TKlebig/TimBAgit/BA/Chapters/Teil1.tex

%\watermark{\fontsize{30pt}{70pt}\selectfont\textcolor{light}{Vertraulich}}

\chapter{Motivation}
\label{cha:Motivation}

Im Fokus der Arbeit steht ein vertikales Supermarktkühlmöbel für Normalkühlung, welches mit Propan (R290) betrieben wird \cite{DINDeutschesInstitutfurNormunge.V..b}. Propan findet vor dem Hintergrund der F-Gas-Verordnung und aufgrund der hohen volumetrischen Kälteleistung immer häufiger in Kälteanlagen Verwendung \cite{EUParlamentRat.2006},\cite{Huber.2016},\cite{Moons.2013}. Sicherheitsnormen beschränken die maximale Füllmenge eines Kältekreises mit Propan auf \unit{150}{\gram} \cite{DINDeutschesInstitutfurNormunge.V..2014b}. Das AHT-Kühlmöbel, für dessen Produktion die Firma Emerson Scrollverdichter liefert, ist nicht in der Lage die Zieltemperatur, die zwischen \unit{-1}{\celsius} und \unit{5}{\celsius} liegt, über die gesamte Warenausstellfläche gleichmäßig zu erreichen. Es werden Untersuchungen in einer Klimakammer durchgeführt, um Gründe für die unzureichende Produktkühlung zu finden und um die Kälteleistung der Kältekreise zu erhöhen. Das Ziel dieser Untersuchungen ist die Identifikation eines optimalen Betriebspunkts durch Zusammenstellung geeigneter Komponenten und Maßnahmen. Diese werden im Rahmen der Untersuchungen hinsichtlich der erzielten Kälteleistung und der Anlageneffizienz bewertet. 
Vorausgehende Arbeiten umfassen die Installation von Temperatur- und Drucksensoren am Kältekreis und an den Produktdummys, um das Verhalten des Systems zu erfassen und analysieren zu können sowie den Einbau kleinerer Plattenwärmeübertrager als Kondensatoren. Letzteres zielt auf eine Reduzierung des internen Volumens der Kältekreise, um den Mangel an Kältemittel zu kompensieren. Zudem wurden zur genaueren Regelung der Überhitzung thermische durch elektronische Expansionsventile ersetzt. Eine weitere durchgeführte Veränderung ist der Wechsel eines Glykol-Wasser-Gemischs zu Wasser als Wärmetransportmedium für die Kondensation.
Dabei werden folgende experimentelle Untersuchungen durchgeführt:

\begin{itemize} 
\item Betrieb mit dem Verdichter ZB09KAU-TFD als Standard- und als Hybridausführung
\item Betrieb mit den Esterölen 3MAF und HATCOL~4467
\item Anpassung der Länge der Abtauintervalle
\item Änderung der Verschaltung der Verdampferpässe
\end{itemize}

Mithilfe einer geeigneten Software wird ein Simulationsmodell entwickelt, um die Leistung des Verdampfers in einer anderen Verschaltung versuchsunabhängig vorauszusagen. Anschließend wird dieses anhand der durchgeführten Untersuchungen validiert. 

\chapter{Stand der Forschung}
\label{cha:Technik}

Dieses Kapitel bietet eine Übersicht über den Prüfstand, die Messdatenerfassung und das Simulationsmodell. Es werden, die für das Verständnis notwendigen Grundlagen von Kältekompressionsmaschinen sowie die Berechungsgleichungen des Modells erläutert.

\section{Kompressionskältemaschinen}
\label{sec:Stand der Technik}

Kältekompressionsmaschinen arbeiten nach dem Funktionsprinzip eines linksläufigen Kreisprozesses. Deren Aufgabe ist es Wärme bei einem niedrigen Temperaturniveau aufzunehmen und diese unter der Zufuhr von Arbeit auf ein hohes Temperaturniveau zu bringen und an die Umgebung abzugeben. In den nächsten Abschnitten werden die Funktion von Kältekompressionsmaschine sowie die notwendige Grundlagen des Kältemittels Propan, von Kältemittelölen und von Abtauungen erläutert.

\subsection{Komponenten einer Kältekompressionsmaschine}
\label{subsec:Komponenten einer Kältekompressionsmaschine}

In Abbildung~\ref{fig:Ersatzschaltbild} sind die vier Hauptkomponenten einer Kältekompressionsmaschine schematisch dargestellt \cite{Korner.2017}. Im Folgenden wird deren Funktion unter Zuhilfenahme des Ersatzschaltbilds näher erläutert.

\begin{figure} [!htb]
\centering

\caption{Schematische Darstellung einer Kältekompressionsmaschine zur Beschreibung des Funktionsprinzips.}
\label{fig:Ersatzschaltbild}
\end{figure}

\subsubsection{Kondensator}
\label{subsubsec:Kondensator}

Im Kondensator wird gasförmiges, überhitztes Kältemittel durch Wärmeabgabe an ein anderes Fluid abgekühlt, kondensiert und idealerweise unterkühlt (2$\longrightarrow$3). Neben den klassischen Luft-Kältemittel-Wärmeübertragern finden oft Wasser-Kältemittel-Wärmeübertrager Anwendung. Diese werden als Plattenwärmeübertrager ausgeführt und ermöglichen aufgrund der höheren Wärmekapazität von Wasser bzw. Sole gegenüber Luft  einen geringeren Massenstrom sowie einen kleineren Bauraum bei gleicher Leistung. Der Verflüssigungsdruck ergibt sich aus der Wassereintritts- und –austrittstemperatur, der wärmeübertragenden Fläche sowie der Massenstöme von Wasser und Kältemittel \cite{Kulterer.2007}. Es ist nötig das Kältemittel vollständig zu kondensieren und zu unterkühlen, um ein fehlerfreies Regelverhalten des nachfolgenden Expansionsventils sicherzustellen und um eine Einschränkung der Flüssigkeitszufuhr durch Dampfblasen zu vermeiden.

\subsubsection{Expansionsventil}
\label{subsubsec:Expansionsventil}

Im Expansionsventil wird der Druck des Kältemittels nach dem Kondensator auf ein niedriges Druckniveau expandiert (3$\longrightarrow$4). Dies hat ein Absinken der Sättigungstemperatur zur Folge. Das Expansionsventil die Aufgabe die Überhitzung des Kältemittels auf einen vorgegebenen Wert zu regeln und konstant zu halten. Die Überhitzung ist die Differenz zwischen der Sättigungstemperatur des Kältemittels und dessen tatsächlicher Temperatur am Austritt des Verdampfers. Diese wird durch einen Temperatursensor an der Saugleitung erfasst. Diverse Ventile besitzen einen zusätzlichen Drucksensor in der Saugleitung, um das Regelverhalten zu verbessern. Dadurch wird eine Verfälschung der Überhitzungsregelung durch Druckabfall über den nachfolgenden Verdampfer reduziert. Elektronische Expansionsventile ermöglichen gegenüber thermostatischen Ventilen ein sehr präzises und schnelles Regelverhalten. 

\subsubsection{Verdampfer}
\label{subsubsec:Verdampfer}

Im Verdampfer nimmt das Kältemittel bei niedrigem Druck und entsprechend niedriger Sättigungstemperatur die Wärme des Fluids mit der höheren Temperatur auf und verdampft dabei (4$\longrightarrow$1). Der übertragene Wärmestrom entspricht der Kälteleistung der Kälteanlage und hängt gemäß Gleichung~\ref{eq:4} unteranderem von der Temperaturdifferenz zwischen den beiden Fluiden und von der wärmeübertragenden Fläche ab. Die Verdampfungstemperatur soll dabei etwa \unit{10}{\kelvin} unter der Zielprodukttemperatur liegen, damit ein ausreichend großer Wärmestrom vom Kältemittel aufgenommen wird. Die Verdampferrohre sind mit Lamellen aus Aluminium bestückt, um die wärmeübertragende Fläche zu vergrößern. Diese haben für den Einsatzbereich der Normalkühlung Abstände von \unit{4}{\milli\metre} bis \unit{5}{\milli\metre}. In steckerfertigen Kühlmöbeln finden ausschließlich Luft-Kältemittel-Wärmeübertrager Anwendung. Das Kältemittel wird im Verdampfer um etwa \unit{8}{\kelvin} überhitzt, damit verhindert wird, dass flüssiges Kältemittel den Verdichter schädigt.

\subsubsection{Verdichter}
\label{subsubsec:Verdichter}

Unter der Zufuhr von Arbeit wird im Verdichters gasförmiges Kältemittel auf ein hohes Druck- und Temperaturniveau verdichtet (1$\longrightarrow$2), damit die Wärme im Kondensator an ein Fluid mit geringerem Temperaturniveau abgegeben werden kann. Im Anwendungsgebiet der Normalkühlung werden vor allem Hubkolben- und Scrollverdichter eingesetzt. Scrollkompressoren zeichnen sich durch hohe Effizienz aus. Sie verfügen über eine sich auf einer kreisförmigen Bahn bewegende Spirale. Die Bahn wird durch eine stationäre Spirale vorgegeben. Bei Rotation der Spiralen verkleinert sich das Volumen des eingeschlossenen Raums zwischen den Spiralen. Dadurch wird das Kältemittel zur Spiralmitte transportiert und gleichzeitig verdichtet. Scrollkompressoren dissipieren wegen der aneinander reibenden Spiralen viel Wärme und können eine hohe Temperatur erreichen. Damit der Verdichter keinen Schaden nimmt, muss eine ausreichende Ölschmierung jederzeit gewährleistet sein. 

\subsection{Kältemittelöle}
\label{subsec:Kältemittelöle}

Öl in Kälteanlagen hat mehrere Aufgaben. Zur Sicherstellung der Funktionalität des Verdichters ist eine Ölmindestfüllmenge erforderlich. Die Hauptaufgabe des Öles ist eine ausreichende Schmierung des Verdichters, um den Verschleiß der sich bewegenden Komponenten gering zu halten. \newline
Die zweite Aufgabe des Öles ist die Motorkühlung. Während des Betriebs entsteht durch Reibung Wärme, welche vom Öl aufgenommen wird. Das Öl wird nur im Verdichter einer Kälteanlage benötigt. Es ist, bedingt durch die Bauform des Verdichters, nicht möglich den Mittransport eines Teils des Öles in den Kältekreis zu verhindern. In den Wärmeübertragern herrschen andere Drücke und Temperaturen als im Verdichter, was sich auf die physikalischen Eigenschaften des Öles auswirkt. Dort ist die Löslichkeit des Kältemittels im Öl höher, d.h. das Öl ist in der Lage mehr Kältemittel aufzunehmen und dadurch die nutzbare Kältemittelfüllmenge zu reduzieren. Zudem wird der $kA$-Wert, durch Reduzierung der wärmeübertragenden Fläche und durch einen zusätzlichen Wärmeleitwiderstand der Ölschicht verkleinert. Dies resultiert in einer Reduktion der Kälteleistung. \newline
In Kälteanlagen werden Mineralöle und Esteröle eingesetzt. Die im Rahmen der Arbeit untersuchten Öle HATCOL~4467 und 3MAF sind Esteröle, d.h. sie wurden eigens für die Anwendung in einer Kälteanlage synthetisiert \cite{ChemturaCorporation.2017},\cite{LubrizolCorporation.2015}. 
Die in diesem Abschnitt vorgestellten Gleichungen erlauben, unter Berücksichtigung der  Temperaturen und Drücke in den untersuchten Komponenten des Kältekreises, eine Berechnung der Öldichte, der kinematischen Viskosität und der Löslichkeit des Kältemittels im jeweiligen Öl \cite{EmersonClimateTechnologies.b}. Die Berechnungen dienen dem Vergleich beider Öle hinsichtlich der Erhöhung der Kälteleistung. Durch die Wahl des Öles mit einer niedrigeren Kältemittellöslichkeit kann mehr Kältemittel im Verdampfer direkt verdampfen. Dadurch wird die Kälteleistung gesteigert. In den folgenden Gleichungen bezeichnet $T$ die Temperatur des Öles in $\kelvin$ und $p$ den Druck in der jeweiligen Komponente in $\bbar$. Die Koeffizienten $a_1$ bis $a_9$ sind je nach Öl und Gleichung verschieden.

Die Öldichte $\rho$ in $\frac{\kilo\gram}{\cubic\metre}$ ergibt sich gemäß Gleichung~\ref{eq:1}. 

\begin{equation}
\label{eq:1}
\rho = a_{1} + a_{2}T + a_{3}T^2 + \omega(a_{4}+ a_{5}T + a_{6}T^2) + \omega^2(a_{7}+ a_{8}T + a_{9}T^2)
\end{equation}

Die Berechnung der kinematischen Viskosität $\nu$ in $cSt$ erfolgt gemäß Gleichung~\ref{eq:3}.

\begin{align}
\label{eq:3}
	\begin{split}
		\ln(\ln(\nu + 0.7 + e^{-\nu} K_{0} (\nu + 1.244068))) =~ 
		&a_{1} + a_{2}\ln{T} + 	a_{3}\ln^2{T} \\
		&+ \omega(a_{4} + a_{5}\ln{T} + a_{6}\ln^2{T}) \\
		&+ \omega^2(a_{7} + a_{8}\ln{T} + a_{9}\ln^2{T}) 
	\end{split}
\end{align}

Die Hilfsgröße $K_0$ wird mithilfe der Bessel-Funktion gemäß Gleichung~\ref{eq:3_1} bestimmt.

\begin{equation}
\label{eq:3_1}
K_0 = BesselK(\nu + 1.244068 , 0)
\end{equation}

Gleichung~\ref{eq:2} ermöglicht eine Berechnung der Löslichkeit $\omega$ des Kältemittels in $\frac{\gram~\mathrm{KM}}{\gram~\mathrm{Öl}}$. 

\begin{equation}
\label{eq:2}
\log(p) = a_{1} + \frac{a_{2}}{T} + \frac{a_{3}}{T^2} + \log(\omega)( a_{4} + \frac{a_{5}}{T} + \frac{a_{6}}{T^2}) + \log^2(\omega)( a_{7} + \frac{a_{8}}{T} + \frac{a_{9}}{T^2})
\end{equation}

Eine iterative Berechnung liefert eine Lösung für das Gleichungssystem. 

\subsection{Propan in Kälteanlagen}
\label{subsec:Propan in Kälteanlagen}

Der Kohlenwasserstoff Propan (R290) ist eine umweltfreundliche Alternative zu Kältemitteln wie R22 oder R407C. Propan ist ein natürliches Kältemittel und besitzt eine günstigere Verdampfungsenthalpie. Bei gleicher Kälteleistung sind im Vergleich zu R22 oder R407C geringere Massenströme nötig. Dies resultiert in einem geringeren Energieverbrauch und damit einer höheren Anlageneffizienz.
Es besitzt ein Treibhauspotential (GWP) von 3 und ein Ozonabbaupotential (ODP) von 0 und ist damit nicht ozonschädlich \cite{BitzerKuhlmaschinenGmbH.2014}. Klassifiziert wird es als Sicherheitsklasse A3 und ist demnach nicht giftig, weist aber eine hohe Brennbarkeit auf \cite{DINDeutschesInstitutfurNormunge.V..2014b}. Die Verwendung von Propan benötigt wegen der hohen Entflammbarkeit ein umfassendes Sicherheitkonzept für den Fall von Leckagen \cite{BitzerKuhlmaschinenGmbH.2014},\cite{Huber.2011}.
Um steckerfertige Kühlmöbel ohne spezielle Sicherheitsvorkehrungen betreiben zu können ist die maximale Füllmenge auf \unit{150}{\gram} pro Kältekreis beschränkt.

\subsection{Abtauung}
\label{subsec:Abtauung}

Da die Oberflächentemperatur des Verdampfers unter dem Gefrierpunkt von Wasser liegt, kondensiert dieses aus der Luft und gefriert. Dies hat eine zunehmende Vereisung des Verdampfers und eine damit einhergehende Reduktion der Kälteleistung zu Folge.
Die Abtauregelung eines Kühlmöbels erfüllt den Zweck, dessen Verdampfer in regelmäßigen Abständen zu enteisen. Es wird zwischen elektrischer Abtauung, Heißgasabtauung und Umluftabtauung unterschieden. Bei einer elektrischen Abtauung wird das Eis mithilfe von Heizwiderständen im Verdampferpaket abgetaut. Eine Heißgasabtauung erfolgt mittels einer Systemumkehr des Kältekreises. Hierbei wird überhitztes Kältemittel in den Verdampfer geleitet und taut das Eis ab. Die Umluftabtauung bezeichnet die einfachste Abtauregelung. Hierbei werden die Verdichter ausgeschaltet während die Verdampferlüfter weiterlaufen. Da kein Kältemittel mehr strömt wird die Wärme des Kühlguts vom Eis aufgenommen welches dadurch schmilzt und abtropft. Mittels einer Kondensatpumpe wird das aufgetaute Eis aus dem Kühlmöbel entfernt. \newline
Der Abtauung wird entweder in einem vorgegebenen Zeitintervall oder mittels einer Bedarfsdetektion eingeleitet. Bei einer bedarfsgerechten Abtauung wird die Temperaturdifferenz der Luft über den Verdampfer erfasst. Sinkt diese innerhalb des vorgegebenen Abtauintervalls unter einen bestimmten Wert, wird die Abtauung zu diesem Zeitpunkt eingeleitet.

\section{Die Klimakammer}
\label{sec:Die Klimakammer}

Eine Klimakammer erfüllt den Zweck beherrschbare und realitätsnahe Randbedingungen zu generieren. Abbildung~\ref{fig:Klimakammer} zeigt den Aufbau der Klimakammer und die Position des Kühlmöbels in dieser. Die Klimatisierung der Raumluft übernimmt dabei die Klimaanlage der Kammer B. Damit die aufbereitete Luft den Raum über dessen gesamte Länge durchströmt, wurde die Ansaugöffnung von Kammer B mit einer abgehangenen Decke verdeckt. Diese reicht schräg bis zur Mitte des Raumes hinab und verläuft von dort parallel zur Decke und endet kurz vor der rechten Wand. Vor den Luftauslassgittern besitzen die Kammern Umlenkbleche. Diese sollen eine gleichmäßige Verteilung des Luftmassenstroms über den Austrittquerschnitt erzielen. \newline
Jede Kammer besitzt zudem einen Wasseranschluss, dessen Vorlauftemperatur regulierbar ist. Die Kondensatoren des Kühlregals werden mit temperiertem Wasser der Regelung von Kammer A beaufschlagt. Die Regelung der Kondensationstemperatur wird mittels zwei Pumpen in einem primären und einem sekundären Wasserkreislauf realisiert. Die Pumpe im primären Wasserkreislauf beaufschlagt die Kondensatoren mit Wasser und hält eine vorgegebene Temperaturdifferenz über diesen nahezu konstant. Die Pumpe des sekundären Wasserkreislaufs regelt über einen Wärmeübertrager zwischen den beiden Kreisen die Temperatur des Wassers am Eintritt des Kondensators auf \unit{30}{\celsius}. Dies erfüllt den Zweck eine nahezu konstante Kondensationstemperatur zu generieren.  \newline
Die Klimaanlagen sind in der Lage die angesaugte Raumluft aufzuheizen, abzukühlen sowie zu be- und entfeuchten. Die Regelung wird mithilfe einer in NI-LabView entwickelten Steuerung realisiert \cite{NationalInstruments.2013}. Diese ermöglicht Einflussnahme auf die Soll-Werte, die Dauer der jeweiligen Untersuchung und die Einstellung der Regelparameter und übernimmt einen Teil der Messdatenerfassung. 

\begin{figure}[htb]
\centering

\caption{Schematische Darstellung der Klimakammer zur Visualisierung des Prüfstandes.}
\label{fig:Klimakammer}
\end{figure}

\section{Das Kühlregal}
\label{sec:Das Kühlregal}

Im Rahmen der Arbeit wird ein vertikales Verkaufskühlmöbel der Firma AHT untersucht.
Es besitzt auf einer Länge von \unit{3,75}{\metre}, vier Regalböden um Kühlgut zu lagern und auszustellen. Ein von oben herabfallender Luftschleier ermöglicht ein türloses Design des Regals. Ein Nachtbetrieb mit geschlossener Jalousie ist möglich. \newline Abbildung~\ref{fig:IDC150} zeigt die Kältekreise des Kühlmöbels und die Positionen der für die Messdatenerfassung notwendigen Sensoren \cite{DINDeutschesInstitutfurNormunge.V..1998}. Die Kälteerzeugung wird durch drei seperate Kältekreisläufe gewährleistet. Das verwendete Kältemittel ist Propan (R290). Jeder Kreis besitzt eine Kältemittelfüllmenge von \unit{150}{\gram} und eine Ölfüllmenge von \unit{470}{\gram}. Vor den Untersuchungen wurden bereits kältetechnische Komponenten mit geringerem internen Volumen eingebaut, um die Kältemittelfüllmenge zu reduzieren. Die Verdichter sind Scrollkompressoren der Firma Emerson. Im Rahmen der Untersuchungen finden zwei Ausführungen desselben Verdichtermodells Anwendung. Das von Emerson gefertigte Modell ZB09KAU-TFD in Hybridausführung besitzt eine Motorwicklung aus Aluminium. Das Modell in Standardausführung besitzt eine Kupferwicklung. Drei Plattenwärmeübertrager der Firma SWEP dienen als Kondensatoren. Sie sind im Gegenstromprinzip angeordnet, besitzen je 20 Platten und eine Nennleistung von \unit{2,7}{\kilo\watt}. Die Expansionsventile der Firma Alco sind elektronisch regelbar und besitzen einen Temperatur- sowie Drucksensor in der Saugleitung. Die drei Kreisläufe durchlaufen mit je sechs Durchgängen einen gemeinsamen Verdampfer, dessen Lamellenabstand \unit{5}{\milli\metre} beträgt. Sechs Lüftermotoren der Firma EBM Pabst befördern die Luft mit einer konstanten Drehzahl durch den Verdampfer des Kühlmöbels. Die Abtauung erfolgt durch Umluftabtauung. Das Kühlmöbel wird in einer Klimakammer betrieben, um während den Untersuchungen gleichbleibende Umgebungsbedingungen zu generieren und reproduzierbare Ergebnisse zu erzielen.

\begin{figure} %[!htb]
\centering

\caption{Schematische Darstellung der Kältekreise des Kühlmöbels zur Visualisierung der Komponenten und Messstellen.}
\label{fig:IDC150}
\end{figure}

\clearpage

\section{Messdatenerfassung und Berechnungsgrößen}
\label{sec:Erfassung von Messdaten}

Mithilfe geeigneter Sensorik sowie der Steuerungssoftware von Klimakammer und Kälteanlafe werden die für die Berechnung und Bewertung relevanten Größen während des Betriebs erfasst und gespeichert. Insgesamt finden drei Systeme Anwendung um sensorbasiert Daten zu erfassen, umzuwandeln und in Tabellenform zu speichern. Alle erfassten sowie berechneten Messdaten werden über die letzten \unit{75}{\%} des letzten Kühlzyklus in einem Untersuchungszeitraum von \unit{24}{\hour} gemittelt. Dies dient der Vergleichbarkeit. Die im Rahmen der Arbeit dargestellten Ergebnisse wurden auf diese Art vereinheitlicht.

\subsection{Messdaten der Klimakammer}
\label{subsec:Messdaten der Klimakammer}

Die in Abschnitt~\ref{sec:Die Klimakammer} vorgestellte Klimakammer wird über eine in mit NI-LabView erstellte Steuerungssoftware bedient. Raumluftseitig werden die Temperatur sowie die relative Luftfeuchtigkeit erfasst. Wasserseitig werden Wassermassenstrom sowie Vor- und Rücklauftemperatur gemessen. 
Die Sensoren, welche die Regelgrößen Temperatur und relative Luftfeuchtigkeit aufnehmen, sind zuluftseitig in der Nähe des Auslassgitters positioniert. Die Regelgröße der Temperatur entspricht dem Mittelwert von drei, über die Höhe des Luftauslassgitters verteilten Temperatursensoren. Wird der Betrieb der Klimakammer über das Programm gestartet, so werden die Daten erfasst und in einer Exceldatei aufgezeichnet.

\subsection{Messdaten des Kühlregals}
\label{subsec:Messdaten der Klimakammer}

Mithilfe des Programms NI-SignalExpress werden die Messdaten des Kühlregals und der Kältekreisläufe via Modbus erfasst. Es werden Thermoelemente verwendet, um die Temperaturen zu messen und Hochgenauigkeitsdruckaufnehmer, um die Drücke zu messen. Die Temperatursensoren sind Thermoelemente des Typs K und besitzen eine maximale Messabweichung von $\pm$~\unit{1.5}{\kelvin} \cite{WIKAAlexanderWiegandSE&Co.KG.2016}. Erfasst werden die Produkttemperaturen, die Ein- und Austrittstemperatur der Luft am Verdampfer des Kühlregals, die Temperaturen an verschiedenen Positionen der Kältekreisläufe und die Relativdrücke des Kältemittels im System in Heißgasleitung, Flüssigkeitsleitung, Einspritzleitung und Saugleitung. Die Positionen der Sensoren an den Kältekreisläufen sind aus Abbildung~\ref{fig:IDC150} ersichtlich. Zudem wurde die Temperatur des Kältemittels nach jedem einzelnen Durchgang durch den Verdampfer erfasst.
Die erfassten Daten werden in einer Exceltabelle aufgezeichnet. SignalExpress ermöglicht die Visualisierung der Messwerte in Echtzeit, was die Beobachtung des Kühlprozesses vereinfacht.

\subsection{Messdaten des Leistungsanalysators}
\label{subsec:Messdaten des Leistungsanalysators}

Es wird ein Yokogawa WT3000 Leistungsanalysator verwendet, um Spannungen, Ströme und Leistungen während des Betriebs zu erfassen und aufzuzeichen. Dieser ist in der Lage Spannungen und Ströme mit einer Genauigkeit von \unit{0,02}{\%} zu erfassen und daraus Blind-, Wirk- und Scheinleistungen zu berechnen. Die abgenommenen Komponenten sind die einzelnen Verdichter, die Ventilatoren und die restlichen Verbraucher des Kühlregals, wie Licht und Relays. Das Gerät speichert die erfassten und berechneten Messwerte im Excelformat auf einem externen Datenspeicher.
Im Anschluss lassen sich mit den erfassten Werten Berechnungen durchführen.

\subsection{Berechnungsgrößen am Kältekreis}
\label{subsec:Berechnungsgrössen}

Zur energetischen Bewertung werden auf Basis der messtechnisch erfassten Größen Leistungen und Bewertungsgrößen berechnet. Diese ermöglichen es, das Verhalten des Systems zu visualisieren und zu bewerten.
Der an einem Wärmeübertrager übertragene Wärmestrom  $\dot{Q}$ lässt sich mit Gleichung~\ref{eq:4} allgemein formulieren.

\begin{equation}
\label{eq:4}
\dot{Q}= kA(T_\mathrm{A} - T_\mathrm{B}) = \dot{M}_{\mathrm{A}}(h_{\mathrm{WÜ,aus}} - h_{\mathrm{WÜ,ein}})
\end{equation}

Die mittlere Leistung des Kondensators $\dot{Q}_{\mathrm{cd}}$ berechnet sich auf Basis der Eintritt- und Austrittstemperaturen $T_\mathrm{W,ein}$ und $T_\mathrm{W,aus}$ des Kühlwassers, dessen Massenstroms $\dot{M}_\mathrm{W}$ und der spezifischen Wärmekapazität $c_{\mathrm{p,W}}$ entsprechend Gleichung~\ref{eq:5}.

\begin{equation}
\label{eq:5}
\dot{Q}_{\mathrm{cd}}= \frac{\dot{M}_{\mathrm{W}}}{3} c_{\mathrm{p,W}} (T_{\mathrm{W,aus}} - T_{\mathrm{W,ein}})
\end{equation}

Da unter den Testbedingungen nicht immer eine Unterkühlung des Kältemittels und damit ein Verlassen des Zweiphasengebietes stattfindet, wird die Enthalpie $h_{cd,aus}$ am Kondensatoraustritt bzw. am Verdampfereintritt mithilfe der erfassten Messdaten am Kondensatoreintritt und der zuvor berechneten Kondensatorleistung nach Gleichung~\ref{eq:6} berechnet.

\begin{equation}
\label{eq:6}
h_{\mathrm{cd,aus}} = h_{\mathrm{cd,ein}} - \frac{\dot{Q}_{\mathrm{cd}}}{\dot{M}_{\mathrm{KM}}}
\end{equation}

Auf Basis der berechneten Enthalpie am Kondensatoraustritt und der Enthalpien in den Sättigungszuständen kann mithilfe von Gleichung~\ref{eq:x} der Dampfanteil des Kältemittels $x_{\mathrm{cd,aus}}$ berechnet werden.

\begin{equation}
\label{eq:x}
x_{\mathrm{cd,aus}} = \frac{h_{\mathrm{cd,aus}}-h_{\mathrm{F,sat}}}{h_{\mathrm{G,sat}}-h_{\mathrm{F,sat}}}
\end{equation}

Der Kältemittelmassenstrom $\dot{M}_{\mathrm{KM}}$ wird auf Basis der Verdampfungstemperatur $T_{\mathrm{ev,sat}}$  und der Kondensationstemperatur $T_{\mathrm{cd,sat}}$, sowie der vom Hersteller ermittelten Koeffizienten $C_i$ anhand von Gleichung~\ref{eq:7} berechnet.

\begin{align}
\label{eq:7}
	\begin{split}
	\dot{M}_{\mathrm{KM}} = &C_0 + C_1*T_{\mathrm{ev,sat}} + C_2*T_{\mathrm{cd,sat}} + C_3*T_{\mathrm{ev,sat}}^2 \\
	&+C_4*T_{\mathrm{ev,sat}}*T_{\mathrm{cd,sat}} + C_5*T_{\mathrm{cd,sat}}^2 + C_6*T_{\mathrm{ev,sat}}^3 \\
	&+ C_7*T_{\mathrm{cd,sat}}*T_{\mathrm{ev,sat}}^2 +C_8*T_{\mathrm{ev,sat}}*T_{\mathrm{cd,sat}}^2 + C_9*T_{\mathrm{cd,sat}}^3
	\end{split}
\end{align}

Mit Gleichung~\ref{eq:9} wird die EER-Kennzahl berechnet. Diese setzt die Verdampferleistung  $\dot{Q}_{\mathrm{ev}}$ ins Verhältnis zur aufgenommenen elektrischen Leistung $P_{\mathrm{el}}$. Dies dient der Bewertung der Effizienz des Systems in einem Betriebspunkt \cite{Muller.2016}.

\begin{equation}
\label{eq:9}
EER = \frac{\dot{Q}_{\mathrm{ev}}}{P_{\mathrm{el}}}
\end{equation}

Somit lässt sich mit Gleichung~\ref{eq:8} die Verdampferleistung $\dot{Q}_{\mathrm{ev}}$ bestimmen.

\begin{equation}
\label{eq:8}
\dot{Q}_{\mathrm{ev}}= \dot{M}_{\mathrm{KM}}(h_{\mathrm{ev,aus}} - h_{\mathrm{ev,ein}})
\end{equation}

%\clearpage

\section{Testbedingungen nach Norm}
\label{sec:Testbedingungen nach Norm}

In diesem Abschnitt werden die von Normen vorgegebenen Prüfbedingungen erläutert.
Die Norm DIN EN ISO 23953-2 liefert Vorgaben zum Aufbau des Prüfstandes, zur Position der Messtechnik und zu Berechnungsmethoden. Bei allen Tätigkeiten wird sich an dieser orientiert, um reproduzierbare Ergebnisse zu erzielen.
Tabelle~\ref{tab:Klimaklassen} zeigt die genormten Klimaklassen mit deren Klassifikation nach Trockenkugeltemperatur, relativer Luftfeuchtigkeit, Taupunkt und dem Wasserdampfgehalt der Luft. Tabelle~\ref{tab:Temperaturklassen} zeigt die Temperaturklassen der M-Pakete mit der jeweils niedrigsten und höchsten erlaubten Temperatur. Rahmenbedingung ist, dass alle Untersuchungen bei Klimaklasse 3 durchgeführt werden. Die erzielten Produkttemperaturen des Kühlmöbels müssen dabei zwischen \unit{-1}{\celsius} und \unit{5}{\celsius} liegen. \newline
Es werden je \unit{1}{\kilogram} schwere M-Pakete aus Silikon verwendet, um Kühlgut möglichst genau nachzubilden. Abbildung~\ref{fig:Anordnung der M-Pakete} zeigt die vorgeschriebene Anordnung dieser M-Pakete in den Regalreihen des Kühlmöbels. Die mit einem X gekennzeichneten Pakete werden mit Temperatursensoren versehen.
Der Messpunkt für die Temperatur und die relative Luftfeuchte muss mittig der Länge des Kühlmöbels und \unit{300}{\milli\metre} vor dessen Oberkante liegen. \newline
Voraussetzung für eine normgerechte Messung ist zudem, dass eine Bewegung der Luft vorhanden ist. Abbildung~\ref{fig:Messpunkte} zeigt die vorgeschriebenen Messpunkte für die Erfassung der Luftgeschwindigkeit. Diese muss an den drei Messpunkten auf der Linie A-A in Abbildung~\ref{fig:Messpunkte} zwischen \unit{0,1}{\meter\per\second} und \unit{0,2}{\meter\per\second} liegen \cite{DINDeutschesInstitutfurNormunge.V..}. \newline
Die erfassten Messwerte und die auf deren Basis berechneten Leistungen sowie Bewertungsgrößen werden über die letzten \unit{75}{\%} des letzten Kühlzyklus in einem Untersuchungszeitraum von \unit{24}{\hour} gemittelt.

% Please add the following required packages to your document preamble:
% \usepackage[table,xcdraw]{xcolor}
% If you use beamer only pass "xcolor=table" option, i.e. \documentclass[xcolor=table]{beamer}
\begin{table}[h!]
\centering
\caption{Klimaklassen des Prüfraums.}
\label{tab:Klimaklassen}
\begin{tabular}{|c|c|c|c|c|}
\hline
\textbf{\begin{tabular}[c]{@{}c@{}}Klimaklasse des \\ Prüfraums\end{tabular}} & \textbf{\begin{tabular}[c]{@{}c@{}}Trockenkugel-\\ temperatur\end{tabular}} & \textbf{\begin{tabular}[c]{@{}c@{}}Relative \\ Luftfeuchte\end{tabular}} & \textbf{Taupunkt} & \textbf{\begin{tabular}[c]{@{}c@{}}Wasserdampf-\\ gehalt \\ in trockener Luft\end{tabular}} \\
                                                                           & °C                                                                       & \%                                                                       & °C                & g/kg                                                                                        \\ \hline
0                                                                             & 20                                                                          & 50                                                                       & 9,3               & 7,3                                                                                         \\ \hline
1                                                                             & 16                                                                          & 80                                                                       & 12,6              & 9,1                                                                                         \\ \hline
8                                                                             & 23,9                                                                        & 55                                                                       & 14,3              & 10,2                                                                                        \\ \hline
2                                                                             & 22                                                                          & 65                                                                       & 15,2              & 10,8                                                                                        \\ \hline
%\rowcolor[HTML]{FFFe65}
3                                                                             & 25                                                                          & 60                                                                       & 16,7              & 12                                                                                          
\\ \hline
4                                                                             & 30                                                                          & 55                                                                       & 20                & 14,8                                                                                        \\ \hline
5                                                                             & 27                                                                          & 70                                                                       & 21,1              & 15,8                                                                                        \\ \hline
6                                                                             & 40                                                                          & 40                                                                       & 23,9              & 18,8                                                                                        \\ \hline
7                                                                             & 35                                                                          & 75                                                                       & 30                & 27,3                                                                                        \\ \hline
\end{tabular}
\end{table}

% Please add the following required packages to your document preamble:
% \usepackage[table,xcdraw]{xcolor}
% If you use beamer only pass "xcolor=table" option, i.e. \documentclass[xcolor=table]{beamer}
\begin{table}[h!]
\centering
\caption{Temperaturklassen der M-Pakete.}
\label{tab:Temperaturklassen}
\begin{tabular}{|c|c|c|}
\hline
\textbf{Klasse} & \textbf{\begin{tabular}[c]{@{}c@{}}Höchste Temperatur,\\ des wärmsten\\ M-Pakets gleich oder\\ niedriger als\end{tabular}} & \textbf{\begin{tabular}[c]{@{}c@{}}Niedrigste Temperatur,\\ des kältesten\\ M-Pakets gleich oder\\ höher als\end{tabular}} \\ \cline{2-3} 
                & \multicolumn{2}{c|}{°C}                                                                                                                                                                                                                                 \\ \hline
L1              & -15                                                                                                                        & -                                                                                                                          \\ \hline
L2              & -12                                                                                                                        & -                                                                                                                          \\ \hline
L3              & -12                                                                                                                        & -                                                                                                                          \\ \hline
%\rowcolor[HTML]{FFFE65} 
M1              & +5                                                                                                                         & -1                                                                                                                         \\ \hline
M2              & +7                                                                                                                         & -1                                                                                                                         \\ \hline
H1              & +10                                                                                                                        & +1                                                                                                                         \\ \hline
H2              & +10                                                                                                                        & -1                                                                                                                         \\ \hline
S               & \multicolumn{2}{c|}{Sonderklasse}                                                                                                                                                                                                                       \\ \hline
\end{tabular}
\end{table}

\clearpage

\begin{figure}[h!tb]
\centering

\caption{Normgerechte Anordnung der M-Pakete und der Temperatursensoren in vertikalen Kühlmöbel.}
\label{fig:Anordnung der M-Pakete}
\end{figure}

\begin{figure}[h!tb]
\centering

\caption{Messpunkte zur Erfassung der Luftgeschwindigkeit an vertikalen Kühlmöbeln.}
\label{fig:Messpunkte}
\end{figure}

\clearpage

\section{Simulationsmodell für Verschaltung der Verdampferrohre}
\label{sec:Simulationsmodell}

In diesem Abschnitt werden die mathematischen Grundlagen des zur Beurteilung der Verdampferschaltung erstellten Modells beschrieben und erklärt.
Mithilfe des Programms EES (Engineering Equation Solver) wurde im Rahmen der Untersuchungen ein Modell erstellt, welches es ermöglicht den Effekt einer anderen Verschaltung der Verdampferpässe auf die Kälteleistung des Verdampfers zu simulieren.  
EES ist ein Gleichungslöser, der es erlaubt Gleichungen mit Unbekannten unabhängig ihrer Reihenfolge effizient zu lösen. Zudem besitzt EES eine Vielfalt integrierter mathematischer, sowie thermodynamischer und physikalischer Funktionen \cite{Klein.2000}. Eine integrierte Stoffdatenbank bietet Zugriff auf die Daten von idealen sowie realen Fluiden. Weitere Programmfunktionen erlauben die Erstellung einer Benutzeroberfläche sowie die Erstellung von Tabellen und Graphen. \newline
Mithilfe des Simulationsmodells lassen sich der Druckabfall über den Verdampfer und dessen Leistung berechnen. 

%\begin{figure}[htb]
%\centering
%	\subfigure[Ausgangsschaltung]{\includegraphics[scale=0.39]{Pictures/Verdampfer_Gegenstrom.pdf}}
%	\subfigure[veränderte Schaltung]{\includegraphics[scale=0.39]{Pictures/Verdampfer_Gleich-Gegenstrom.pdf}}
%\caption{Vergleich der Verdampferschaltungen.}
%\label{fig:Vergleich der Verdampferschaltungen}
%\end{figure}

%\subsection{Modellierung mit EES}
%\label{subsec:Modellierung mit EES}
%
%EES ist ein Gleichungslöser, der es erlaubt Gleichungen mit Unbekannten unabhängig ihrer Reihenfolge effizient zu lösen. Zudem besitzt EES eine Vielfalt integrierter mathematischer, sowie thermodynamischer und physikalischer Funktionen \cite{Klein.2000}. Eine integrierte Stoffdatenbank bietet Zugriff auf die Daten von idealen sowie realen Fluiden. Damit das Programm genaue Ergebnisse liefert ist es nötig, physikalisch sinnvolle und möglichst genaue Begrenzungen der erstellten Variablen anzugeben. 
%Weitere Programmfunktionen erlauben die Erstellung einer Benutzeroberfläche sowie die Erstellung von Tabellen und Graphen. Als sehr nützlich erweist sich dabei die Möglichkeit Stoff-Eigenschaftsdiagramme wie z.B. Mollier- oder log-p-h-Diagramme zu erstellen.

\subsection{Berechnung des Druckabfalls in der Zweiphasen-Strömung}
\label{subsec:Berechnung des Druckabfalls in der Zweiphasen-Strömung}

Die Ausgangsberechnung auf der alle weiteren Berechnung basieren, ist die des Druckabfalls innerhalb der Kältemittelströmung. Auf Basis der Bernoullischen Energiegleichung und gemäß Gleichung~\ref{eq:10} setzt sich der gesamte Druckabfall $\Delta p$ aus einem Reibungsanteil $\Delta p_{\mathrm{Reibung}}$, einem Beschleunigungsanteil $\Delta p_{\mathrm{Beschleunigung}}$ und einem statischen Anteil $\Delta p_{\mathrm{statisch}}$ zusammen \cite{SpringerVerlagGmbH.2013},\cite{J.MichaelDoster.}.

\begin{equation}
\label{eq:10}
\Delta p =  \Delta p_{\mathrm{Reibung}} \pm \Delta p_{\mathrm{statisch}} \pm \Delta p_{\mathrm{Beschleunigung}}
\end{equation}

Der statische Anteil, sowie der Beschleunigungsanteil sind sehr gering und deshalb vernachlässigbar. Zunächst muss bestimmt werden ob die Gasphase dispers oder kontinuierlich ist, d.h. ob Gasblasen getrennt und verteilt in der Flüssigkeit transportiert werden oder zusammenhängend strömen \cite{Kesper.1976}. Nach Gleichung~\ref{eq:11} ist der Reibungsanteil des Druckverlustes das Integral der längenbezogenen Druckänderung über die Länge der Verdampferrohres.

\begin{equation}
\label{eq:11}
\Delta p_{\mathrm{Reibung}} = \int_{\mathrm{l_1}}^{\mathrm{l_2}} \left( \frac{dp}{dl} \right)_{\mathrm{Reibung}} dl
\end{equation}

\clearpage

Die Gasphase ist dispers, wenn Gleichung~\ref{eq:12} gilt. Hierbei bezeichnet $\beta$ das Verhältnis der Volumenströme der flüssigen Phase $\dot{V}_\mathrm{F}$ und der Gasphase $\dot{V}_\mathrm{G}$. Die Bedingung ist abhängig vom Dampfanteil des Kältemittels $x$, der Dichte der flüssigen Phase $\rho_\mathrm{F}$, der Dichte der Gasphase $\rho_\mathrm{G}$ und der Froudezahl $Fr$.

\begin{equation}
\label{eq:12}
\frac{1}{\beta} = \frac{\dot{V}_\mathrm{G}}{\dot{V}_\mathrm{F}} = \frac{x\rho_\mathrm{F}}{(1-x)\rho_\mathrm{G}} \leq \frac{12\sqrt{Fr}}{1+\frac{\sqrt{Fr}}{7}}
\end{equation}

Die Gasphase wird als kontinuierlich bezeichnet, wenn Gleichung~\ref{eq:13} gilt.

\begin{equation}
\label{eq:13}
\frac{1}{\beta} = \frac{\dot{V}_\mathrm{G}}{\dot{V}_\mathrm{F}} = \frac{x\rho_\mathrm{F}}{(1-x)\rho_\mathrm{G}} > \frac{12\sqrt{Fr}}{1+\frac{\sqrt{Fr}}{7}}
\end{equation}

In allen durchgeführten Berechnungen ist Gleichung~\ref{eq:13} erfüllt. Demnach ist die Dampfphase als kontinuierlich zu betrachten. Im Rahmen dieser Ausführungen wird sich auf die unter dieser Annahme gültigen Gleichungen beschränkt. Der Reibungsdruckabfall wird wesentlich durch einen intensiven Impulsaustausch zwischen den beiden Phasen beeinflusst \cite{Kesper.1976}. In Gleichung~\ref{eq:14} wird die Zweiphasenströmung wie eine Dampfströmung behandelt und der Einfluss der flüssigen Phase durch eine Korrekturgröße $\gamma$ berücksichtigt. Hierbei ist $\dot{m}$ der auf die Rohrquerschnittsfläche bezogene Massenstrom.

\begin{equation}
\label{eq:14}
\left( \frac{dp}{dl} \right)_{\mathrm{Reibung}} = \xi_\mathrm{G} \frac{\dot{m}^2 x^2}{4\rho_\mathrm{G}} \left(\frac{1}{1-\gamma} \right)^2
\end{equation}

Der Reibungsbeiwert $\xi_\mathrm{G}$ lässt sich mit Gleichung~\ref{eq:15} bestimmen.

\begin{equation}
\label{eq:15}
\frac{1}{\xi_\mathrm{G}} = 2\log(Re_\mathrm{G} \sqrt{\xi_\mathrm{G}})-0.8
\end{equation}

Dafür muss mit Gleichung~\ref{eq:16} die Reynoldszahl der gasförmigen Phase $Re_\mathrm{G}$ berechnet werden. Diese ist abhängig von der dynamischen Viskosität der Gasphase $\eta_\mathrm{G}$ und des Innendurchmessers des Verdampferrohrs $d_\mathrm{i}$ \cite{Awad.2012}.

\begin{equation}
\label{eq:16}
Re_\mathrm{G} = \frac{\dot{m} x d_\mathrm{i}}{\eta_\mathrm{G}}
\end{equation}

Die Korrekturgröße $\gamma$ ist als effektive Querschnittsverengung für den Dampfstrom, verursacht durch die Flüssigkeit, zu interpretieren und wird als Versperrungsfaktor bezeichnet. Abhängig von den Geschwindigkeiten und den Dichteverhältnissen muss abschnittsweise zwischen verschiedenen Strömungsformen unterschieden werden. Bei kleinen Massenstromdichten ist die Strömung eben und geschichtet. Bei gesteigertem Durchsatz wird die Strömung wellig und es treten Schwalle auf. Infolgedessen ist der Rohrumfang vollständig von Flüssigkeit benetzt. Bei noch höheren Durchsätzen wird die Flüssigkeit tropfenförmig im Gaskern mitgerissen. Durch erhebliche Expansionseffekte bei hohen Geschwindigkeiten findet eine Beschleunigung der Gasphase statt und es stellt sich ein Schlupf zwischen den beiden Phasen ein \cite{Kesper.1976}.
Gleichung~\ref{eq:17} ermöglicht die Berechnung der Korrekturgröße $\gamma$.

\begin{equation}
\label{eq:17}
\gamma = \gamma_\mathrm{F}(1-E) + \gamma_\mathrm{E} E
\end{equation}

Dabei ist der Verperrungsfaktor für ebene Strömung $\gamma_\mathrm{E}$. Dieser lässt sich mithilfe von Gleichung~\ref{eq:18} bestimmen.

\begin{equation}
\label{eq:18}
\gamma_\mathrm{E} = 1 - \left( 1+0.15 \left( \frac{1-x}{x} \right)^{0.45} \left( \frac{\eta_\mathrm{F}}{\eta_\mathrm{G}}-1 \right)^{0.25} (1 + 3x^4)\right)^{-1}
\end{equation}

Der Versperrungsfaktor für Ringströmung mit Schwallen $\gamma_\mathrm{F}$ lässt sich mit Gleichung~\ref{eq:19} berechnen und hängt von der dynamischen Viskosität der flüssigen Phase $\eta_\mathrm{F}$ ab.

\begin{equation}
\label{eq:19}
\gamma_\mathrm{F} = 1 - \left(1+\frac{(1-x)\rho_\mathrm{G}}{x \epsilon \rho_\mathrm{F}}\right)^{-1.19}
\end{equation}

Gleichung~\ref{eq:20} erlaubt die Berechnung des Verteilparameters $E$. Dieser ist abhängig von der Schallgeschwindigkeit in der Gasphase $c_\mathrm{G}$.

\begin{equation}
\label{eq:20}
E = 1.857 + 0.815 \log\left[\left(\frac{\dot{m} x}{\rho_\mathrm{G} c_\mathrm{G}}\right)^2 \left( 1+ \frac{4575 \rho_\mathrm{G}^2}{\rho_\mathrm{F}^2} \right)\right]
\end{equation}

Der Verteilparameter $E$ nimmt Werte zwischen 0 und 1 an. Bei $E=0$ ist die Strömungsform Ringschwallströmung, bei $E=1$ beschleunigte Strömung.
Für die Berechnung von $\gamma_\mathrm{F}$ ist die Berechnung der Hilfsgröße $\epsilon$ mithilfe der Gleichungen~\ref{eq:21} bis \ref{eq:24} nötig. Für die Berechnung von $\epsilon$ müssen zunächst $\epsilon_1$ und $\epsilon_2$ bestimmt werden. Für $\epsilon_2$ $Re_\mathrm{F}$ und $Fr_\mathrm{F}$ bezeichnen die Reynoldszahl bzw. die Froudezahl der flüssigen Phase.

\begin{equation}
\label{eq:21}
\epsilon^{-3} = \epsilon_1^{-3} + \epsilon_2^{-3}
\end{equation}

\begin{equation}
\label{eq:22}
\epsilon_1 = 1.71 \psi^{0.2} \left( \frac{1-x}{x} \right)^{0.15} \left( \frac{\rho_\mathrm{G}}{\rho_\mathrm{F}} \right)^{0.5} \left( \frac{\eta_\mathrm{G}}{\eta_\mathrm{F}} \right)^{0.1}
\end{equation}

\begin{equation}
\label{eq:23}
\epsilon_2 = 9.1 \psi
\end{equation}

\begin{equation}
\label{eq:24}
\psi = (Re_\mathrm{F} Fr_\mathrm{F})^{-\frac{1}{6}} \left( \frac{1-x}{x} \right) \left(\frac{\rho_\mathrm{F}}{\rho_\mathrm{G}} \right)^{-0.9} \left(\frac{\eta_\mathrm{F}}{\eta_\mathrm{G}} \right)^{-0.5}
\end{equation}

\subsection{Berechnung des Wärmeübergangs}
\label{subsec:Berechnung des Wärmeübergangs}

Die Ausgangsgröße der Temperatur von Luft und Kältemittel nach jeder Zelle wurde mittels der $\epsilon-NTU$-Methode berechnet \cite{SpringerVerlagGmbH.2013},\cite{Bergman.2011},\cite{Nellis.2009}. Dabei werden die dimensionslosen Kennzahlen $NTU$ (dt. Anzahl der Übertragungseinheiten) und $\epsilon$ bestimmt. Diese Methode ist ein Verfahren, das oft bei der Auslegung von Wärmetauschern verwendet wird, da es teils schwierige Berechnungsschritte erspart. Zunächst ist es erforderlich den minimalen und maximalen Wärmekapazitätsstrom $\dot{C}_{\mathrm{min}}$ und $\dot{C}_{\mathrm{max}}$ der beiden Fluide zu bestimmen.
Für den Wärmekapazitätsstrom der Luft gilt Gleichung~\ref{eq:25}.

\begin{equation}
\label{eq:25}
\dot{C}_{\mathrm{min}} = \dot{m}_\mathrm{h} c_{\mathrm{p,h}}
\end{equation} 

Für den Wärmekapazitätsstrom des Kältemittels gilt Gleichung~\ref{eq:26}.

\begin{equation}
\label{eq:26}
\dot{C}_{\mathrm{max}} = \dot{m}_\mathrm{k} c_{\mathrm{p,k}}
\end{equation}

Das Wärmekapazitätsverhältnis $C_\mathrm{r}$ ist damit nach Gleichung~\ref{eq:27}.
 
\begin{equation}
\label{eq:27}
C_\mathrm{r} = \frac{\dot{C}_{\mathrm{min}}}{\dot{C}_{\mathrm{max}}}
\end{equation}

Zudem ist es notwendig den Wärmedurchgangskoeffizienten $k$ zu berechnen \cite{LehrstuhlfurWarmeundStoffubertragung.}. Dieser setzt sich aus den Wärmeleitwiderständen $W$ der einzelnen Rohrschichten und Übergängen zusammen.  Hierbei wurde auf eine Analogie zu Widerständen in Reihenschaltung aus der Elektrotechnik zurückgegriffen, um flexibel bei der Anpassung der Parameter des Modells an die Realität zu sein. Die wärmeübertragende Fläche $A$ wurde mit einbezogen. Somit gilt für den $kA-Wert$ nach Gleichung~\ref{eq:UA}.

\begin{equation}
\label{eq:UA}
kA = \frac{1}{W_{\mathrm{L}} + W_{\mathrm{Al}} + W_{\mathrm{Cu}} + W_{\mathrm{KM}}}
\end{equation}
 
Die einzelnen Wärmeleitwiderstände lassen sich mithilfe der Gleichungen~\ref{eq:28} bis \ref{eq:31} berechnen.

\begin{equation}
\label{eq:28}
W_\mathrm{L} = \frac{1}{\alpha_{\mathrm{L}} d_{\mathrm{Al}} \pi l}
\end{equation}

\begin{equation}
\label{eq:29}
W_{\mathrm{Al}} = \frac{t_{\mathrm{Al}}}{\lambda_{\mathrm{Al}} d_{\mathrm{Al}} \pi l}
\end{equation}

\begin{equation}
\label{eq:30}
W_{\mathrm{Cu}} = \frac{t_{\mathrm{Cu}}}{\lambda_{\mathrm{Cu}} d_{\mathrm{Cu}} \pi l}
\end{equation}

\begin{equation}
\label{eq:31}
W_{\mathrm{KM}} = \frac{1}{\alpha_{\mathrm{KM}} d_{\mathrm{i}} \pi l}
\end{equation}

Die Rohrgeometrie ist dabei wie in Abbildung~\ref{fig:Geometrie} dargestellt.
Die Wärmeübergangszahlen werden mit Orientierung am realen Modell bestimmt.

\begin{figure}[h]
\centering

\caption{Rohrschichten und Geometrie des Verdampferrohres.}
\label{fig:Geometrie}
\end{figure}

Mit diesen Größen lässt sich gemäß Gleichung~\ref{eq:32} der $NTU$-Wert berechnen \cite{McDonald.2012}.

\begin{equation}
\label{eq:32}
NTU = \frac{kA}{\dot{C}_\mathrm{min}}
\end{equation}

Anschließend lässt sich die Effektivität des Wärmeübertragers $\epsilon$ bestimmen.
Dabei muss zwischen sensibler und latenter Wärmeaufnahme des Fluids unterschieden werden. Findet ein Verdampfungsprozess statt so gilt $C_{\mathrm{max}}\longrightarrow\infty$ und damit $C_\mathrm{r} =0$. Für diesen Fall gilt Gleichung~\ref{eq:33}.

\begin{equation}
\label{eq:33}
\epsilon = 1- \exp{(-NTU)}
\end{equation}

Für den Fall überhitzenden Kältemittels und reinem Kreuzstrom gilt Gleichung~\ref{eq:34}.

\begin{equation}
\label{eq:34}
\epsilon = 1- \exp{\left[\left(\frac{1}{C_\mathrm{r}}\right)(NTU)^{0.22}(exp{[-C_\mathrm{r}(NTU)^{0.78}]}-1)\right]}
\end{equation}

Auf Basis der Eintrittstemperatur der Luft $T_{\mathrm{L,ein}}$ und der Eintrittstemperatur des Kältemittels $T_{\mathrm{KM,ein}}$ ist es möglich den übertragenen Wärmestrom $\dot{Q}$ gemäß Gleichung~\ref{eq:35} zu berechnen. 

\begin{equation}
\label{eq:35}
\dot{Q} = \epsilon \dot{C}_{\mathrm{min}} (T_{\mathrm{L,ein}} - T_{\mathrm{KM,ein}})
\end{equation}

Die Eintrittstemperatur des Kältemittels ist die Sättigungstemperatur bei Eingangsdruck. Aus der Energiebilanz in Gleichung~\ref{eq:36} lassen sich Kältemittelaustrittsenthalpie $h_{\mathrm{KM,aus}}$ sowie Luftaustrittstemperatur $T_{\mathrm{L,aus}}$ bestimmen. Der Massenstrom $\dot{M}$ des jeweiligen Fluids ist konstant und damit in jeder Zelle gleich. Die Eintrittsenthalpie des Kältemittels $h_{\mathrm{KM,ein}}$ ist durch Eingangsdruck und Dampfanteil gegeben.

\begin{equation}
\label{eq:36}
\dot{Q} = \dot{M}_{\mathrm{KM}} (h_{\mathrm{KM,ein}} - h_{\mathrm{KM,aus}}) = \dot{M}_{\mathrm{L}} c_{\mathrm{p,L}}(T_{\mathrm{L,ein}} - T_{\mathrm{L,aus}})
\end{equation}

Die $\epsilon-NTU$-Methode ist nur gültig für die Annahme trockener Luft. Aufgrund dessen muss das Modell mit Untersuchungen, die bei einer relativen Luftfeuchtigkeit von \unit{0}{\%} durchgeführt werden, validiert werden. Im Weiteren muss für die Berechnung des Wärmeübertragers eine geeignete Modellierungsmethode gewählt werden.

\subsection{Modellierungsmethode}
\label{subsec:Das Modell}

Mithilfe der Gleichungssysteme aus Abschnitt~\ref{subsec:Berechnung des Druckabfalls in der Zweiphasen-Strömung} und \ref{subsec:Berechnung des Wärmeübergangs} lassen sich, durch Angabe der Eingangswerte Druck, Dampfanteil, Temperatur und Massenstrom des Kältemittels sowie Temperatur und Massenstrom der Luft (aus Energiebilanz), Ausgangswerte nach einer definierten Rohrlänge berechnen. Da die Ergebnisse einer Zelle von den Eingangswerten abhängig sind, bietet eine Unterteilung in mehrere kleine Zellen eine höhere Genauigkeit. Das Modell wird entsprechend der Anzahl der Verdampferrohre eines Kältekreises in sechs Berechnungszellen unterteilt. Jeder einzelnen Zelle werden auf Basis des Eintrittszustandes des Fluids die für diesen gültigen Gleichungen zugeordnet. Die Variablen der Ein- und Austrittsgrößen jeder Zelle werden, entsprechend der realen Verschaltung, miteinander verknüpft. Auf diese Weise ergibt sich aus dem Gesamtapparat ein System zusammengeschalteter Einzelapparate \cite{LehrstuhlfurWarmeundStoffubertragung.b}.
Über die Benutzeroberfläche lässt sich der Zustand beider Fluide nach jeder einzelnen Zelle ablesen und somit mit den Daten des realen Verdampfers vergleichen.
Das Modell ist gültig für den die Annahme trockener Luft. Da auch in einer Klimakammer \unit{0}{\%} relative Feuchtigkeit schwierig zu erreichen sind, ist eine Abweichung der Ergebnisse zu erwarten. \newline
Bei der Zellenmethode wird die Austauschfläche in Teilbereiche unterteilt, die nacheinander seperat von beiden Fluidströmen durchströmt werden. Jede Teilfläche wird als Fläche eines Einzelapparates mit individuellen Ein- und Austrittstemperaturen beider Fluide aufgefasst. Abbildung~\ref{fig:Zellenmethode} stellt die schematischen Darstellungen beider Verschaltungsarten gegenüber. In Verschaltung~V2 sind die Anfangswerte der Luft und des Kältemittels in der ersten und der letzten Zelle vorgegeben, deshalb erfolgt die Berechnung iterativ. In Verschaltung-V3 ist der Rechenaufwand geringer, da die Berechnung der Zellen~2 bis 4 nicht iterativ erfolgt.

\begin{figure}[htb]
\centering
	\subfigure[Verschaltung V2]{}
	\subfigure[Verschaltung V3]{}
\caption{Schematische Darstellung der Verschaltung anhand der Zellenmethode.}
\label{fig:Zellenmethode}
\end{figure}

%%%%%%%%%%%%%%%%%%%%%%%%%%%%%%%%%%%%%%%%%%%%%%%%%%%%%%%%%%%%%%%%%%%%%%%%%%%%%%%%%%%%%%%%

\chapter{Versuchsdurchführung und Ergebnisse}
\label{cha:Versuchsdurchführung}

In diesem Kapitel werden die Durchführung der Untersuchungen sowie die erzielten Ergebnisse beschrieben. Tabelle~\ref{tab:alltests} bietet einen Überblick über die im Rahmen der Arbeit relevanten Untersuchungen.

\begin{table}[h!]
\centering
\caption{Spezifikationen der durchgeführten Untersuchungen.}
\label{tab:alltests}
\begin{tabular}{|ccccccc|}
\hline
Test Nr.              & r. F.                     & Überhitzung              & Öl                               & Abtauintervall          & Verdichter                           & Verdampfer \\ \hline
\multicolumn{1}{|c|}{1} & \multicolumn{1}{c|}{60\%} & \multicolumn{1}{c|}{8K}  & \multicolumn{1}{c|}{3MAF}        & \multicolumn{1}{c|}{4h} & \multicolumn{1}{c|}{ZB09KAU-TFD Hyb} & V1       \\
\multicolumn{1}{|c|}{2} & \multicolumn{1}{c|}{60\%} & \multicolumn{1}{c|}{8K}  & \multicolumn{1}{c|}{HC~4467} & \multicolumn{1}{c|}{4h} & \multicolumn{1}{c|}{ZB09KAU-TFD Hyb} & V1        \\
\multicolumn{1}{|c|}{3} & \multicolumn{1}{c|}{60\%} & \multicolumn{1}{c|}{8K}  & \multicolumn{1}{c|}{HC~4467} & \multicolumn{1}{c|}{3h} & \multicolumn{1}{c|}{ZB09KAU-TFD Hyb} & V1        \\
\multicolumn{1}{|c|}{4} & \multicolumn{1}{c|}{60\%} & \multicolumn{1}{c|}{8K}  & \multicolumn{1}{c|}{HC~4467} & \multicolumn{1}{c|}{3h} & \multicolumn{1}{c|}{ZB09KAU-TFD}     & V1        \\
\multicolumn{1}{|c|}{5} & \multicolumn{1}{c|}{60\%} & \multicolumn{1}{c|}{8K}  & \multicolumn{1}{c|}{HC~4467} & \multicolumn{1}{c|}{3h} & \multicolumn{1}{c|}{ZB09KAU-TFD}     & V2    \\
\multicolumn{1}{|c|}{6} & \multicolumn{1}{c|}{60\%} & \multicolumn{1}{c|}{13K} & \multicolumn{1}{c|}{HC~4467} & \multicolumn{1}{c|}{3h} & \multicolumn{1}{c|}{ZB09KAU-TFD}     & V2    \\
\multicolumn{1}{|c|}{7} & \multicolumn{1}{c|}{0\%}  & \multicolumn{1}{c|}{13K} & \multicolumn{1}{c|}{HC~4467} & \multicolumn{1}{c|}{3h} & \multicolumn{1}{c|}{ZB09KAU-TFD}     & V2    \\
\multicolumn{1}{|c|}{8} & \multicolumn{1}{c|}{0\%}  & \multicolumn{1}{c|}{13K} & \multicolumn{1}{c|}{HC~4467} & \multicolumn{1}{c|}{3h} & \multicolumn{1}{c|}{ZB09KAU-TFD}     & V3    \\
\multicolumn{1}{|c|}{9} & \multicolumn{1}{c|}{60\%} & \multicolumn{1}{c|}{13K} & \multicolumn{1}{c|}{HC~4467} & \multicolumn{1}{c|}{3h} & \multicolumn{1}{c|}{ZB09KAU-TFD}     & V3    \\ \hline
\end{tabular}
\end{table}

\section{Einstellung von Normbedingungen}
\label{sec:EinstellungvonNormbedingungen}

In diesem Abschnitt werden die für die Einstellung von Normbedingungen durchgeführten Untersuchungen beschrieben.
Vor Durchführung der einzelnen Untersuchungen ist es notwendig zu prüfen ob die Umgebungsbedingungen konstant sind und sich an der Norm (siehe Abschnitt~\ref{sec:Testbedingungen nach Norm}) orientieren. Zu diesem Zweck werden entsprechend Abbildung~\ref{fig:Messpunkte} Sensoren positioniert. Diese zeichnen Temperatur und Geschwindigkeit der Luft über einen Zeitraum von \unit{10}{\min} auf. Mithilfe eines elektrischen Dampferzeugers wird die Luftströmung in der Klimakammer sichtbar gemacht. Damit ist es möglich ein Strömungsbild zu visualisieren und mögliche Ansatzpunkte zum Erreichen der Normbedingungen zu identifizieren. Es werden die Leistung und die Anzahl der laufenden Lüftermotoren über die Steuerungssoftware der Klimakammer verändert um die Raumströmung zu verändern. Zum Nachweis des Einflusses der Deckenöffnung auf das Strömungsbild der Luft wird diese verdeckt. Der Weg des geringsten Widerstandes für die Luft läuft somit entgegen der vorgesehenen Strömungsrichtung durch die abgeschaltete Lüftungsanlage von Kammer A. Dadurch wird das Ziel verfolgt, ein gleichmäßiges Strömungsbild zu generieren.  \newline
Werden die Ergebnisse aller durchgeführten Untersuchungen miteinander verglichen, so lassen sich diese hinsichtlich des Erreichens von Geschwindigkeiten zwischen \unit{0,1}{\meter\per\second} und \unit{0,2}{\meter\per\second} an den drei Messpunkten auf die in Tabelle~\ref{tab:Lüfterleistungen} aufgeführten Untersuchungen eingrenzen. Eine weitere Reduktion der Leistung führt sowohl beim Betrieb mit fünf Lüftern, als auch mit zwei Lüftern dazu, dass am unteren Messpunkt keine Luftbewegung mehr stattfindet. 

\begin{table}[h!]
\centering
\caption{Untersuchungen zur Ermittlung eines der Norm entsprechenden Betriebspunkts.}
\label{tab:Lüfterleistungen}
\begin{tabular}{|ccc|}
\hline
Lüfteranzahl            & Lüfterleistung          & Decke       \\
{[}Anzahl{]}            & {[}\%{]}                &             \\ \hline
\multicolumn{1}{|c|}{5} & \multicolumn{1}{c|}{10} & offen       \\
\multicolumn{1}{|c|}{5} & \multicolumn{1}{c|}{10} & geschlossen \\
\multicolumn{1}{|c|}{2} & \multicolumn{1}{c|}{30} & offen       \\
\multicolumn{1}{|c|}{2} & \multicolumn{1}{c|}{30} & geschlossen \\ \hline
\end{tabular}
\end{table}

%\begin{table}[h!]
%\centering
%\caption{Untersuchungen zur Ermittlung eines der Norm entsprechenden Betriebspunkts.}
%\label{tab:Lüfterleistungen}
%\begin{tabular}{|ccc|}
%\hline
%Lüfteranzahl            & Lüfterleistung          & Decke       \\
%{[}Anzahl{]}            & {[}\%{]}                &             \\ \hline
%\multicolumn{1}{|c|}{5} & \multicolumn{1}{c|}{8}  & offen       \\
%\multicolumn{1}{|c|}{5} & \multicolumn{1}{c|}{9}  & offen       \\
%\multicolumn{1}{|c|}{5} & \multicolumn{1}{c|}{10} & offen       \\
%\multicolumn{1}{|c|}{5} & \multicolumn{1}{c|}{10} & geschlossen \\
%\multicolumn{1}{|c|}{2} & \multicolumn{1}{c|}{24} & offen       \\
%\multicolumn{1}{|c|}{2} & \multicolumn{1}{c|}{25} & offen       \\
%\multicolumn{1}{|c|}{2} & \multicolumn{1}{c|}{30} & offen       \\
%\multicolumn{1}{|c|}{2} & \multicolumn{1}{c|}{30} & geschlossen \\ \hline
%\end{tabular}
%\end{table}

Die Abbildungen~\ref{fig:10pctOC} - \ref{fig:30pctCC} zeigen den zeitlichen Verlauf der gemessenen Luftgeschwindigkeiten an den Positionen 1 - 3. Auf der y-Achse ist die Luftgeschwindigkeit in \unit{}{\metre\per\second} abzulesen, auf der x-Achse die Zeit in $h$. Die grünen Markierungen grenzen den Bereich der Luftgeschwindigkeit ein, der durch die Norm vorgeschrieben ist. Die gestrichelten Linien markieren den zeitlichen Mittelwert des jeweiligen Messwertes. \newline
Bei \unit{30}{\%} Lüfterleistung liegen die Geschwindigkeiten an den Messpunkten 1 und 2 über dem Sollwert. Die Geschwindigkeit an Position 3 liegt darunter. Die maximalen Geschwindigkeiten werden an Position 2, auf mittlerer Höhe des Kühlmöbels, gemessen. Diese betragen \unit{0.35}{\metre\per\second} bei offener Decke und \unit{0.3}{\metre\per\second} bei geschlossener Decke. 
Bei \unit{10}{\%} Lüfterleistung liegt der Mittelwert der gemessenen Geschwindigkeit an Position 2 immer innerhalb des vorgeschriebenen Bereichs. Die Geschwindigkeit an Position 1 liegt darüber, die Geschwindigkeit an Position 3 darunter. Die maximalen Geschwindigkeiten betragen \unit{0.35}{\metre\per\second} bei offener Decke und \unit{0.3}{\metre\per\second} bei geschlossener Decke und werden an Position 1 gemessen. \newline
Abbildungen~\ref{fig:10pctOC_temp} und \ref{fig:30pctOC_temp} stellen jeweils den zeitlichen Verlauf der Lufttemperatur an den Positionen 1 - 3 während der Untersuchungen mit \unit{10}{\%} und \unit{30}{\%} Lüfterleistung bei offener Decke dar.
Während die Temperatur an den Positionen 1 und 2 circa im angestrebten Bereich um \unit{25}{\celsius} liegt ist auffällig, dass die Temperatur in Position 3 nach unten abweicht. Beim Betrieb mit \unit{10}{\%} Lüfterleistung ist die Abweichung mit \unit{7}{\kelvin} sehr groß. Bei \unit{30}{\%} Lüfterleistung ist diese nur \unit{1.5}{\kelvin} groß. \newline
Die Abbildungen~\ref{fig:Klimakammer_offeneDecke} und \ref{fig:Klimakammer_geschlosseneDecke} visualisieren den Strömungsverlauf der Luft in der Kammer. Die roten Pfeile stellen dabei eine sichtbare Luftbewegung dar.
Bei geöffneter Decke ist zu erkennen, dass die Luft quer über das Kühlmöbel Richtung Deckenöffung strömt. Bei geschlossener Decke ist der Strömungsverlauf parallel zum Kühlmöbel.

\begin{figure}[h!tb]
\centering

\caption{Luftgeschwindigkeiten bei 10\% Lüfterleistung und offener Decke.}
\label{fig:10pctOC}
\end{figure}

\begin{figure}[h!tb]
\centering

\caption{Luftgeschwindigkeiten bei 10\% Lüfterleistung und geschlossener Decke.}
\label{fig:10pctCC}
\end{figure}

\begin{figure}[h!tb]
\centering

\caption{Luftgeschwindigkeiten bei 30\% Lüfterleistung und offener Decke.}
\label{fig:30pctOC}
\end{figure}

\begin{figure}[h!tb]
\centering

\caption{Luftgeschwindigkeiten bei 30\% Lüfterleistung und geschlossener Decke.}
\label{fig:30pctCC}
\end{figure}

\begin{figure}[h!tb]
\centering

\caption{Lufttemperaturen bei 10\% Lüfterleistung und offener Decke.}
\label{fig:10pctOC_temp}
\end{figure}

\begin{figure}[h!tb]
\centering

\caption{Lufttemperaturen bei 30\% Lüfterleistung und offener Decke.}
\label{fig:30pctOC_temp}
\end{figure}

\begin{figure}[h!tb]
\centering

\caption{Schematische Darstellung der Luftströmung in der Klimakammer mit Deckenöffnung.}
\label{fig:Klimakammer_offeneDecke}
\end{figure}

\begin{figure}[h!tb]
\centering

\caption{Schematische Darstellung der Luftströmung in der Klimakammer ohne Deckenöffnung.}
\label{fig:Klimakammer_geschlosseneDecke}
\end{figure}

\clearpage

\section{Kältemittelöle}
\label{sec:EinflussÖl}

In diesem Abschnitt werden die Untersuchungen des Betriebs mit den Kältemittelölen 3MAF und HATCOL~4467 beschrieben und die Untersuchungsergebnisse miteinander verglichen.
Simulationen belegen einen nicht zu vernachlässigenden Anteil im Öl gelösten Kältemittels, was zu einer Minderung der Verdampferleistung führt  \cite{Universitatpolitecnicadevalencia.2017}. Diese führen zu dem Schluss, dass sich ein hoher Anteil des Öles im Kältekreis befinden muss. Es wird die Annahme gemacht, dass der Ölrücktransport nicht einwandfrei sichergestellt werden kann und dass sich demnach, konservativ abgeschätzt, \unit{20}{\%} des Öles im Kältekreis befinden. Damit berechnet sich die Menge des im Öl gelösten Kältemittels wie in Tabelle~\ref{tab:LöslichkeitHC3M} dargestellt.
Die berechneten Werte beziehen sich exemplarisch auf einen Kältekreis und basieren auf den Versuchsdaten der Untersuchung von 3MAF.
Mittels der Gleichungen~\ref{eq:1}, \ref{eq:3} und \ref{eq:2} werden die Viskosität, die Dichte und die Löslichkeit des Kältemittels im jeweiligen Öl berechnet. Es ist zu erkennen, dass Propan in 3MAF eine höhere Löslichkeit besitzt als in HATCOL~4467 und dieses folglich mehr Kältemittel aufnehmen kann. Zudem ist die errechnete Löslichkeit in den Wärmeübertragern höher als im Verdichter. \newline
In Tabelle~\ref{tab:VergleichKMOele} sind die berechneten Daten der jeweiligen Untersuchungen mit den Ölen 3MAF und HATCOL~4467 aufgeführt. Dabei beziehen sich die Daten im ersten und letzten Abschnitt der Tabelle auf das ganze System und die Daten in den mittleren Abschnitten auf die jeweiligen Kältekreise des Kühlmöbels.
Der Vergleich der Daten beider Untersuchungen zeigt eine um etwa \unit{100}{\watt} höhere elektrische Leistungsaufnahme beim Betrieb mit HATCOL~4467, sowie eine um etwa \unit{60}{\watt} höhere Verdampfungsleistung. Die Verflüssigungsleistung ist um etwa \unit{300}{\watt} höher. Der EER verzeichnet jedoch eine Reduktion um circa \unit{3}{\%}. Die Verdampfungstemperaturen sowie die Überhitzungen in allen drei Kältekreisen sinken tendenziell. Die Änderung ist sehr gering und bewegt sich im Rahmen der Messungenauigkeit. \newline
Auffällig ist ein Anstieg der Kondensationstemperatur, sodass diese, im Gegensatz zu Untersuchung~1, in Untersuchung~2 die eingestellten \unit{35}{\celsius} erreicht. Ein geringes Absinken des Druckabfalls um etwa \unit{0.05}{\bbar} über den Verdampfer ist zu beobachten. Der Kältemittelmassenstrom sinkt in allen Kreisen um bis zu \unit{0.16}{\metre\per\second}. Die Dampfanteile vor den Expansionsventilen sind beim Betrieb mit HATCOL~4467 in allen Kreisen geringer als beim Betrieb mit 3MAF. Diese Effekte werden in Kreis~1 am deutlichsten. 
Luft- und produkttemperaturseitig ist keine eindeutige Veränderung zu erkennen. 
Die Einlasstemperatur der Luft ist beim Betrieb mit HATCOL~4467 \unit{1}{\kelvin} höher als beim Betrieb mit 3MAF und damit der größte abweichende Wert. \newline
Zuletzt wird mithilfe eines Spülsystems für Kälteanlagen geprüft ob sich zurückgebliebenes Öl in den Kältekreisen befindet. Dieses befördert flüssiges Kältemittel durch das System und sammelt mithilfe eines Ölabscheider im System verbliebenes Öl.

\clearpage

\begin{table}[h!]
\centering
\caption{Löslichkeitsverhalten von HATCOL~4467 und 3MAF.}
\label{tab:LöslichkeitHC3M}
\begin{tabular}{|cccc|}
\hline
                                           & 10\% Öl im Verdampfer      & 80\% Öl im Verdichter     & 10\% Öl im Kondensator \\ \hline
\multicolumn{1}{|l}{}                      & \multicolumn{3}{c|}{HATCOL~4467}                                                  \\ \hline
\multicolumn{1}{|c|}{Viskosität {[}cSt{]}} & \multicolumn{1}{c|}{3.29}  & \multicolumn{1}{c|}{38.66} & 0.89                    \\
\multicolumn{1}{|c|}{Dichte {[}g/cm³{]}}   & \multicolumn{1}{c|}{0.79}  & \multicolumn{1}{c|}{0.94}  & 0.73                    \\
\multicolumn{1}{|c|}{Löslichkeit {[}\%{]}} & \multicolumn{1}{c|}{35.4}  & \multicolumn{1}{c|}{5.0}   & 37.1                    \\
\multicolumn{1}{|c|}{KM in Öl {[}g{]}}     & \multicolumn{1}{c|}{13.09} & \multicolumn{1}{c|}{17.55} & 12.79                   \\
\multicolumn{1}{|c|}{KM in Öl {[}\%{]}}    & \multicolumn{1}{c|}{8.7}     & \multicolumn{1}{c|}{11.7}    & 8.5                       \\ \hline
\multicolumn{1}{|l}{}                      & \multicolumn{3}{c|}{3MAF}                                                         \\ \hline
\multicolumn{1}{|c|}{Viskosität {[}cSt{]}} & \multicolumn{1}{c|}{1.95}  & \multicolumn{1}{c|}{17.73} & 0.87                    \\
\multicolumn{1}{|c|}{Dichte {[}g/cm³{]}}   & \multicolumn{1}{c|}{0.75}  & \multicolumn{1}{c|}{0.93}  & 0.70                    \\
\multicolumn{1}{|c|}{Löslichkeit {[}\%{]}} & \multicolumn{1}{c|}{41.0}  & \multicolumn{1}{c|}{5.2}   & 41.6                    \\
\multicolumn{1}{|c|}{KM in Öl {[}g{]}}     & \multicolumn{1}{c|}{14.53} & \multicolumn{1}{c|}{18.07} & 13.80                   \\
\multicolumn{1}{|c|}{KM in Öl {[}\%{]}}    & \multicolumn{1}{c|}{9.7}    & \multicolumn{1}{c|}{12.0}    & 9.2                       \\ \hline
\multicolumn{1}{|c|}{Differenz {[}g{]}}    & \multicolumn{1}{c|}{1.45}  & \multicolumn{1}{c|}{0.52}  & 1.01                    \\ \hline
\end{tabular}
\end{table}

\section{Abtauintervalle}
\label{sec:Abtauintervalle}

In diesem Abschnitt werden die Untersuchungen des Betriebs mit einem Zeitabtauintervall von \unit{4}{\hour} und von \unit{3}{\hour} beschrieben und deren Ergebnisse miteinander verglichen. 
Tabelle~\ref{tab:Vergleich4h3h} zeigt die Ergebnisse der beiden Untersuchungen.
Während die elektrische Leistungsaufnahmen in etwa gleich groß sind, vergrößern sich bei bedarfsgerechter Abtauung die übertragenen Wärmeströme an den Wärmeübertragern deutlich um circa \unit{350}{\watt}. Dies verursacht eine Erhöhung des EER von \unit{2.14}{} auf \unit{2.26}{}.
Es ist ein Anstieg der Verdampfungstemperaturen in allen drei Kältekreisen um circa \unit{2}{\kelvin} erkennbar. Die Kondensationstemperaturen sind unverändert. Der Massenstrom des Kältemittels steigt um etwa \unit{0.7}{\gram\per\second}. Der Druckabfall über den Verdampfer steigt um etwa \unit{0.05}{\bbar}. Der Dampfanteil des Kältemittels am Kondensatoraustritt steigt um \unit{3}{\%} bis \unit{5}{\%}. Die Auslasstemperatur der Luft steigt um fast \unit{1}{\kelvin} während die Einlasstemperatur der Luft und die Produkttemperaturen unverändert bleiben. \newline
Es ist zu untersuchen, warum eine Verkürzung des Abtauintervalls einen Effizienzgewinn verursacht. \newline
Ein Vergleich der Zeitabtauung mit der bedarfsgerechten Abtauung zeigt, dass diese die Abtauung nach etwa \unit{4}{\hour} einleitet. Der Detektionsalgorithmus der Bedarfsabtauung weist damit aufgrund einer zu späten Abtauung Verbesserungspotential auf. Er soll hinsichtlich des Erreichens eines kürzeren Abtauintervalls untersucht werden. \newline
Im Anschluss der Untersuchungen der Abtauintervalle werden die Hybrid-Verdichter des Kühlmöbels mit der Standardausführung ausgetauscht.

\clearpage

\section{Verdichter}
\label{sec:Verdichter}

In diesem Abschnitt werden die Untersuchungsergebnisse des Betriebs mit zwei Ausführungen des in Abschnitt~\ref{sec:Das Kühlregal} vorgestellten Verdichtermodells verglichen. 
Ein Austausch der Verdichter umfasst die Entsorgung der vorherigen Kältemittelfüllung, den Aus- und Einbau der Verdichter sowie die Inbetriebnahme, inklusive Druckfestigkeits- und Dichtheitsprüfung. Nach dieser wird das Kühlmöbel bis zum Erreichen einer konstanten Produkttemperatur betrieben. Anschließend beginnt der beobachtete Messzeitraum von \unit{24}{\hour}. \newline
Tabelle~\ref{tab:Verdichterdatenblatt} zeigt die Herstellerdaten beider Verdichtervarianten bei einer Kondensationstemperatur von \unit{35}{\celsius}, einer Verdampfungstemperatur von \unit{-10}{\celsius}, einer Überhitzung von \unit{10}{\kelvin} und einer Unterkühlung von \unit{0}{\kelvin} für einen Verdichter \cite{EmersonClimateTechnologies.},\cite{EmersonClimateTechnologies.2018}. Die Standardausführung verspricht einen um \unit{0.04}{\gram\per\second} höheren Kältemittelmassenstrom bei gleichzeitig um \unit{30}{\watt} geringerer elektrischer Leistungsaufnahme und \unit{10}{\watt} niedrigerer Kälteleistung gegenüber der Hybridausführung.  \newline
Tabelle~\ref{tab:VergleichVerdichter} sind die erfassten und berechneten Messwerte der Untersuchungen zu entnehmen. Diese zeigen eine signifikante Erhöhung der elektrischen als auch der thermischen Leistungen um etwa \unit{400}{\watt} beim Wechsel der Hybrid- zur Standardausführung des Verdichters. Der EER erfährt nur eine geringe Erhöhung um \unit{0.9}{\%}. Es ist zudem eine Reduzierung des Kältemittelmassenstroms \unit{0.3}{\gram\per\second} bis \unit{0.5}{\gram\per\second} zu erkennen und eine Reduzierung des Dampfanteils am Kondensatoraustritt um \unit{5}{\%} bis \unit{14}{\%}. In Kreis~2 ist dies besonders gut zu erkennen. Der Druckabfall in den Kreisen~2 und 3 erfährt eine Reduktion während der Druckabfall gering ansteigt. Die kältekreis- und luftseitig erfassten Temperaturen unterscheiden sich nicht signifikant. Die Änderungen liegen im Bereich der Messungenauigkeit. Der Vergleich mit den Herstellerdaten zeigt, dass sich das System entgegengesetzt der Voraussagen verhält. Statt einem höheren Massenstrom und geringerer elektrischer Leistungsaufnahme stellt sich ein niedrigerer Massenstrom bei erhöhter elektrischer Leistungsaufnahme ein. Dieser Widerspruch wird ihm Rahmen der Analyse betrachtet.\newline
Die log-p-h-Diagramme~\ref{fig:logph51} und \ref{fig:logph54} zeigen das Zwei-Phasen-Gebiet von R290 im Anwendungsbereich. Auf der x-Achse ist die Enthalpie in \unit{}{\kilo\joule\per\kilo\gram} und auf der y-Achse logarithmisch der Druck in $bar$ aufgetragen. Der Vergleich zeigt die Erhöhung der Kondensations- sowie der Verdampfungsenthalpie nach Wechsel zur Standardausführung exemplarisch an Kreis 2. Die Werte werden jeweils \unit{10}{\%} vor Ende des letzten Zyklus erfasst. Es ist zu untersuchen, warum eine Leistungserhöhung der Wärmeübertrager erzielt wird. \newline
Im Anschluss wird der Verdampfer des Kühlmöbels ausgetauscht, um mit den Untersuchungen bezüglich dessen Einflusses auf die Kälteleistung des Kühlmöbels fortfahren zu können. 

\begin{figure}[h!]
\centering

\caption{logp-h-Diagramm (K2) beim Betrieb mit Verdichtermodell ZB09KAU-TFD (Hybrid) \unit{10}{\%} vor Ende des Zyklus.}
\label{fig:logph51}
\end{figure}

\begin{figure}[h!]
\centering

\caption{logp-h-Diagramm (K2) beim Betrieb mit Verdichtermodell ZB09KAU-TFD \unit{10}{\%} vor Ende des Zyklus.}
\label{fig:logph54}
\end{figure}

\clearpage

\section{Änderung der Verdampferschaltung}
\label{sec:Änderung der Verdampferschaltung}

In diesem Unterkapitel wird der Wechsel der Verdampfer und deren Verschaltungen sowie die daran durchgeführten Untersuchungen beschrieben. Abbildung~\ref{fig:Verschaltungsarten} zeigt die untersuchten Verdampfer und ihre Verschaltungsarten. Der bei AHT-Kühlmöbeln standardmäßig verbaute Verdampfer ist zweireihig und die Rohrreihen sind parallel angeordnet. Trotz reduzierter Rohranzahl sind in den Lamellen Lochungen, samt deren Grate, für weitere Rohre vorhanden, sodass die Luftströmung innerhalb des Verdampfers nicht dadurch beeinflusst wird. Im Anschluss soll ein vierreihiger Verdampfer mit versetzten Rohrreihen untersucht werden. Dieser verspricht aufgrund der effizienteren Bauform einen höheren kA-Wert und damit nach Gleichung~\ref{eq:4} einen höheren übertragbaren Wärmestrom. Mithilfe des in Abschnitt~\ref{sec:Simulationsmodell} präsentierten Simulationsmodells werden die Verschaltungen V2 und V3 zur Validierung des Modells bei \unit{0}{\%} r.F.  miteinander verglichen. Zuletzt werden die Untersuchungsergebnisse beider Verschaltungen unter den Normbedingungen bei \unit{60}{\%} r. F miteinander verglichen, um die Verschaltung unter Normbedingungen bewerten zu können.

\begin{figure}[h!tb]
\centering
	\subfigure[Verschaltung V1]{}
	\subfigure[Verschaltung V2]{}
	\subfigure[Verschaltung V3]{}
\caption{Die untersuchten Verdampfer und Verschaltungsarten.}
\label{fig:Verschaltungsarten}
\end{figure}

\subsection{Vergleich zwischen Verdampfern}
\label{subsec:Vergleich zwischen Verdampfern}

In diesem Abschnitt wird der Umbau des Kühlmöbels beschrieben und die Ergebnisse der Untersuchungen von Verschaltung~V1 und V2 beschrieben und verglichen. Der vierreihiger Verdampfer besitzt die gleichen Abmessungen wie der zweireihige. Rohrdurchmesser und Rohrdicke sind identisch. Der Einbau eines neuen Verdampfers im Kühlmöbel erfordert zunächst eine komplette Demontage des Innenraums. Das Kältemittel der Anlage wird entsorgt. Die M-Pakete werden entfernt und zwischengelagert. Daraufhin werden die Regalbretter, die Verkleidungen des Bodens, der Rückwand sowie der Decke und die Seitenwände demontiert. Die Abdeckungen des Verdampfers und die Lüfter müssen entfernt werden. Bevor die Lötverbindungen des Verdampfers getrennt werden können müssen noch alle Temperatursensoren entfernt werden. Anschließend erfolgt ein Austausch des Verdampfers und eine Montage des kompletten Kühlmöbels in umgekehrter Reihenfolge der zuvor beschriebenen Schritte. Danach wird die Anlage erneut mit \unit{150}{\gram} Propan pro Kreis gefüllt. Vor Inbetriebnahme des Kühlmöbels wird eine Dichtheits- und eine Druckfestigkeitsprüfung an den drei Kältekreisen durchgeführt. Unter gleichen Bedingungen wie zuvor wird erneut eine Untersuchung durchgeführt. \newline 
In Tabelle~\ref{tab:Vergleichaltneu} sind die Ergebnisse der Untersuchungen des Betriebs in Verschaltung~V1 und V2 dargestellt.
Der Vergleich zeigt eine Reduktion der thermischen Leistungen um etwa \unit{1000}{\watt} bei gleichbleibender elektrischer Leistungsaufnahme. Dies resultiert in einer Reduktion des EER um \unit{16.2}{\%} von \unit{2.28}{} auf \unit{1.91}{}. In den Kältekreisen ist ein Anstieg der Verdampfungstemperaturen um \unit{3}{\kelvin} bis \unit{5}{\kelvin} zu erkennen. Die Kondensationstemperaturen bleiben etwa konstant. Lediglich in Kreis~3 weicht diese um fast \unit{1}{\kelvin} nach unten ab. Die Überhitzung ist während des Betriebs in Verschaltung~2 um \unit{3}{\kelvin} bis \unit{4}{\kelvin} größer. Auffällig ist, dass mit dem Einbau des neuen Verdampfers die vom Expansionsventil erfasste Überhitzung stets um etwa \unit{2}{\kelvin} von der messtechnisch erfassten Überhitzung nach oben abweicht. Der Dampfanteil ist um bis zu \unit{28}{\%} größer und liegt bei \unit{35}{\%} und \unit{34}{\%} in den Kreisen~1 und 2 und bei \unit{43}{\%} in Kreis~3. Der Massenstrom des Kältemittels ist in allen Kreisen etwa \unit{1}{\gram\per\second} bis \unit{1.5}{\gram\per\second} größer. Der Druckabfall über den Verdampfer ist \unit{0.1}{\bbar} größer. \newline
Bei der Betrachtung der Produkt- und Lufttemperaturen ist eine deutliche Erhöhung dieser Messwerte auffällig. Die Durchschnittstemperatur der Produkte ist um fast \unit{2}{\kelvin} höher. Die minimale Produkttemperatur steigt stark von circa \unit{1}{\celsius} auf fast \unit{4}{\celsius} an während die maximale Produkttemperatur unverändert ist. Die Ein- und Auslasstemperaturen der Luft sind ebenso um \unit{2}{\kelvin} höher. \newline
Es ist zu untersuchen warum der Verdampferaustausch eine derartige Verschlechterung hinsichtlich der erzielten Leistungen und Temperaturen mit sich führt.

\clearpage

\subsection{Modellgestützter Vergleich der Verschaltungen V2 und V3}
\label{subsec:Modellgestützter Vergleich der Verschaltungen V2 und V3}

In diesem Abschnitt wird die Modellbildung sowie der Verdampferumbau erläutert und die Simulationsergebnisse mit den Versuchsdaten verglichen.
Zunächst wird, wie in Abschnitt~\ref{sec:Simulationsmodell} beschrieben, ein Modell mithilfe des Programms EES entwickelt. 
Die Grundidee hinter dem Modell ist den, durch den hohen Kältemittelmassenstrom bei gleichzeitig geringem Durchmesser der Verdampferrohre bedingten, Druckabfall und das damit einhergehende Absinken der Sättigungstemperatur zur Erhöhung der Kälteleistung zu nutzen. Im Ausgangsmodell durchströmt das Kältemittel den Verdampfer im Gegenstromprinzip. Aufgrund des Druckabfalls verhält sich diese Anordung wie eine Kombination aus Gleich- und Gegenstrom. Wird nun die Anordnung der Rohre dahingehend geändert, dass das Kältemittel den Verdampfer von dessen Mitte aus im Gleichstrom mit der Luft nach oben durchströmt, die Luft jedoch wie zuvor bei den überhitzten Rohrreihen einströmt, so wird der gegenteilige Effekt erzielt. Der Wärmeübertrager bietet eine Kombination aus Gleich- und Gegenstrom, verhält sich aber wie ein reiner Gegenstromverdampfer. Hierbei ist am Verdampferaustritt der Luft eine höhere Temperaturdifferenz zum Kältemittel zu erwarten. 
Wegen der angewandten $\epsilon$-$NTU$-Methode ist das Modell nur gültig für trockene Luft \cite{Bergman.2011}. Basierend auf dieser Annahme ist es nötig, die Berechnung ganzheitlich für trockene Luft durchzuführen sowie das Modell mit Versuchsdaten von Untersuchungen bei \unit{0}{\%} relativer Feuchtigkeit zu validieren. In der Klimakammer sind bei dieser Einstellung lediglich relative Feuchtigkeiten zwischen \unit{5}{\%} und \unit{25}{\%} erzielbar. Am Lufteinlass des Verdampfers beträgt die relative Feuchtigkeit etwa \unit{40}{\%}, weswegen mit einer äquivalenten Temperatur gerechnet werden muss. Bei konstanter Enthalpie entspricht die Ist-Temperatur von \unit{4.42}{\celsius} bei \unit{40}{\%} r.F. einer äquivalenten Temperatur von \unit{9.75}{\celsius} bei \unit{0}{\%} r.F.. \newline
Für die Berechnung der Wärmeleitwiderstände, mittels der Gleichungen~\ref{eq:28} bis \ref{eq:31}, ist es notwendig die Wärmeübergangs- und Wärmeleitkoeffizienten zu bestimmen. Eine Berechnung dieser Werte mittels geeigneter Modelle liefert fehlerhafte Werte infolgederer das Modell instabil ist. Um den Rechenaufwand sowie Fehlerquellen gering zu halten werden die in Tabelle~\ref{tab:Werte der Wärmeübergangs- und Wärmeleitzahlen} dargestellten Annahmen getroffen \cite{Bergman.2011},\cite{Recknagel.2005},\cite{DINDeutschesInstitutfurNormunge.V..2017d}. Dabei werden die Wärmeübergangskoeffizienten der Luft $\alpha_\mathrm{L}$, des Kältemittels $\alpha_\mathrm{KM}$ und des überhitzten Kältemittels $\alpha_\mathrm{KM,SH}$ so gewählt, dass das errechnete Temperaturprofil des Kältemittels dem erfassten Temperaturprofil, auf Basis der Messwerte von Untersuchung~61, entspricht. 
Für die Berechnung der Rohrstrecken, welche mit zweiphasigem Kältemittel beaufschlagt werden, werden Gleichung~\ref{eq:33} und der Wärmeübergangskoeffizient $\alpha_\mathrm{KM}$ verwendet. Aus dem erfassten Temperaturprofil ist ersichtlich, dass nur die letzte Rohrstrecke überhitzt ist. Für diese werden Gleichung~\ref{eq:34} und der Wärmeübergangskoeffizient $\alpha_\mathrm{KM,SH}$ verwendet. \newline
Das Modell wird exemplarisch für einen Kältekreis im Verdampfer erstellt. Damit die Ergebnisse vergleichbar mit denen der Untersuchungen sind wird mit einem Drittel des Luftmassenstroms gerechnet. 

\begin{table}[h!]
\centering
\caption{Werte der Wärmeübergangs- und Wärmeleitkoeffizienten.}
\label{tab:Werte der Wärmeübergangs- und Wärmeleitzahlen}
\renewcommand{\arraystretch}{1.2}
\begin{tabular}{|l|l|l|}

\hline
Parameter        & Wert  & Einheit           \\ \hline
$\alpha_{L}$     & 292   & \unit{}{\watt\per(\squaremetre\kelvin)} \\
$\alpha_{KM}$    & 50000 & \unit{}{\watt\per(\squaremetre\kelvin)} \\
$\alpha_{KM,SH}$ & 29    & \unit{}{\watt\per(\squaremetre\kelvin)} \\
$\lambda_{Cu}$   & 380   & \unit{}{\watt\per(\metre\kelvin)}   \\
$\lambda_{Al}$   & 220   & \unit{}{\watt\per(\metre\kelvin)}   \\ \hline
\end{tabular}
\end{table}

Die Simulation liefert Ergebnisse für die in Abbildung~\ref{fig:Verschaltungsarten} dargestellten Verschaltungen. Ein Vergleich der Simulationsergebnisse mit den Untersuchungsergebnissen von Verschaltung~V2 bei \unit{0}{\%} relativer Luftfeuchtigkeit ermöglicht die Validierung des Modells. Dafür muss zunächst die Verschaltung des Verdampfers verändert werden. Eine komplette Demontage des Kühlmöbels wie zuvor beim Tausch des Verdampfers ist dabei nicht nötig. Es genügt eine Demontage der rechten Seite des Kühlmöbels und beider Seitentrennwände um an den Seiten des Verdampfers arbeiten zu können. Zunächst wird das Kältemittel entsorgt. Die Einspritzleitung wird an die Stelle des zuvorigen Endes des vierten Verdampferrohres gesetzt und zwischen dem ersten und fünften Verdampferrohr eine neue Verbindung hergestellt. Im Anschluss werden die Temperaturfühler entsprechend neu positioniert. Bevor eine erneute Untersuchung durchgeführt werden kann wird eine Dichtheits- und eine Druckfestigkeitsprüfung an den drei Kältekreisen durchgeführt. Beim bisherigen Sollwert von \unit{8}{\kelvin} öffnet das Ventil komplett, sodass eine Regelung der Überhitzung nicht möglich ist. Deshalb wird für die weiteren Untersuchungen am neuen Verdampfer der Sollwert der Überhitzung an den drei Expansionsventilen auf \unit{13}{\kelvin} geändert. \newline 
Im Folgenden werden die Ergebnisse der Simulation mit denen der Untersuchungen bei \unit{0}{\%} relativer Feuchtigkeit verglichen. Tabelle~\ref{tab:VergleichSimuUntersuchung} zeigt die Messwerte der Untersuchungen von Verschaltung~V2 und V3 und die Simulationsergebnisse beider Verschaltungen. Dabei beziehen sich die Messwerte exemplarisch auf Kältekreis~1. 
Im Vergleich der Untersuchung von Verschaltung~V2 mit deren Simulationsergebnissen fällt auf, dass der errechnete Druckabfall um \unit{0.2}{\bbar} geringer ist als der tatsächlich erzielte. Die erzielte Verdampfungstemperatur ist dementsprechend höher.
Kältemittelmassenstrom und Einlasstemperatur der Luft sind konstant, da dies die Eingangsgrößen des Modells sind. Die errechnete Auslasstemperatur ist um etwa \unit{0.5}{\kelvin} höher als die tatsächliche. Die errechnete Kälteleistung weicht mit etwa \unit{30}{\watt} sehr gering von der tatsächlichen ab.  \newline Werden die Simulationsergebnisse beider Verschaltungen miteinander verglichen, so ist ein geringer Anstieg des Druckabfalls um etwa \unit{0.03}{\bbar} zu erkennen. Dies hat eine Reduzierung der Verdampfungstemperatur um \unit{0.25}{\kelvin} zur Folge. Die Kälteeistung ist um \unit{19}{\watt} höher. Dies spiegelt sich in einer sehr geringen Absenkung der Luftauslasstemperatur um \unit{0.15}{\kelvin} wider. Diese Änderungen sind zwar gering, belegen aber tendenziell die These, dass eine Änderung der Verschaltung eine Erhöhung der Kälteleistung erzielt. \newline
Zuletzt wird der Effekt der Verschaltungsänderung im Modell mit dem in der Untersuchung erzieltem Effekt verglichen. Dies ermöglicht eine Beurteilung der Modelltauglichkeit. Der tatsächliche Druckabfall erfährt eine Erhöhung um etwa \unit{0.06}{\bbar}. Das ist doppelt so viel wie die berechnete Änderung. Dies resultiert in einer stärkeren Absenkung der Verdampfungstemperatur um etwa \unit{1.4}{\kelvin}. Während die Einlasstemperatur der Luft bei Verschaltung~V3 um etwa \unit{0.5}{\kelvin} höher ist, weicht die Auslasstemperatur der Luft vernachlässigbar gering nach unten ab. Mittels des Modells wird eine Erhöhung der Temperaturdifferenzen zwischen Ein- und Austritt um \unit{0.15}{\kelvin} vorausgesagt. Die Untersuchungen zeigen eine Erhöhung der Temperaturdifferenz um \unit{0.71}{\kelvin}. Die Messwerte der Untersuchungen belegen damit die Tendenz des Modells. Es ist zu untersuchen, warum der errechnete Druckabfall nur etwa halb so groß wie der tatsächliche ist. \newline

\begin{table}[h]
\centering
\caption{Vergleich der Simulation mit den Untersuchungen.}
\label{tab:VergleichSimuUntersuchung}
\begin{tabular}{|ccccc|}
\hline
                                                      & Untersuchung V2             & Modell V2                   & Modell V3                   & Untersuchung V3 \\ \hline
\multicolumn{1}{|c|}{Druckabfall {[}Pa{]}}            & \multicolumn{1}{c|}{47192}  & \multicolumn{1}{c|}{27175}  & \multicolumn{1}{c|}{29889}  & 52996           \\
\multicolumn{1}{|c|}{Kälteleistung {[}W{]}}           & \multicolumn{1}{c|}{1791}   & \multicolumn{1}{c|}{1812}   & \multicolumn{1}{c|}{1831}   & 1827            \\
\multicolumn{1}{|c|}{Verdampfungstemperatur {[}°C{]}} & \multicolumn{1}{c|}{-14.15} & \multicolumn{1}{c|}{-12.23} & \multicolumn{1}{c|}{-12.48} & -15.59          \\
\multicolumn{1}{|c|}{Massenstrom KM {[}g/s{]}}        & \multicolumn{1}{c|}{6.11}   & \multicolumn{1}{c|}{6.11}   & \multicolumn{1}{c|}{6.11}   & 5.72            \\
\multicolumn{1}{|c|}{Einlasstemperatur Luft {[}°C{]}} & \multicolumn{1}{c|}{4.42}   & \multicolumn{1}{c|}{4.42}   & \multicolumn{1}{c|}{4.42}   & 5.07            \\
\multicolumn{1}{|c|}{Auslasstemperatur Luft {[}°C{]}} & \multicolumn{1}{c|}{-5.38}  & \multicolumn{1}{c|}{-4.8}   & \multicolumn{1}{c|}{-4.95}  & -5.44           \\
\hline
\end{tabular}
\end{table}

Die Abbildungen~\ref{fig:SimTempV1} und \ref{fig:SimTempV2} zeigen die Temperaturprofile der Luft und des Kältemittels über jeden berechneten Verdampferdurchgang in Verschaltung V2 bzw. V3. Auf der x-Achse sind die Verdampferpässe auf die Höhe des Verdampfers bezogen aufgetragen, auf der y-Achse die Temperatur in °$C$. Der Effekt der Verschaltungsänderung auf das Temperaturprofil des Kältemittels ist gut zu erkennen. Statt zunächst Abzusinken steigt die Verdampfungstemperatur an. Dadurch wird am Luftaustritt des Verdampfers eine tiefere Temperatur erzielt. Die erzielte Änderung ist jedoch grafisch kaum sichtbar. Im vierten Verdampferdurchgang beginnt das Kältemittel zu überhitzen. Der Anstieg ist zunächst steiler als im fünften und sechsten Verdampferpass. In Verschaltung V3 überhitzt das Kältemittel auf eine höhere Temperatur als in V2. Es ist zu untersuchen, warum das Modell eine stärkere Überhitzung des Kältemittels vorraussagt. \newline
Im Folgenden werden die Messwerte und Berechnungsergebnisse der Untersuchungen mit den Verschaltungen V2 und V3 bei einem Sollwert von \unit{0}{\%} r.F. in der Kammer miteinander verglichen. In Tabelle~\ref{tab:VergleichV2V3_0rF} werden diese dargestellt. Während die elektrische Leistung nach Änderung der Verschaltung eine geringe Reduktion um \unit{16}{\watt} verzeichnet, erfährt die thermische Leistung des Verdampfers eine Erhöhung um circa \unit{140}{\watt} und die des Kondensators um \unit{50}{\watt}. Dies resultiert in einer Erhöhung des EERs um \unit{4}{\%} von \unit{1.99}{} auf \unit{2.07}{}.
Die Verdampfungstemperaturen in allen Kältekreisen erfahren eine Absenkung um circa \unit{1.5}{\kelvin}. Gegenüber den Untersuchungen bei \unit{60}{\%} r.F. sind diese sehr niedrig. Die Kondensationstemperaturen bleiben unbeeinflusst. Die Änderung der gemessenen Überhitzungen ist vernachlässigbar gering. Nur in Kreis 3 ist diese um etwa \unit{1}{\kelvin} höher. Auffällig ist, dass in der neuen Verschaltung der Dampfanteil in den drei Kreisen \unit{0}{\%} beträgt und damit eine Unterkühlung von etwa \unit{3}{\kelvin} bis \unit{4}{\kelvin} erzielt wird. Die Massenströme erfahren eine Reduktion um etwa \unit{0.5}{\gram\per\second}. Der Druckabfall verzeichnet in Kreis~1 einen Anstieg um \unit{0.05}{\bbar} und in Kreis~2 einen sehr geringen Anstieg um \unit{0.01}{\bbar}. In Kreis~3 verzeichnet der Druckabfall hingegen eine Reduktion um \unit{0.01}{\bbar}. Die Produkt- und Lufttemperaturen lassen erkennen, dass diese wie die Verdampfungstemperatur sehr niedrig sind. Gegenüber Verschaltung~V2 ist bei V3 keine Änderung ersichtlich. Nur die maximale Produkttemperatur ist um \unit{1}{\kelvin} höher. Damit einher geht eine Erhöhung der Durchschnittstemperatur um etwa \unit{0.6}{\kelvin}. Es ist zu untersuchen, warum die Temperaturen derart niedrig sind und ob die erfassten Messwerte die Berechnungen des Modells bestätigen.

\begin{figure}[h!]
\centering

\caption{Simuliertes Temperaturprofil des Verdampfers für Verschaltung V2.}
\label{fig:SimTempV1}
\end{figure}

\begin{figure}[h!]
\centering

\caption{Simuliertes Temperaturprofil des Verdampfers für Verschaltung V3.}
\label{fig:SimTempV2}
\end{figure}
\subsection{Vergleich der Verschaltungen V2 und V3}
\label{subsec:Vergleich der Verschaltungen V2 und V3}

In diesem Abschnitt werden die Untersuchungsergebnisse der Verschaltungen V2 und V3 unter den normalen Prüfbedingungen bei \unit{60}{\%} relativer Luftfeuchtigkeit miteinander verglichen. Der Umbau ist bereits erfolgt. Es ist lediglich eine erneute Untersuchung bei vorherigen Bedingungen erforderlich. Der Sollwert der Überhitzung beträgt \unit{13}{\kelvin}. \newline
Tabelle~\ref{tab:VergleichV2V3_60rF} stellt die Messwerte und Berechnungsergebnisse der Untersuchungen mit den Verschaltungen~V2 und V3 bei einem Sollwert von \unit{60}{\%} r.F. in der Kammer dar. Die elektrische Leistung erfährt eine Reduktion um \unit{16}{\watt}, die thermische Leistung des Verdampfers hingegen erfährt einen Anstieg um \unit{140}{\watt} und die des Kondensators um etwa \unit{100}{\watt}. Dies resultiert in einem Anstieg des EERs um \unit{3}{\%} von \unit{2.21}{} auf \unit{2.28}{}.
Die Verdampfungstemperatur in den drei Kältekreisen ist um etwa \unit{1.5}{\kelvin} geringer. Die Kondensationstemperatur sowie die erfasste Überhitzung sind unverändert.
Während in Verschaltung~V2 keine Unterkühlung erzielt wird und die Dampfanteile zwischen \unit{4}{\%} und \unit{19}{\%} liegen, werden diese in der neuen Verschaltung auf \unit{0}{\%} reduziert. Dadurch wird zwar Unterkühlung erzielt, diese ist jedoch mit etwa \unit{0.2}{\kelvin} sehr gering. Der Massenstrom des Kältemittels erfährt eine Reduktion um \unit{0.5}{\gram\per\second}. Der Druckabfall steigt in Kreis~1 um etwa \unit{0.06}{\bbar}, in den Kreisen~2 und 3 um \unit{0.01}{\bbar} bis \unit{0.02}{\bbar} an. Der Vergleich der Produkttemperaturen zeigt eine Reduktion der maximalen Temperatur um \unit{0.5}{\kelvin} und der minimalen Temperatur um \unit{1.5}{\kelvin}. Dies resultiert in einer um \unit{0.5}{\kelvin} geringeren Durchschnittstemperatur.
Während die Einlasstemperatur der Luft nahezu konstant ist verzeichnet die Auslasstemperatur eine Reduktion um etwa \unit{0.8}{\kelvin}.
Es ist zu untersuchen, ob sich das System hinsichtlich dieser Werte ähnlich verhält wie in Untersuchung bei \unit{0}{\%} r.F.. Daraus kann abgeleitet werden ob die Vorhersagen des Modells auch für den Betrieb bei Normbedingungen gültig sind.

%%%%%%%%%%%%%%%%%%%%%%%%%%%%%%%%%%%%%%%%%%%%%%%%%%%%%%

\chapter{Analyse der Messergebnisse}
\label{cha:Analyse der Messergebnisse}

\section{Einstellung von Normbedingungen}
\label{sec:Einstellung von Normbedingungen_1}

In diesem Abschnitt werden die Ergebnisse aus Abschnitt~\ref{sec:EinstellungvonNormbedingungen} erläutert und die daraus abgeleiteten Konsequenzen erklärt. Anhand der Abbildungen~\ref{fig:10pctOC} - \ref{fig:30pctCC} lässt sich erkennen, dass die Geschwindigkeiten beim Betrieb mit fünf Lüftern mit je \unit{10}{\%} ihrer Leistung näher an der geforderten Normgeschwindigkeit liegen als beim Betrieb mit zwei Lüftern bei \unit{30}{\%} Leistung. Hierbei ist ein höherer Turbolenzgrad aufgrund der größeren Schwankung der Messwerte ersichtlich. Ein höherer Turbolenzgrad hat einen höheren Durchmischungsgrad der Raumluft mit der kalten Luft des Luftschleiers zur Folge. 
Werden diese Erkenntnisse den Ergebnissen der Untersuchungen mit einer geschlossenen Decke gegenübergestellt, so ist zu erkennen, dass das Schließen der Decke eine Minderung des Turbolenzgrades zur Folge hat. \
Der beim Vergleich der Abbildungen~\ref{fig:10pctOC_temp} und \ref{fig:30pctOC_temp} ersichtliche höhere Temperaturgradient bei niedrigerer Lüfterleistung ist ebenfalls auf den höheren Turbolenzgrad zurückzuführen. \
Aufgrund der relativ geringen Luftgeschwindigkeit ist die Auftriebskraft sehr einflussreich auf das Strömungsbild. Die warme Luft steigt bei Eintritt in den Raum langsam an die Decke und zieht sich dort entlang bis zur Öffnung in der Decke bzw. bis sie gezwungen ist in den weiter unten liegenden Luftauslass von Kammer A zu strömen.
Letzteres hat, wie aus Abbildung ~\ref{fig:Klimakammer_geschlosseneDecke} ersichtlich eine gleichmäßigere und über die Länge des Kühlmöbels konstante Strömung zur Folge.
Jedoch führt diese vermeintlich bessere Maßnahme zu großen Unregelmäßigkeiten in der Regelung der Durchschnittstemperatur und der relativen Luftfeuchtigkeit der Klimakammer. \newline
Aufgrund dessen und aus Gründen der Vergleichbarkeit mit vorherigen Untersuchungen wurde entschieden, dass die Abdeckung der Öffnung in der Decke wieder entfernt wird. Wegen des geringeren Temperaturgradienten wurde für alle weiteren Untersuchungen der Betrieb mit zwei Lüftern bei je \unit{30}{\%} ihrer Leistung festgelegt.

\section{Kältemittelöle}
\label{sec:Kältemittelöleanalyse}

In diesem Abschnitt wird der Einfluss der Kältemittelöle 3MAF und HATCOL~4467 auf das Systemverhalten analysiert.
Wie in Abschnitt~\ref{sec:EinflussÖl} beschrieben ist auffällig, dass die Sättigungstemperatur des Kältemittels im Kondensator unter der Eintrittstemperatur des Wassers liegt. Dies ist durch einen geringen Druck in der Flüssigkeitsleitung zu erklären. Der Hersteller der Kondensatoren gibt bei vollständiger Kondensation einen maximalen Druckabfall von \unit{0.0117}{\bbar} an \cite{SWEP.2017}. Ein sehr hoher Dampfanteil im Kondensator und in der Flüssigkeitsleitung sowie ein hoher Massenstrom verursachen, nach Gleichung~\ref{eq:14}, einen großen Druckabfall. Durch Absinken des Druckes sinkt die Sättigungstemperatur des Kältemittels und folglich die Differenz zwischen Eingangstemperatur des Wassers und Temperatur des Kältemittels. Dies führt dazu, dass am Kondensator keine Wärme mehr übertragen werden kann und das Kältemittel nicht in der Lage ist weiter zu kondensieren bzw. zu unterkühlen. Der geringere Druckabfall über den Verdampfer ist durch den geringeren Kältemittelmassenstrom zu erklären. Die Reduktion des Kältemittelmassenstroms ist auf eine Reduktion des Öffnungsgrades des Expansionsventiles zurückzuführen. Aufgrund des relativ hohen Dampfanteiles vor dessen Einlass und der verschiedenen Öleigenschaften ist zu erwarten, dass sich das Regelverhalten der Ventile in beiden Untersuchungen leicht voneinander unterscheidet. Dies wird durch die Messergebnisse bestätigt. \newline
Wie Tabelle~\ref{tab:LöslichkeitHC3M} zu entnehmen, ist die errechnete Löslichkeit des Kältemittels in Öl in den Wärmeübertragern höher als im Verdichter. In den Wärmeübertragern ist ein Teil des Kältemittels flüssig. Flüssiges Kältemittel hat eine höhere Dichte als gasförmiges Kältemittel und somit Einfluss auf die Löslichkeit. Im Verdichter strömt ausschließlich überhitztes Gas, weswegen die Löslichkeit dort sehr gering ist. \newline
Zudem ist zu erkennen, dass die Löslichkeit des Kältemittels in HATCOL~4467 in den Wärmeübertragern etwas geringer als die in 3MAF. Das Öl nimmt weniger Kältemittel auf, wodurch mehr Leistung zur Verfügung steht, da mehr Kältemittel sofort verdampfen kann. 3MAF besitzt mit der höheren Kältemittellöslichkeit hingegen bessere Ölrückführungseigenschaften. Der rechnerische Unterschied im Verdichter ist vernachlässigbar gering.
Der Versuch bestätigt die rechnerischen Vorhersagen. Ein Wechsel des Öles zu HATCOL~4467 führt zu einer Vergrößerung der Wärmeübertragerleistungen. Dies hat auch eine überproportionale Erhöhung der elektrischen Leistungsaufnahme zu Folge, was sich negativ auf den EER auswirkt.
Produkt- und lufttemperaturseitig ist nur ein geringer Effekt des Ölwechsels zu beobachten. Dieser liegt im Bereich der Messungenauigkeit und ist als vernachlässigbar zu deuten. Die wärmere Eintrittstemperatur ist wahrscheinlich auf Unregelmäßigkeiten in der Durchmischung mit dem warmen Luftstrom der Klimakammer zurückzuführen. Deswegen ist es schwierig das System anhand der erzielten Produkttemperaturen zu bewerten.
Die Annahme, dass der Öltransport im System nicht optimal ist wird durch das Spülen des Systems widerlegt. Dieses führt zu der Erkenntnis, dass sich bei ausgeschalteter Anlage kein zurückgebliebenes Öl in dieser befindet. Die Ölwurfrate des Verdichters ist der leistungsbeeinflussende Parameter. Ist diese gering, so ist die Reduktion der Nutzkälteleistung durch mitgeführtes Öl in den Wärmeübertragern ebenfalls gering. \newline
Mit alleinigem Hinblick auf die Verdampferleistung ist HATCOL~4467 vorzuziehen.
Da sich dies negativ auf den EER auswirkt und produkttemperaturseitig kein Einfluss zu erkennen ist lohnt sich der Betrieb mit 3MAF.

\clearpage

\section{Abtauintervalle}
\label{sec:AbtauintervalleAnalyse}

In diesem Abschnitt wird der Einfluss der Länge der Abtauintervalle auf das Systemverhalten auf Basis der in Abschnitt~\ref{sec:Abtauintervalle} beschriebenen Untersuchungsergebnisse analysiert. \newline
Zunächst ist zu untersuchen, warum die Abtauung genau nach \unit{3}{\hour} eingeleitet wird. Zu diesem Zweck wird die Abtauregelung der Steuerungssoftware betrachtet. Diese ist schematisch in Abbildung~\ref{fig:bedarfsgerechteAbtauung} dargestellt \cite{EmersonClimateTechnologies.2017}. Im unteren Diagramm ist auf der x-Achse die Zeit und auf der y-Achse die Temperaturdifferenz über den Verdampfer aufgetragen. Das Diagramm darüber zeigt diskrete Ereignisse  der Regelung einer Bedarfsabtauung die in einem Kühlzyklus stattfinden.
Nach dem Ende einer Abtauung wird nach einer bestimmten Verzögerung die maximale und optimale Temperaturdifferenz des Verdampfers ermittelt. Sinkt die tatsächliche Temperaturdifferenz \unit{3}{\kelvin} unter die ermittelte maximale Temperaturdifferenz, so wird in einer ersten Stufe die Abtauung eingeleitet. Sinkt die Temperaturdifferenz unter einen vorgegebenen absoluten Grenzwert von \unit{0}{\kelvin}, so leitet die zweite Stufe der Regelung die Abtauung ein. Wird die Abtauung nicht in dem vorgegebenen Abtauintervall von \unit{3}{\hour} durch die erste oder zweite Stufe eingeleitet, so findet diese spätestens nach Ablauf der Zeit statt. Offensichtlich wurde durch die Stufen~1 und 2 der Bedarfsabtauung keine Abtauung eingeleitet. 

\begin{figure}[h!]
\centering

\caption{Auslösestufen der bedarfsgerechten Abtauung.}
\label{fig:bedarfsgerechteAbtauung}
\end{figure}

Im Folgenden wird die Temperaturdifferenz der Luft über den Verdampfer genauer betrachtet um Rückschlüsse auf das Regelverhalten der Steuerungssoftware ziehen zu können. Diese ist über einen Kühlzyklus in Abbildung~\ref{fig:deltaTLuftevap51} dargestellt. Auf der x-Achse ist die Zeit in $h$ und auf der y-Achse die Temperaturdifferenz in $K$ aufgetragen. Es ist zu erkennen, dass diese entgegen der Erwartungen mit fortschreitender Zeit ansteigt. Da die Temperaturdifferenz nicht sinkt kann auch kein eingestellter Grenzwert unterschritten werden. Infolgedessen findet keine Einleitung der Abtauung durch die ersten beiden Stufen der Regelung statt. 

\begin{figure}[h!]
\centering

\caption{Temperaturdifferenz der Luft am Verdampfer bei einem 3h Abtauintervall.}
\label{fig:deltaTLuftevap51}
\end{figure}

Die Regelung der bedarfsgerechten Abtauung basiert auf der Annahme, dass die Temperaturdifferenz der Luft kleiner wird. Dies hat den folgenden Grund:
Während eines Kühlzyklus sammelt sich aufgrund der unter dem Tau- und Gefrierpunkt liegenden Temperatur der Verdampferoberfläche und der hohen relativen Luftfeuchtigkeit Kondensat, welches daraufhin gefriert. Wegen der stetig dicker werdenden Eisschicht entsteht ein zusätzlicher Wärmeleitwiderstand. Dieser verkleinert den Wärmedurchgangskoeffizienten $k$ entsprechend Gleichung~\ref{eq:UA}. Dies hat gemäß Gleichung~\ref{eq:4} eine Reduzierung der übertragenen Wärme zur Folge. Die Temperaturdifferenz wird kleiner, da die Austrittstemperatur der Luft infolgedessen höher ist. \newline
Abbildung~\ref{fig:deltaTLuftevap50} zeigt die Temperaturdifferenz der Luft bei der Vergleichsuntersuchung mit einem \unit{4}{\hour} Abtauintervall. Es ist zu erkennen, dass wie bei der nachfolgenden Untersuchung die Temperaturdifferenz zunächst ansteigt. Jedoch beginnt diese bei circa \unit{3.7}{\hour} rapide abzusinken. Zu diesem Zeitpunkt ist der Effekt der Eisbildung detektierbar und eine Einleitung der Abtauung durch die ersten beiden Stufen möglich. Dies wird jedoch durch das kurze Abtauintervall und durch die zunächst ansteigende Temperaturdifferenz verhindert. \newline 
Eine Untersuchung der Ein- und Austrittstemperaturen der Luft am Verdampfer lässt Rückschlüsse auf das Verhalten der Temperaturdifferenz zu.
Abbildung~\ref{fig:TLuftevap51} stellt diese zeitlich über das \unit{3}{\hour} Abtauintervall der Untersuchung der bedarfsgerechten Abtauung dar.
Es ist zu erkennen, dass die Austrittstemperatur der Luft nach Beginn des Kühlzyklus  langsam von circa \unit{2}{\celsius} auf bis zu \unit{-1}{\celsius} absinkt. Nach etwa \unit{2.5}{\hour} sinkt die Temperatur schneller ab. Währenddessen bleibt die Eintrittstemperatur in den Verdampfer mit etwa \unit{8}{\celsius} bis \unit{9}{\celsius} nahezu konstant. Tendenziell ist eine geringe Erhöhung der Temperatur zu erkennen. Das Absinken der Austrittstemperatur der Luft ist direkt abhängig von deren Eintrittstemperatur sowie der Verdampfungstemperatur des Kältemittels.

\begin{figure}[h]
\centering

\caption{Temperaturdifferenz der Luft am Verdampfer bei einem 4h Abtauintervall.}
\label{fig:deltaTLuftevap50}
\end{figure}

\begin{figure}[h]
\centering

\caption{Auslösung der Abtauung mit gegenwärtigem Detektionsalgorithmus.}
\label{fig:deltaTLuftevap50bad}
\end{figure}

\begin{figure}[h]
\centering

\caption{Auslösung der Abtauung mit verbessertem Detektionsalgorithmus.}
\label{fig:deltaTLuftevap50good}
\end{figure}

In Abbildung~\ref{fig:Tevap51} ist die Verdampfungstemperatur des Kältemittels für alle drei Kältekreise zeitlich dargestellt. Nach Beginn des Kühlzyklus betragen die Verdampfungstemperaturen etwa \unit{-6}{\celsius} und fallen stetig bis auf \unit{-10}{\celsius}. Nach etwa \unit{2.5}{\hour} sinken die Temperaturen schneller ab. Aus dem Vergleich der Abbildungen~\ref{fig:TLuftevap51} und \ref{fig:Tevap51} lässt sich schließen, dass aufgrund der Ähnlichkeit beider Temperaturgraphen die Austrittstemperatur der Luft proportional von der Verdampfungstemperatur abhängig ist.\newline Es ist zu erwarten, dass sich die Eintrittstemperatur der Luft proportional zu deren Austrittstemperatur verhält. Diese Annahme wird durch die tendenziell steigende Eintrittstemperatur widerlegt. Es ist zu vermuten, dass durch die sinkende Austrittstemperatur der Luft am Auslassgitter des Kühlmöbels, infolge einer Veränderung des Wärmeübergangs durch Konvektion, die Induktionsrate der warmen Kammerluft erhöht wird. Bei sinkender Austrittstemperatur vermischt sich die Luft des Schleiers mit einer größeren Menge der Kammerluft, wodurch die Luft des Kühlmöbels stärker erhitzt wird.
Dieser Effekt ist eine mögliche Erklärung für die steigende Temperaturdifferenz der Luft.

\begin{figure}[h!]
\centering

\caption{Ein- und Austrittstemperaturen der Luft am Verdampfer bei einem 3h Abtauintervall.}
\label{fig:TLuftevap51}
\end{figure}

\begin{figure}[h!]
\centering

\caption{Verdampfungstemperaturen der drei Kältekreise bei einem 3h Abtauintervall.}
\label{fig:Tevap51}
\end{figure}

\begin{figure}[h!]
\centering

\caption{Verdampfungstemperaturen der drei Kältekreise bei einem 4h Abtauintervall.}
\label{fig:SinkenVerdampfung4h3h}
\end{figure}

\begin{figure}[h!]
\centering
%\def\svgwidth{120mm}
%\input{Pictures/50powerloss1.pdf_tex}

\caption{Elektrische und thermische Leistungen bei einem 4h Abtauintervall.}
\label{fig:Leistungsverlust4h3h}
\end{figure}

Die Ergebnisse aus Abschnitt~\ref{sec:Abtauintervalle} zeigen eine Effizienzsteigerung durch eine Verkürzung des Abtauintervalls auf \unit{3}{\hour}. Um diesen Effekt zu untersuchen werden die Verdampfungstemperaturen und die Leistungen grafisch betrachtet.
In Abbildung~\ref{fig:SinkenVerdampfung4h3h} sind die Verdampfungstemperaturen der Untersuchung des \unit{4}{\hour} Abtauintervalls zeitlich über einen Kühlzyklus dargestellt. Von Beginn des Zyklus bis zu einem Zeitpunkt von etwa \unit{2}{\hour} bleiben die Temperaturen mit circa \unit{-7}{\celsius} konstant. Anschließend beginnen die Temperaturen zu fallen. Ab \unit{3}{\hour} sinken die Temperaturen sehr stark auf bis zu \unit{-18}{\celsius}.
Abbildung~\ref{fig:Leistungsverlust4h3h} stellt die elektrische Leistungsaufnahme der Verdichter und die thermischen Leistungen der Wärmeübertrager desselben Zyklus zeitlich dar. Während die elektrische Leistungsaufnahme konstant bleibt sinken die thermischen Leistungen wie die Verdampfungstemperatur ab einem Zeitpunkt von \unit{3}{\hour} stark ab. In beiden Diagrammen ist die Reduktion der jeweiligen Werte im Bereich zwischen \unit{3}{\hour} und \unit{4}{\hour} rot gekennzeichnet. \newline
Da diese Betrachtung unabhängig von der Temperatur der Eintrittsluft ist kann der Effekt der Eisbildung früher als bei einer Betrachtung der Temperaturdifferenz detektiert werden. Eine Verkürzung des Abtauintervalls verhindert ein starkes Absinken der thermischen Leistungen und der Verdampfungstemperaturen. Da die Werte in Tabelle~\ref{tab:Vergleich4h3h} über die letzten \unit{75}{\%} eines Zyklus gemittelt sind, sind die des \unit{4}{\hour} Abtauintervalls entsprechend geringer.

Durch die Änderung des Abtauintervalls von \unit{4}{\hour} auf \unit{3}{\hour} wird der EER um \unit{5.6}{\%} von \unit{2.14}{} auf \unit{2.26}{} erhöht.

\section{Abtauintervalle2}
\label{sec:AbtauintervalleAnalyse2}

In diesem Abschnitt wird der Einfluss der Länge der Abtauintervalle auf das Systemverhalten auf Basis der in Abschnitt~\ref{sec:Abtauintervalle} beschriebenen Untersuchungsergebnisse analysiert. \newline
Zunächst ist zu untersuchen, warum die Abtauung genau nach \unit{3}{\hour} eingeleitet wird. Zu diesem Zweck wird die Abtauregelung der Steuerungssoftware betrachtet. Diese ist schematisch in Abbildung~\ref{fig:bedarfsgerechteAbtauung} dargestellt \cite{EmersonClimateTechnologies.2017}. Im unteren Diagramm ist auf der x-Achse die Zeit und auf der y-Achse die Temperaturdifferenz über den Verdampfer aufgetragen. Das Diagramm darüber zeigt diskrete Ereignisse  der Regelung einer Bedarfsabtauung die in einem Kühlzyklus stattfinden.
Nach dem Ende einer Abtauung wird nach einer bestimmten Verzögerung die maximale und optimale Temperaturdifferenz des Verdampfers ermittelt. Sinkt die tatsächliche Temperaturdifferenz \unit{3}{\kelvin} unter die ermittelte maximale Temperaturdifferenz, so wird in einer ersten Stufe die Abtauung eingeleitet. Sinkt die Temperaturdifferenz unter einen vorgegebenen absoluten Grenzwert von \unit{0}{\kelvin}, so leitet die zweite Stufe der Regelung die Abtauung ein. Wird die Abtauung nicht in dem vorgegebenen Abtauintervall von \unit{3}{\hour} durch die erste oder zweite Stufe eingeleitet, so findet diese spätestens nach Ablauf der Zeit statt. Offensichtlich wurde durch die Stufen~1 und 2 der Bedarfsabtauung keine Abtauung eingeleitet. 

\begin{figure}[h!]
\centering

\caption{Auslösestufen der bedarfsgerechten Abtauung.}
\label{fig:bedarfsgerechteAbtauung}
\end{figure}

Im Folgenden wird die Temperaturdifferenz der Luft über den Verdampfer genauer betrachtet um Rückschlüsse auf das Regelverhalten der Steuerungssoftware ziehen zu können. Diese ist über einen Kühlzyklus in Abbildung~\ref{fig:deltaTLuftevap51} dargestellt. Auf der x-Achse ist die Zeit in $h$ und auf der y-Achse die Temperaturdifferenz in $K$ aufgetragen. Es ist zu erkennen, dass diese entgegen der Erwartungen mit fortschreitender Zeit ansteigt. Da die Temperaturdifferenz nicht sinkt kann auch kein eingestellter Grenzwert unterschritten werden. Infolgedessen findet keine Einleitung der Abtauung durch die ersten beiden Stufen der Regelung statt. 

\begin{figure}[h!]
\centering

\caption{Temperaturdifferenz der Luft am Verdampfer bei einem 3h Abtauintervall.}
\label{fig:deltaTLuftevap51}
\end{figure}

Die Regelung der bedarfsgerechten Abtauung basiert auf der Annahme, dass die Temperaturdifferenz der Luft kleiner wird. Dies hat den folgenden Grund:
Während eines Kühlzyklus sammelt sich aufgrund der unter dem Tau- und Gefrierpunkt liegenden Temperatur der Verdampferoberfläche und der hohen relativen Luftfeuchtigkeit Kondensat, welches daraufhin gefriert. Wegen der stetig dicker werdenden Eisschicht entsteht ein zusätzlicher Wärmeleitwiderstand. Dieser verkleinert den Wärmedurchgangskoeffizienten $k$ entsprechend Gleichung~\ref{eq:UA}. Dies hat gemäß Gleichung~\ref{eq:4} eine Reduzierung der übertragenen Wärme zur Folge. Die Temperaturdifferenz wird kleiner, da die Austrittstemperatur der Luft infolgedessen höher ist. \newline
Abbildung~\ref{fig:deltaTLuftevap50} zeigt die Temperaturdifferenz der Luft bei der Vergleichsuntersuchung mit einem \unit{4}{\hour} Abtauintervall. Es ist zu erkennen, dass wie bei der nachfolgenden Untersuchung die Temperaturdifferenz zunächst ansteigt. Jedoch beginnt diese bei circa \unit{3.7}{\hour} rapide abzusinken. Zu diesem Zeitpunkt ist der Effekt der Eisbildung detektierbar und eine Einleitung der Abtauung durch die ersten beiden Stufen möglich. Dies wird jedoch durch das kurze Abtauintervall und durch die zunächst ansteigende Temperaturdifferenz verhindert. \newline 
Eine Untersuchung der Ein- und Austrittstemperaturen der Luft am Verdampfer lässt Rückschlüsse auf das Verhalten der Temperaturdifferenz zu.
Abbildung~\ref{fig:TLuftevap51} stellt diese zeitlich über das \unit{3}{\hour} Abtauintervall der Untersuchung der bedarfsgerechten Abtauung dar.
Es ist zu erkennen, dass die Austrittstemperatur der Luft nach Beginn des Kühlzyklus  langsam von circa \unit{2}{\celsius} auf bis zu \unit{-1}{\celsius} absinkt. Nach etwa \unit{2.5}{\hour} sinkt die Temperatur schneller ab. Währenddessen bleibt die Eintrittstemperatur in den Verdampfer mit etwa \unit{8}{\celsius} bis \unit{9}{\celsius} nahezu konstant. Tendenziell ist eine geringe Erhöhung der Temperatur zu erkennen. Das Absinken der Austrittstemperatur der Luft ist direkt abhängig von deren Eintrittstemperatur sowie der Verdampfungstemperatur des Kältemittels.

\begin{figure}[h]
\centering

\caption{Temperaturdifferenz der Luft am Verdampfer bei einem 4h Abtauintervall.}
\label{fig:deltaTLuftevap50}
\end{figure}

\begin{figure}[h]
\centering

\caption{Auslösung der Abtauung mit gegenwärtigem Detektionsalgorithmus.}
\label{fig:deltaTLuftevap50bad}
\end{figure}

\begin{figure}[h]
\centering

\caption{Auslösung der Abtauung mit verbessertem Detektionsalgorithmus.}
\label{fig:deltaTLuftevap50good}
\end{figure}

In Abbildung~\ref{fig:Tevap51} ist die Verdampfungstemperatur des Kältemittels für alle drei Kältekreise zeitlich dargestellt. Nach Beginn des Kühlzyklus betragen die Verdampfungstemperaturen etwa \unit{-6}{\celsius} und fallen stetig bis auf \unit{-10}{\celsius}. Nach etwa \unit{2.5}{\hour} sinken die Temperaturen schneller ab. Aus dem Vergleich der Abbildungen~\ref{fig:TLuftevap51} und \ref{fig:Tevap51} lässt sich schließen, dass aufgrund der Ähnlichkeit beider Temperaturgraphen die Austrittstemperatur der Luft proportional von der Verdampfungstemperatur abhängig ist.\newline Es ist zu erwarten, dass sich die Eintrittstemperatur der Luft proportional zu deren Austrittstemperatur verhält. Diese Annahme wird durch die tendenziell steigende Eintrittstemperatur widerlegt. Es ist zu vermuten, dass durch die sinkende Austrittstemperatur der Luft am Auslassgitter des Kühlmöbels, infolge einer Veränderung des Wärmeübergangs durch Konvektion, die Induktionsrate der warmen Kammerluft erhöht wird. Bei sinkender Austrittstemperatur vermischt sich die Luft des Schleiers mit einer größeren Menge der Kammerluft, wodurch die Luft des Kühlmöbels stärker erhitzt wird.
Dieser Effekt ist eine mögliche Erklärung für die steigende Temperaturdifferenz der Luft.

\begin{figure}[h!]
\centering

\caption{Ein- und Austrittstemperaturen der Luft am Verdampfer bei einem 3h Abtauintervall.}
\label{fig:TLuftevap51}
\end{figure}

\begin{figure}[h!]
\centering

\caption{Verdampfungstemperaturen der drei Kältekreise bei einem 3h Abtauintervall.}
\label{fig:Tevap51}
\end{figure}

\begin{figure}[h!]
\centering

\caption{Verdampfungstemperaturen der drei Kältekreise bei einem 4h Abtauintervall.}
\label{fig:SinkenVerdampfung4h3h}
\end{figure}

\begin{figure}[h!]
\centering
%\def\svgwidth{120mm}
%\input{Pictures/50powerloss1.pdf_tex}

\caption{Elektrische und thermische Leistungen bei einem 4h Abtauintervall.}
\label{fig:Leistungsverlust4h3h}
\end{figure}

Die Ergebnisse aus Abschnitt~\ref{sec:Abtauintervalle} zeigen eine Effizienzsteigerung durch eine Verkürzung des Abtauintervalls auf \unit{3}{\hour}. Um diesen Effekt zu untersuchen werden die Verdampfungstemperaturen und die Leistungen grafisch betrachtet.
In Abbildung~\ref{fig:SinkenVerdampfung4h3h} sind die Verdampfungstemperaturen der Untersuchung des \unit{4}{\hour} Abtauintervalls zeitlich über einen Kühlzyklus dargestellt. Von Beginn des Zyklus bis zu einem Zeitpunkt von etwa \unit{2}{\hour} bleiben die Temperaturen mit circa \unit{-7}{\celsius} konstant. Anschließend beginnen die Temperaturen zu fallen. Ab \unit{3}{\hour} sinken die Temperaturen sehr stark auf bis zu \unit{-18}{\celsius}.
Abbildung~\ref{fig:Leistungsverlust4h3h} stellt die elektrische Leistungsaufnahme der Verdichter und die thermischen Leistungen der Wärmeübertrager desselben Zyklus zeitlich dar. Während die elektrische Leistungsaufnahme konstant bleibt sinken die thermischen Leistungen wie die Verdampfungstemperatur ab einem Zeitpunkt von \unit{3}{\hour} stark ab. In beiden Diagrammen ist die Reduktion der jeweiligen Werte im Bereich zwischen \unit{3}{\hour} und \unit{4}{\hour} rot gekennzeichnet. \newline
Da diese Betrachtung unabhängig von der Temperatur der Eintrittsluft ist kann der Effekt der Eisbildung früher als bei einer Betrachtung der Temperaturdifferenz detektiert werden. Eine Verkürzung des Abtauintervalls verhindert ein starkes Absinken der thermischen Leistungen und der Verdampfungstemperaturen. Da die Werte in Tabelle~\ref{tab:Vergleich4h3h} über die letzten \unit{75}{\%} eines Zyklus gemittelt sind, sind die des \unit{4}{\hour} Abtauintervalls entsprechend geringer.

Durch die Änderung des Abtauintervalls von \unit{4}{\hour} auf \unit{3}{\hour} wird der EER um \unit{5.6}{\%} von \unit{2.14}{} auf \unit{2.26}{} erhöht.

\section{Verdichter}
\label{sec:VerdichterAnalyse}

In diesem Abschnitt wird das Verhalten des Systems auf Basis der Ergebnisse aus Abschnitt~\ref{sec:Verdichter} analysiert und der Tausch der Verdichter bewertet. 
Aufgrund der erzielten höheren Verflüssigungsleistung und der daraus resultierenden größeren Enthalpiedifferenz erreicht das Kältemittel einen niedrigeren Dampfgehalt. Bei Drosselung durch das Expansionsventil bleibt die Enthalpie nahezu konstant. Der erzielte Flashgasanteil hinter dem Ventil ist folglich ebenfalls geringer. Dadurch wird ein Verdampfungsenthalpiegewinn erzielt, wie beim Vergleich der Diagramme~\ref{fig:logph51} und \ref{fig:logph54} erkennbar ist. Trotz eines niedrigeren Kältemittelmassenstroms wird an den Wärmeübertragern mehr Wärme übertragen. Bei Reduzierung des Massenstroms ist immer ein Anstieg der Enthalpiedifferenz zu beobachten. Gemäß Gleichung~\ref{eq:4} bleibt so die Leistung konstant. \newline
Nach Gleichung~\ref{eq:14} wird der Druckabfall über den Verdampfer gleichermaßen durch den Dampfanteil und den Kältemittelmassenstrom beeinflusst. Eine Reduktion beider Größen hat, wie in den Messwerten von Kreis 2 und 3 in Tabelle~\ref{tab:VergleichVerdichter} erkennbar, eine Reduktion des Druckabfalls über den Verdampfer zur Folge. Das in Abschnitt~\ref{subsec:Das Modell} beschriebene Modell zeigt, dass der Druckabfall auf einem höheren Druckniveau größer ist. Demnach ist der in Kreis~1 leicht erhöhte Druckabfall durch die geringe Änderung von Dampfanteil und Massenstrom bei gleichzeitig minimaler Erhöhung des Verdampfungsdrucks zu erklären. \newline
Die Abweichung des Systemverhaltens von den Herstellerdaten lässt sich dadurch erklären, dass diese bei einem Betriebspunkt mit \unit{0}{\kelvin} Unterkühlung gelten. Da keine Unterkühlung erzielt und ein hoher Dampfanteil vorhanden ist sind die Daten nicht vergleichbar. Die tendenzielle Änderung zu einem höheren Massenstrom bei geringerer elektrischer Leistungsaufnahme ist durch eine Änderung des Betriebspunkts im Verdichterkennfeld zu erklären. Bei einem typischen Verdichterkennfeld,ist das Druckverhältnis über dem Massenstrom aufgetragen. Eine Reduktion des Massenstromes bei ähnlichem Druckverhältnis sowie konstanter Drehzahl kann, je nach Betriebspunkt, eine Reduktion des isentropen Wirkungsgrads zur Folge haben \cite{Wilke.2005}. 
Dies kann zu einer Erhöhung der elektrischen Leistungsaufnahme und der Wärmeabgabe führen, wodurch die Verflüssigungsleistung erhöht wird. Diesem Verhalten liegt eine andere Leistungskurve des Kupfermotors gegenüber dem Aluminiummotor zugrunde. Die Herstellerdaten versprechen tendenziell eine Erhöhung der Verdichterkälteleistung. Ein Zusammenspiel dieser Effekte resultiert in dem gegenwärtigen Betriebspunkt.  \newline
Der Betrieb mit der Standardausführung des Scrollverdichters ZB09KAU-TFD wirkt sich unter den gegenwärtigen Prüfbedingungen sowohl leistungs- als auch leicht effizienzsteigernd aus. Gegenüber dem Hybridmodell wird kein eindeutiger EER-Gewinn erzielt.

\section{Änderung der Verdampferschaltung}
\label{sec:Änderung der Verdampferschaltung1}

In diesem Unterkapitel werden die Ergebnisse aus Abschnitt~\ref{sec:Änderung der Verdampferschaltung} analysiert und hinsichtlich deren Auffälligkeiten untersucht.

\subsection{Vergleich zwischen Verdampfern}
\label{subsec:Vergleich zwischen Verdampfern_1}

In diesem Abschnitt wird der Effekt des Umstiegs vom zweireihigen AHT-Verdampfer zum vierreihigen LIDL-Verdampfer auf das Systemverhalten untersucht. Es ist zu untersuchen warum die Leistung des Systems verringert wird und die Produkttemperaturen ansteigen. 
Mit Umstieg auf den LIDL-Verdampfer ist zunächst ein Anstieg der Überhitzung sowie eine Abweichung der von den Expansionsventilen erfassten Überhitzung von der messtechnisch erfassten Überhitzung auffällig. Durch das vierreihige Design wird eine bessere Umströmung der Verdampferrohre von der Luft erzielt, wodurch der Wärmeübertragungskoeffizient $\alpha_{L}$ erhöht wird. Dies resultiert in einer Erhöhung des $k$-Werts und damit, gemäß Gleichung~\ref{eq:4}, in einer Erhöhung des übertragenen Wärmestroms. Durch die bessere Wärmeübertragung steigt die Überhitzung an, worauf das Expansionsventil mit einer Erhöhung des Öffnungsgrades reagiert. Während des Betriebs mit dem neuen Verdampfer sind die Expansionsventile in den drei Kreisen vollständig geöffnet. Dies ist ersichtlich aus der starken Erhöhung des Kältemittelmassenstroms und aus der über dem Sollwert liegenden Überhitzung. Dies ist jedoch keine Erklärung für die beobachteten Abweichungen der erfassten Überhitzungen beim Betrieb mit dem neuen Verdampfer. Diese betragen etwa \unit{1}{\kelvin} bis \unit{2}{\kelvin}. Es ist möglich, dass durch die andere Wärmeübertragungs- sowie Strömungscharakteristik des neuen Verdampfers zu einem anderen Regelverhalten des Expansionsventil führt \cite{Winter.2012}. Eine weitere Erklärung könnte sein, dass die internen Berechnungen der Expansionsventile, denen Koeffizienten zugrunde liegen, dadurch fehlerhaft sind \cite{EmersonClimateTechnologies.2016}. Mit dem höheren Kältemittelmassenstrom geht ein Anstieg des Wassermassenstroms am Kondensator sowie eine Reduktion der Enthalpiedifferenz am Verflüssiger einher. Dies führt wiederum, durch den höheren Dampfanteil, zu einer Reduktion der Verdampferleistung. Zudem steigt mit dem Massenstrom der Druckabfall über den Verdampfer an. Die veränderte Wärmeübertragungscharakteristik hat einen höheren Verdampfungsdruck zur Folge, der mit einer höheren Verdampfungstemperatur einhergeht. Diese Effekte resultieren in einer höheren Luftauslasstemperatur und damit in einer höheren Durchschnittsprodukttemperatur. \newline
Aus dem Systemverhalten lässt sich somit schließen, dass die Füllmenge nicht ausreichend groß ist, um eine Überhitzungsregelung ermöglichen zu können. Eine höhere Füllmenge hätte ein höheres Druckniveau sowie eine damit verbundene höhere Verdampfungstemperatur zur Folge. Aufgrund der geringeren Temperaturdifferenz zur Luft würde weniger Wärme übertragen werden, wodurch die Überhitzung des Kältemittels sinken würde. Das Expansionsventil reagiert folglich mit einer Reduktion des Öffnungsgrads. Um in einen regelbaren Bereich der Überhitzung zu gelangen und ein stabiles Systemverhalten zu generieren wird der Sollwert der Überhitzung in nachfolgenden Untersuchungen auf \unit{13}{\kelvin} eingestellt. 

\subsection{Modellgestützter Vergleich der Verschaltungen V2 und V3}
\label{subsec:Modellgestützter Vergleich der Verschaltungen V2 und V3_1}

In diesem Abschnitt werden die Ergebnisse der Simulation sowie das Verhalten des Systems bei Änderung der Verschaltung der Verdampferrohre analysiert und hinsichtlich des Zieles der thermischen Leistungssteigerung bewertet.
Die Ursache für die im Vergleich viel tieferen Temperaturen ist die geringe relative Luftfeuchtigkeit.
Für die Validierung des Modells sind Untersuchungen bei \unit{0}{\%} r.F. in der Klimakammer notwendig. Tatsächlich erreichbar sind \unit{5}{\%} bis \unit{25}{\%} r.F.. Da bei diesen trotzdem sehr niedrigen Werten kaum Kälteleistung für die Kondensation des Wassers aus der Luft benötigt wird, ist mehr Kälteleistung zur sensiblen Wärmeaufnahme der Luft verfügbar. Dies resultiert in einer tieferen Luftauslasstemperatur. Durch die sinkenden Temperaturen sinken ebenfalls Verdampfungsdruck und Verdampfungstemperatur. Das Modell zeigt, dass der verursachte Druckabfall auf einem niedrigeren Druckniveau ebenfalls niedriger ist. \newline
Die Ergebnisse der Simulation zeigen eine große Abweichung des errechneten Druckabfalls  zu den erfassten Messdaten. Die Berechnungsmethode verspricht laut Quellen eine Genauigkeit von $\pm 30 \%$. Die Abweichung unter gegenwärtigen Bedingungen beträgt etwa \unit{42}{\%} bis \unit{44}{\%} . Allerdings ist die Berechnung des Druckabfalls auf einem höheren Druckniveau sehr genau. Das Modell wurde basierend auf Messdaten aus Untersuchungen bei \unit{60}{\%} r.F. berechnet. Dabei wurden Genauigkeiten von \unit{10}{\%} bis \unit{20}{\%} erzielt. Dies lässt darauf schließen, dass die Gleichungen zur Berechnung des Druckabfalls einen bestimmten Gültigkeitsbereich besitzen, der unter den gegenwärtigen Untersuchungsbedingungen verlassen wird. \newline
Trotz ungenauer Berechnung des Druckabfalls sind die Berechnungen der Temperaturen und der Leistungen sehr genau. Das liegt daran, dass die Parameter des Modells, die Wärmeübergangskoeffzienten $\alpha_L$, $\alpha_{KM}$ und $\alpha_{KM,SH}$, manuell so angepasst wurden, dass der errechnete dem messtechnisch erfassten Temperaturverlauf entspricht. Dies hat zur Folge, dass das Modell mit den aktuellen Parameterwerten nicht allgemeingültig ist. \newline
Der durch die Änderung der Verdampferschaltung sichtbare Effekt in der Kälteleistung wird ebenfalls durch den zu gering berechneten Druckabfall beeinflusst. Der durch das Modell berechnete Kälteleistungsgewinn ist nur halb so groß wie der tatsächlich erzielte. Dadurch, dass der berechnete Druckabfall zu niedrig ist, ist auch die Änderung des Druckabfalls nach Änderung der Verschaltung proportional niedriger. Dies spiegelt sich in den erzielten Verdampfungstemperaturen und damit in der Kälteleistung wider.
Aufgrund dessen ist zu vermuten, dass der Effekt der Verschaltungsänderung auf die Leistung, während den Untersuchungen bei \unit{60}{\%} r.F., noch deutlicher wird, da der Druckabfall wegen des höheren Druckniveaus ebenfalls höher ist. Durch das Modell wird neben dem Leistungsgewinn ein ebenfalls gesteigerter Druckabfall berechnet. Die Ursache dessen liegt im höheren Wärmestrom. Dadurch, dass das Kältemittel durch die veränderte Verschaltung mehr Wärme aufnimmt, wechselt es schneller den Aggregatzustand. Zwischen gasförmigem und flüssigem Kältemittel stellt sich ein Geschwindigkeitsschlupf ein, da gasförmiges Kältemittel aufgrund dessen geringer Dichte schneller strömt. Stärkere Reibungseffekte erhöhen deshalb den Reibungsdruckabfall. Das Kältemittel hat zu einem früheren Zeitpunkt als in der vorherigen Verschaltung dieselbe Geschwindigkeit. Es werden in jeder Zelle des Modells höhere Geschwindigkeiten berechnet. Da der Druckabfall, gemäß Gleichung~\ref{eq:14} quadratisch zur Geschwindigkeit steigt ist der Druckabfall in Verschaltung~V2 größer. \newline
Bei der Betrachtung der Temperaturprofile der Luft in den Abbildungen~\ref{fig:SimTempV1} und \ref{fig:SimTempV2}, ist fast kein Unterschied ersichtlich. Aus den Temperaturprofilen des Kältemittels ist der Effekt durch die Umkehr der Fließrichtung des Kältemittels ersichtlich. Diese gleichen nun denen eines reinen Gegenstromwärmeübertragers. Zudem ist eine höhere Überhitzung in Verschaltung~V3 zu erkennen. Diese wird durch den erzielten Leistungsgewinn verursacht. Im realen System würde dies durch die Überhitzungsregelung kompensiert werden und in einem geringeren Massenstrom resultieren. Ein steilerer Druckgradient geht mit einem steileren Temperaturgradienten einher, was eine Verstärkung des Effekts der Verschaltungsänderung verursacht. Wie zuvor erwähnt ist dies bei Normbedingungen zu erwarten. \newline
Die erfassten Messwerte bestätigen die Tendenz des Modells. Mit etwa \unit{35}{\watt} bis \unit{55}{\watt} Kälteleistungsgewinn je Kältekreis wird ein Gesamtkälteleistungsgewinn von \unit{140}{\watt} erzielt. Bei gleichzeitiger Reduktion der elektrischen Leistungsaufnahme resultiert dies in einem höheren EER. Durch den bei höherer Verflüssigungsleistung geringeren Kältemittelmassenstrom wird die Enthalpiedifferenz von Verdampfer und Kondensator erhöht. Zudem werden in diesem Zustand Dampfanteile von \unit{100}{\%} und daraus resultierende Unterkühlungen von \unit{3}{\kelvin} bis \unit{4}{\kelvin} realisiert.
Bei steigender Überhitzung reagiert das Expansionsventil, um diese zu kompensieren, mit einer Erhöhung des Öffnungsgrades und damit einer Steigerung des Kältemittelmassenstrom. Die Untersuchungen zeigen aber einen niedrigeren Massenstrom und eine geringfügig höhere Überhitzung. Dies ist wahrscheinlich auf eine Verschiebung des Betriebspunktes der Verdichter zurückzuführen. Bei einem Verdichterkennfeld ist das Druckverhältnis über dem Massenstrom aufgetragen \cite{Wilke.2005}. Ein, durch gesteigerten Druckabfall, zunehmendes Druckverhältnis kann bei gleicher Motordrehzahl zu einem geringeren Massenstrom führen und zu einer Reduktion des isentropen Wirkungsgrades. \newline
Mittels des Modells wird durch die Verschaltungsänderung eine Erhöhung der thermischen Leistungen und des Druckabfalls vorausgesagt, was durch die Untersuchungen bestätigt wird. Dies resultiert in einer Effizienzsteigerung von \unit{4}{\%}. 

\subsection{Vergleich der Verschaltungen V2 und V3}
\label{subsec:Vergleich der Verschaltungen V2 und V3_1}

In diesem Abschnitt werden die in Abschnitt~\ref{subsec:Vergleich der Verschaltungen V2 und V3_1} beschriebenen Untersuchungsergebnisse von Verschaltung~V2 und V3 bei \unit{60}{\%} r.F. analysiert.
Das Druck- und Temperaturniveau ist bei dieser Untersuchung höher als das der vorausgehenden Untersuchung. Durch den höheren Anteil an Feuchtigkeit in der Luft wird ein Teil der Kälteleistung dazu benötigt diese zu kondensieren. Deswegen wird die Luft nicht so stark abgekühlt wie zuvor und die Verdampfungsdrücke und -temperaturen sind entsprechend höher. Die Verdampferleistungen in beiden Verschaltungen sind bei feuchter Luft höher als bei trockener Luft, da feuchte Luft eine höhere Wärmeleitfähigkeit besitzt und damit gemäß der Gleichungen~\ref{eq:4}, \ref{eq:UA} und \ref{eq:28} mehr Wärme übertragen wird \cite{Lasance.2003}. Der Effekt auf die Leistungssteigerung des Verdampfers ist mit \unit{140}{\watt} Leistungsgewinn genauso groß wie in der vorigen Untersuchung. Damit ist dieser wider der Erwartung, dass der steigende Druckabfall die Verdampferleistung vergrößert, nicht größer als unter trockenen Bedingungen. Der durch die Änderung der Verschaltung verursachte Druckabfall ist zwar gegenüber der Untersuchung bei \unit{0}{\%} r.F. bedingt durch den höheren Massenstrom größer, allerdings führt dies nicht zu einem proportionalen Anstieg der Verdampferleistung sondern wird anderweitig vom System kompensiert. Dabei liegt die Begründung vermutlich in einer Verschiebung des Betriebspunkts im Kennfeld des Verdichters. Eine Erhöhung des Druckverhältnisses bedingt dabei eine Reduktion des Kältemittelmassenstroms.
Den Änderungen in den Messwerten liegen dieselben Ursachen zugrunde wie denen aus Abschnitt~\ref{subsec:Modellgestützter Vergleich der Verschaltungen V2 und V3_1}.
Durch Verschaltung~V3 wird ein Betriebspunkt erreicht in dem der Zustand des Kältemittels vor dem Expansionsventil sich genau auf der Siedelinie befindet. 
Dies ist erstrebenswert in Hinsicht auf den Schutz des Expansionsventils vor Schlägen von Gasblasen und auf dessen Regelverhalten. \newline
Mittels Verschaltung~V2 werden mit \unit{-0.47}{\celsius} minimaler und \unit{10.25}{\celsius} maximaler Produkttemperatur die bislang tiefsten Produkttemperaturen erzielt, wenn die Untersuchung bei \unit{0}{\%} r.F. nicht miteinbezogen wird. Diese werden durch die tiefere Verdampfungstemperatur und die Optimierung der Verschaltung generiert. Wegen des veränderten Überhitzungssollwerts sind die Ergebnisse nicht direkt mit denen vor dem Verdampfertausch vergleichbar.
Die Effizienzsteigerung beträgt unter feuchten Bedingungen \unit{3}{\%}, sodass ein vergleichsweise hoher EER von \unit{2.28}{} erzielt wird. 

\chapter{Zusammenfassung und Ausblick}
\label{cha:Zusammenfassung}

Im Rahmen dieser Arbeit wurden experimentelle Untersuchungen an einem vertikalen Supermarktkühlmöbel in einer Klimakammer durchgeführt, mit dem Ziel unter Veränderung günstiger Parameter eine thermische Leistungssteigerung herbeizuführen. Zur Untersuchung des Einflusses einer modifizierten Reihenfolge der Verdampferrohre wurde ein mathematisches Modell des Verdampfers entwickelt und anhand von Versuchsdaten validiert. \newline
Eine Durchführung der Untersuchungen nach Normbedingungen ist nur begrenzt möglich. Die Vorgabe einer einheitlichen Luftgeschwindigkeit zwischen \unit{0.1}{\metre\per\second} und \unit{0.2}{\metre\per\second} an drei Punkten über die Höhe der linken Außenkante des Kühlmöbels kann nicht eingehalten werden. Es ist ein Gradient von Geschwindigkeiten zwischen \unit{0.02}{\metre\per\second} und \unit{0.35}{\metre\per\second} messbar. Eine Reduktion der Lüfterleistung führt zu einer Annäherung der Werte in den Zielbereich. Allerdings führt dies zu einem Temperaturgradienten von \unit{2}{\kelvin} über die Höhe des Möbels und zu einer instabilen Regelung von Temperatur und relativer Luftfeuchtigkeit. Deswegen wurde für die nachfolgenden Untersuchungen ein Betrieb mit zwei Lüftern mit je \unit{30}{\%} ihrer Leistung beschlossen. \newline
Berechnungen um die im jeweiligen Öl gelöste Kältemittelmenge zu bestimmen ergeben, dass HATCOL~4467 gegenüber 3MAF in den Wärmeübertragern eine um \unit{5}{\%} geringere Löslichkeit besitzt. Dies entspricht maximal etwa \unit{1}{\gram} bis \unit{1.5}{\gram} je Kältekreis. Mittels eines Spülsystems wurde festgestellt, dass sich kein zurückgebliebenes Öl in den Kältekreisen befindet. Der Wechsel zu HATCOL~4467 führt zu einer Erhöhung der thermischen Leistungen. Allerdings geht dies einher mit einer EER-Reduzietung um \unit{3.2}{\%} da auch die elektrische Leistungsaufnahme reduziert wird. \newline
Die Regelung der Abtauung detektiert wegen einer steigenden Temperaturdifferenz über den Verdampfer keinen Abtaubedarf und löst diese deshalb nach dem vorgegebenen maximalen Intervall von \unit{3}{\hour} aus. Die steigende Temperaturdifferenz ist vermutlich auf eine Erhöhung der Induktionsrate des Luftschleiers mit der warmen Raumluft durch eine Veränderung des konvektiven Wärmestroms zurückzuführen. Ab einer Zeitmarke von etwa \unit{3}{\hour} werden die thermischen Leistungen sowie die Verdampfungstemperaturen, bedingt durch Eisbildung am Verdampfer stark reduziert. Eine Verkürzung des Abtauintervalls auf \unit{3}{\hour} verhindert dies und erzielt damit einen EER-Gewinn von \unit{5.6}{\%}. \newline
Ein Wechsel von der Hybrid- zur Standardausführung des Verdichtermodells ZB09KAU-TFD erhöht bedingt durch eine andere Motorkennlinie die Kondensator- und Verdampferleistungen um \unit{400}{\watt}. Da auch die elektrische Leistungsaufnahme steigt führt dies nur zu einem geringen EER-Anstieg von etwa \unit{0.9}{\%}.\newline
Ein Umstieg auf den vierreihigen LIDL-Verdampfer führt aufgrund dessen besserer Wärmeübertragungscharakteristik zu einem Kältemittelmangel. Dies wird kompensiert durch eine Erhöhung des Überhitzungssollwerts von \unit{8}{\kelvin} auf \unit{13}{\kelvin}. \newline
Mittels des Modells werden durch die Verschaltungsänderung ein Anstieg des Druckabfalls und eine Erhöhung der Kälteleistung berechnet. Diese Tendenz wird durch die Untersuchungsergebnisse bestätigt. Bei geringen Druckverhältnissen weicht der berechnete Druckabfall stark von den erfassten Messwerten ab, sodass das Modell einen eingeschränkten Gültigkeitsbereich besitzt. Die modifizierte Verschaltung generiert durch den Druckabfall und die daraus resultierende Reduktion der Verdampfungstemperatur ein Temperaturprofil, dass dem eines Gegenstromwärmeübertragers gleicht. Dadurch werden mit minimal \unit{-0.47}{\celsius}  und maximal \unit{10.25}{\celsius} die im Rahmen der Untersuchungen tiefsten Produkttemperaturen und ein EER von \unit{2.28}{} erzielt.
Alle durchgeführten Veränderungen erweisen sich somit als leistungssteigernd. \newline
Als weitere Maßnahme zur Leistungssteigerung bietet sich die Installation von Venturi-Verteilern an. Diese teilen den Massenstrom auf mehrere Verdampferrohre auf und reduzieren dadurch den Druckabfall. Eine Reduktion des aufzubringenden Druckverhältnisses führt zu einer Steigerung des isentropen Wirkungsgrades.
