TKlebig/TimBAgit/Presentations/170418_Stand_tkl.pptx

## Zwischenstand Tim Klebig

Modellgestützte Untersuchung und experimentelle Validierung von Verdampferschaltungen zur thermischen Leistungssteigerung für den Einsatz in Kühlmöbeln

- Tim Klebig

## Vertikales Supermarktkühlmöbel

- Problem
  - Produkttemperatur nicht im Zielbereich zwischen -1°C und 5°C über die gesamte Warenausstellfläche
  - Füllmenge von 150 g Propan pro Kreislauf zu gering
  - Ungünstige Luftverteilung durch den Luftschleier
- Notwendige Verbesserung
  - Kälteleistung erhöhen
  - Füllmenge reduzieren
  - Luftführung verbessern

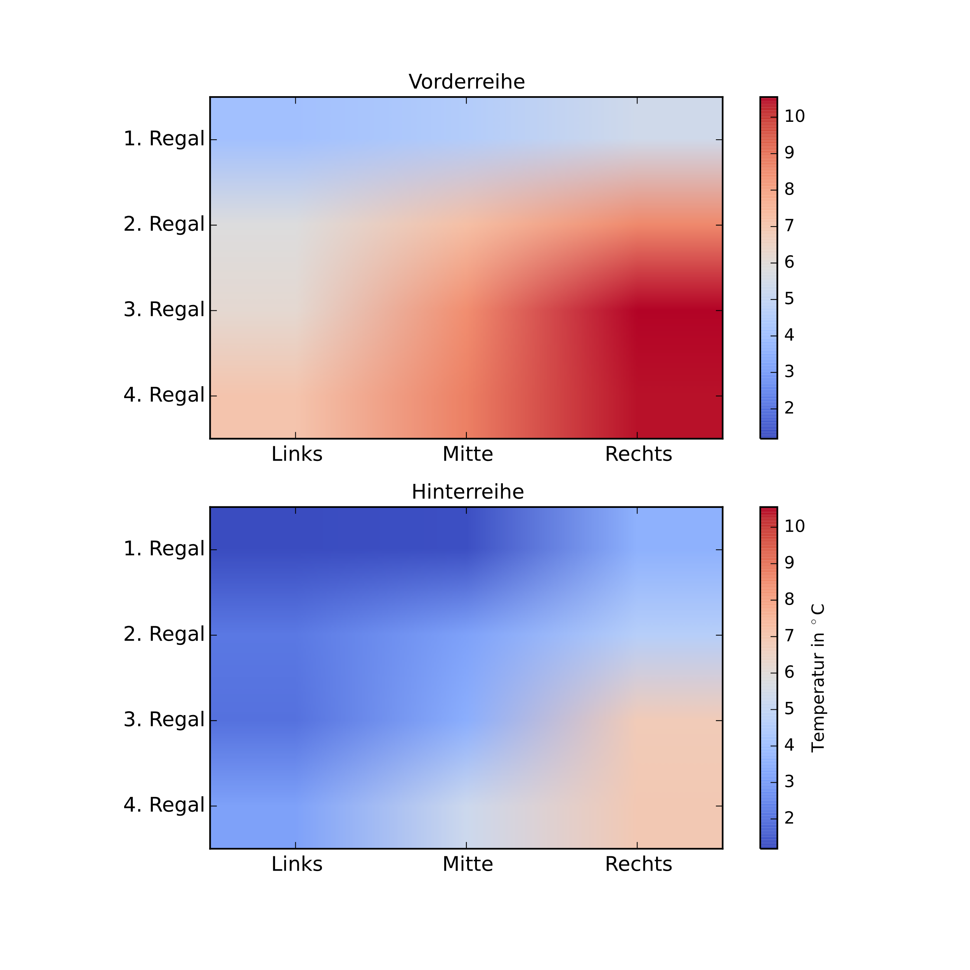
[picture p9: figure]

Notes: -Vortrag zur Beschreibung der Modellerstellung nutzen
-Durchgeführte Versuche: Vergleich von Ölen, Kompressoren, Validierung des Modells
-Weg von: wir verkaufen Scrolls, hin zu: wir verkaufen ganzheitl. Lösung und garantieren Funktion!

## Verdampfertemperaturen eines 4h Abtauzyklus

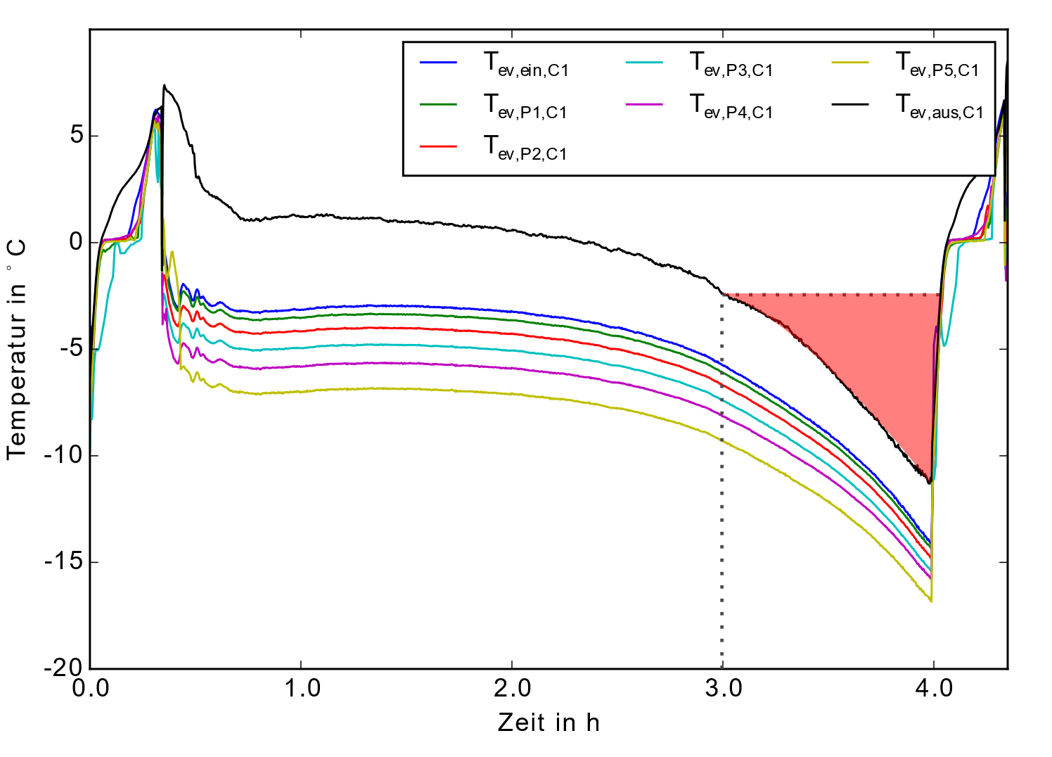
[picture p10: figure]

## Leistungen und EER eines 4h Abtauzyklus

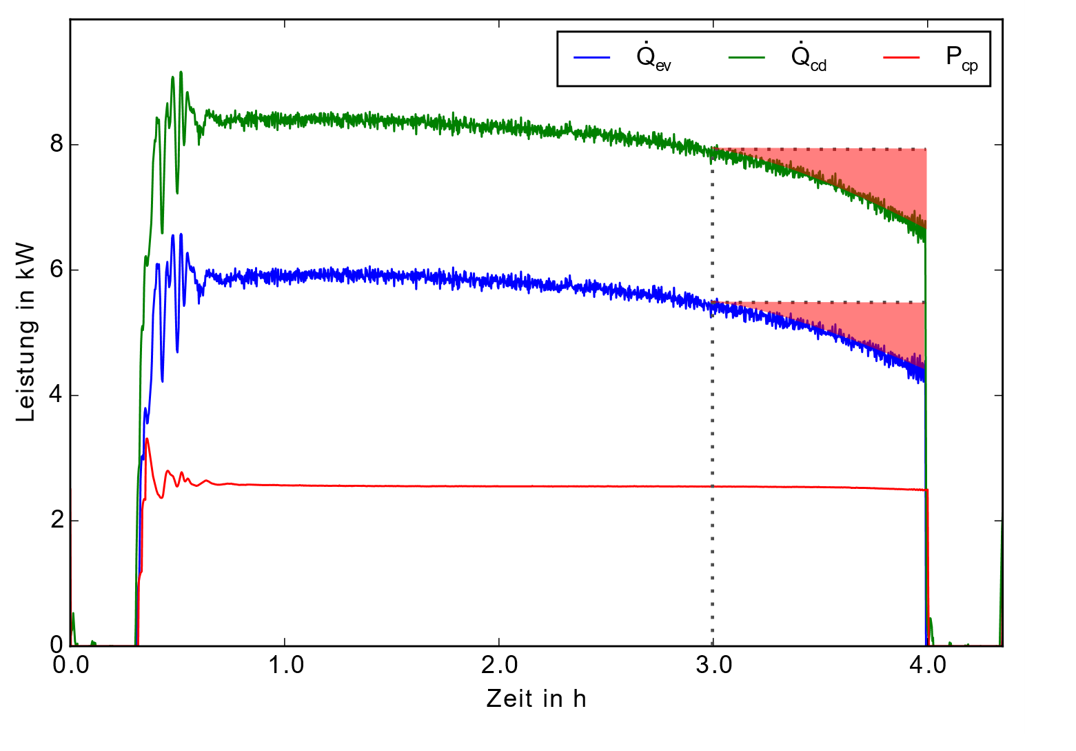
[picture p11: figure]

## Demand defrost detection

12

10

8

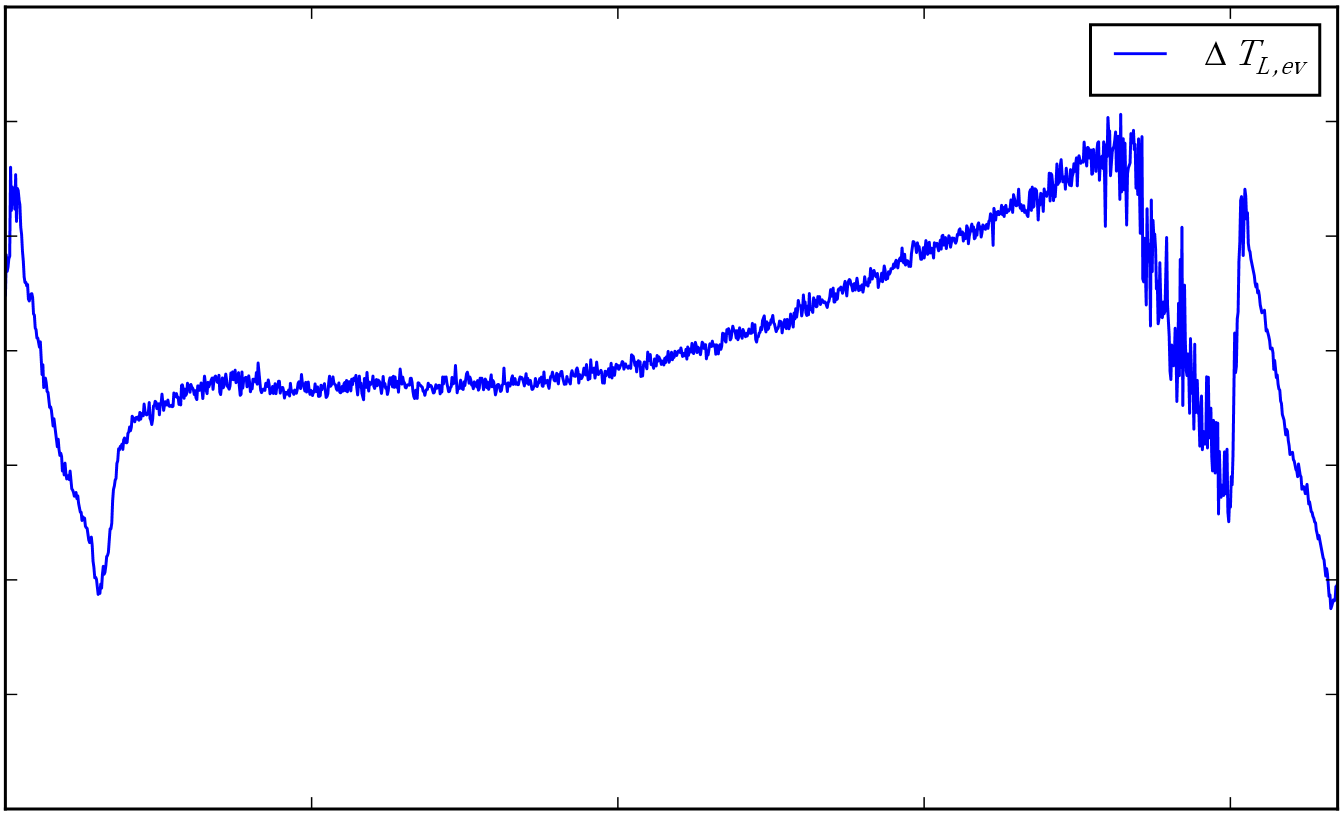
[picture p12: figure]

- Current algorithm: Deviation from maximum Δ T
  - Detection when Δ T falls due to heavy ice building
  - Almost 4h

Δ Tair,ev

12

10

8

Δ Tair,ev

Temperature difference in K

6

4

2

0

0.0

1.0

Time in h

2.0

3.0

4.0

- Improved algorithm: Deviation from start value
  - Detection when Δ T due to sinking of evaporating temperature
  - Earlier detection

Temperature difference in K

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
Time in h

2.0

## Slide 6

12

10

8

Δ Tair,ev

Temperature difference in K

6

4

2

0

0.0

1.0

Time in h

2.0

3.0

4.0

- Δ T rising
  - Evaporating temp and air outlet temp fall due to ice building
- Δ T falling
  - Air mass flow reduced by ice

12

10

8

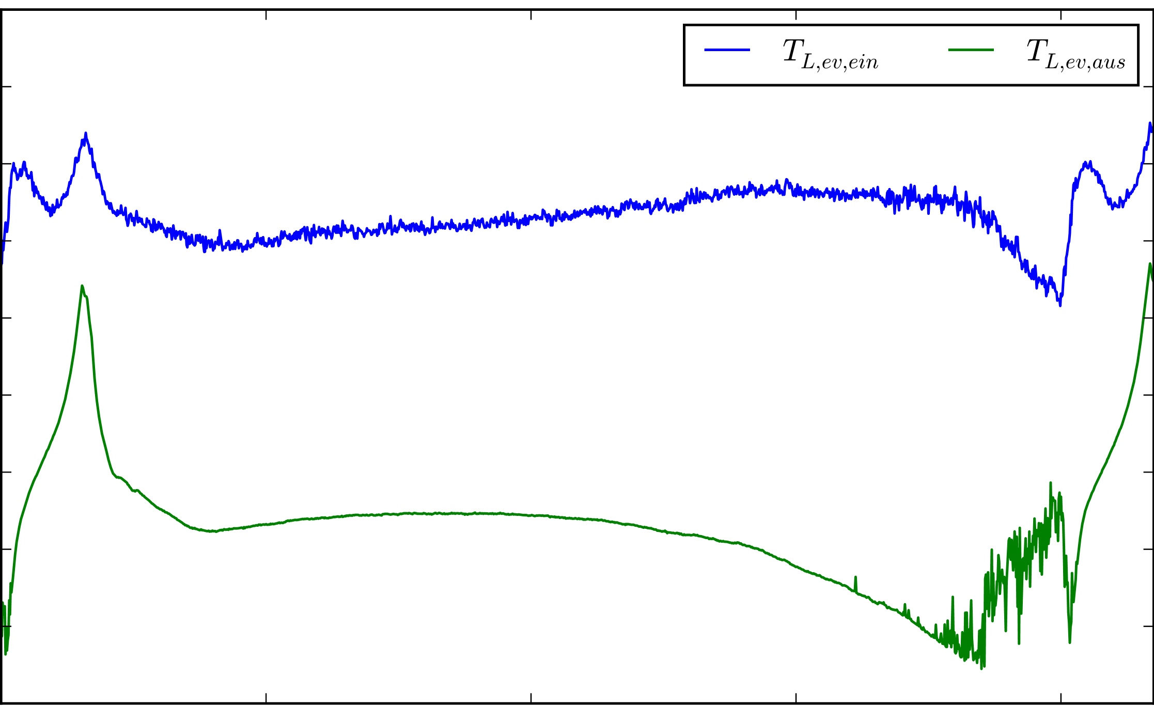
[picture p13: figure]

- Outlet temperature decreases while inlet temperature increases
  - Air distribution affected by heat transmission

Tair,ev,in

Tair,ev,out

Temperature in °C

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
Time in h

## Slide 7

- Tim Klebig
- E-Mail: tim.klebig@eonerc.rwth-aachen.de
