TKlebig/TimBAgit/Presentations/cve-tkl_040618.pptx

## [C] Zwischenstand Bachelorarbeit

Modellgestützte Untersuchung und experimentelle Validierung von Verdampferschaltungen zur thermischen Leistungssteigerung für den Einsatz in Kühlmöbeln

- Tim Klebig

## Vertikales Supermarktkühlmöbel

- Problem
  - Produkttemperatur nicht im Zielbereich zwischen -1°C und 5°C über die gesamte Warenausstellfläche
  - Füllmenge von 150 g Propan pro Kreislauf zu gering
  - Ungünstige Luftverteilung durch den Luftschleier
- Notwendige Verbesserungen
  - Kälteleistung erhöhen
  - Füllmenge reduzieren
  - Luftführung verbessern

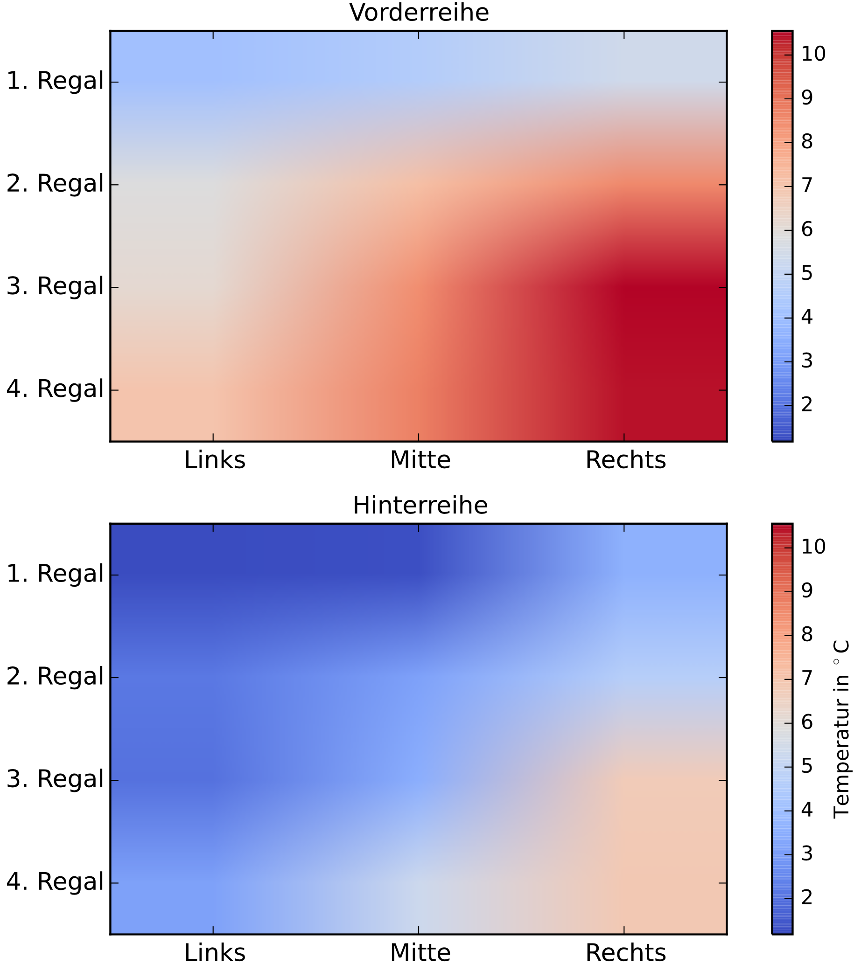
[picture p14: figure]

## Verkürzung des Abtauintervalls von 4 h auf 3 h


## Temperaturdifferenz am Verdampfer

12


Δ Tair,ev

10

Temperaturdifferenz in K

8

6

4

2

0

0.0

1.0

Zeit in h

2.0

3.0

4.0

- Temperaturdifferenz steigt
  - Wegen Vereisung sinken Verdampfungs- und Luftauslasstemperatur
  - Einlasstemperatur constant
- Temperaturdifferenz sinkt stark
  - Luftstrom durch starke Eisbildung reduziert

12


Tair,ev,in

Tair,ev,out

10

8

Temperatur in °C

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
Zeit in h

2.0

3.0

4.0

Einlasstemperatur der Luft bleibt konstant während Auslasstemperatur absinkt
Erhöhung der Induktionsrate des Luftschleiers infolge einer Erhöhung des konvektiven Wärmeübergangs

## Erkennungsalgorithmus der Bedarfsabtauung

12

Δ Tair,ev

10

Temperaturedifferenz in K

8

6

4

2

0

0.0

1.0

Zeit in h

2.0

3.0

4.0

- Aktueller Erkennungsalgorithmus
  - Detektion von maximaler Temperaturdifferenz
  - Trigger bei negativer Abweichung um 3K

12

Δ Tair,ev

10

Temperaturedifferenz in K

8

6

4

2

0

0.0

1.0

Zeit in h

2.0

3.0

4.0

Verbesserter Erkennungsalgorithmus
Detektion von konstanter Temperaturdifferenz zu Beginn des Kühlzyklus
Trigger bei positiver Abweichung um 3K

## Slide 6

- Tim Klebig
- E-Mail: tim.klebig@eonerc.rwth-aachen.de
