TKlebig/TimBAgit/Presentations/Working Progress 190218.pptx

- Status Review

- 29.01.2018

Emerson Confidential and Proprietary/For internal use only

## Last week:

- Finished most of the work on the EES modell
- Water measuring
- Testing with dry air

## Condensing water

Starttime | Stoptime | Mass water [kg] | Mass water [kg/day] | Cycle
13:00 | 16:00 | 8.888 | 71.10 | 03:00

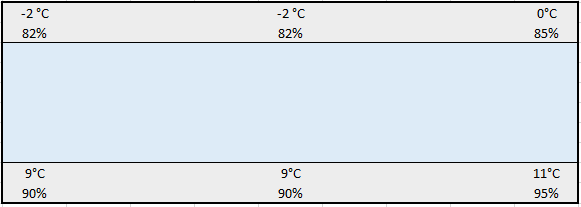
[picture p16: figure]

## Evaporator change

- Same dimensions but better heat transmission
- 8K Superheat not possible
  - E-Valve fully open with 12K SH
  - Higher mass flow rate
  - Higher evaporating temperature
  - Lower condensing temperature
  - Calculated TCOND is lower than Twater,IN → bubbles in front of a pressure sensor can lead to a great loss in accuracy
- Changed Superheat setting to 13K
  - Similar performance like old evaporator
=> Because of better heat transmission the charge is not enough

## Slide 5

Evaporator Design Comparison

Original LIDL design

modified LIDL design

1

2.1 IN

1.1 IN

1

2.1

1.1

2

3

3.1 IN

3.4

2

3

3.1

2.4

3.8fIN

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
IN 1.8

12

11

2.8

1.8

3.9

12

11

IN 2.8

3.9

13

14

2.9

2.12 OUT

13

14

2.9

2.12 OUT

15

16

1.12 OUT

3.12 OUT

15

16

1.12 OUT

3.12 OUT

## To-Do:

- Change coil connections
- Make corrections for condensing temperature (pdisch)
