TKlebig/TimBAgit/Presentations/Working Progress 201117.pptx

## Working Progress

21.11.17

## Last week:

- Worked on Python script
- Air flow visualisations with Inkscape
- Simple evap model with EES
- Achieved good values again. (open ceiling and 25pct fp)
  - 48h tests over the weekend (25pct vs 27pct fan power)

## Compressor weight

## Air flow (Tests 0-37 & 45-47)

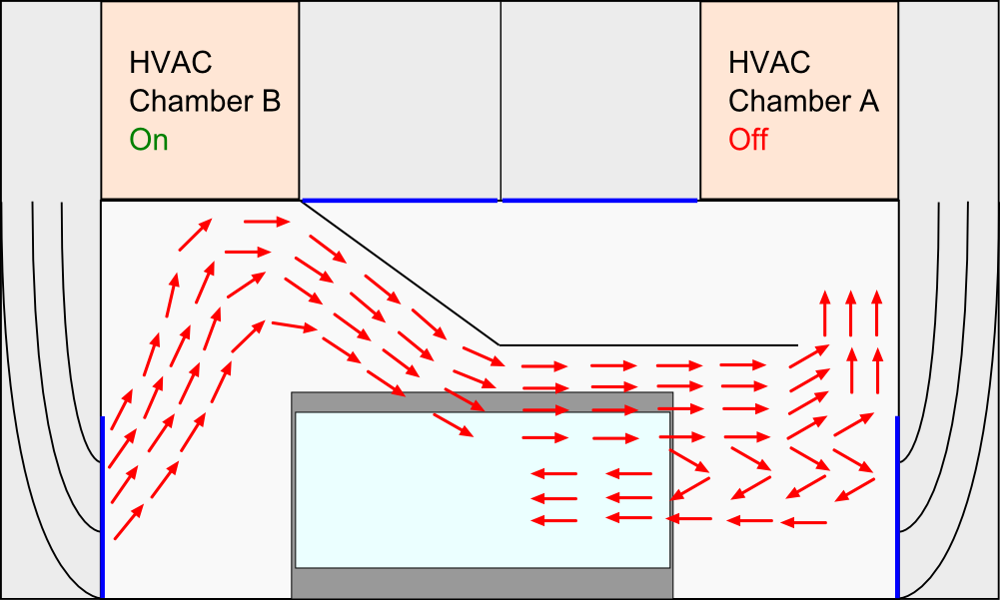
[picture p22: figure]

## Air flow (Tests 38-44 → 5 fans – 10pct )

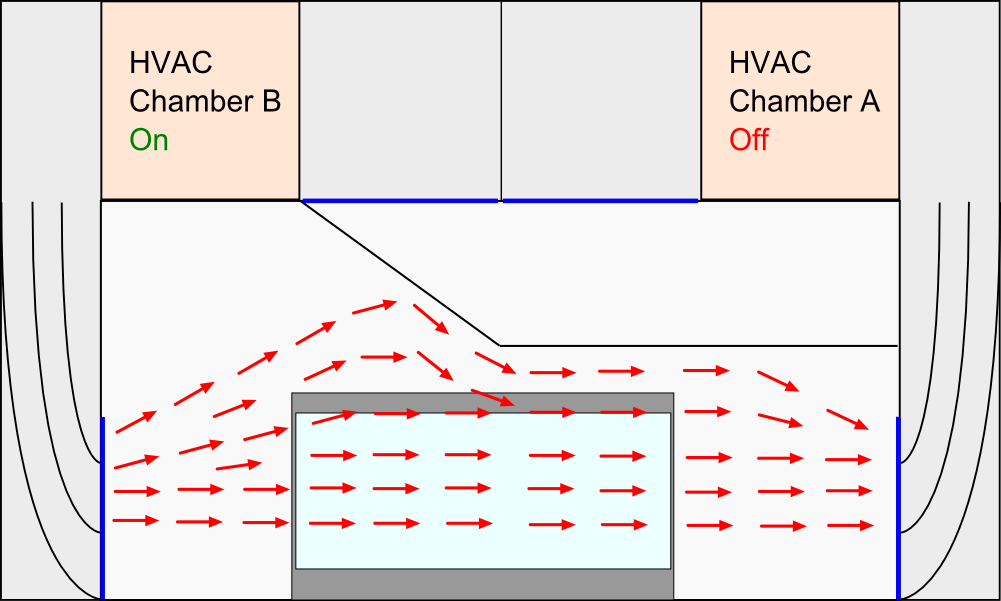
[picture p23: figure]

## Test 40

T_cond: 35°C
T_defr: 4h
Fan Settings: 5 fans 10pct
(closed ceiling)

## Previous testing (Test 40)

- after changing back to HATCOL
- Evaporating temperature looked like this:

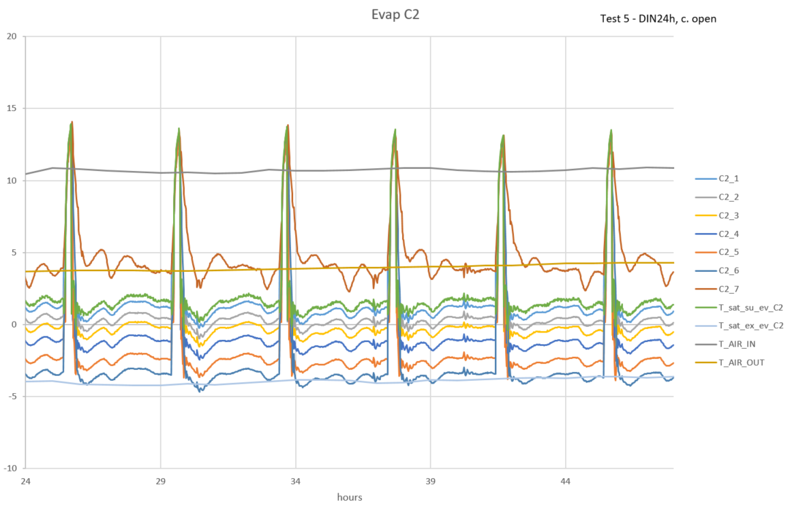
[picture p24: figure]
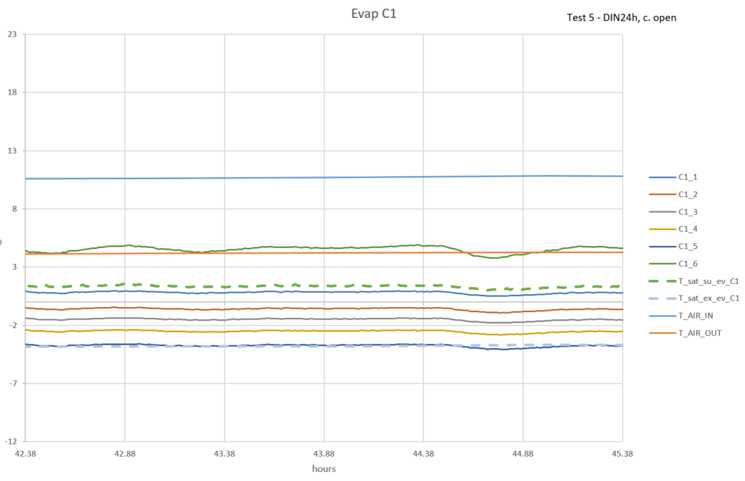
[picture p25: figure]

## Slide 8

- Product temperature:

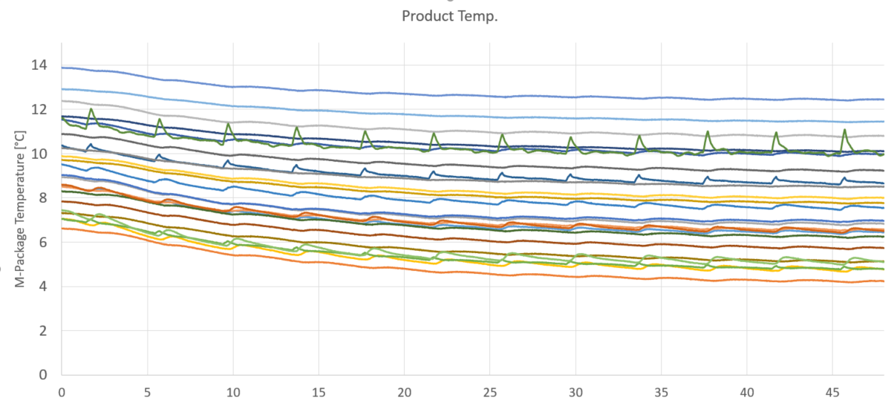
[picture p26: figure]

## Slide 9

- Front:
- Back:

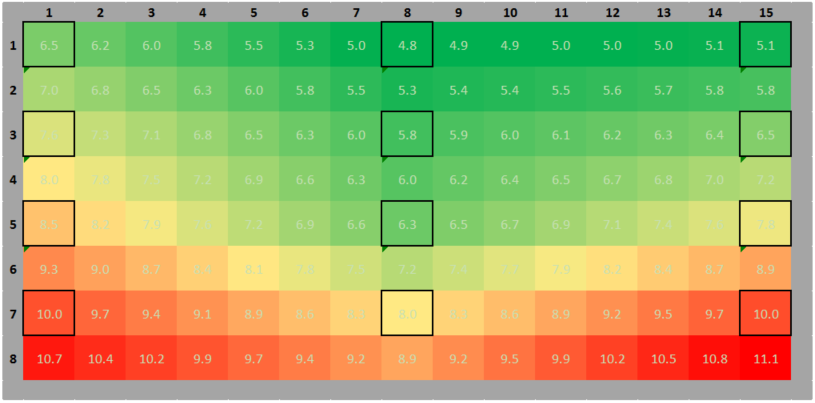
[picture p27: figure]
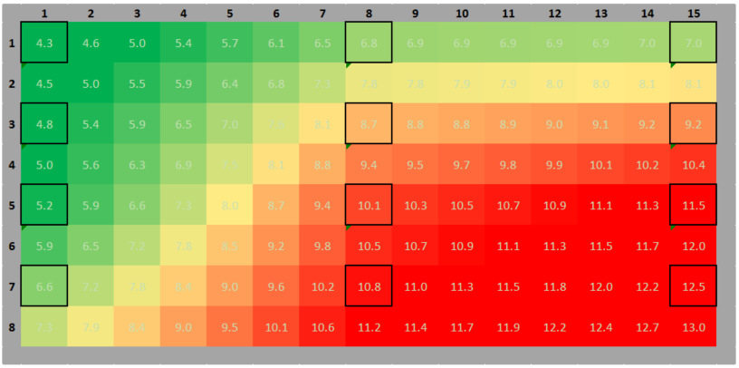
[picture p28: figure]

## Possible Reasons

- Too much oil in the system? (Oil stuck in condenser? Mixture HATCOL-3MAF?)
- Lower air velocity → Chamber regulation is worse
  - higher temperature gradient in height
  - higher humidity oscillating → more dehumidifying?
- More air streaming in front of the cabinet →more warm air is sucked in by the air curtain?

## Test 47

T_cond: 35°C
T_defr: 4h
Fan Settings: 2 fans 25pct
(ceiling opened again)

## Latest Test (Test 47)

- Evaporating temperature:

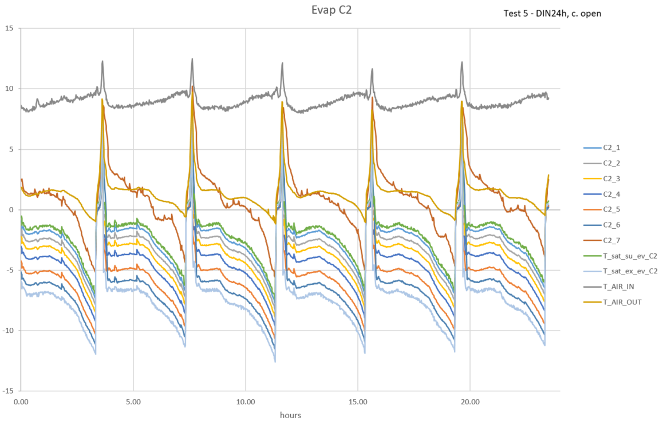
[picture p29: figure]
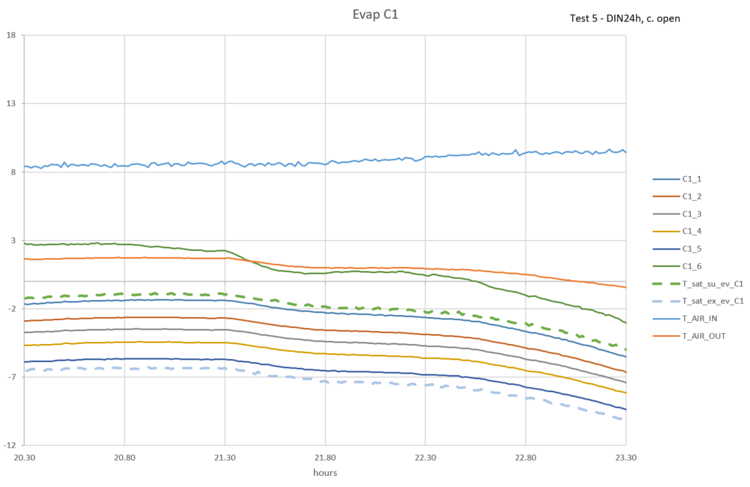
[picture p30: figure]

## Slide 13

- Product temperature:

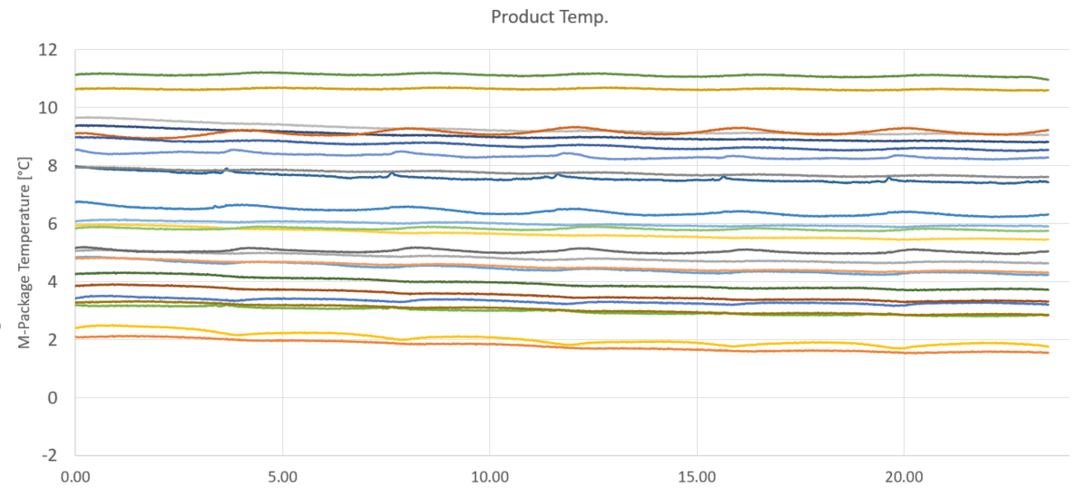
[picture p31: figure]

## Slide 14

- Front:
- Back:

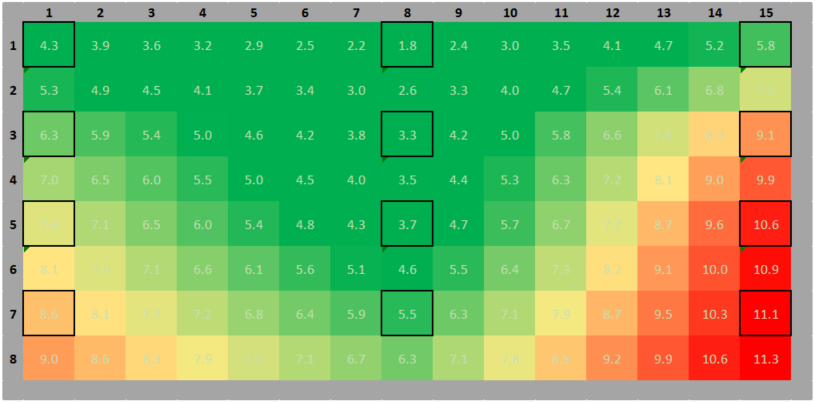
[picture p32: figure]
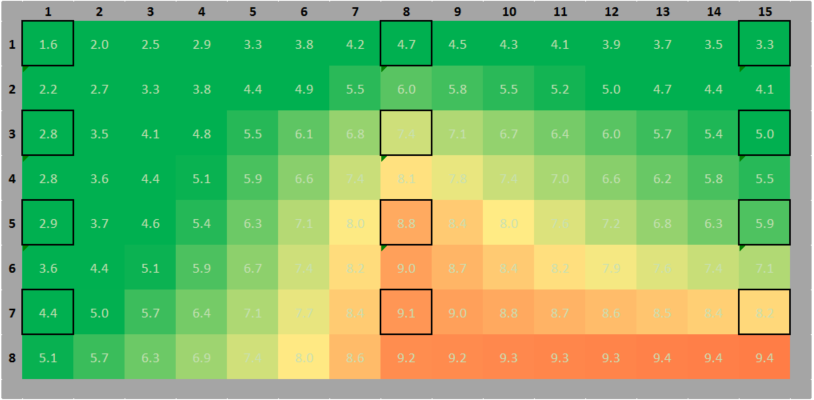
[picture p33: figure]

## Comparison: Test 47 – Test 24

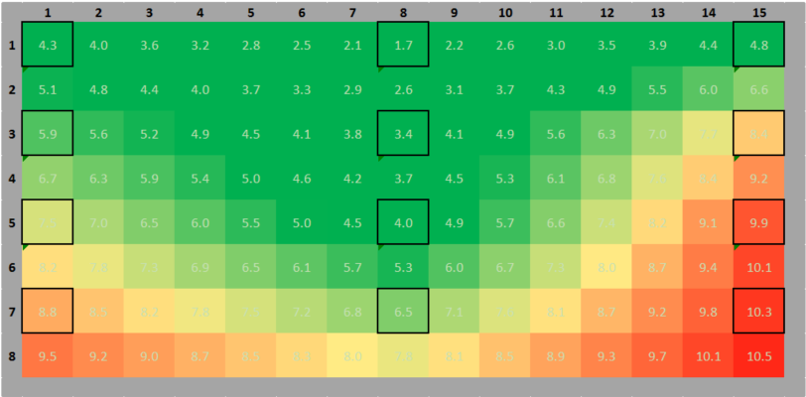
[picture p34: figure]

- Almost good! Next results on Tuesday!

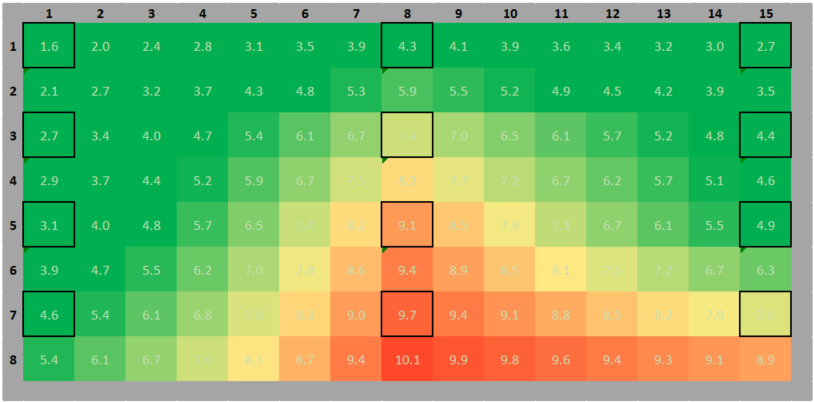
[picture p35: figure]

## Next steps
