TKlebig/TimBAgit/Presentations/EBC Presentation 0901.pptx

- Status Review

- 10.01.2018

Emerson Confidential and Proprietary/For internal use only

## Last weeks:

- Flushed each circuit with flushing device from Welkenrath (R407c)
- Further work on the evaporator model
- Changed the calculation method of the python script
- Started writing

## Flushing of the cabinet

- No oil in the circuits
- Previous filling was
too high
(estimated 600ml
instead of 470ml)

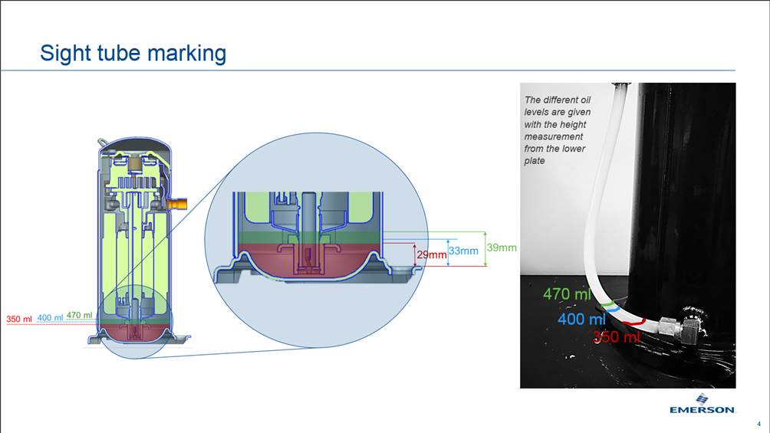
[picture p36: figure]

## Evaporator model

- Previous used equations are only valid for one-phase flow
- Pressure drop equations changed → valid for 2-phase flow
- ε-NTU method changed to fin correlations → αair
- Assumptions:
  - Xin =0
  - Xout =1
  - Inlet-Conditions: Tair, patm,uair,Trefr,prefr
  - Δh known – equidistant cells
  - Flow boiling
  - Dry air
=> Goal is to see a trend of the evaporator performance

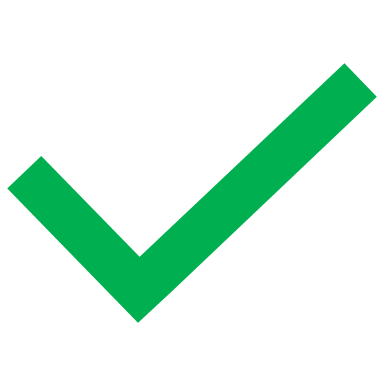
[picture p37: figure]
Checkmark

## Python script

## To-Do:

- Test-Plan according to DoE
  - Schedule Testing order
  - Testing
  - Representative Evaporator arrangements
  - Parameters?

Evaporator | Condensor | TCOND | TDEFROST
Current arrangement | SWEPCURRENT | 55 | 4
LIDL-Design | SWEPSMALL | 45 | 3
V1 | | 55 | 2
V2 | | | manual
