TKlebig/TimBAgit/Presentations/EBC Presentation 2711.pptx

## Integrated display cabinet

## Slide 2

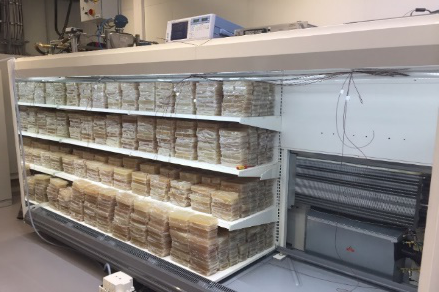
[picture p38: figure]

## Slide 3

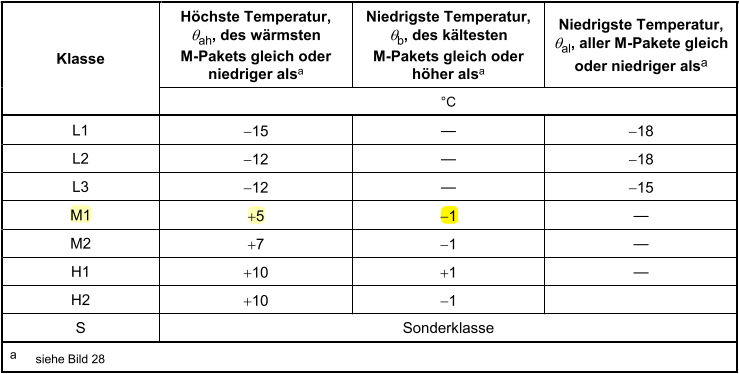
[picture p39: figure]

## Slide 4

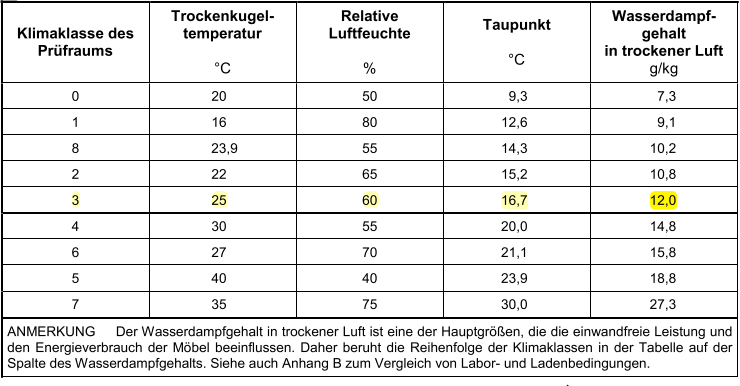
[picture p40: figure]

## Norm: Luftgeschwindigkeit zw. 0.1 – 0.2 m/s

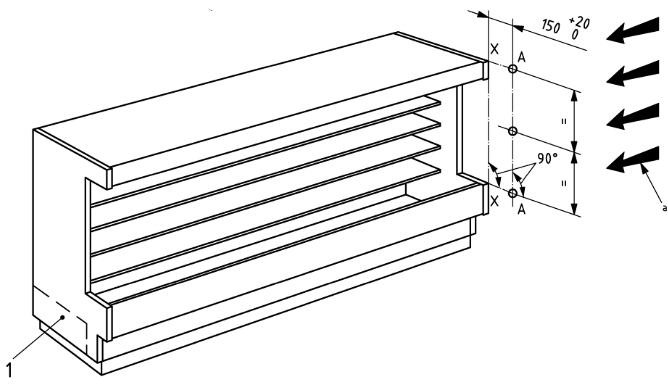
[picture p41: figure]

## Luftstrom in der Klimakammer bisher

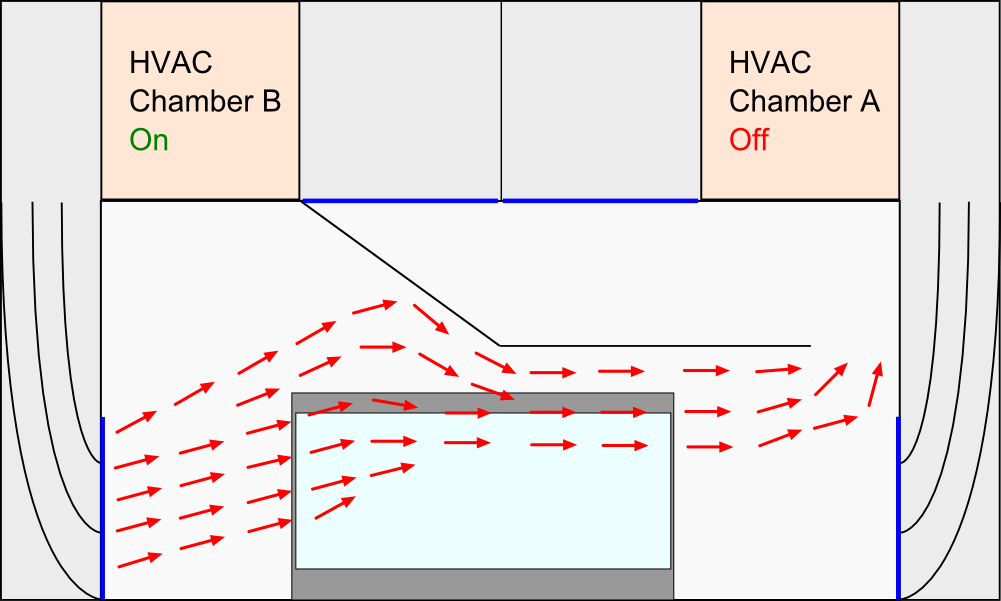
[picture p42: figure]

## Modifizierter Luftstrom

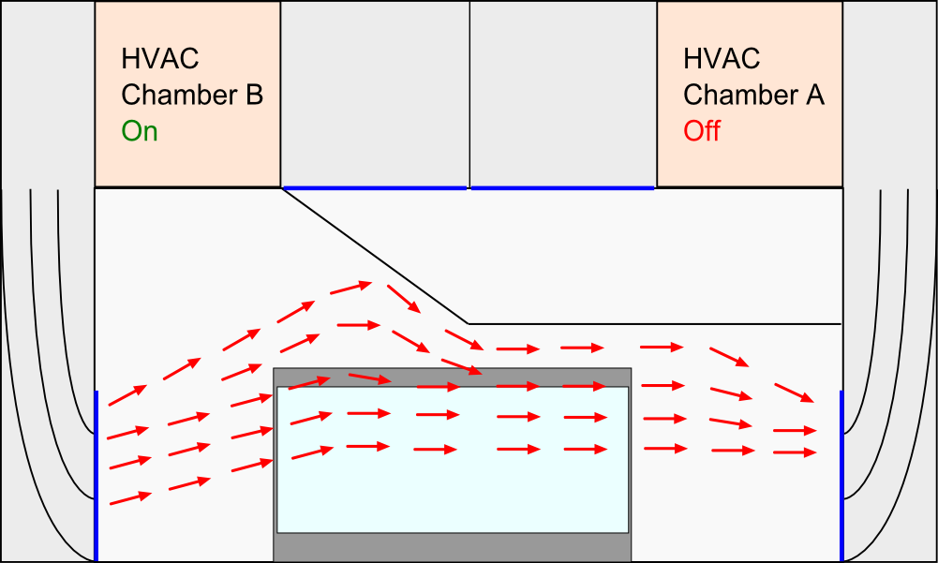
[picture p43: figure]

## Bestes Ergebnis

## Anordnung der Prüfpakete und Sensoren

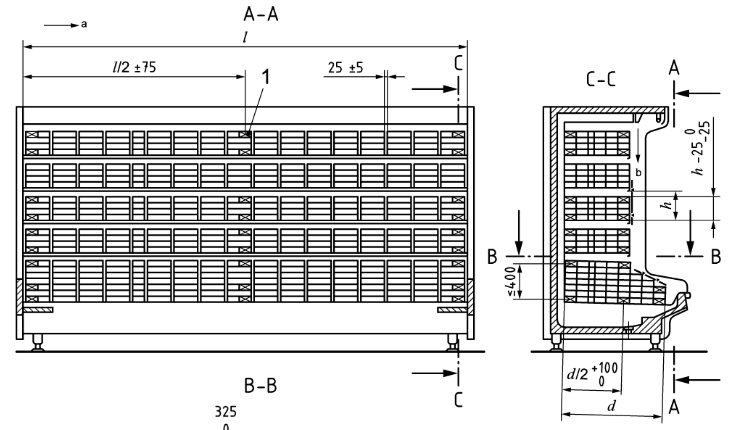
[picture p44: figure]

## Temperaturen der M-Pakete

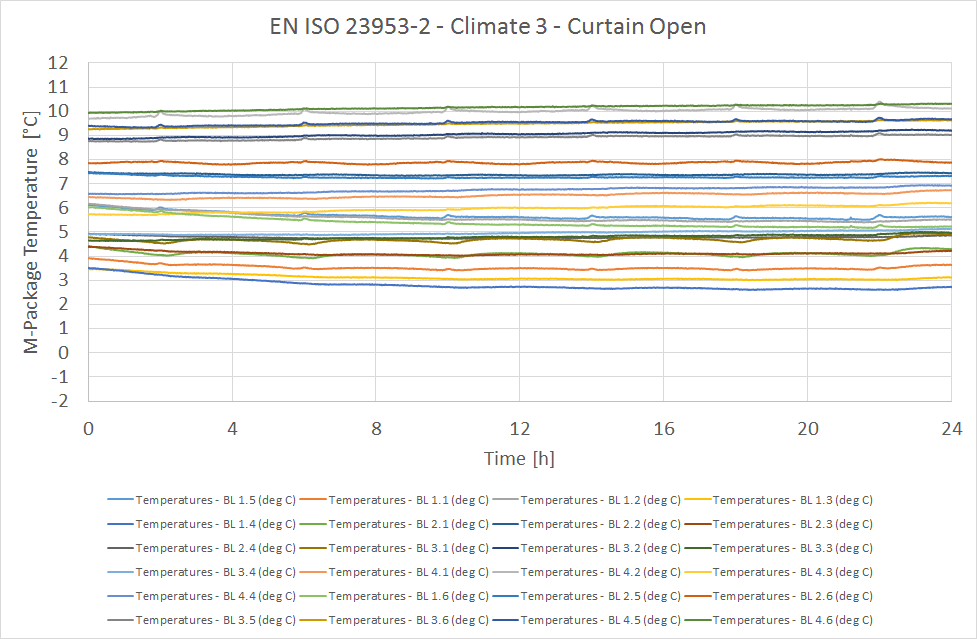
[picture p45: figure]

H2

M2

M1

Minimal Temperature

## Temperaturverteilung

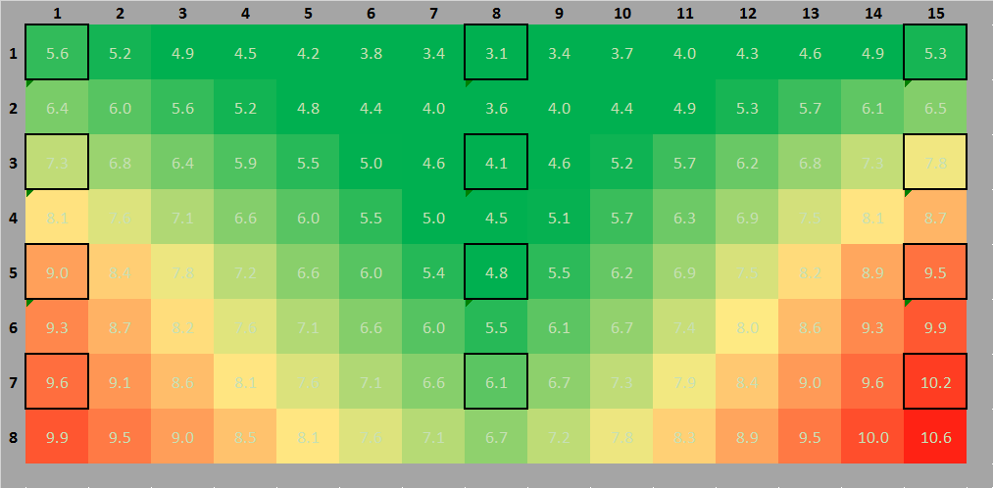
[picture p46: figure]
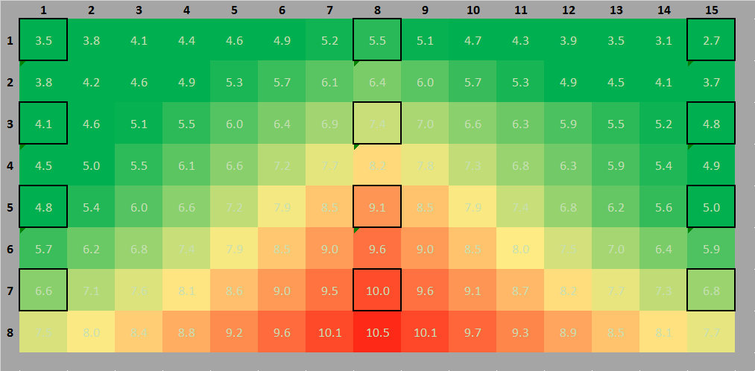
[picture p47: figure]

Vorne Hinten

## Leistungsverlust durch Löslichkeit des Öles

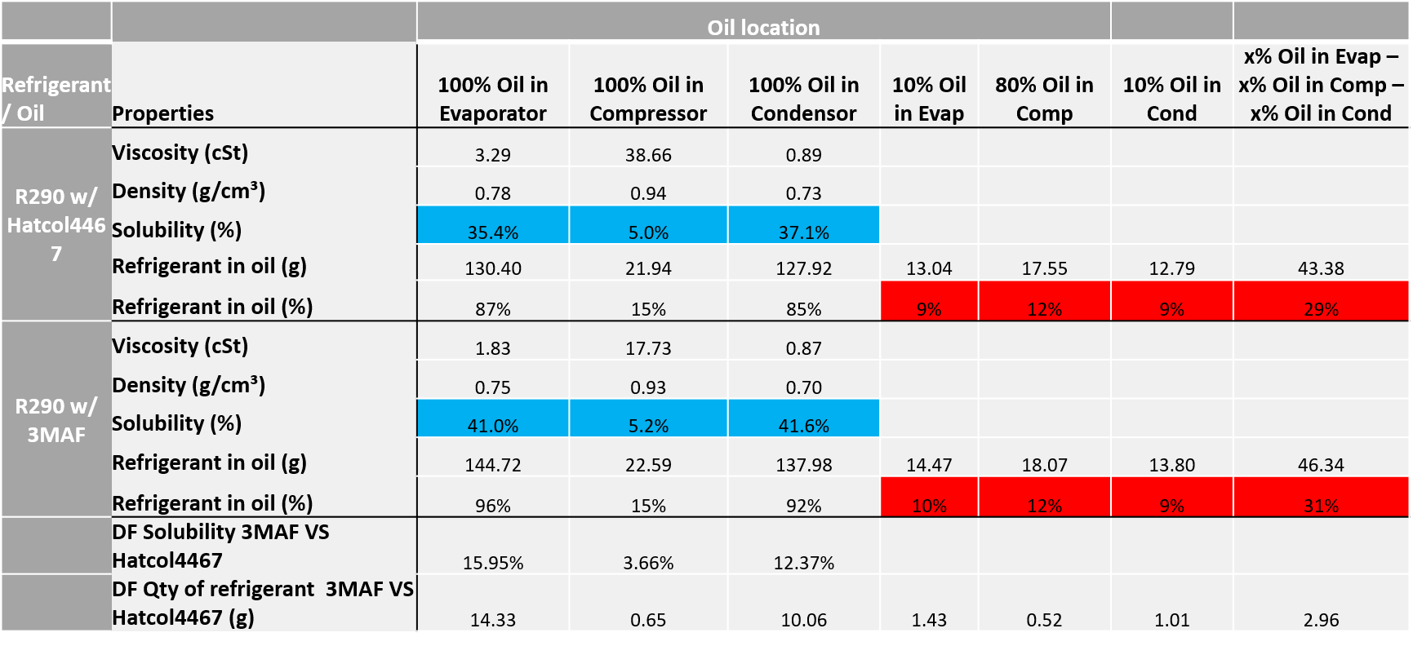
[picture p48: figure]

## Folgende Tests mit neuem Verdampfer

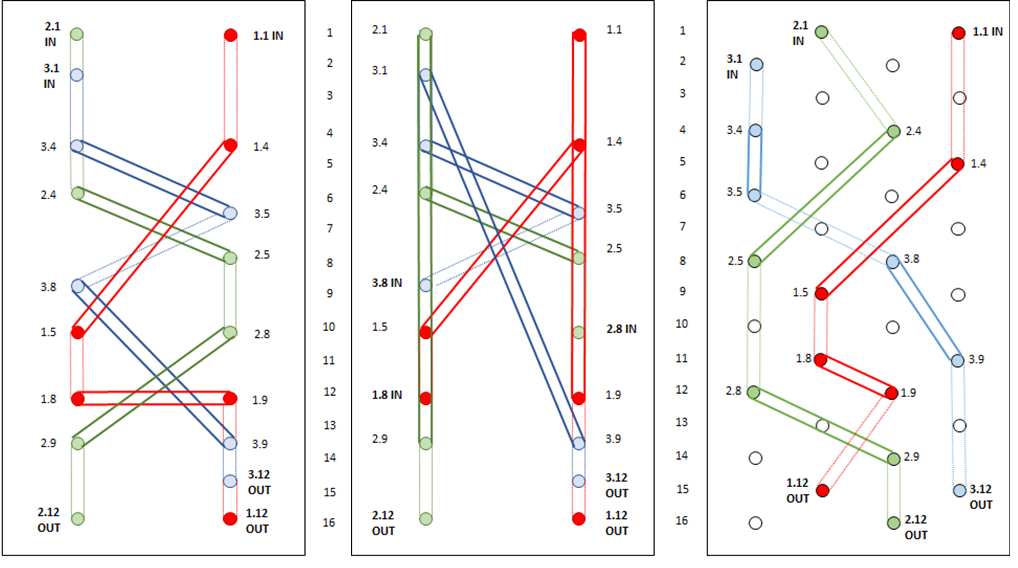
[picture p49: figure]

Initial Design

Circuit Optimization

New Design?

## Derzeitige Arbeit

- Modellbildung mit EES
  - Optimum zwischen Druckabfall und maximaler Verdampferleistung gesucht
- Automatische Auswertung der Messdaten mit Python
