TKlebig/TimBAgit/Presentations/Progress Lecture Review.pptx

## Lecture Review

## Process Design of Heat Exchanger

- Fouling reduces the effective heat transfer
- KERN method:
  - #1 thermodynamical properties of hot and cold fluids (caloric temp / arithmetic mean temp)
  - #2 Energy balance, find the heat duty
  - #3 assume

## Applied Thermal Engineering Development and validation of a condenser three zones model

- INPUT:
  - Air supply temperature
  - Air mass flow rate
  - Refrigerant supply temperature (or Overheating)
  - Exhaust subcooling (->superheat for evap model)
  - Refrigerant mass flow rate

One spec. heat transfer coeff. for each zone
Deterministic vs theoretical-experimental model
Deterministic
Heat exchanger geometry is known
Identify heat transfer / friction factor correlations
Theoretical-experimental
Unknown geometry
Performance is known

OUTPUT:
Pressures/temperatures in each zone
Corresponding heat flows
Geometrical repartition
Pressure drop on air side

Assumptions:
Pure counterflow/crossflow/combination
Fluids homogenously distributed
Lubricant doesn´t affect heat transfer coeff

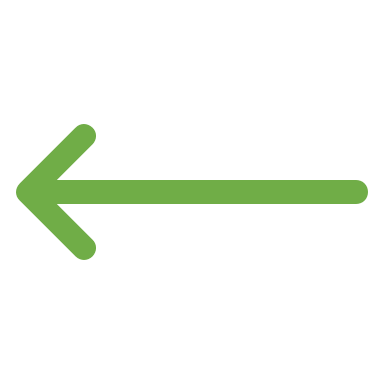
[picture p50: figure]
Line Arrow: Straight

## Model

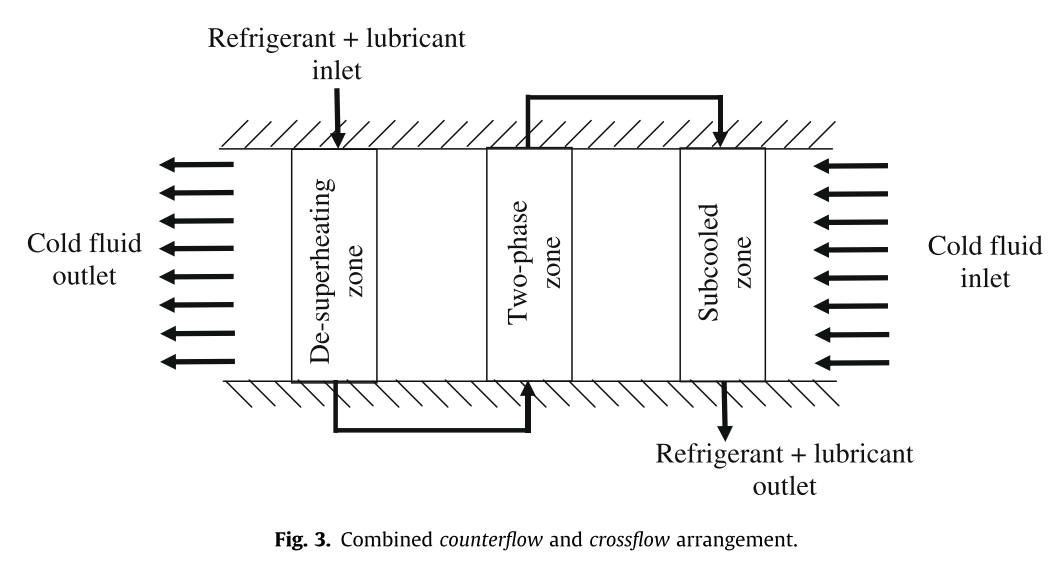
[picture p51: figure]
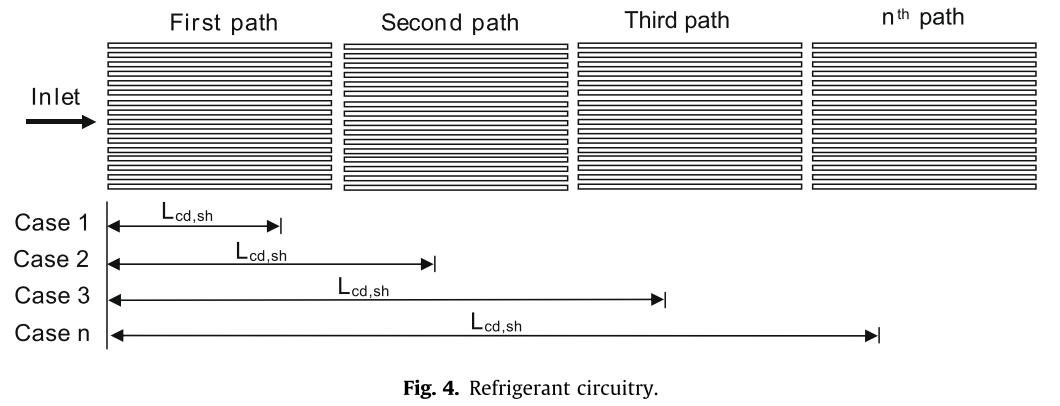
[picture p52: figure]
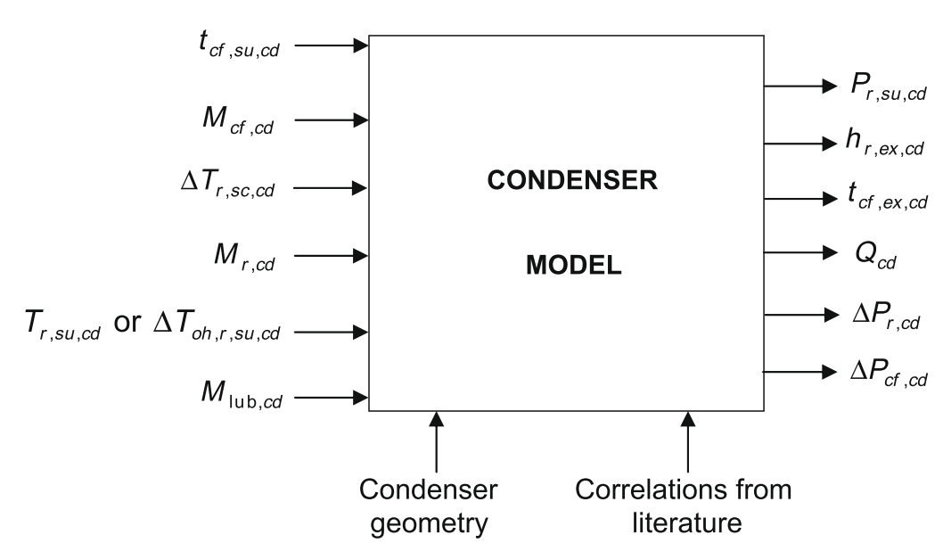
[picture p53: figure]

## Equations

REFR
OIL
AIR

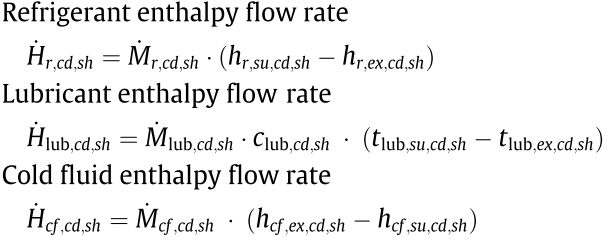
[picture p54: figure]
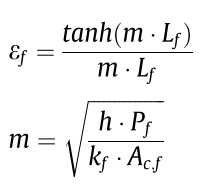
[picture p55: figure]

## Equations

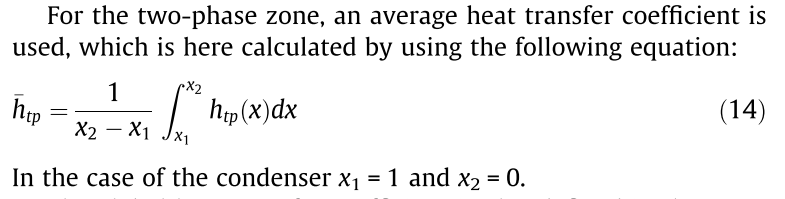
[picture p56: figure]
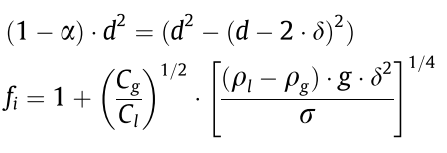
[picture p57: figure]
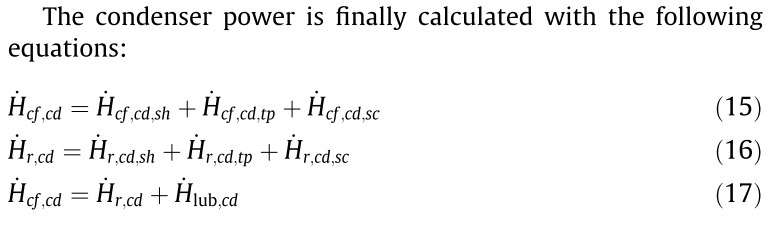
[picture p58: figure]
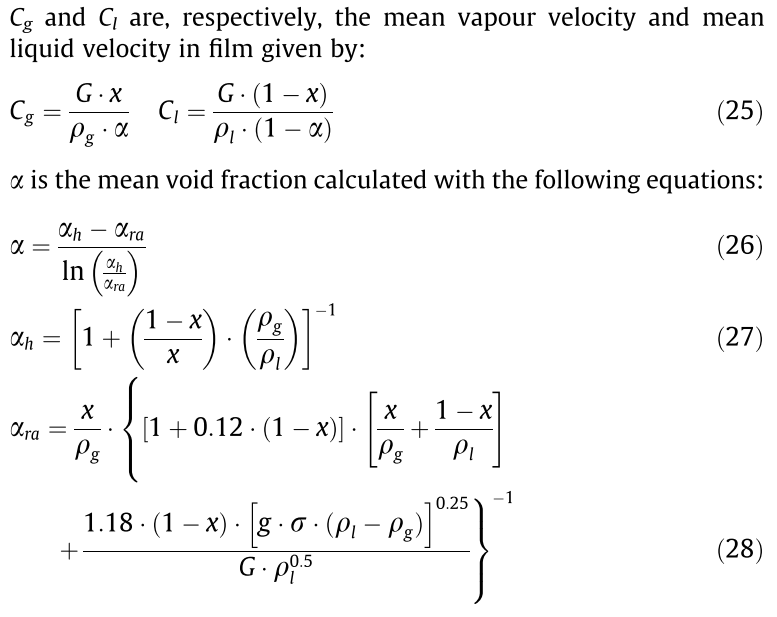
[picture p59: figure]
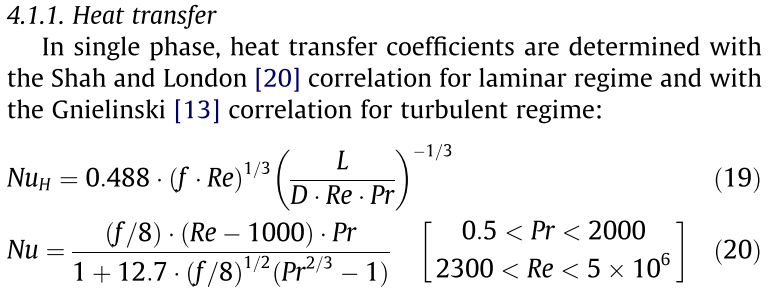
[picture p60: figure]

## ACHP – Graphical User Interface

INPUT:
Working Fluid (R290)
Superheat (5K)
Charge (3x150g)
Fin geometry
Tube geometry
Compressor polynomials

OUTPUT:

## Python Modeling
