TKlebig/TimBAgit/Presentations/Working Progress 071217.pptx

- Status Review

- 07.12.2017

Emerson Confidential and Proprietary/For internal use only

## Last week:

- Testing according to the standards not possible
  - Air velocity gradient over the outlet
  - Chamber regulation bad with lower air velocity
  - No speed at all at the lowest point
- Decision: Further tests to be set with 30pct/2fans (like in previous tests)
  - Air velocity slightly higher but with a certain velocity at the bottom measuring point
- Solder out one condenser and check for oil before flushing
- Focus on programming and modeling with Python and EES

## IDC150 analysis with Python

- Test Packages Temperatures

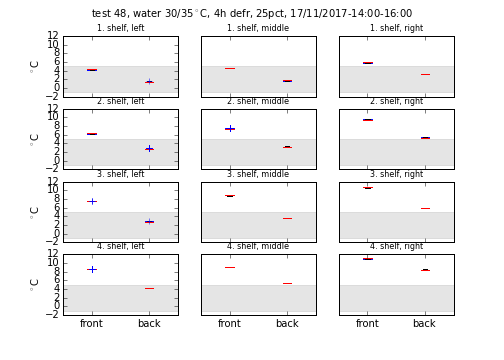
[picture p61: figure]
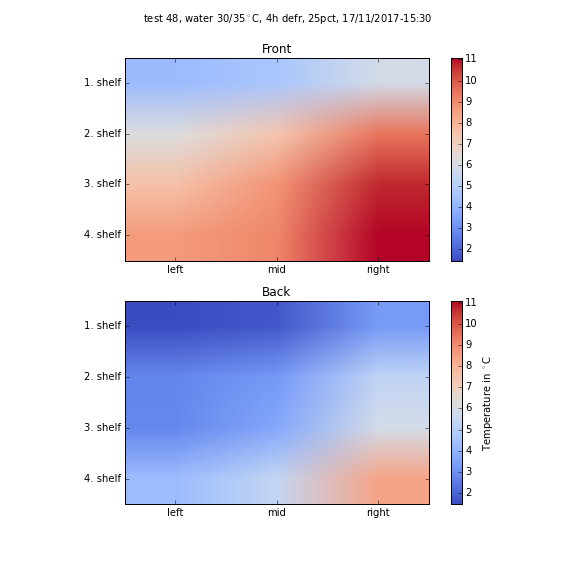
[picture p62: figure]

## IDC150 analysis with Python

- Test Packages Temperatures

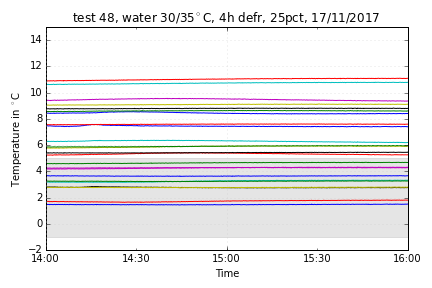
[picture p63: figure]

## IDC150 analysis with Python

- Log pH diagram plot in 2 phase region

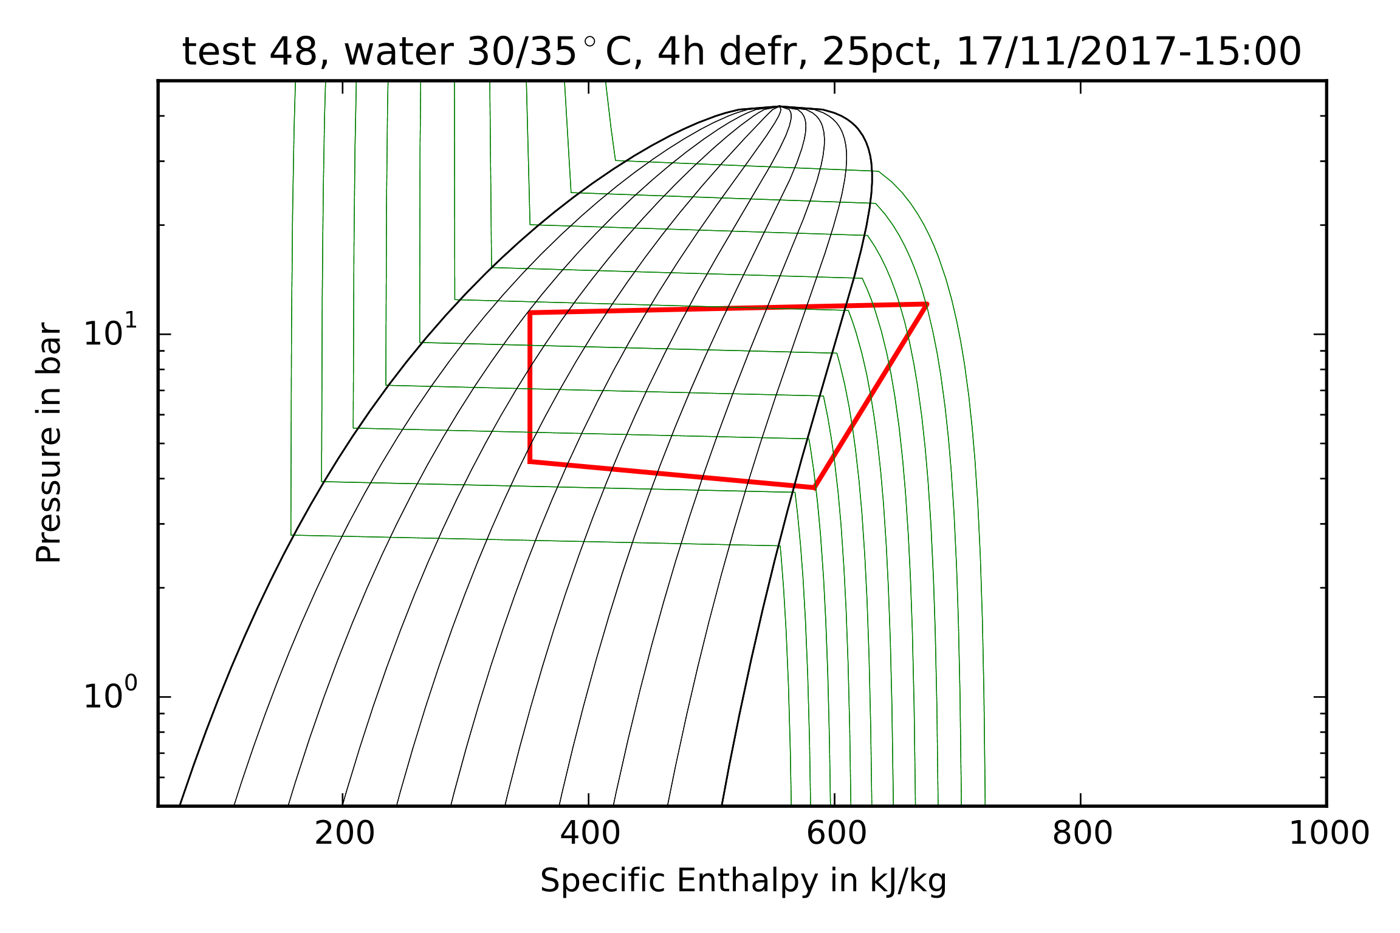
[picture p64: figure]

## IDC150 analysis with Python

- T_cond and T_evap

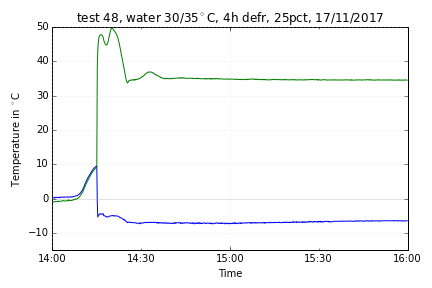
[picture p65: figure]

## IDC150 analysis with Python

- COP

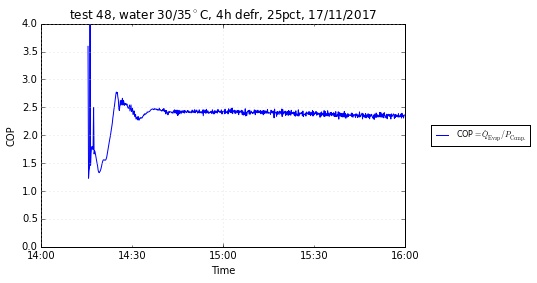
[picture p66: figure]

## To-Do:
