TKlebig/TimBAgit/Presentations/Working Progress 181217.pptx

- Status Review

- 18.12.2017

Emerson Confidential and Proprietary/For internal use only

## Last week:

- Tried to build a mathematical model for coil arrangement
  - According to HEX-Script from RWTH and VDI-Heat Atlas
- Found a method to define a test plan for practical testing and evaluation
  - Design of Experiment

## Pressure fall -> Fall of evaporating temp.

P1

Tsat,1

P2

Tsat,2

- ∆p=c∗ l/(d_i)∗(ρ∗u_i ²)/2
- u from mass flow rate, diameter and density (1)
- 1/(√c)=−2∗(log((k/d)/3.7)+2.51/(Re_(ZP) ∗√c))
- Re_(ZP) = (m_(dot) ∗d)/(eta∗(1−x∗(1−(eta_g)/(eta_L)))) VDI S904

Cp

## Cell method

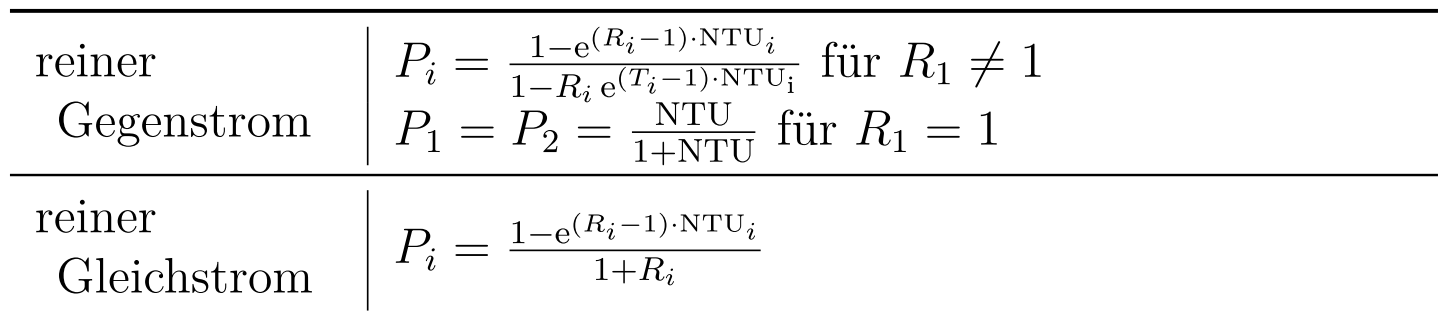
[picture p67: figure]
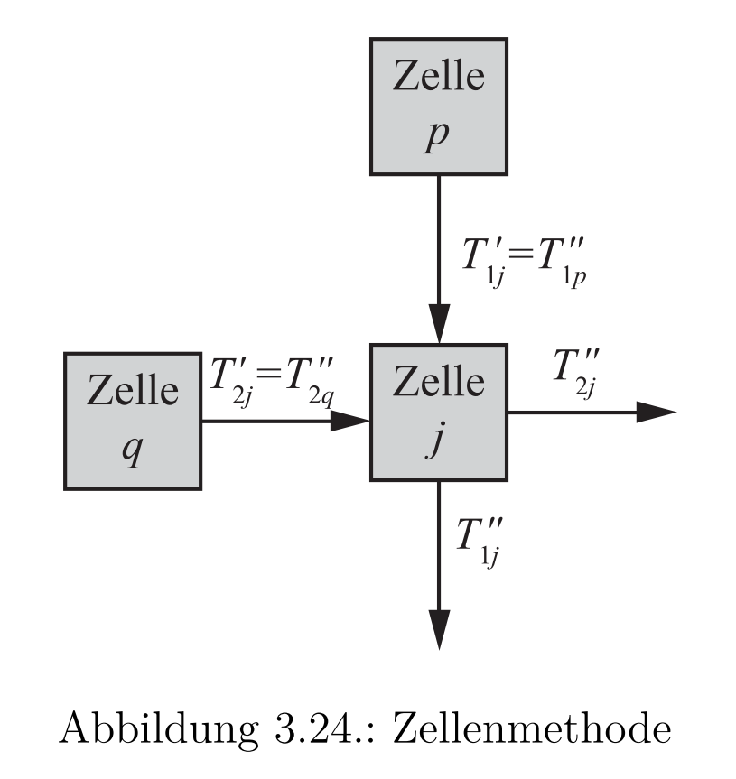
[picture p68: figure]

Heat capacity flow rate ratio:

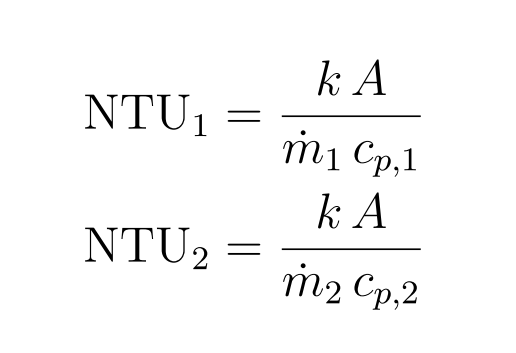
[picture p69: figure]
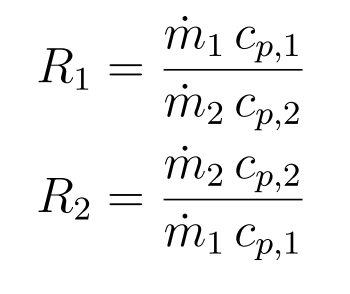
[picture p70: figure]

Air

Refr

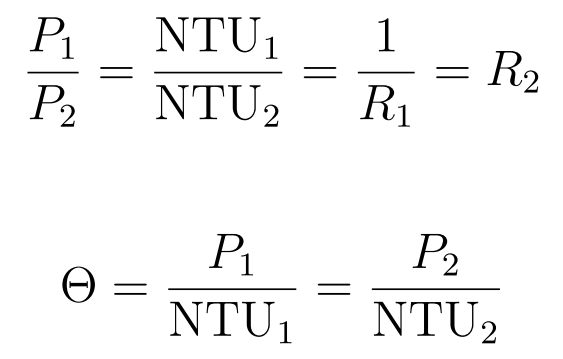
[picture p71: figure]

Thermal conductivity

kA(material), cP(P,T) → R1 , NTU → P → Tout → Q

## Slide 5

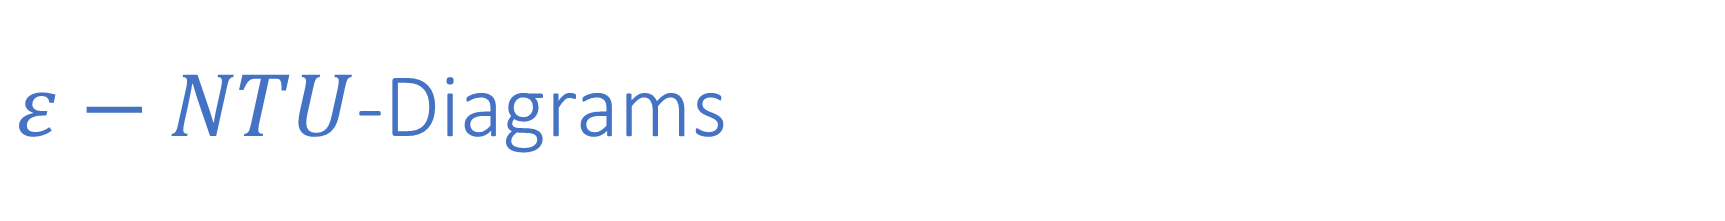
[picture p72: figure]
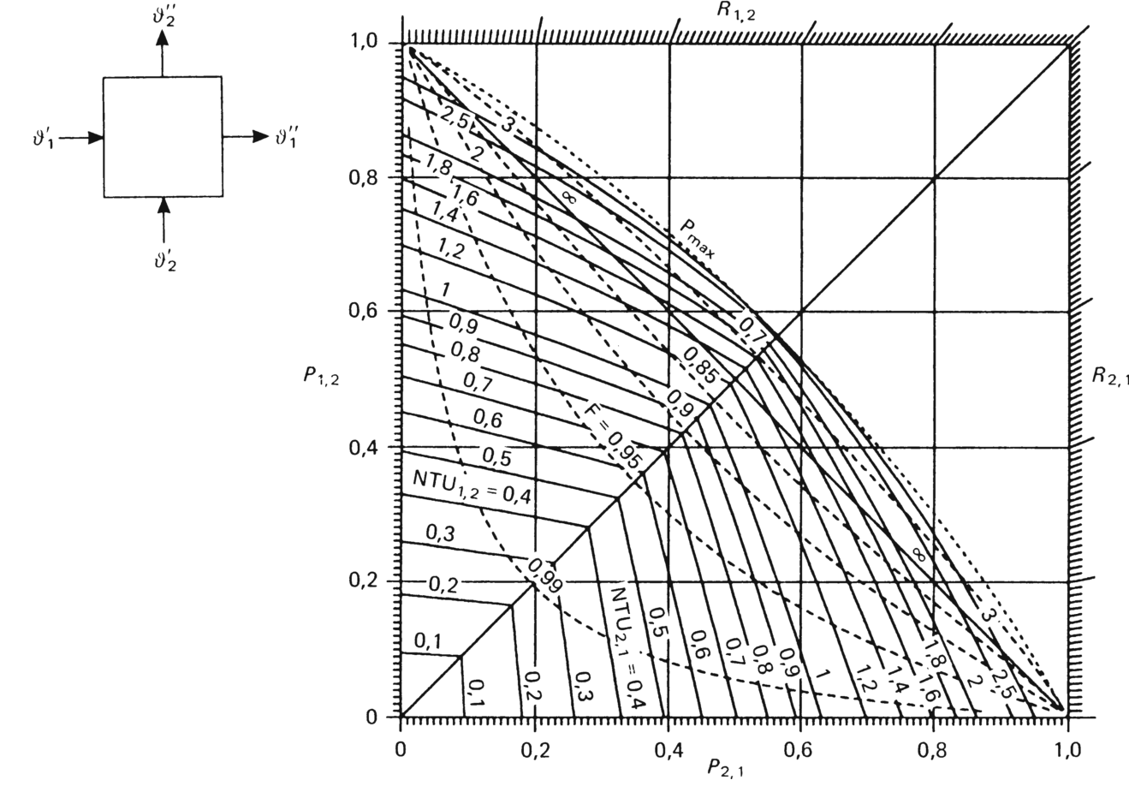
[picture p73: figure]
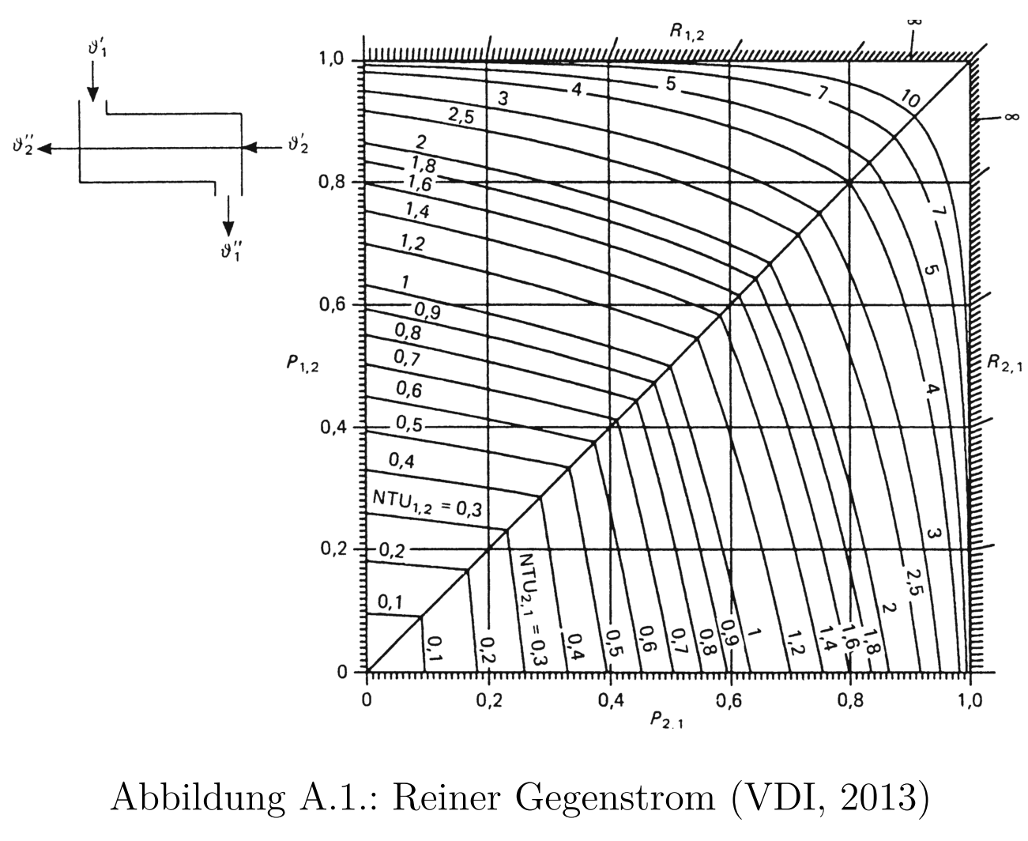
[picture p74: figure]
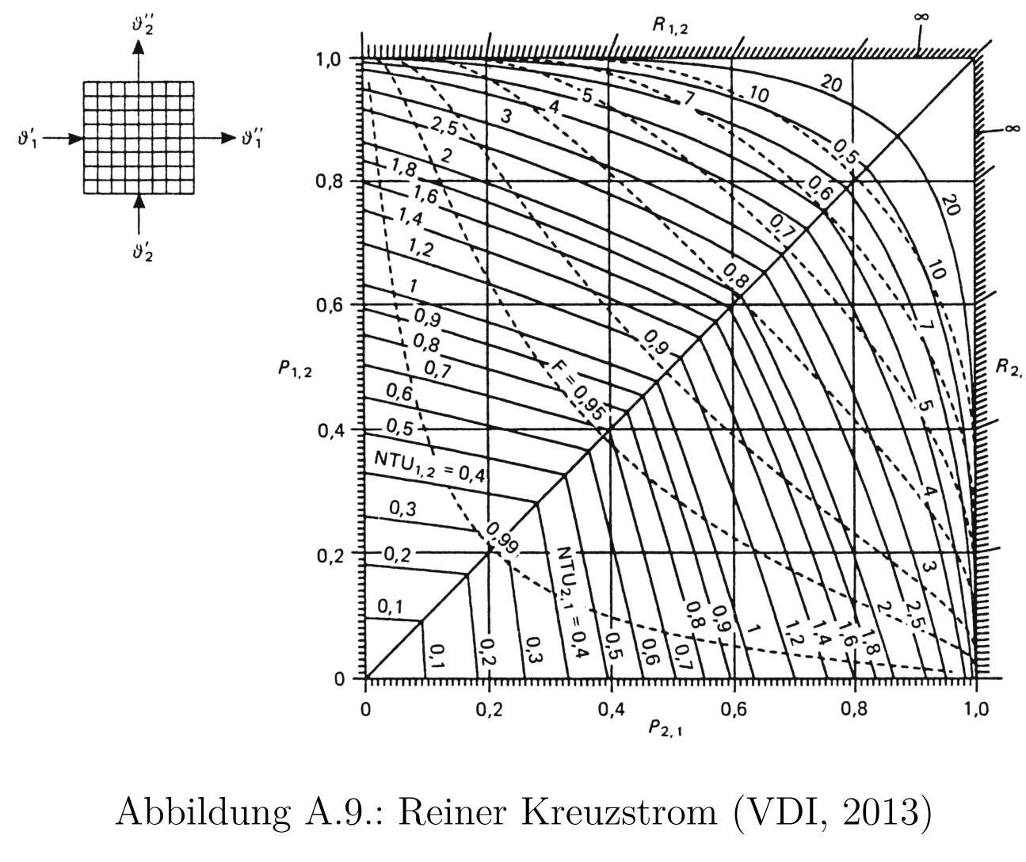
[picture p75: figure]

## Slide 6

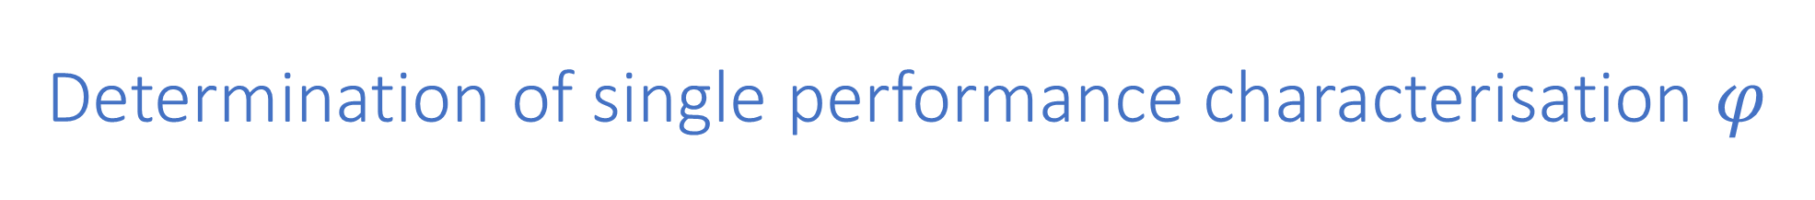
[picture p76: figure]

- Area of the heat exchanger → constant
- Ratio of the heat capacity flow rates → constant when series connection
- Heat transfer coefficient ( ∝_1 and ∝_2 ) →(uair and uref)
- Assumptions:
  - Supplytemperatures are constant
  - Mass flow rates constant
  - Geometry and heat transfer constant
  - Heat capacity flow rate for both fluids constant ( μ=1 )
  - Kappa = 0.5 (to get comparable results)

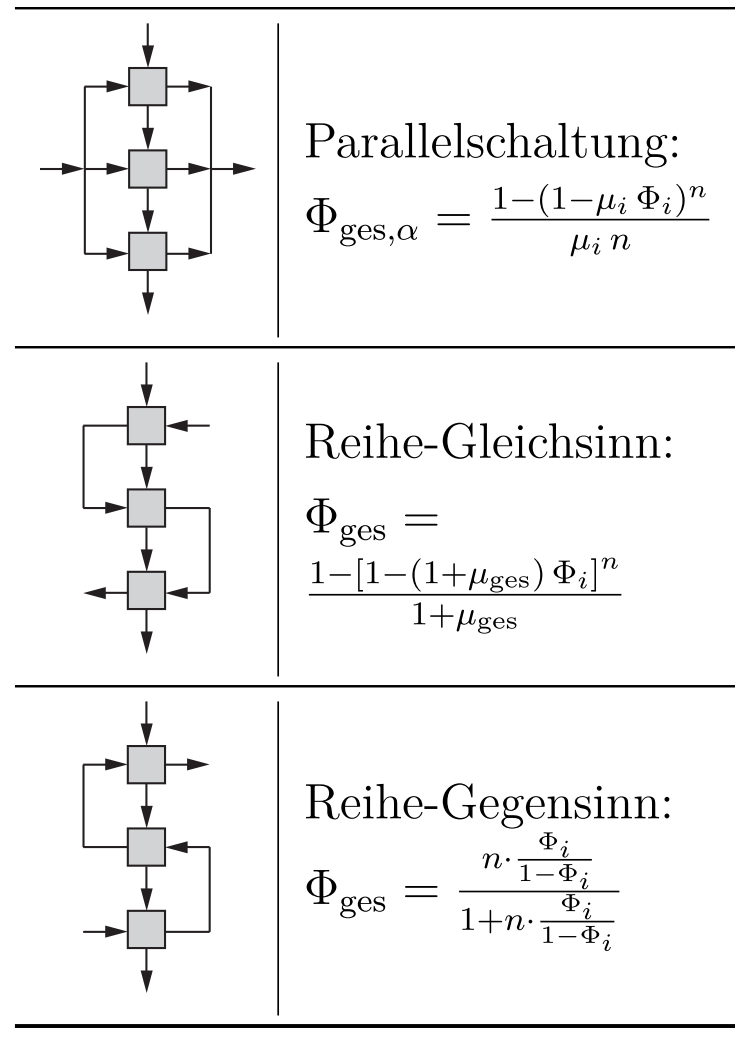
[picture p77: figure]

## Air side

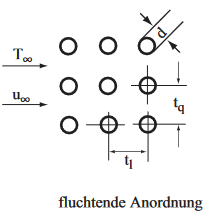
[picture p78: figure]
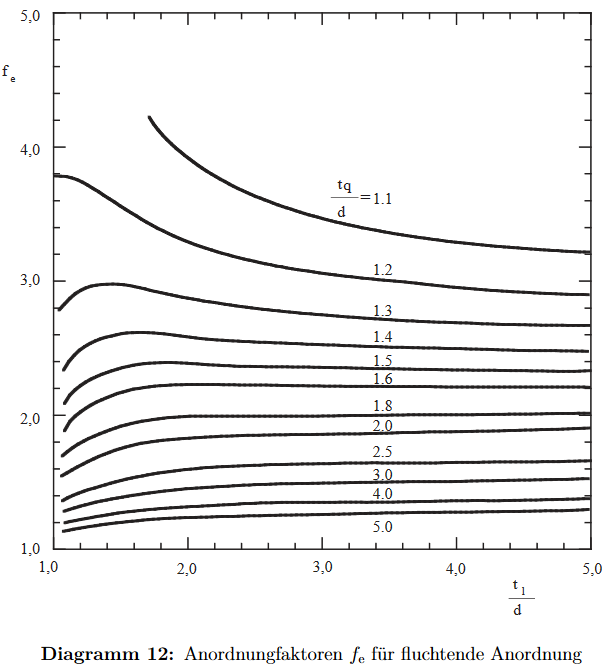
[picture p79: figure]

→ Alpha for Convection

## To-Do:

- Connect this partial models
- Impact of boiling (→ alpha)
- Impact of phase (→ moving boundary or discretization and phase check)
- Impact of fins?
