TKlebig/TimBAgit/Presentations/Working Progress 290118.pptx

- Status Review

- 29.01.2018

Emerson Confidential and Proprietary/For internal use only

## Last week:

- Further work on Python and modelling script
- Solved EES-related problems → Assume good guess values/boundaries
- Changed pressure drop equations → very good outputs
- Refilled IDC150 → test with demand defrost during the weekend

## Coil arrangements

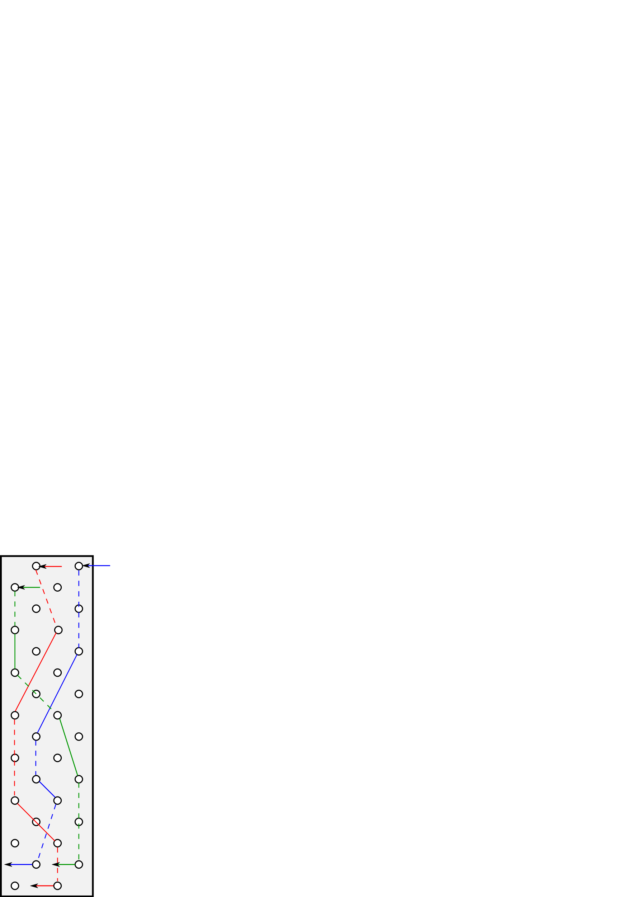
[picture p88: figure]
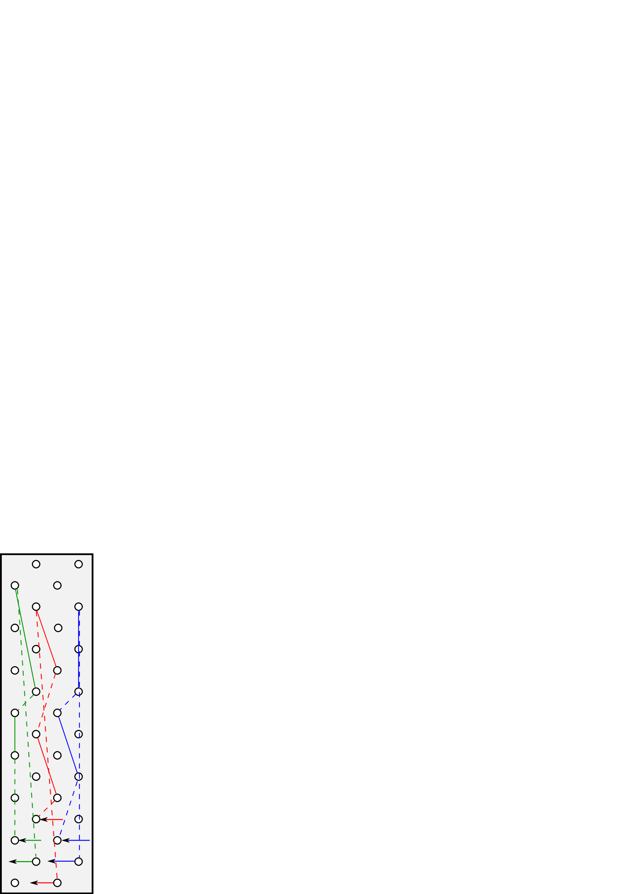
[picture p89: figure]

Evaporator Lidl-Design
- Counterflow but performs like parallel flow

Evaporator Version 2
- Mix of counterflow and parallelflow → bigger ΔT

Temperature

Temperature

ΔT

ΔT

Heigth

Heigth

## Problem in evaporator model

- Cooling capacity too small → no Superheat, ΔTair small

m_(air) → ΔTair q
C1= m *cp,refr
C2 = m air*cp,air,in
NTU = (UA/C1)
ε=1 −e^(−NTU) (for boiling)
qmax=C1* ΔT
q= qmax* ε
- UA ~ 14, NTU ~1.1, ε =0.67, q ~ 160 W
- q has to be twice as big

ΔTair

m_(air) ∗c_p

ΔT

Temperature

m_(refr) ∗c_p

Heigth

## To-Do:

- Change evaporator
