TKlebig/TimBAgit/BA/Pictures/defrostintervall.pdf

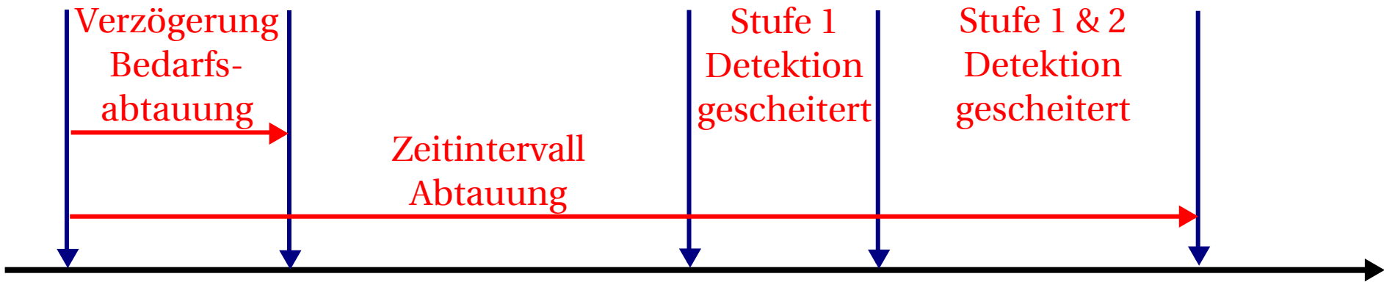
[picture p97: figure]
Stufe 1 Detektion gescheitert; Stufe 1 & 2 Detektion gescheitert; Verzögerung Bedarfs- abtauung; Zeitintervall Abtauung
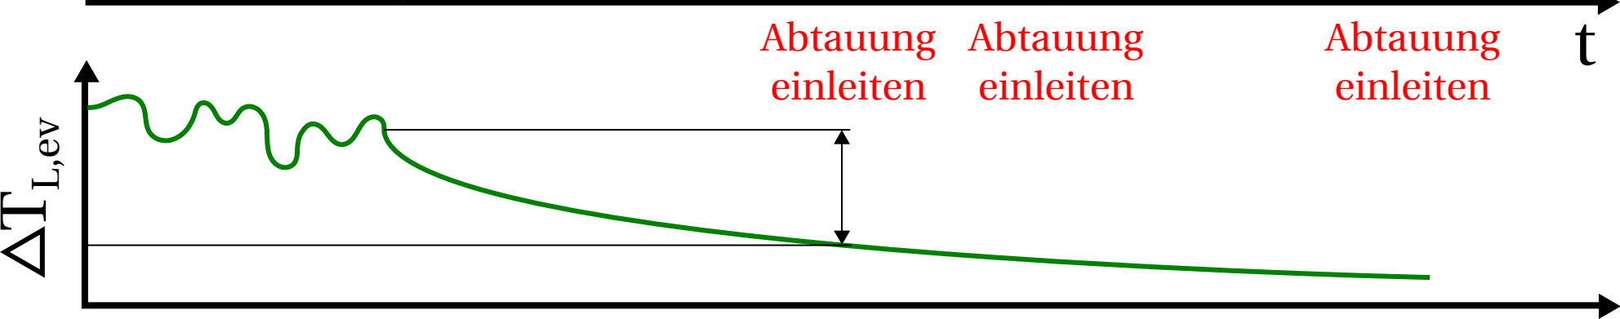
[picture p98: figure]
Abtauung einleiten

t

Ende
Abtauung

Maximale
Temperaturdifferenz

Stufe 1
Relativer
Grenzwert

Stufe 2
Absoluter
Grenzwert

Stufe 3
Intervallzeit
abgelaufen
