TKlebig/TimBAgit/BA/Pictures/Verdampfer_Gegenstrom.pdf

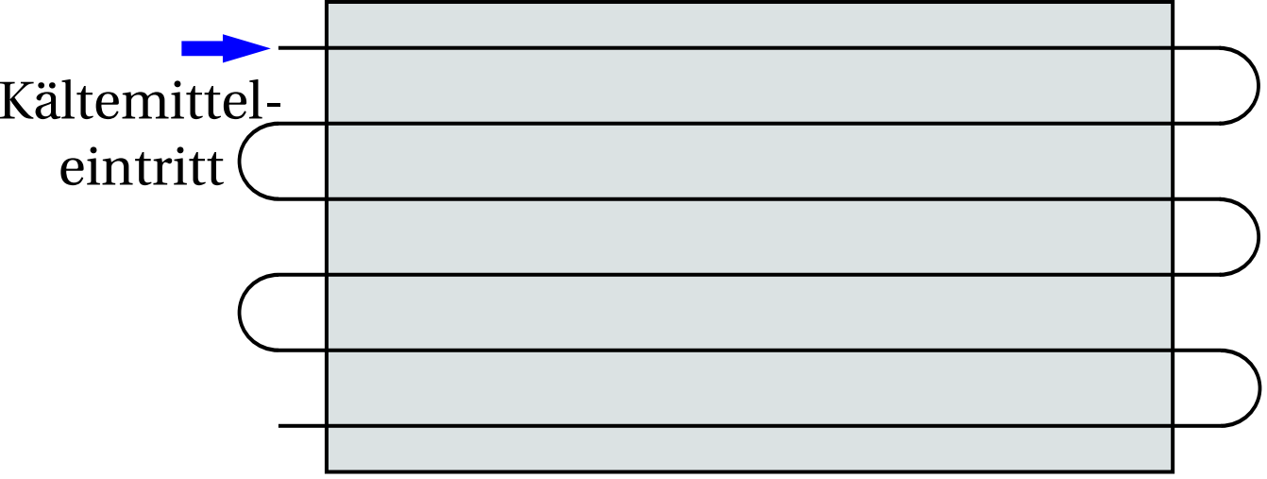
[picture p99: figure]
Kältemittel- eintritt

Lufteintritt

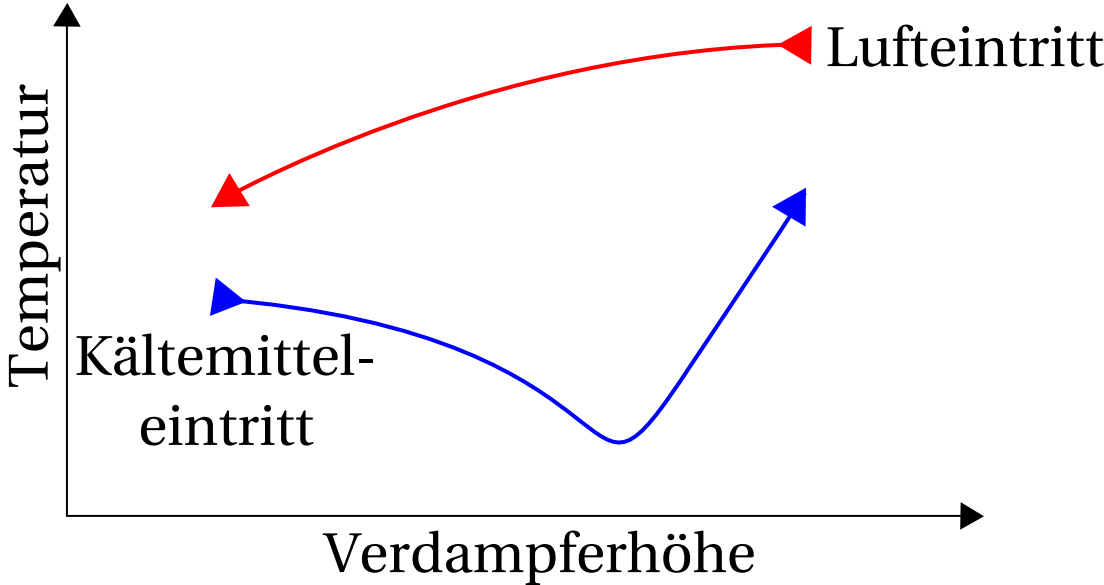
[picture p100: figure]
Kältemittel- eintritt; Lufteintritt; Temperatur; Verdampferhöhe
