TKlebig/TimBAgit/BA/Pictures/Verdampfer_Gleich-Gegenstrom.pdf

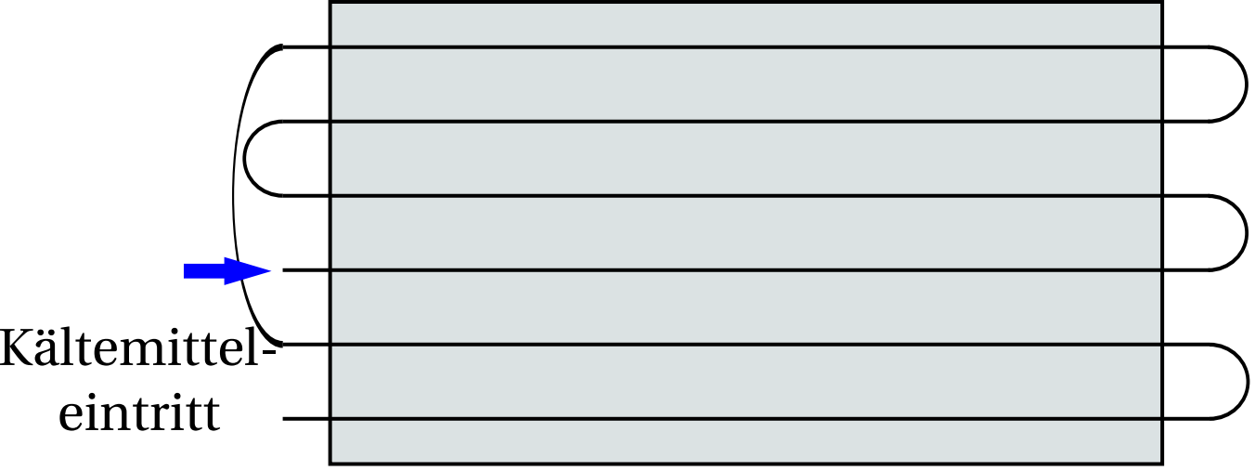
[picture p101: figure]
Kältemittel- eintritt

Lufteintritt

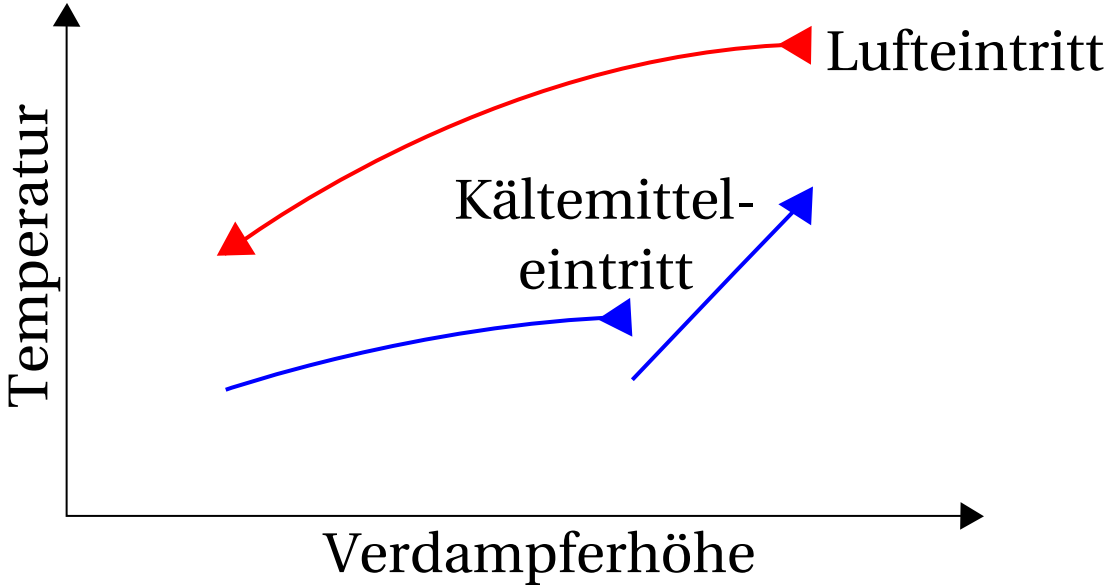
[picture p102: figure]
Kältemittel- eintritt; Lufteintritt; Temperatur; Verdampferhöhe
