TKlebig/TimBAgit/EES/Stephane/2007 - Room air conditioners - RAC modeling monobloc-summaryVTJL070709.pdf

Laboratoire
de Thermodynamique appliquée Université de Liège

Département des Sciences et Gestion de l'Environnement
Université de Liège

Bât. B49 - Parking 33
Chemin des Chevreuils, 7
B-4000 LIEGE
Belgique

Avenue de Longwy, 185
B-6700 ARLON
Belgique

Ref Nr: RAC modeling VTJL070709

MODELING OF A MONOBLOC ROOM AIR CONDITIONER

-SUMMARY-

Vladut Teodorese and Jean Lebrun Liège, 09 July 2007

### 1. Introduction

A “reference” and a “simplified” mono-bloc room air conditioner models are proposed in this paper.

The mono-bloc room air conditioner functions only in cooling mode.

In nominal cooling conditions (indoor air temperature 27°C and indoor air relative humidity 47%), the capacity is 2257 W and the EER 2.6.
The part-load operating mode is ON-OFF.

### 2. Reference model

The main equations of the reference model are already described in previous reports on RAC modelling (VTJL061207 and VTJL070704). The only difference is that the air temperature at condenser supply is the indoor air temperature.

The following assumptions are made:

- Evaporator flow rate: 318 m³/h (at 20°C and atmospheric pressure);
- Condenser flow rate: 299 m³/h (at 20°C and atmospheric pressure);
- Superheating at the condenser supply: 38 K;
- Compressor flow rate: 1.55 m³/h;
- Compressor rotation speed: 3000 tr/min;
- Evaporator fan power consumption: 10 W;
- Condenser fan power consumption: 42W;
- Electronic devices power consumption: 6 W.

Information flow diagrams and simulation results in nominal cooling mode are given in Figures 1.

Note:

- The room air conditioner performances depend only on the indoor air temperature and indoor air relative humidity;
- In the global building-RAC system simulation model, the thermal gain associated to the air infiltration (0.1125 kg/s) imposed by the condenser fan must be taken into account.

Figure 1: The mono-bloc room air conditioner model results: nominal cooling mode

MODEL

INPUTS | OUTPUTS

NOMINAL POINT PARAMETERS

Evaporator

tin = 27 | [C] | RHin = 0.47 | [-]
Patm = 101300 | [Pa]
fluid$= fluid$= | R410A

Qev = 2267 [W]

Ma,ev,n = 0.1125 | [kg/s]
Mr,ev,n = 0.01519 | [kg/s]
Ra,ev,n = 0.001208 | [K/W]
Rr,ev,n = 0.001157 | [K/W]
Dequ,cd,n = 0.002807 | [m]
∆T,sh = 5 | [K]
Nfan,ev = 1 | [-]
ta,ex,ev = 11.32 [C] | RHa,ex,ev = 0.9995 [-]

Mw,condens = 0.0002238 [kg/s]

Vs,cp,max = 0.00000862 | [m³]
rv,in,cp = 3.6 | [-]
αcp = 0.3 | [-]

Wcp = 809.8 [W]

Xcp = 1 | [-]
tout = 35 | [C]
Rm,ev = 0.00001 | [K/W]
∆T,sc = 5 | [K]

ta,ex,cd = 57.13 [C]

Ma,cd,n = 0.1125 | [kg/s]
Mr,cd,n = 0.01519 | [kg/s]
Ra,cd,n = 0.002481 | [K/W]
Rm,cd = 0.00001 | [K/W]
Rr,cd,n = 0.002377 | [K/W]

Qcd = 3057 [W]

Compressor | Condenser
Dequ,ev,n = 0.002576 | [m]
Nfan,cd = 1 | [-]

Condenser fan & control

tcd,set = 25 | [C] | gain = 0.05 | [-]
ta,ex,fan,ev = 27.19 [C] | RHa,ex,fan,ev = 0.4648 [-]

ta,ex,fan,cd = 57.35 [C]

Qcooling = 2257 [W]

W = 868.1 [W]

COP | COP = 2.599 [-] cp = 2.799 [-]
Nrot = 3000 | [rpm]

SHRev = 75.57 [%]

Mr,ev = 0.01495 [kg/s]

∆p,a,ev,nom = 25 [Pa]

Evaporator fan and air loop
Sloop,equ,nom = 0.02528 | [m²]
α0,fan,ev = 0.479 | [-]
α1,fan,ev = -5.516 | [-]
α2,fan,ev = 41.97 | [-]
α3,fan,ev = -121 | [-]
β0,fan,ev = 0.06182 | [-]
β1,fan,ev = -0.606 | [-]
β2,fan,ev = 6.55 | [-]
β3,fan,ev = -18.03 | [-]
Dfan,ev = 0.315 | [m] Aex,fan,ev = 0.0779 | [m²]
rpmfan,ev = 950 | [rpm]

Ma,ev = 0.1051 [kg/s]

Wfan,ev = 10.02 [W]

Sequ,a,cd,nom = 0.00739 | [m²]
ffactor = 0 | [-]

Ma,cd = 0.09882 [kg/s]

Wfan,cd = 42.23 [W]

α0,fan,cd = 0.479 | [-]
α1,fan,cd = -5.516 | [-]
α2,fan,cd = 41.97 | [-]
α3,fan,cd = -121 | [-]
β0,fan,cd = 0.06182 | [-]
| β1,fan,cd = -0.606 | [-]
β2,fan,cd = 6.55 | [-]
| β3,fan,cd = -18.03 | [-]
Aex,fan,cd = 0.0779 | [m²] Dfan,cd = 0.315 | [m]
rpmfan,cd = 1600 | [rpm]

Va,mh,ev = 327.5 [m³/h] Va,mh,ev,20 = 318.1 [m³/h]

Va,mh,cd = 338.5 [m³ V | /h] a,mh,cd,20 = 299 [m³/h]

tcd = 51.38 [C]

tev = 10.08 [C]

Operating_mode= Operating_mode= Cooling_mode

RHout = 0.5 [-]

Evaporator

Condenser

Power consumtions

Outdoor conditions | Performances

Indoor Unit

Outdoor Unit

Indoor conditions

Speed_fan_indoor_unit$= Medium

Air-conditioning unit

Monobloc

Qheat = 3079 [W]

Hzcp = 50 [tr/s]

General Inputs

Variable Inputs

Mice = 0 [kg/s] Qice = 0 [W]

### 3. Simplified modelling in cooling mode

The simplified model use the same set of equations and hypotheses as before (VTJL061207 and VTJL070704).

The nominal cooling capacity and the corresponding electrical consumption in full load are expressed as polynomial functions of one independent variable:
The indoor air temperature, associated to a reference relative humidity (50%).
These functions are corrected in the same way as for other RAC’s, in order to take into account of the actual relative humidity.

Part load correction factor

In part load, we suppose that the RAC is working in ON-OFF. This control mode generates some performances losses due to:

- frequent start-up of the compressor;
- system instabilities at the start-up (the steady-state condition are generally achieved after 5 – 10 min);
- (small) auxiliary power consumption (6W for the electronic device).

On the basis of literature information gathered in Task 4, we suppose that the system performance degradation can be described by the curves given in Figure 2.

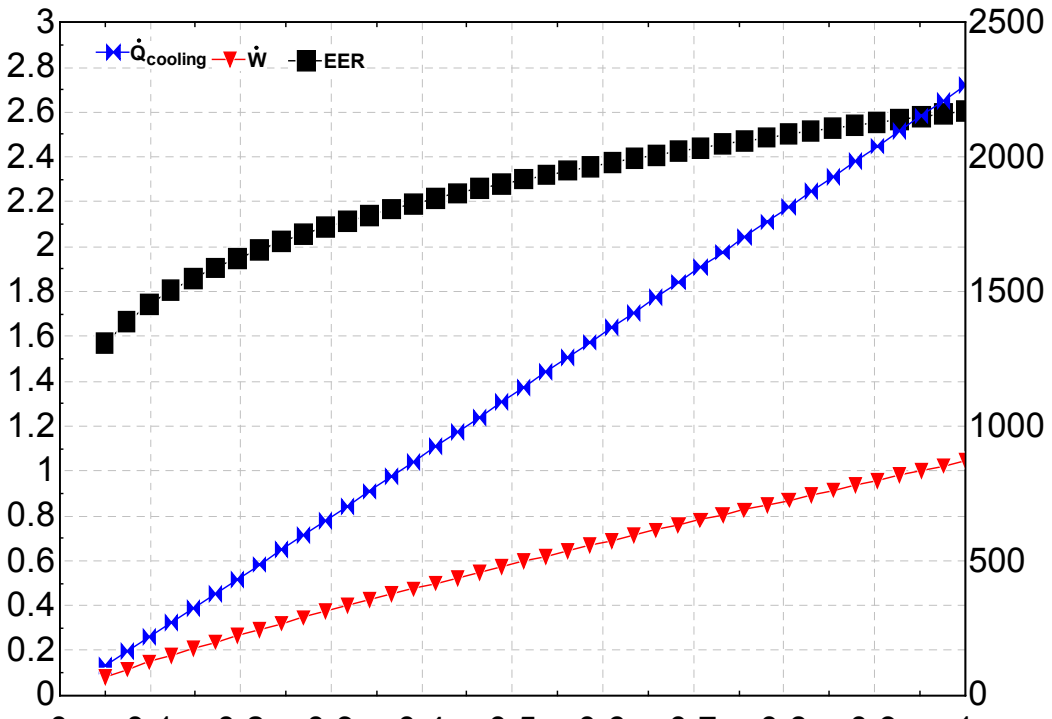
[picture p103: figure]
EER; Qcooling

Figure 2: Part load system EER

0 | 0.1 0.2 0.3 0.4 0.5 0.6 0.7 0.8 0.9 | 1
| ratiocooling,capacity [-]

## EER [-]

Cooling capacity and total power consumption [W]

The empirical model flow chart is presented in Figure 3:

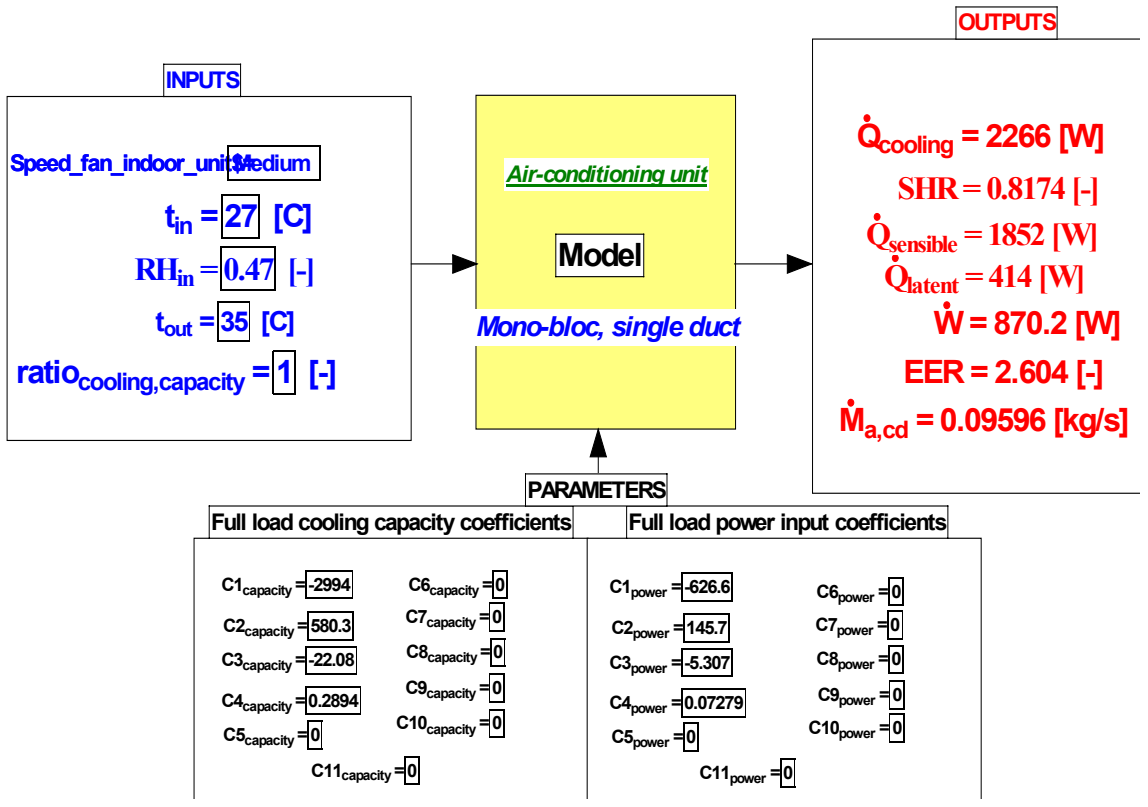
[picture p104: figure]
C10capacity = 0; C11capacity = 0; C1capacity = -2994; C2capacity = 580.3; C3capacity = -22.08; C4capacity = 0.2894; C5capacity = 0; C6capacity = 0; C7capacity = 0; C8capacity = 0; C9capacity = 0; Full load cooling capacity coefficients; Full load power input coefficients; C10power = 0; C11power = 0; C1power = -626.6; C2power = 145.7; C3power = -5.307; C4power = 0.07279; C5power = 0; C6power = 0; C7power = 0; C8power = 0; C9power = 0; PARAMETERS; Model; Qcooling = 2266 [W]; tin = 27; EER = 2.604 [-]; INPUTS; OUTPUTS; Air-conditioning unit Speed_fan_indoor_unit$= Medium; RHin = 0.47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

Figure 3: Empirical model flow chart (nominal cooling mode)

### 3.1 Simulation results

The simulation results are shown in Figure 4 to 6.

Figure 4: Cooling capacity as function of indoor air temperature (medium fan speed; RH_in= 47%)

Figure 5: Total power consumption as function of indoor air temperature (medium fan speed; RH_in= 47%; full load)

10 12 14 16 18 20 22 24 26 28 30 32 34 36 38 40

2000

2100

2200

2300

2400

2500

2600

2700

Indoor air tem perature [C]

Cooling capacity [W]

n o m in al | p o in t | -

10 12 14 16 18 20 22 24 26 28 30 32 34 36 38 40

400

500

600

700

800

900

1000

1100

1200

### Indoor air tem perature[C]

### Total power consumption [W]

n o min al p oin t -

Figure 6: RAC EER as function of indoor air temperature (medium fan speed; RH_in= 47%; full load)

10 12 14 16 18 20 22 24 26 28 30 32 34 36 38 40

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
## Indoor air temperature[C]

## EER [-]

nominal point -
