TKlebig/TimBAgit/EES/Stephane/2007 - Room air conditioners - RAC modeling VTJL0612081.pdf

Laboratoire
de Thermodynamique appliquée Université de Liège

Département des Sciences et Gestion de l'Environnement
Université de Liège

Bât. B49 - Parking 33
Chemin des Chevreuils, 7
B-4000 LIEGE
Belgique

Avenue de Longwy, 185
B-6700 ARLON
Belgique

Ref Nr: RAC modeling VTJL061207

MODELING OF A ROOM AIR CONDITIONER

Vladut Teodorese and Jean Lebrun Liège, 7 December 2006

### 1. Introduction

A “reference” and a “simplified” room air conditioner models are proposed in this paper.
Two examples of (“medium” and “high” classes) “split” air conditioners are considered hereafter. Both units have a nominal cooling capacity of 2500 W. In both cases also, the compressor is driven through an inverter.
The mains characteristics of these two units are presented in Table 1. Focus is given hereafter to the cooling mode only.

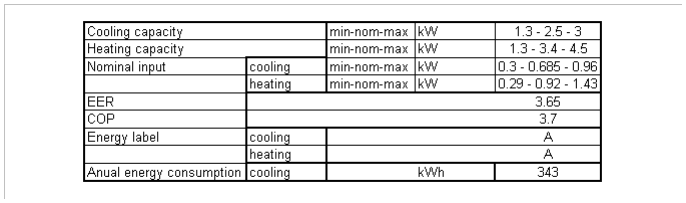
[picture p105: figure]

a) medium class

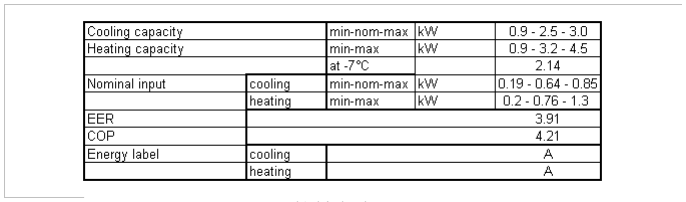
[picture p106: figure]

b) high class
Table 1: Main characteristics of the two air conditioners

### 2. Reference models

A so-called “reference” (“detailed”, “mechanistic”, or “mother”) model is, as much as possible, based on real physics. It’s an assembly of meaningful equations, describing the dominant physical phenomena, as they are understood and as they can be represented. But the model is nevertheless application-oriented: its realism is only required in a given domain of use and for relevant (input and output) variables.
The reference model of a room air conditioner is built by assembling several component models described hereafter.

### 2.1 Heating and dry cooling coil

A same heating and dry cooling coil model is used to simulate both the condenser and the evaporator in dry regime.
The coil is supposed here to behave as a fictitious semi-isothermal heat exchanger. Laminar and turbulent regimes are considered on air and “refrigerant” sides respectively. The output variables are the coil thermal power and the exhaust temperatures of both fluids (air and refrigerant).
The parameters are: the nominal flow rates of both fluids and the three nominal thermal resistances (air side, metal and refrigerant side).
The input variables are the supply conditions on both sides of the coil.
The main equations of this model are presented hereafter.

Air side heat balance:

Qev,dry = Ma,ev · cpa,su,ev · ( ta,su,ev – ta,ex,ev,dry)
Refrigerant side heat balance:

Qev,dry = Mr,ev,dry · ∆h,ev,dry

∆h,ev,dry = hr,ex,ev,dry – hr,su,ev,dry
Heat transfer through the (fictitious) semi-isothermal-flow heat exchanger:

Qev,dry = ε ev,dry · Ca,ev,dry · ( ta,su,ev – tev,mean,dry )

Ca,ev,dry = Ma,ev · cpa,su,ev

ε ev,dry = 1 – exp ( – NTUev,dry)

NTUev,dry =

AUev,dry

Ca,ev,dry
Definition of a weighted average temperature on the refrigerant side of the evaporator:

tev,mean,dry =

tev,dry · ( hr,sat,ex,ev,dry – hr,sat,su,ev,dry) + tr,ex,ev,dry · ( hr,ex,ev,dry – hr,sat,ex,ev,dry)

hr,sat,ex,ev,dry – hr,sat,su,ev,dry + hr,ex,ev,dry – hr,sat,ex,ev,dry
with

tev,dry =

tr,su,ev,dry + tr,sat,ex,ev,dry
2

The global heat transfer coefficient of this heat exchange is defined by considering three thermal resistances in series:

AUev,dry =

1

Ra,ev + Rr,ev,dry + Rm,ev
Both convective resistances are defined by reference to nominal values:
Rr,ev,dry = Rr,ev,n · | Mr,ev,n
| Mr,ev,dry

0.8

Ra,ev = Ra,ev,n · | Ma,ev,n
| Ma,ev

0.6

### 2.2 Cooling coil in dry and wet regimes

This model is based on Merckel theory (combination of latent and sensible heat transfer), with a very slight adaptation: air enthalpy is here replaced by wet bulb temperature as total heat transfer potential).
Jim Braun’s hypothesis is also used (replacing partially dry-wet by completely dry or completely wet regimes).

Selected outputs are:
- Coil “emissions” (total, sensible and latent cooling power);
- Air state at coil exhaust (temperature, moisture content and relative humidity);
- Water condensate flow rate;
- Refrigerant temperature at coil exhaust.

The parameters and the input variables are the same as in dry regime.

The equations already developed are transposed to the wet regime by substituting to the air a fictitious ideal gas, whose temperature is the actual air wet bulb temperature.
The air side heat balance and heat transfer equations become:

Qev,wet = Ma,ev · ( ha,su,ev – ha,ex,ev,wet + ( wa,su,ev – wa,ex,ev,wet) · cw,ev · tc,ev,wet)

Qev,wet = ε ev,wet · Ca,ev,wet · ( twb,su,ev – tev,mean,wet )

The air state at the evaporator exhaust is calculated, according to a classical ASHRAE procedure, by identifying fictitious contact effectiveness (i.e. by considering a fictitious air side isothermal surface):

ε c,ev,wet =

ha,ev – hb,ev

ha,ev – hc,ev,wet

ε c,ev,wet =

wa,ev – wb,ev

wa,ev – wc,ev,wet

ε c,ev,wet =

wa,ev – wb,ev

wa,ev – wc,ev,wet

NTUc,ev,wet =

1

Ra,ev · Ca,ev

According to Jim Braun’s proposal, the (dry or wet) regime giving the highest cooling power is selected as nearest to reality:

Qev = If (Qev,dry , Qev,wet , Qev,wet , Qev,dry , Qev,dry )

The sensible power is the power that would be obtained with same supply and exhaust air temperatures, but without any change of air water content:

Qev,sens = Ma,ev · cpa,su,ev · ( ta,su,ev – ta,ex,ev)

The latent power is defined by difference between total and sensible powers:

Qev,lat = Qev – Qev,sens

### 2.3 Compressor

The model used here is well adapted to the simulation of most rotary compressors. It includes heat transfer at the supply, at the exhaust and to the ambient. The pressure drop during the suction and discharge are neglected, as well as any lubricant circulation. The compression is considered as isentropic up to the internal pressure and then at constant volume until the exhaust pressure.
The conceptual schema of the compressor is presented in Figure 1. The evolution of the refrigerant is decomposed into four steps:
1) Heating-up (su → su1).
2) Isentropic compression (su1 → in)
3) Compression at a fixed volume (in →ex1).
4) Cooling down (ex1→ex)

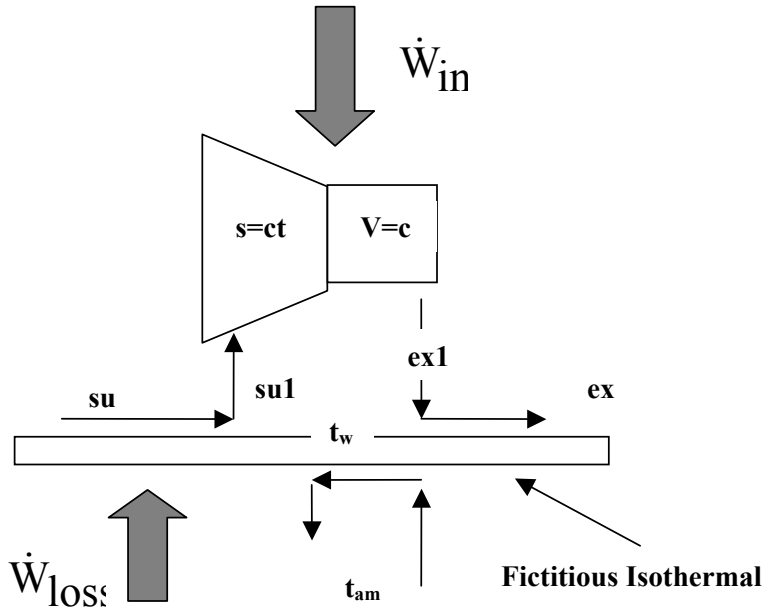
[picture p107: figure]
tam; Win &; Wloss &; Fictitious Isothermal

Figure 1: Conceptual scheme of the compressor model

The evolution of the refrigerant state through the compressor is presented in Figure 2:

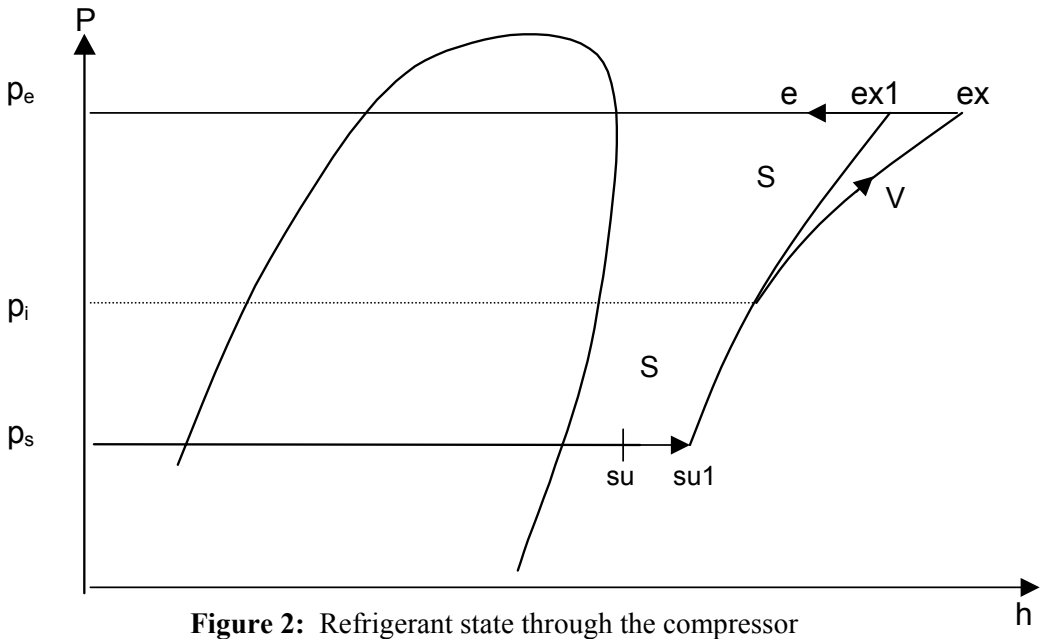
[picture p108: figure]

Figure 2: Refrigerant state through the compressor

Refrigerant mass flow rate

The refrigerant mass flow rate is given by:

Mcp =

Vs,cp
vsu1,cp
with

Vs,cp = Vs,cp,max · Xcp

and with

- M_dot_cp - refrigerant mass flow rate | [kg/s];
- v_ su1_cp – refrigerant volume at the compressor supply after overheating [m³/kg];
- V_dot_s_cp - refrigerant compressor flow rate | [m³/s];
- V_dot_s_cp_max - maximal refrigerant flow rate | [m³/s];
- X_cp – load factor (control variable) | [-].

Heat transfer

The different heat exchanges are represented by reference to a unique isothermal wall, which is supposed to be in contact with the refrigerant at both (supply and exhaust) sides and with the ambient. Electromechanical losses are also supposed to be directly transmitted (as equivalent heat) to this wall (Figure 1).
The supply wall-to-refrigerant heat transfer can be described through the following equations:

hsu1,cp – hsu,cp =

Qsu,cp
Mcp

Qsu,cp = ε su,cp · Csu,cp · (tw ,cp – t su,cp )

Csu,cp = Mcp · cp,su,cp

ε su,cp = 1 – exp(–NTUsu,cp )

NTUsu,cp =

AUsu,cp
Csu,cp

with
- Q_dot_su_cp – supply heat transfer | [W];
- h_su_cp – refrigerant enthalpy at the compressor supply | [J/kg];
- h_su1_cp – refrigerant enthalpy after heating-up | [J/kg];
- c_p_su_cp – refrigerant specific heat | [J/kg-K];
- ε_su_cp - supply heat transfer effectiveness | [-];

- C_dot_su_cp - thermal capacity flow rate | [W/K];
- t_w_cp - fictitious wall uniform temperature | [°C];
- t_su_cp – refrigerant temperature at compressor supply | [°C];
- NTU_su_cp - number of transfer units | [-];
- AU_su_cp – supply heat transfer coefficient | [W/K].

The same set of equations is used for the exhaust heat transfer.
The ambient-to-compressor heat transfer is given by:

Qamb,cp = AUamb,cp · (tamb,cp – tw ,cp )

with
- t_amb_cp – “ambient” temperature (corresponding to the air temperature at
condenser exhaust in the present case!) | [°C];
- AU_amb_cp - fictitious ambient heat transfer coefficient | [W/K].

Wall balance

The wall balance is give by the following relationship:

Wloss,cp – Qsu,cp – Qex,cp + Qamb,cp = 0

with
- W_dot_loss_cp - compressor electro-mechanical loss | [W];
- Q_dot_ex_cp – wall-to-refrigerant heat transfer | [W].

Exhaust conditions

The compression process is decomposed into two steps:
1) An adiabatic, reversible and therefore also isentropic compression, up to the adapted internal pressure;
2) An isochoric evolution (compression or expansion) until the exhaust pressure.

The refrigerant enthalpy after this process can be calculated as follows:

hex1,cp = hsu1,cp + win,cp

with

win,cp = win1,cp + win2,cp

win1,cp = hin,cp – hsu1,cp

hin,cp = h(fluid$ , s=sin,cp , v= vin,cp )

sin,cp = ssu1,cp

vin,cp =

vsu1,cp
rv,in,cp

win2,cp = vin,cp · (pex1,cp – pin,cp )

with:
- h_ex1_cp - refrigerant enthalpy after isochoric compression | [J/kg];
- w_in_cp - internal compression work | [J/kg];
- w_in1_cp - isentropic work | [J/kg];
- h_in_cp - refrigerant enthalpy after isentropic compression | [J/kg];
- s_in_cp – corresponding entropy | [J/kg-K];
- v_in_cp –corresponding volume | [m³/kg];
- w_in2_cp – isochoric work | [J/kg];
- p_in_cp – internal pressure | [Pa];
- p_ex1_cp –pressure after isochoric evolution | [Pa];
- r_v_in_cp – compressor internal volume ratio ( parameter to be identified) | [-].

Prediction of the compressor power

The compressor power can be split into two terms:

Wcp = Win,cp + Wloss,cp

with
- W_dot_in_cp – internal power | [W];
- W_dot_loss_cp – electro-mechanical loss | [W]

The electro-mechanical loss can also be split into two terms:

Wloss,cp = Wloss0,cp + αcp · Win,cp

with
- W_dot_loos0_cp – constant electro-mechanical compressor loss | [W];
- α_ cp – loss factor (parameter to by identified) | [-];
2.4. Fan(s) model

The fans are currently modelled with the help of similarity variables: flow, pressure and power factors. These variables can be correlated to each other by polynomial expressions.
The main output of a fan model is the flow rate expressed here in “specific” value (in kg/s of dry air), as usually in air conditioning. Other outputs are: flow rate and pressure factors, exhaust air speed, total pressure difference, isentropic power and isentropic temperature increase across the fan (these two last outputs can be used as checking information).

The fan is supposed to be characterised by the diameter of its impeller (scale variable), the exhaust area and the coefficients of two polynomial correlations.

Supply air conditions (temperature, pressure and moisture content), rotation speed and supply-to-exhaust static pressure difference are taken as input variables.

This gives an information flow diagram such as presented in Figure 3 (NB: the numbers contained in this diagram have nothing to do with the fans considered here).

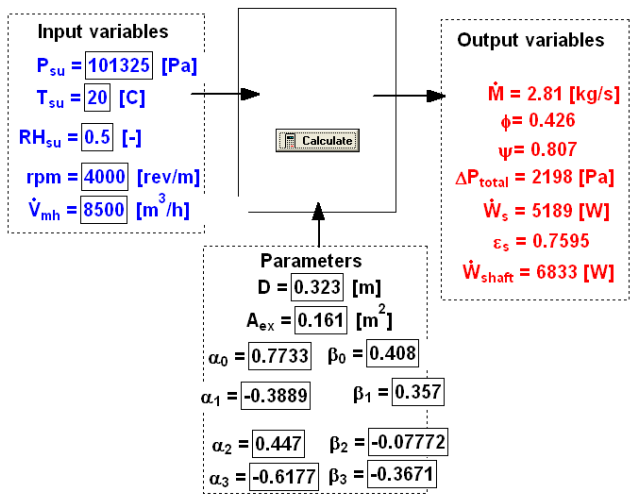
[picture p109: figure]

Figure 3: Example of fan model

The equations of this model are built on the basis of the definitions of two (flow and pressure) similarity factors:

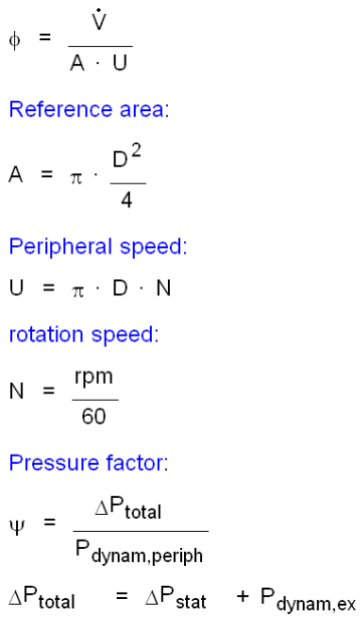
[picture p110: figure]

Two dynamic pressures are considered: one at the exhaust and the other one at the periphery of the impeller:

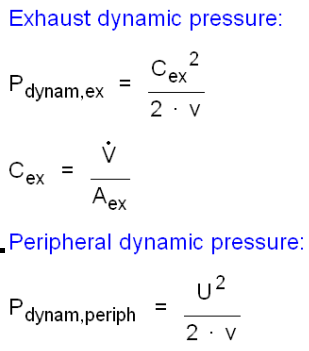
[picture p111: figure]

The other non-dimensional variables considered are the isentropic effectiveness and the power factor:

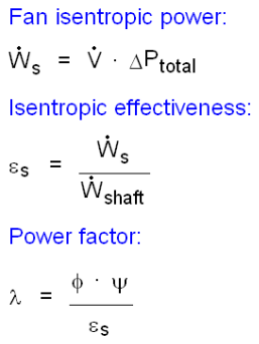
[picture p112: figure]

The three factors are inter-correlated through polynomial laws such as:

This is an “orphan” model (not generated from a reference model), but from long time well validated and easy to tune…
Polynomials are fitted to manufacturer’s performance data. Attention is paid to the distinction between total and static pressures: manufacturers present fan performance in terms of total pressure rise, whereas the measurements are usually made in terms of static pressures.

### 3. Tuning, validation and evaluation of reference models

3.1 How to make it?

Even if “mechanistic”, any component or system model has to be tuned before attempting to validate it.
The validation consists in verifying that, after having been tuned, the model can well reproduce the behaviour of the component considered in the whole domain of use.
The output of the validation procedure is an accuracy estimate (i.e. a correlation analysis between simulated and experimental data).
The quality evaluation must integrate, not only the validation results, but other considerations, such as tuning “easiness” (according to how much information is required and how much “skill” is required to use this information) and model “robustness” (i.e. its ability to stay realistic in all circumstances, even when going outside its tuning domain…)
One example of “tuning” and validation is presented hereafter.

### 3.1. Tuning

The parameters identification process is “manual” and iterative; it is performed in two phases:
The first phase consists in separate pre-tuning of the fans, heat exchangers and compressors models with the help of default values and/or parameter identification models.
In the second phase, the parameters are slowly tuned, in such a way to obtain the best fit with all experimental results and/or manufacturer data available. The identification process is presented in Figure 4:

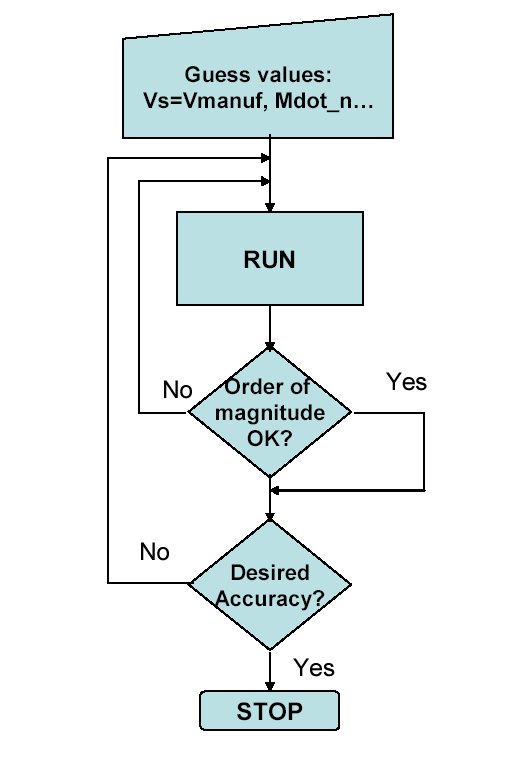
[picture p113: figure]

Figure 4: Identification process flowchart

The information flow diagram of the whole room air conditioner model is presented in Figure 5.

Figure 5: The room air conditioner model

Phase 1: Pre-tuning of the component models

Fans and air loops

Generally the fans parameters are identified with help of the curves (or tables) given by the Manufacturer. An equivalent cross section area of the air loop (evaporator or condenser loop) can be defined from might be is identified from the nominal fan head announced by the manufacturer, or (as in the present case) given in the literature for a similar fan.
The utilitarian EES program used for this identification is presented in Figures 6a and 6b.
The coefficients αi and βi are identified by selecting four specifics points on the fan characteristic curves available.

Reversible-Inverter

MODEL

INPUTS | OUTPUTS

NOMINAL POINT PARAMETERS

Evaporator

tin = 27 | [C] | RHin = 0.472 | [-]
Patm = 101300 | [Pa]
fluid$= fluid$= | R410A

Qev = 2513 [W]

Ma,ev,n = 0.0976 | [kg/s]
Mr,ev,n = 0.01519 | [kg/s]
Ra,ev,n = 0.002152 | [K/W]
Rr,ev,n = 0.001952 | [K/W]
Dequ,cd,n = 0.002897 | [m]
∆T,sh = 5 | [K]
Nfan,ev = 1 | [-]
ta,ex,ev = 12.84 [C] | RHa,ex,ev = 0.9861 [-]

Mw,condens = 0.0001951 [kg/s]

Vs,cp,max = 0.00000897 | [m³ ]
rv,in,cp = 2.8 | [-]
αcp = 0.15 | [-]

Wcp = 618.5 [W]

Xcp = 1 | [-]
tout = 35 | [C]
Rm,ev = 0.00002 | [K/W]
∆T,sc = 5 | [K]

ta,ex,cd = 39.31 [C]

Ma,cd,n = 0.651 | [kg/s]
Mr,cd,n = 0.01519 | [kg/s]
Ra,cd,n = 0.002903 | [K/W]
Rm,cd = 0.00002 | [K/W]
Rr,cd,n = 0.002751 | [K/W]

Qcd = 3113 [W]

Compressor | Condenser
Dequ,ev,n = 0.002689 | [m]
Nfan,cd = 1 | [-]

Condenser fan & control

t

cd,set = 25 | [C] | gain = 0.05 | [-]

ta,ex,fan,ev = 12.92 [C] RHa,ex,fan,ev = 0.9812 [-]

ta,ex,fan,cd = 39.36 [C]

Qcooling = 2492 [W]

W = 686.2 [W]

COP | COP = 3.631 [-] cp = 4.062 [-]
Nrot = 3000 | [rpm]

SHRev = 79.99 [%]

Mr,ev = 0.01597 [kg/s]

∆p,a,ev,nom = 10 [Pa]

Evaporator fan and air loop
Sloop,equ,nom = 0.02924 [m²
]
α0,fan,ev = 0.479 | [-]
α1,fan,ev = -5.516 | [-]
α2,fan,ev = 41.97 | [-]
α3,fan,ev = -121 | [-]
β0,fan,ev = 0.06182 | [-]
β1,fan,ev = -0.606 | [-]
β2,fan,ev = 6.55 | [-]
β3,fan,ev = -18.03 | [-]
Dfan,ev A | = 0.315 | [m] ex,fan,ev = 0.0779 | [m²
]

rpmfan,ev = 950 [rpm]

Ma,ev = 0.1384 [kg/s]

Wfan,ev = 10.73 [W]

Sequ,a,cd,nom = 0.07551 [m²
]

f

factor = 0 [-]

Ma,cd = 0.7179 [kg/s]

Wfan,cd = 56.93 [W]

α0,fan,cd = 0.1826 | [-]
α1,fan,cd = -0.01451 | [-]
α2,fan,cd = -5.089 | [-]
α3,fan,cd = 10.32 | [-]
β0,fan,cd = 0.02041 | [-]
β1,fan,cd = 0.1802 | [-]
β2,fan,cd = -0.8154 | [-]
β3,fan,cd = 2.231 | [-]
Aex,fan,cd = 0.196 | [m²
] Dfan,cd = 0.5 | [m]
rpmfan,cd = 950 | [rpm]

Va,mh,ev = 430.9 [m³

/h] Va,mh,ev,20 = 418.7 [m³ /h]

Va,mh,cd = 2288 [m³ V | /h] a,mh,cd,20 = 2172 [m³
/h]

tcd = 48.37 [C]

tev = 8.883 [C]

Operating_mode= Operating_mode= Cooling_mode

RHout = 0.5 [-]

Evaporator

Condenser

Power consumtions

Outdoor conditions | Performances

Indoor Unit

Outdoor Unit

Indoor conditions

Speed_fan_indoor_unit$= Medium

Air-conditioning unit

Medium class

Qheat = 3152 [W]

Hzcp = 51 [tr/s]

General Inputs

Variable Inputs

Mice = 0 [kg/s] Qice = 0 [W]

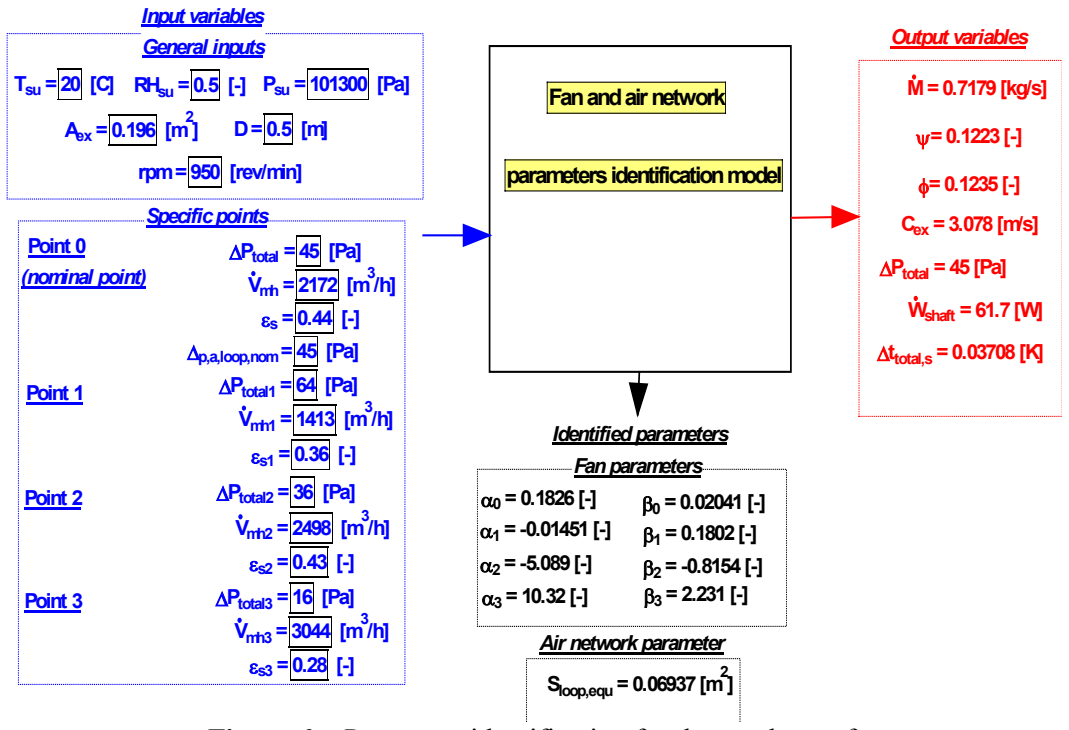
[picture p114: figure]
Fan and air network; Input variables; Output variables; Identified parameters; Tsu = 20; Psu = 101300; Aex = 0.196; ∆Ptotal = 45; rpm = 950; [rev/min]; Cex = 3.078 [m/s]; ∆Ptotal = 45 [Pa]; RHsu = 0.5; ∆ttotal,s = 0.03708 [K]; Wshaft = 61.7 [W]; General inputs; Specific points; Point 0; Vmh = 2172; Point 1; ∆Ptotal1 = 64; Vmh1 = 1413; Point 2; ∆Ptotal2 = 36; Vmh2 = 2498; Point 3; ∆Ptotal3 = 16; Vmh3 = 3044; parameters identification model; Fan parameters; ∆p,a,loop,nom = 45; Sloop,equ = 0.06937 [m² ]; Air network parameter; (nominal point)

Figure 6a: Parameter identification for the condenser fan

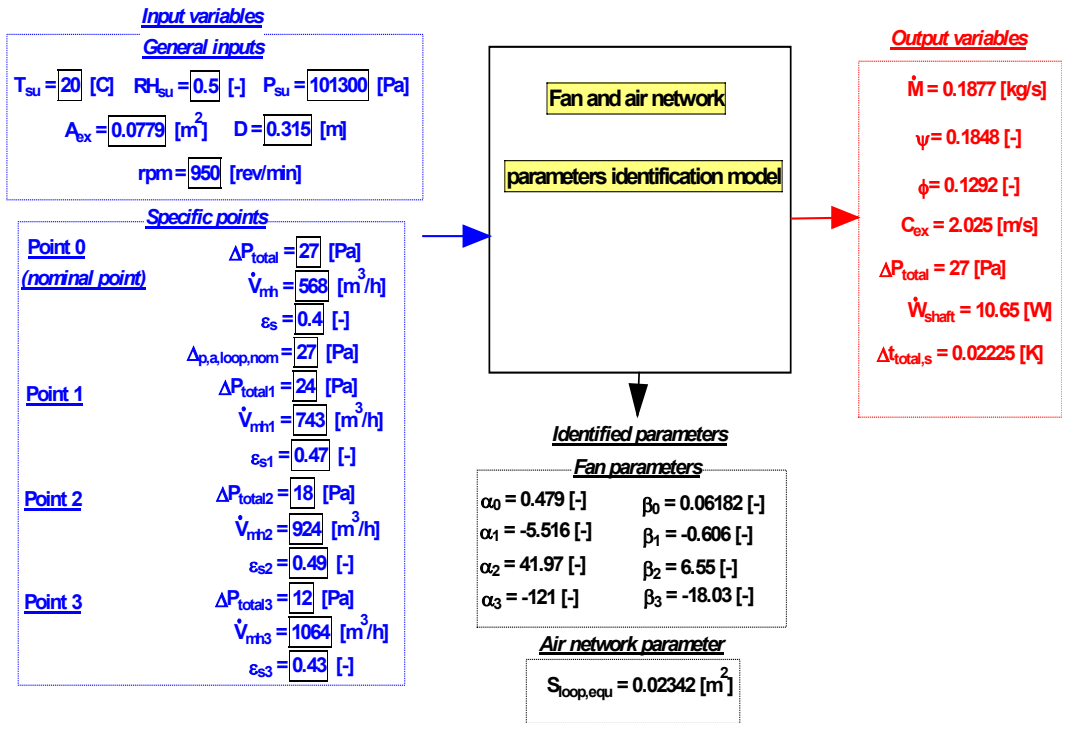
[picture p115: figure]
Fan and air network; Input variables; Output variables; Identified parameters; Tsu = 20; Psu = 101300; Aex = 0.0779; ∆Ptotal = 27; rpm = 950; [rev/min]; Cex = 2.025 [m/s]; ∆Ptotal = 27 [Pa]; RHsu = 0.5; ∆ttotal,s = 0.02225 [K]; Wshaft = 10.65 [W]; General inputs; Specific points; Point 0; Vmh = 568; Point 1; ∆Ptotal1 = 24; Vmh1 = 743; Point 2; ∆Ptotal2 = 18; Vmh2 = 924; Point 3; ∆Ptotal3 = 12; Vmh3 = 1064; parameters identification model; Fan parameters; ∆p,a,loop,nom = 27; Sloop,equ = 0.02342 [m² ]; Air network parameter; (nominal point)

Figure 6b: Parameter identification for the evaporator fan

Heat exchangers

An other utilitarian EES program (Figure 7) is used to tune the parameters of both heat

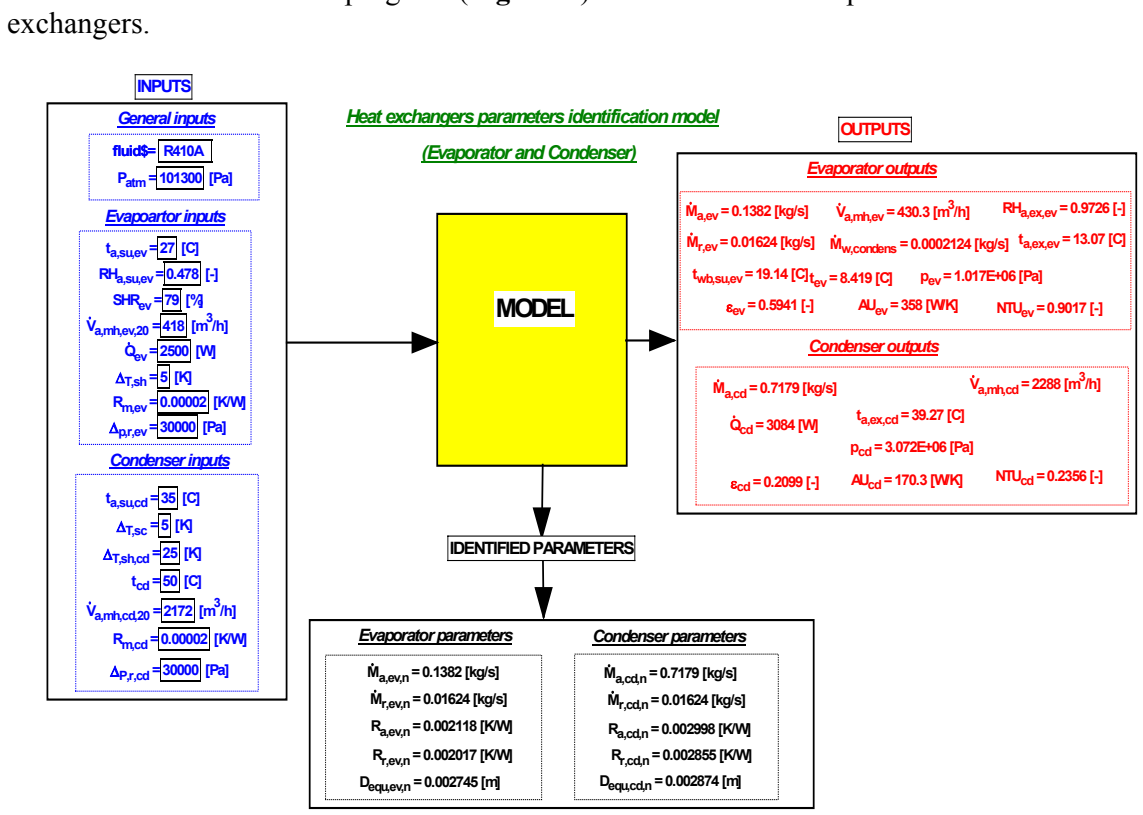
[picture p116: figure]
exchangers.; Heat exchangers parameters identification model; MODEL; INPUTS; OUTPUTS; IDENTIFIED PARAMETERS; Evaporator parameters; twb,su,ev = 19.14 [C]; Patm = 101300; fluid$= fluid$=; Qev = 2500; RHa,ex,ev = 0.9726 [-]; Mw,condens = 0.0002124 [kg/s]; Condenser parameters; SHRev = 79; General inputs; Evapoartor inputs; (Evaporator and Condenser); Condenser inputs; Evaporator outputs; Condenser outputs; Dequ,ev,n = 0.002745 [m]; Dequ,cd,n = 0.002874 [m]; pev = 1.017E+06 [Pa]; NTUev = 0.9017 [-]; NTUcd = 0.2356 [-]; pcd = 3.072E+06 [Pa]; AUcd = 170.3 [W/K]; AUev = 358 [W/K]; εcd = 0.2099 [-]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

Figure 7: Parameter identification for both heat exchangers

The model inputs are the sizing values determined in nominal conditions (given by the manufacturer).

General inputs :

fluid$ - the refrigerant used name | [R407C];
P_atm – atmospheric pressure | [Pa];

Evaporator inputs:

t_a_su_ev – dry bulb temperature at evaporator supply | [°C];
RH_a_su_ev – relative humidity at evaporator supply | [-];
Q_dot_ev – evaporator total cooling power | [W];
∆_t_sh - refrigerant superheating at evaporator exhaust | [K];
R_m_ev - metal thermal resistance (current order of magnitue: 0.000011 K/W and 0.00002 ) [K/W];
V_dot_a_mh_ev_20 - air flow rate at 20 °C, 50% and 101325 Pa [m³/h];
SHR_ev – evaporator sensible heat ratio | [-];
∆_p_r_ev - refrigerant pressure drop | [Pa].

Condenser inputs:

t_a_su_cd – supply air dry bulb temperature | [°C];
∆_t_sc – refrigerant subcooling at condenser exhaust | [K];
∆_t_sh_cd - refrigerant superheating at condenser supply | [K];
t_cd – condensing temperature | [°C];
V_dot_a_mh_cd_20 – air flow rate at 20°C, 50% and 101325 Pa | [m³/h];
R_m_cd - metal thermal resistance (0.00001 to 0.00002)
[K/W];
∆_p_r_cd - refrigerant pressure drop | [Pa].

Evaporator parameters identified:
M_dot_a_ev_n - nominal air mass flow rate | [kg/s];
M_dot_r_ev_n – nominal refrigerant mass flow rate | [kg/s];
R_a_ev_n - nominal air thermal resistance | [K/W];
R_r_ev_n - evaporator nominal refrigerant thermal resistance | [K/W];
D_equ_ev_n - nominal equivalent diameter (refrigerant side) | [m].

Condenser parameters:
M_dot_a_cd_n - nominal air mass flow rate | [kg/s];
M_dot_r_cd_n - nominal refrigerant flow rate | [kg/s];
R_a_r_cd_n - nominal air thermal resistance | [K/W];
R_r_cd_n - nominal refrigerant thermal resistance | [K/W];
D_equ_cd_n – nominal equivalent diameter (refrigerant side) | [m].

Evaporator outputs:

M_dot_a_ev – air mass flow rate (nominal value) | [kg/s];
V_dot_a_mh_ev - air volume flow rate | [m³/h];
t_a_ex_ev – exhaust dry bulb temperature | [°C];
RH_a_ex_ev – exhaust relative humidity | [-];
M_dot_r_ev – refrigerant mass flow rate (nominal value) | [kg/s];
M_dot_w_condens – condensed water mass flow rate | [kg/s];
t_ev – evaporating temperature | [°C];
p_ev – evaporating pressure | [Pa];
ε_ev – fictitious effectiveness | [-];
AU_ev – fictitious global heat transfer coefficient | [W/K];
NTU_ev – fictitious number of transfer units | [-].

Condenser outputs:

Q_dot_cd – condenser thermal power | [W];
M_dot_a_cd – air mass flow rate (nominal value) | [kg/s];
V_dot_a_mh_cd - air volume flow rate | [m³/h];
t_a_ex_cd – exhaust dry bulb temperature | [C];

p_cd – condensing pressure | [Pa];
ε_cd – fictitious effectiveness | [-];
AU_cd– fictitious global heat transfer coefficient | [W/K];
NTU_cd – fictitious number of transfer units | [-].

A starting assumption consists in giving almost the same values to air and refrigerant sides resistances. For example (in the present case):

Compressor

In the present case, the manufacturer doesn’t give any specific information about the compressor.
A reference swept volume flow rate is iteratively identified, by starting from a default value.

Two other parameters are then identified in such a way to get correct values of both the compressor power and the amount of heat rejected through the condenser:
- r_v_in_cp – compressor internal volume ratio (between 2.5 and 3.5) | [-];
- ά_cp - loss factor (between 0.2 and 0.5) | [-].

To complete the parameter identification, the following similarity laws can be used:

a) Constant electro-mechanical loss [W] :
Wloss0,cp = Wloss0,cp,reference · | Vs,cp,max
| Vs,cp,max,reference

0.98

b) Fictitious overall heat transfer coefficient at compressor exhaust [W/K]:

AUr,ex,cp = 70 ·

Mr,cp

Mr,ref

0.8

c) Fictitious ambient overall heat transfer coefficient | [W/K]:

AUamb,cp = 10 ·

Mr,cp

Mr,ref

0.8

d) Fictitious overall heat transfer coefficient at compressor supply [W/K]:

AUr,su,cp = 70 ·

Mr,cp

Mr,ref

0.8

with
W_dot_loss0_cp_reference = 500 - reference constant electro-mechanical loss | [W];
V_s_cp_max_reference =0.000213 -reference maximal fictitious volume | [m³].

Ra,n = Rr,n · 1.05

M_dot_r_ref = 0.25 - reference refrigerant mass flow rate | [kg/s].

Phase 2: Final tuning

The compressor and heat exchangers parameters are slightly modified (if necessary), in order to obtain the desired results accuracy in nominal conditions:

1) The swept volume is re-tuned in order to get the correct cooling power
2) The internal volume ratio is re-tuned in order to get the correct compressor electrical power
3) The evaporator air thermal resistance is also re-tuned (if necessary) in order to get the correct air exhaust temperature.

### 3.2. Validation

By lack of other experimental data, the validation is limited here to a comparison with what is given in the catalogue of the manufacturer. The results are fairly satisfactory, as shown in Figures 8, 9 and 10.

a) medium class unit
b) high class

Figure 8: Cooling capacity

1000 | 1500 | 2000 | 2500 | 3000 | 3500 | 4000 | 4500 | 5000

1000

1500

2000

2500

3000

3500

4000

4500

5000

C atalo g u e co o lin g cap acity [W ]

Simulated cooling capacity [W]

Q c o o lin g

0 | 500 1000 | 2000 | 3000 | 4000 | 5000 | 6000

0

500

1000

1500

2000

2500

3000

3500

4000

4500

5000

5500

6000

C a ta lo g u e c o o lin g c a p a c ity [W ]

Simulated cooling capacity [W]

Q c o o lin g

a) medium class
b) high class
Figure 9: Electrical power
a) medium class
b) high class

Figure 10: EER

200250 300 350 400 450 500 550 600 650 700 750 800 850 900 9501000

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
1000

Catalogue power consumption[W ]

Simulated total power consumption [W]

W | (C oolin g | m od e)
0 | 1 | 2 | 3 | 4 | 5 | 6 | 7 | 8 | 9 | 10

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
C atalo g u e E E R [-]

Simulated EER [-]

E E | R (C o | o lin g m o d | e )
0 | 100 200 300 400 500 600 700 800 900 1000 | 1200 | 1400

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
1000

1100

1200

1300

1400

C a talo g u e p o w e r c o n su m p tio n [W ]

Simulated power consumption [W]

W | ( C o o l in g | m o d e )
0 | 1 | 2 | 3 | 4 | 5 | 6 | 7 | 8 | 9 | 10

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
C ata lo g u e E E R [-]

Simulated EER [-]

C OP

After having been tuned and validated, this “reference” model can be used to reproduce the performances curves of the manufacturer. Examples are given in Figure 11 and 12.

Figure 11: Simulated cooling capacity as function of indoor and outdoor air temperatures (medium class air conditioner with medium fan speed)

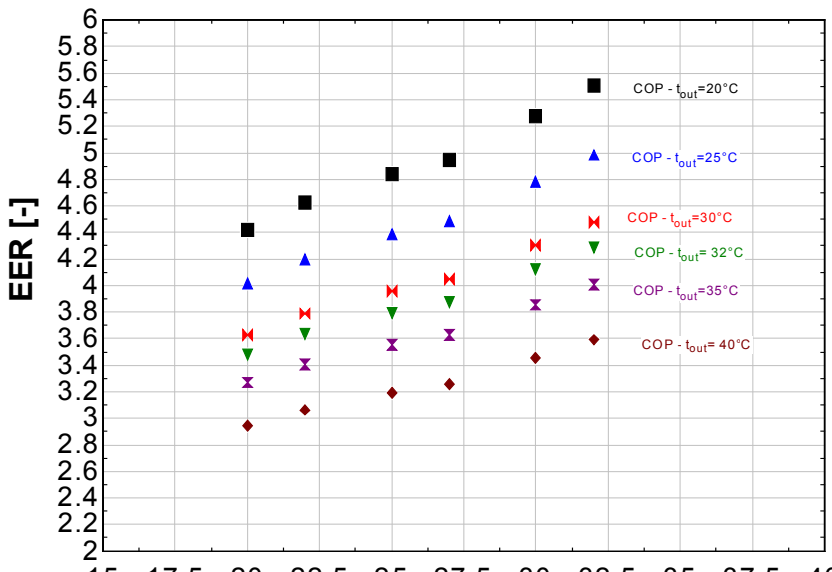
[picture p117: figure]
EER [-]; COP - tout=20°C; COP; out; COP - t out; - tout= 32°C; - tout= 40°C

Figure 12: Simulated EER as function of indoor and outdoor air temperatures (medium class air conditioner with medium fan speed)

15 17.5 20 22.5 25 27.5 30 32.5 35 37.5 40
Indoor air temperaure (indoor relative humidity near to 50%) [C]
15 | 17.5 | 20 | 22.5 | 25 | 27.5 | 30 | 32.5 | 35

2100

2250

2400

2550

2700

2850

3000

3150

3300

Indoor air temperaure (indoor relative humidity near to 50%) [C]

Cooling power [W]

Qcooling -tout

=20°C

Qcooling | - tout=25°C
Qco oling | - tout

=30°C

Qcooling | - tout= | 32°C
Qcooling | - tout | = | 35°C
Qco oling | - tout=40°C

### 4. Simplified model

The simplest modeling consists in expressing the cooling full load nominal capacity and the electrical consumption as polynomial functions of two independent variables:

1) The outdoor air temperature. The relative humidity doesn’t affect the system performances because the outdoor heat exchanger (condenser) works in dry regime
2) The indoor air temperature. This temperature must be then associated with a constant relative humidity (for example 50%).

The system performances are already predicted with the reference model (Figure 11 and Figure 12). Third degree polynomials laws can be fitted on these results:

Qcooling,full,nom=C1capacity+C2capacity*tin+C3capacity*tin

2
+C4capacity*tin

3
+C5capacity*tout+C6capacity*tout

2
+C7capacity*tout

3

+C8capacity*tin*tout+C9capacity*tin*tout

2
+C10capacity*tin

2
*tout+C11capacity*tin

2
*tout

2

Wcooling,full,nom=C1power+C2power*tin+C3power*tin

2
+C4power*tin

3
+C5power*tout+C6power*tout

2
+C7power*tout

3

+C8power*tin*tout+C9power*tin*tout

2
+C10power*tin

2
*tout+C11power*tin

2
*tout

2

With the help of the reference model, these laws can be corrected in order to take into account the effects of the indoor relative humidity of the fan speed:

Wcooling,full = Wcooling,full,nom · Cpower,relhum · Cspeed,power

Qcooling,full = Qcooling,full,nom · Ccapacity,relhum · Cspeed,capacity

Relative humidity correction factors

Both correction factors (cooling capacity and power consumption ratios) can be defined as functions of a relative humidity ratio:

ratioRH,in =

1
RHin
These functions are identified in Figures 13 and 14:

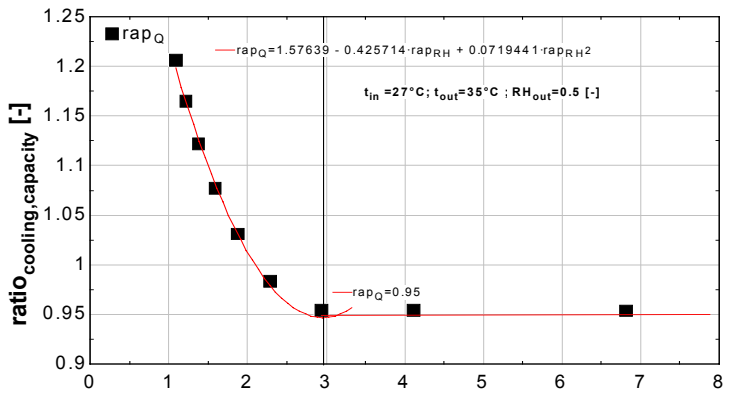
[picture p118: figure]
ratiocooling,capacity [-]; tin; tout=3 5°C; ; R Hout=0.5

Figure 13: Cooling capacity ratio as function of relative humidity ratio ratiorela tiv e ,h um id ity [-]

rap Q | ra p Q=1 .5 76 3 9 | - | 0 .4 2 5 71 4 ·ra p R H | + | 0 .0 7 1 9 4 4 1 ·ra p R H 2

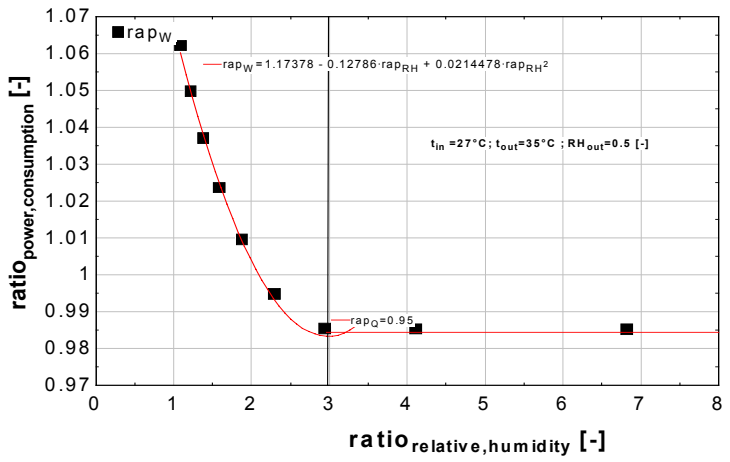
[picture p119: figure]
ratiorelativ e,hum idity [-]; ratiopower,consumption [-]; tin; tout=3 5 °C; ; R H out=0 .5

Figure 14: Power consumption ratio as function of relative humidity ratio

Two different zones can be distinguished:

1) from 0 to 2.9 of relative humidity ratio, where both cooling and power ratios present a (second degree) parabolic variation;
2) above 2.9 of relative humidity ratio, where the cooling and power ratios are constant.

For these two zones, the corrections factors can be defined as follows:

Cooling capacity relative humidity correction factor:

Ccapacity,relhum = CoolingCapacityRHCorection ( ratioRH,in )

If ( ratioRH,in >= 2.9 ) Then

CoolingCapacityRHCorection := 0.95

CoolingCapacityRHCorection := 1.57639 – 0.425714 · ratioRH,in + 0.0719441 · ratioRH,in

2

Power consumption relative humidity correction factor:

Cpower,relhum = PowerRHCorection ( ratioRH,in )

If ( ratioRH,in >= 2.9 ) Then

PowerRHCorection := 0.985

PowerRHCorection := 1.17378 – 0.12786 · ratioRH,in + 0.0214478 · ratioRH,in

2

A similar law can be used to define the sensible heat ratio (Figure 15):

SHR = SensibleHeatRatio ( ratioRH,in )

If ( ratioRH,in >= 2.9 ) Then

| rapW = 1.17378 | --0.12786·rapR H 0.12786·rapR H | + + 0.0214478·rapR H rap 0.0214478·rapR H ² | 2 W = 1.17378

SensibleHeatRatio := 100

SensibleHeatRatio := – 0.550793 + 0.95039 · ratioRH,in – 0.144445 · ratioRH,in

2

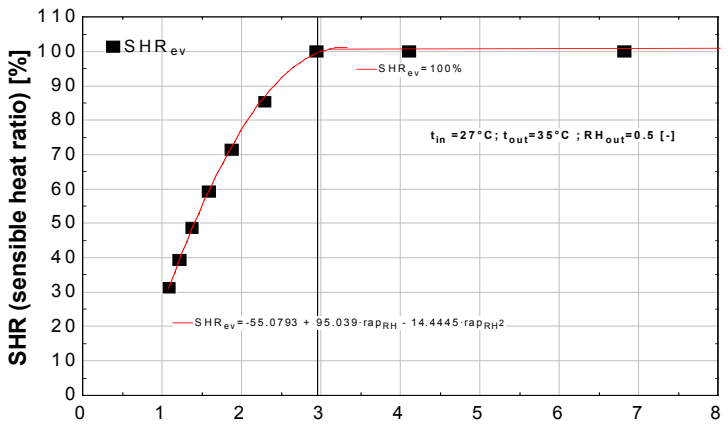
[picture p120: figure]
SHR (sensible heat ratio) [%]; SHR ev

Figure 15: Sensible heat ratio as function of relative humidity ratio

Fan speed correction factors

Constant values can be identified for the fan speed correction factors:

Cspeed,capacity = SpeedFanEvCorectionFactor ( Speedfan,indoor,unit$ )

If ( Speedfan,indoor,unit$ = 'High' ) Then

SpeedFanEvCorectionFactor := 1.019

If ( Speedfan,indoor,unit$ = 'Medium' ) Then

SpeedFanEvCorectionFactor := 1

If ( Speedfan,indoor,unit$ = 'Low' ) Then

SpeedFanEvCorectionFactor := 0.994

If ( Speedfan,indoor,unit$ = 'Silent Operation' ) Then

SpeedFanEvCorectionFactor := 0.983

Qcooling,full = Qcooling,full,nom · Ccapacity,relhum · Cspeed,capacity

If ( Speedfan,indoor,unit$ = 'High' ) Then

SpeedFanCompressorFactor := 1.016

If ( Speedfan,indoor,unit$ = 'Medium' ) Then

SpeedFanCompressorFactor := 1 ratio re la tiv e ,h u m id ity [-]

S H R e v = -5 5 .0 7 93 | + | 9 5 .0 3 9 ·ra p RH | - | 1 4.4 4 4 5 ·ra p RH S H R | 2 e v = -5 5 .0 7 93 | + | 9 5 .0 3 9 ·ra p RH | - | 1 4.4 4 4 5 ·ra p RH2
tin | = 2 7 ° C ; | t o u t= 3 5 ° C | ; | R H o u t= 0 .5 | [-]

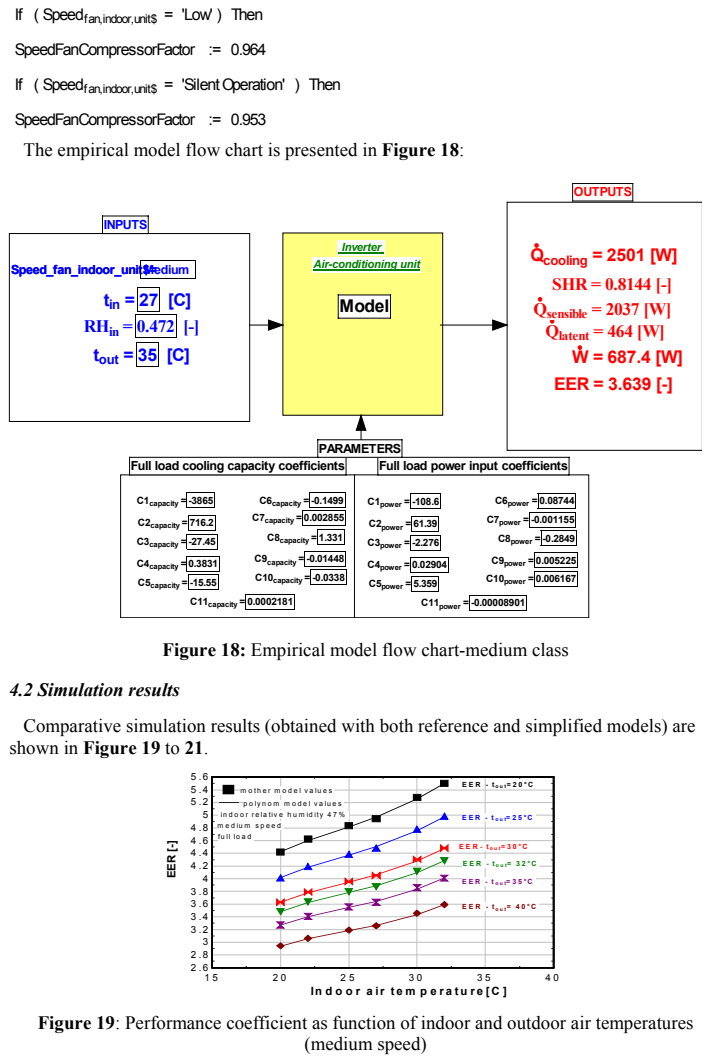
[picture p121: page 25]
SpeedFanCompressorFactor := 0.964; (medium speed); EER [-]; - t out=20°C; C10capacity = -0.0338; C11capacity = 0.0002181; C1capacity = -3865; C2capacity = 716.2; C3capacity = -27.45; C4capacity = 0.3831; C5capacity = -15.55; C6capacity = -0.1499; C7capacity = 0.002855; C8capacity = 1.331; C9capacity = -0.01448; Full load cooling capacity coefficients; Full load power input coefficients; C10power = 0.006167; C11power = -0.00008901; C1power = -108.6; C2power = 61.39; C3power = -2.276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

If ( Speedfan,indoor,unit$ = 'Low' ) Then

If ( Speedfan,indoor,unit$ = 'Silent Operation' ) Then

SpeedFanCompressorFactor := 0.953
The empirical model flow chart is presented in Figure 18:

Air-conditioning unit Speed_fan_indoor_unit$= Medium

Figure 18: Empirical model flow chart-medium class

4.2 Simulation results
Comparative simulation results (obtained with both reference and simplified models) are
shown in Figure 19 to 21.

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

In d o o r air tem p eratu re[C ]

Figure 19: Performance coefficient as function of indoor and outdoor air temperatures

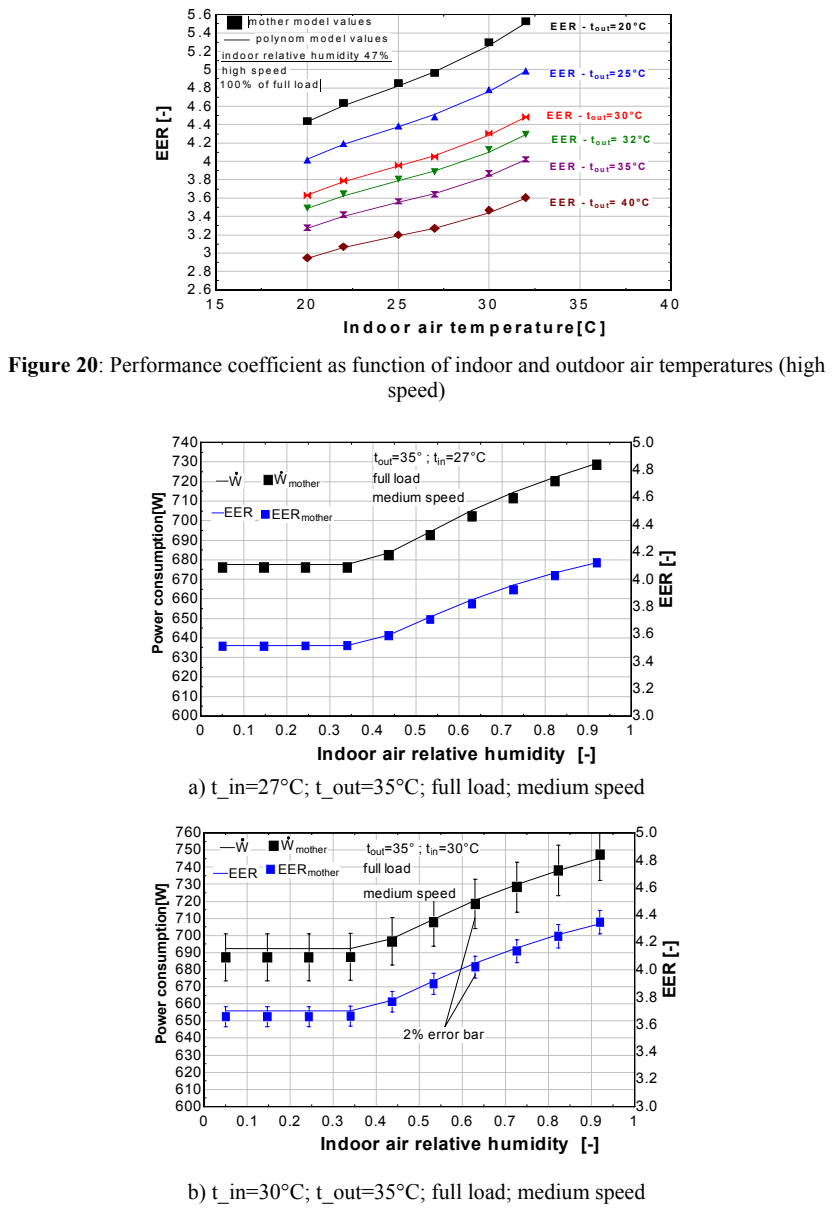
[picture p122: page 26]
speed); Power consumption[W]; Wmother; EER [-]; tout; EER; EERmother; =35° ; tin=30°C; 2% error bar

mother model values

EER | - tout=20°C

polynom | model values

indoor | relative | humidity 47%
high speed
100% of full load

Indoor air tem perature[C ]

Figure 20: Performance coefficient as function of indoor and outdoor air temperatures (high

=35° ; tin=27°C
full load
medium speed

EER | EERmother

Indoor air relative humidity [-]

a) t_in=27°C; t_out=35°C; full load; medium speed

b) t_in=30°C; t_out=35°C; full load; medium speed

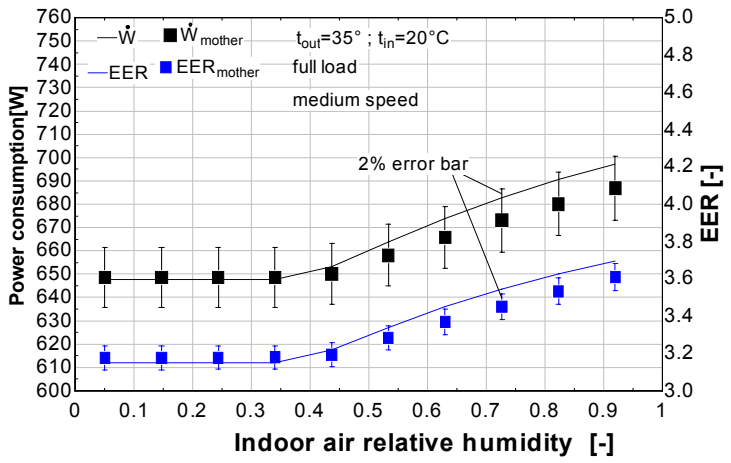
[picture p123: figure]
Indoor air relative humidity [-]; Power consumption[W]; Wmother; EER [-]; EER; EERmother; tout; =35° ; tin=20°C full load; medium speed; 2% error bar

c) t_in=20°C; t_out=35°C; full load; medium speed

Figure 21: Performance coefficient and power consumption as functions of indoor air relative humidity

### 5. Conclusion

Both (reference and simplified) models are fairly well reproducing the performance data given by the manufacturer.
More experimental results will be welcome to go further in the validation of the reference model.
After validation, the reference (“mother”) model will be used to generate a more reliable simplified (“daughter”) model if required.

### 6. References

BS EN 378-1:2000 – Refrigerating systems and heat pumps – Safety and environmental requirements. Part 1 – 4, 2000

Lebrun J. – Machines et systèmes thermiques. Université de Liège, Faculté des sciences appliques, Liège, Septembre, 2005

Lebrun J. – System Simulation Synthesis Report, University of Liège, Belgium, report AN10 881020-RF, 1988, 90pp

André Ph., Aparecida C., Hannay Jules, Lebrun J., Lemort V, Teodorese I.V -Simulation of HVAC systems: development and validation of simulation models and examples of practical applications, Keynote presented at Mercofrio 2006, Porto Alegre, Brazil, October17-20 2006

Teodorese I.V. - Modélisation d’une machine frigorifique fonctionnant avec un mélange zéotropique. Thèse de doctorat. Liège, Belgique, 2003

Winandy E.L., - Contribution to the performance analysis of reciprocating and scroll refrigeration compressors - Ph. D. Thesis. Conception, Chile, Decembre 1999
