TKlebig/TimBAgit/EES/Stephane/2007 - Room air conditioners - RAC modeling-summaryVTJL070704.pdf

Laboratoire
de Thermodynamique appliquée Université de Liège

Département des Sciences et Gestion de l'Environnement
Université de Liège

Bât. B49 - Parking 33
Chemin des Chevreuils, 7
B-4000 LIEGE
Belgique

Avenue de Longwy, 185
B-6700 ARLON
Belgique

Ref Nr: RAC modeling VTJL070704

MODELING OF A ROOM AIR CONDITIONER

-SUMMARY-

Vladut Teodorese and Jean Lebrun Liège, 04 July 2007

### 1. Introduction

A “reference” and a “simplified” room air conditioner models are proposed in this paper. One example of “medium” class “split” air conditioners is considered.
In nominal cooling conditions (indoor air temperature 27°C, indoor air relative humidity 47% and outdoor air temperature 35°C), the capacity is 4500 W and the EER 3.1.
In nominal heating conditions (indoor air temperature 22°C and outdoor air temperature 7 °C), the capacity is 4357 W and the COP 3.4.
The part-load operating mode is ON-OFF.

### 2. Reference model

A so-called “reference” (“detailed”, “mechanistic”, or “mother”) model is, as much as possible, based on real physics. It’s an assembly of meaningful equations, describing the dominant physical phenomena, as they are understood and as they can be represented. But the model is nevertheless application-oriented: its realism is only required in a given domain of use and for relevant (input and output) variables.
The reference model of a room air conditioner is built by assembling several component models described hereafter. The main equations are already described in previously report RAC modelling VTJL061207.

### 2.1 Heating and dry cooling coil

A same heating and dry cooling coil model is used to simulate both the condenser and the evaporator in dry regime.
The coil is supposed here to behave as a fictitious semi-isothermal heat exchanger. Laminar and turbulent regimes are considered on air and “refrigerant” sides respectively.
The output variables are the coil thermal power and the exhaust temperatures of both fluids (air and refrigerant).
The parameters are: the nominal flow rates of both fluids and the three nominal thermal resistances (air side, metal and refrigerant side).
The input variables are the supply conditions on both sides of the coil.

### 2.2 Cooling coil in dry and wet regimes

This model is based on Merckel theory (combination of latent and sensible heat transfer), with a very slight adaptation: air enthalpy is here replaced by wet bulb temperature as total heat transfer potential).
James Braun’s hypothesis is also used (replacing partially dry-wet by completely dry or completely wet regimes).

Selected outputs are:

- Coil “emissions” (total, sensible and latent cooling power);
- Air state at coil exhaust (temperature, moisture content and relative humidity);
- Water condensate flow rate;
- Refrigerant temperature at coil exhaust.

The parameters and the input variables are the same as in dry regime.

The equations developed in dry regime are transposed to the wet regime by substituting to the air a fictitious ideal gas, whose temperature is the actual air wet bulb temperature.

The air state at the evaporator exhaust is calculated, according to a classical ASHRAE procedure, by identifying a fictitious contact effectiveness (i.e. by considering a fictitious air side isothermal surface).

According to James Braun’s proposal, the (dry or wet) regime giving the highest cooling power is selected as nearest to reality.

### 2.3 Compressor

The model used here is well adapted to the simulation of most rotary compressors. It includes heat transfers at the supply, at the exhaust and to the ambient. The suction and discharge pressure drops are neglected, as well as the lubricant circulation. The compression is considered as isentropic, up to the internal pressure and then at constant volume until the exhaust pressure.
The conceptual schema of the compressor is presented in Figure 1.
The evolution of the refrigerant is decomposed into four steps:
1) Heating-up (su → su1).
2) Isentropic compression (su1 → in)
3) Compression at a fixed volume (in →ex1).
4) Cooling down (ex1→ex)

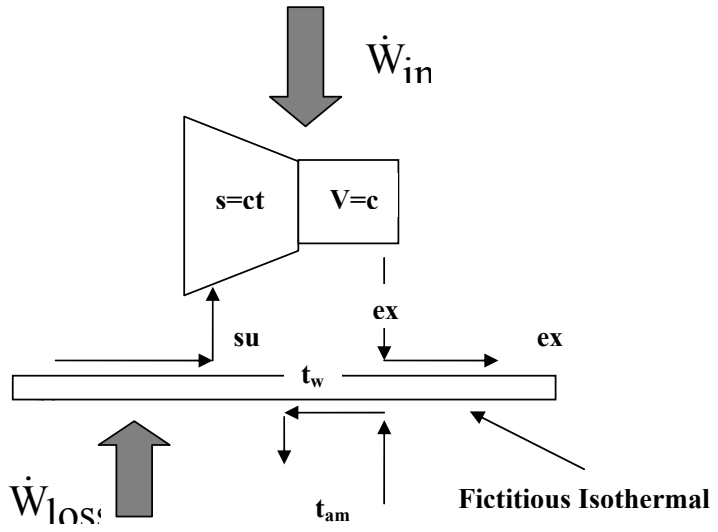
[picture p124: figure]
tam; Win &; Wloss &; Fictitious Isothermal

Figure 1: Conceptual scheme of the compressor model

### 2.4. Fan(s) model

The fans are currently modelled with the help of similarity variables: flow, pressure and power factors. These factors can be correlated to each other by polynomial expressions.

The fan is supposed to be characterised by the diameter of its impeller (scale variable), the exhaust area and the coefficients of two polynomial correlations.

Polynomials are fitted to manufacturer’s performance data.

### 3. Tuning of the reference models

The parameters identification process is “manual” and iterative; it is performed in two phases:
The first phase consists in separate pre-tuning of the fans, heat exchangers and compressors models with the help of default values and/or parameter identification models.
In the second phase, the parameters are slowly tuned, in such a way to obtain the best fit with all experimental results and/or manufacturer data available. The identification process is presented in Figure 2:

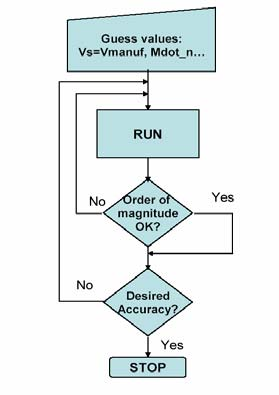
[picture p125: figure]

Figure 2: Identification process flowchart

Unfortunately we don’t dispose of technical data other (hypothetical) nominal performances.
The following assumptions were made:
- evaporator flow rate: 530 m³/h (at 20°C and atmospheric pressure);
- condenser flow rate: 2373 m³/h (at 20°C and atmospheric pressure);
- superheating at the condenser supply: 32°C;
- compressor flow rate: 3.13 m³/h;
- compressor rotation speed: 3000 tr/min;
- indoor unit fan power consumption: 10 W;
- outdoor unit fan power consumption: 52W;
- electronic devices power consumption: 6 W.

Information flow diagrams and simulation results in nominal cooling and heating modes are given in Figures 3 and 4, respectively.

Figure 3: The room air conditioner model results: nominal cooling mode

Reversible-Inverter

MODEL

INPUTS | OUTPUTS

NOMINAL POINT PARAMETERS

Evaporator

tin = 27 | [C] | RHin = 0.47 | [-]
Patm = 101300 | [Pa]
fluid$= fluid$= | R410A

Qev = 4512 [W]

Ma,ev,n = 0.1839 | [kg/s]
Mr,ev,n = 0.02919 | [kg/s]
Ra,ev,n = 0.000852 | [K/W]
Rr,ev,n = 0.000652 | [K/W]
Dequ,cd,n = 0.004197 | [m]
∆T,sh = 5 | [K]
Nfan,ev = 1 | [-]
ta,ex,ev = 9.506 [C] | RHa,ex,ev = 0.9986 [-]

Mw,condens = 0.0005413 [kg/s]

Vs,cp,max = 0.00001739 | [m³]
rv,in,cp = 2.8 | [-]
αcp = 0.15 | [-]

Wcp = 1387 [W]

Xcp = 1 | [-]
tout = 35 | [C]
Rm,ev = 0.00002 | [K/W]
∆T,sc = 5 | [K]

ta,ex,cd = 42.18 [C]

Ma,cd,n = 0.7845 | [kg/s]
Mr,cd,n = 0.02919 | [kg/s]
Ra,cd,n = 0.001682 | [K/W]
Rm,cd = 0.00002 | [K/W]
Rr,cd,n = 0.001613 | [K/W]

Qcd = 5856 [W]

Compressor | Condenser
Dequ,ev,n = 0.004189 | [m]
Nfan,cd = 1 | [-]

Condenser fan & control

tcd,set = 25 | [C] | gain = 0.05 | [-]

ta,ex,fan,ev = 27.18 [C] RHa,ex,fan,ev = 0.4651 [-]

ta,ex,fan,cd = 42.19 [C]

Qcooling = 4502 [W]

W = 1456 [W]

COP | COP = 3.092 [-] cp = 3.252 [-]
Nrot = 3000 | [rpm]

SHRev = 70.27 [%]

Mr,ev = 0.02935 [kg/s]

∆p,a,ev,nom = 20 [Pa]

Evaporator fan and air loop
Sloop,equ,nom = 0.03824 | [m²]
α0,fan,ev = 0.479 | [-]
α1,fan,ev = -5.516 | [-]
α2,fan,ev = 41.97 | [-]
α3,fan,ev = -121 | [-]
β0,fan,ev = 0.06182 | [-]
β1,fan,ev = -0.606 | [-]
β2,fan,ev = 6.55 | [-]
β3,fan,ev = -18.03 | [-]
Dfan,ev A | = 0.315 | [m] ex,fan,ev = 0.0779 | [m²]
rpmfan,ev = 950 | [rpm]

Ma,ev = 0.1748 [kg/s]

Wfan,ev = 10.34 [W]

Sequ,a,cd,nom = 0.0955 | [m²]
ffactor = 0 | [-]

Ma,cd = 0.7843 [kg/s]

Wfan,cd = 52.01 [W]

α0,fan,cd = 0.1826 | [-]
α1,fan,cd = -0.01451 | [-]
α2,fan,cd = -5.089 | [-]
α3,fan,cd = 10.32 | [-]
β0,fan,cd = 0.02041 | [-]
β1,fan,cd = 0.1802 | [-]
β2,fan,cd = -0.8154 | [-]
β3,fan,cd = 2.231 | [-]
Aex,fan,cd = 0.196 | [m²] | Dfan,cd = 0.5 | [m]
rpmfan,cd = 950 | [rpm]

Va,mh,ev = 544.6 [m³/h] Va,mh,ev,20 = 528.9 [m³/h]

Va,mh,cd = 2595 [m³ V | /h] a,mh,cd,20 = 2373 [m³/h]

tcd = 50.03 [C]

tev = 8.053 [C]

Operating_mode= Operating_mode= Cooling_mode

RHout = 0.5 [-]

Evaporator

Condenser

Power consumtions

Outdoor conditions | Performances

Indoor Unit

Outdoor Unit

Indoor conditions

Speed_fan_indoor_unit$= Medium

Air-conditioning unit

Medium class-4.5kW; COP 3.1

Qheat = 5864 [W]

Hzcp = 50 [tr/s]

General Inputs

Variable Inputs

Mice = 0 [kg/s] Qice = 0 [W]

Figure 4: The room air conditioner model results: nominal heating mode

Reversible-Inverter

MODEL

INPUTS | OUTPUTS

NOMINAL POINT PARAMETERS

Evaporator

tin = 22 | [C] | RHin = 0.5 | [-]
Patm = 101300 | [Pa]
fluid$= fluid$= | R410A

Qev = 3232 [W]

Ma,ev,n = 0.1839 | [kg/s]
Mr,ev,n = 0.02919 | [kg/s]
Ra,ev,n = 0.000852 | [K/W]
Rr,ev,n = 0.000652 | [K/W]
Dequ,cd,n = 0.004197 | [m]
∆T,sh = 5 | [K]
Nfan,ev = 1 | [-]
ta,ex,ev = 4.624 [C] | RHa,ex,ev = 0.9362 [-]

Mw,condens = 0.0004258 [kg/s]

Vs,cp,max = 0.00001739 | [m³]
rv,in,cp = 2.8 | [-]
αcp = 0.15 | [-]

Wcp = 1209 [W]

Xcp = 1 | [-]
tout = 7 | [C]
Rm,ev = 0.00002 | [K/W]
∆T,sc = 5 | [K]

ta,ex,cd = 44.7 [C]

Ma,cd,n = 0.7845 | [kg/s]
Mr,cd,n = 0.02919 | [kg/s]
Ra,cd,n = 0.001682 | [K/W]
Rm,cd = 0.00002 | [K/W]
Rr,cd,n = 0.001613 | [K/W]

Qcd = 4377 [W]

Compressor | Condenser
Dequ,ev,n = 0.004189 | [m]
Nfan,cd = 1 | [-]

Condenser fan & control

tcd,set = 25 | [C] | gain = 0.05 | [-]
ta,ex,fan,ev = 4.69 [C] | RHa,ex,fan,ev = 0.932 [-]

ta,ex,fan,cd = 21.9 [C]

Qcooling = 3176 [W]

W = 1289 [W]

COP | COP = 3.379 [-] cp = 3.603 [-]
Nrot = 3000 | [rpm]

SHRev = 67.06 [%]

Mr,ev = 0.01864 [kg/s]

∆p,a,ev,nom = 20 [Pa]

Evaporator fan and air loop
Sloop,equ,nom = 0.03824 | [m²]
α0,fan,ev = 0.479 | [-]
α1,fan,ev = -5.516 | [-]
α2,fan,ev = 41.97 | [-]
α3,fan,ev = -121 | [-]
β0,fan,ev = 0.06182 | [-]
β1,fan,ev = -0.606 | [-]
β2,fan,ev = 6.55 | [-]
β3,fan,ev = -18.03 | [-]
Dfan,ev A | = 0.315 | [m] ex,fan,ev = 0.0779 | [m²]
rpmfan,ev = 950 | [rpm]

Ma,ev = 0.8974 [kg/s]

Wfan,ev = 60.37 [W]

Sequ,a,cd,nom = 0.0955 | [m²]
ffactor = 0 | [-]

Ma,cd = 0.1878 [kg/s]

Wfan,cd = 13.68 [W]

α0,fan,cd = 0.1826 | [-]
α1,fan,cd = -0.01451 | [-]
α2,fan,cd = -5.089 | [-]
α3,fan,cd = 10.32 | [-]
β0,fan,cd = 0.02041 | [-]
β1,fan,cd = 0.1802 | [-]
β2,fan,cd = -0.8154 | [-]
β3,fan,cd = 2.231 | [-]
Aex,fan,cd = 0.196 | [m²] | Dfan,cd = 0.5 | [m]
rpmfan,cd = 950 | [rpm]

Va,mh,ev = 2587 [m³/h] Va,mh,ev,20 = 2715 [m³/h]

Va,mh,cd = 616.8 [m³ V | /h] a,mh,cd,20 = 568 [m³/h]

tcd = 37.26 [C]

tev = -5.149 [C]

Operating_mode= Operating_mode= Heating_mode

RHout = 0.87 [-]

Evaporator

Condenser

Power consumtions

Outdoor conditions | Performances

Outdoor Unit

Indoor Unit

Indoor conditions

Speed_fan_indoor_unit$= Medium

Air-conditioning unit

Medium class-4.5kW; COP 3.1

Qheat = 4357 [W]

Hzcp = 50 [tr/s]

General Inputs

Variable Inputs

Mice = 0 [kg/s] Qice = 0 [W]

### 4. Simplified modelling in cooling mode

### 4.1 Modelling

The simplest modelling consists in expressing the nominal cooling capacity and the corresponding electrical consumption as polynomial functions of two independent variables:

1) The outdoor air temperature;
2) The indoor air temperature, associated to a reference relative humidity (50%).

Qcooling,full,nom=C1capacity+C2capacity*tin+C3capacity*tin

2
+C4capacity*tin

3
+C5capacity*tout+C6capacity*tout

2
+C7capacity*tout

3
+C8capacity*tin*tout+C9capacity*tin*tout2 +C10capacity*tin

2
*tout+C11capacity*tin

2

*tout2

Wcooling,full,nom=C1power+C2power*tin+C3power*tin

2
+C4power*tin

3

+C5power*tout+C6power*tout2

+C7power*tout3

+C8power*tin*tout+C9power*tin*tout

2
+C10power*tin

2
*tout+C11power*tin

2
*tout

2

With the help of the reference model, correction factors can be identified, in order to take into account the effects of the actual indoor relative humidity and of the actual fan speed:

Wcooling,full = Wcooling,full,nom · Cpower,relhum · Cspeed,power

Qcooling,full = Qcooling,full,nom · Ccapacity,relhum · Cspeed,capacity

Relative humidity correction factors

Both correction factors can be defined as functions of a relative humidity ratio:

ratioRH,in =

1
RHin
These functions are identified in Figures 5 and 6:

Figure 5: Cooling capacity ratio as function of relative humidity ratio

0 | 1 | 2 | 3 | 4 | 5 | 6 | 7 | 8

0.9

0.95

1

1.05

1.1

1.15

1.2

1.25

ratiorelativ e,hum idity [-]

### ratiocooling,capacity [-]

rap Q | rapQ=1.57639 | - | 0.425714·rap R H | + | 0.071944 1·rap R H 2
tin | =27°C; | tout=35°C | ; RHout=0.5 | [-]

rapQ=0.95

Figure 6: Power consumption ratio as function of relative humidity ratio

Two different zones of relative humidity ratio must be distinguished:

1) from 0 to 2.9, where both the cooling capacity and electrical power ratios present a (second degree) parabolic variation;
2) above 2.9, where both ratios stay constant.

For these two zones, the corrections factors can be defined as follows:

For cooling capacity:

Ccapacity,relhum = CoolingCapacityRHCorection ( ratioRH,in )

If ( ratioRH,in >= 2.9 ) Then

CoolingCapacityRHCorection := 0.95

CoolingCapacityRHCorection := 1.57639 – 0.425714 · ratioRH,in + 0.0719441 · ratioRH,in

2

For electrical power consumption:

Cpower,relhum = PowerRHCorection ( ratioRH,in )

If ( ratioRH,in >= 2.9 ) Then

PowerRHCorection := 0.985

PowerRHCorection := 1.17378 – 0.12786 · ratioRH,in + 0.0214478 · ratioRH,in

2

A similar law can be used to define the sensible heat ratio (Figure 7):

SHR = SensibleHeatRatio ( ratioRH,in )

If ( ratioRH,in >= 2.9 ) Then

0 | 1 | 2 | 3 | 4 | 5 | 6 | 7 | 8

0.97

0.98

0.99

1

1.01

1.02

1.03

1.04

1.05

1.06

1.07

ratiorelativ e,hum idity [-] ratiopower,consumption [-]

ra pW

| rapW = 1.17378 | --0.12786·rapRH 0.12786·rapRH | + + 0.0214478·rapRH rap 0.0214478·rapRH ² | 2 W = 1.17378

ra p Q =0 .9 5

tin | =2 7 °C ; | tout=3 5 °C | ; R H out=0 .5 | [-]

SensibleHeatRatio := 100

SensibleHeatRatio := – 0.550793 + 0.95039 · ratioRH,in – 0.144445 · ratioRH,in

2

Figure 7: Sensible heat ratio as function of relative humidity ratio

Fan speed correction factors

A set of constant values can be identified for the fan speed correction factors:

Cspeed,capacity = SpeedFanEvCorectionFactor ( Speedfan,indoor,unit$ )

If ( Speedfan,indoor,unit$ = 'High' ) Then

SpeedFanEvCorectionFactor := 1.019

If ( Speedfan,indoor,unit$ = 'Medium' ) Then

SpeedFanEvCorectionFactor := 1

If ( Speedfan,indoor,unit$ = 'Low' ) Then

SpeedFanEvCorectionFactor := 0.994

If ( Speedfan,indoor,unit$ = 'Silent Operation' ) Then

SpeedFanEvCorectionFactor := 0.983

Qcooling,full = Qcooling,full,nom · Ccapacity,relhum · Cspeed,capacity

If ( Speedfan,indoor,unit$ = 'High' ) Then

SpeedFanCompressorFactor := 1.016

If ( Speedfan,indoor,unit$ = 'Medium' ) Then

SpeedFanCompressorFactor := 1

0 | 1 | 2 | 3 | 4 | 5 | 6 | 7 | 8

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
ratio re la tiv e ,h u m id ity [-]

SHR (sensible heat ratio) [%]

SHR ev

| S H R e v S H R e v = 1 0 0 %
S H R e v = -5 5 . 0 7 93 | + | 9 5 . 0 3 9 ·ra p RH | - | 1 4.4 4 4 5 ·ra p S H R | RH2 e v = -5 5 . 0 7 93 | + | 9 5 . 0 3 9 ·ra p RH | - | 1 4.4 4 4 5 ·ra p RH2
tin | = 2 7 ° C ; | t o u t= 3 5 ° C | ; | R H o u t= 0 .5 | [-]

If ( Speedfan,indoor,unit$ = 'Low' ) Then

SpeedFanCompressorFactor := 0.964

If ( Speedfan,indoor,unit$ = 'Silent Operation' ) Then

SpeedFanCompressorFactor := 0.953

Part load correction factor

In part load, we suppose that the RAC is working in ON-OFF. This control mode generates some performances losses due to:

- frequent start-up of the compressor;
- system instabilities at the start-up (the steady-state condition are generally achieved after 5 – 10 min after start-up);
- (small) auxiliary power consumption (6W for the electronic device).

On the basis of literature information gathered in Task 4, we suppose that the system performance degradation can be described by the curves given in Figure 8.

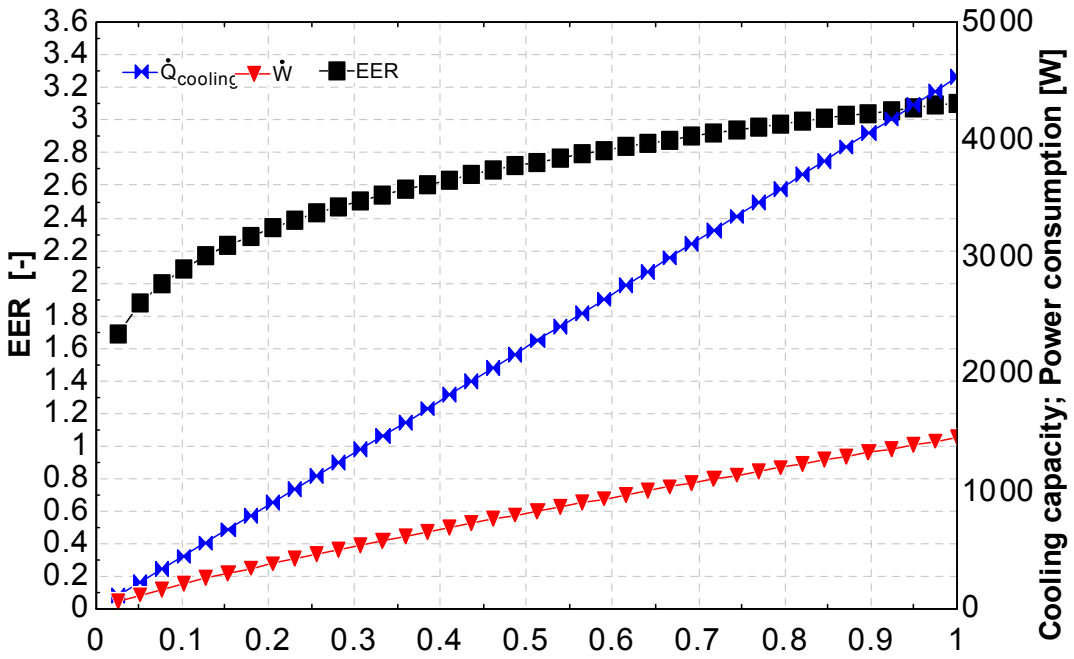
[picture p126: figure]
EER [-]; EER; Cooling capacity; Power consumption [W]; Qcooling

Figure 8: Part load system EER

In order to obtain such performance curves, we use as control variable the ON time and the total time of the period considered. This control variable is called “cooling capacity ratio” hereafter.

Cooling capacity/ Nominal cooling capacity [-]

Due dynamic effects in ON/OFF regime, the cooling part load factor stays always (a little) below the above defined control variable. The ratio between these two variables is called “capacity part load correction” hereafter.

These definitions give the following expression of the cooling power as function of the full load cooling power (currently called “cooling capacity”) in given surrounding conditions:

Qcooling | = Qcooling,full · ratiocooling,capacity | · Ccapacity,part,load
W | = | Wcooling,full · Cpower,part,load

with

C_capacity_part_load=CoolingCapacityCorrection C_power_part_load=CompressorPowerFactorCorection

The two correction factors are correlated to the cooling capacity ratio thanks to the following functions:

FUNCTION CoolingCapacityCorrection:

* full load

IF ratio_cooling_capacity=1 | then
CoolingCapacityCorrection=1

endif

*part load

IF ratio_cooling_capacity<1 | then

CoolingCapacityCorrection=

0.961006 + 0.0543636 x ratio_cooling_capacity- 0.0151515*(ratio_cooling_capacity)²

endif
end

FUNCTION CompressorPowerFactorCorrection:

* full load

IF ratio_cooling_capacity=1 | then
CompressorPowerFactorCorection=1

endif

*partload

IF ratio_cooling_capacity<1 | then

CompressorPowerFactorCorrection =

(ratio_cooling_capacity⁰.85)*(1.02301-0.0356631 x (ratio_cooling_capacity) + 0.0127928 x (ratio_cooling_capacity)²
)

endif
end

The empirical model flow chart is presented in Figure 9:

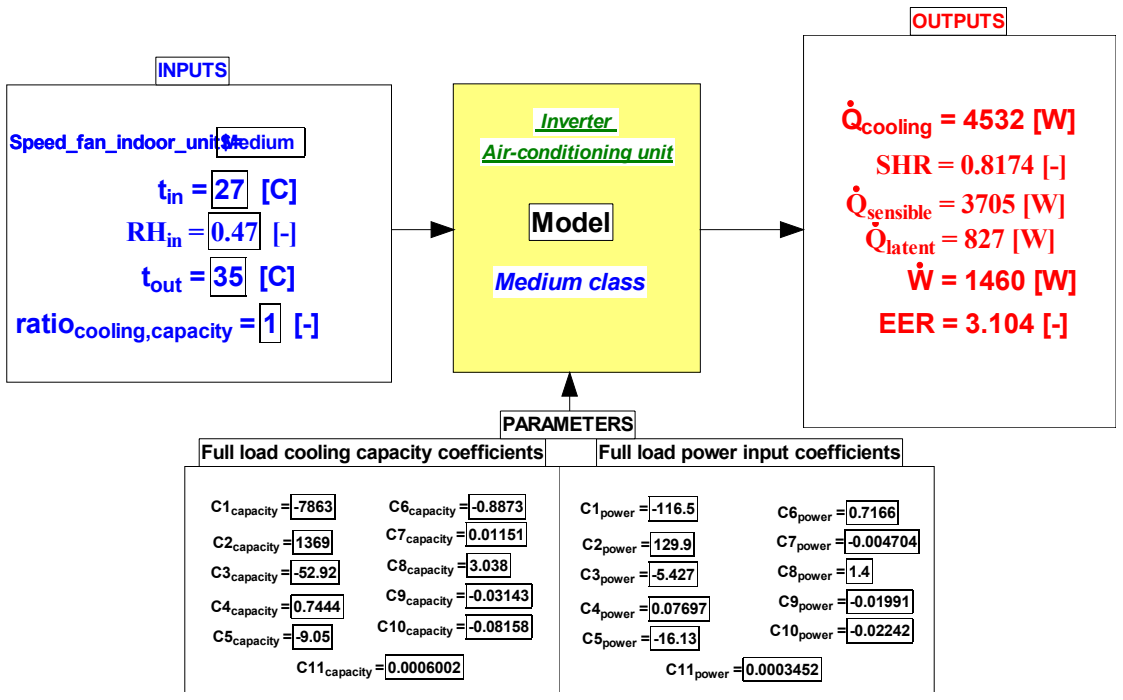
[picture p127: figure]
C10capacity = -0.08158; C11capacity = 0.0006002; C1capacity = -7863; C2capacity = 1369; C3capacity = -52.92; C4capacity = 0.7444; C5capacity = -9.05; C6capacity = -0.8873; C7capacity = 0.01151; C8capacity = 3.038; C9capacity = -0.03143; Full load cooling capacity coefficients; Full load power input coefficients; C10power = -0.02242; C11power = 0.0003452; C1power = -116.5; C2power = 129.9; C3power = -5.427; C4power = 0.07697; C5power = -16.13; C6power = 0.7166; C7power = -0.004704; C8power = 1.4; C9power = -0.01991; PARAMETERS; Model; tout = 35; Qcooling = 4532 [W]; tin = 27; EER = 3.104 [-]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

Figure 9: Empirical model flow chart (nominal cooling mode)

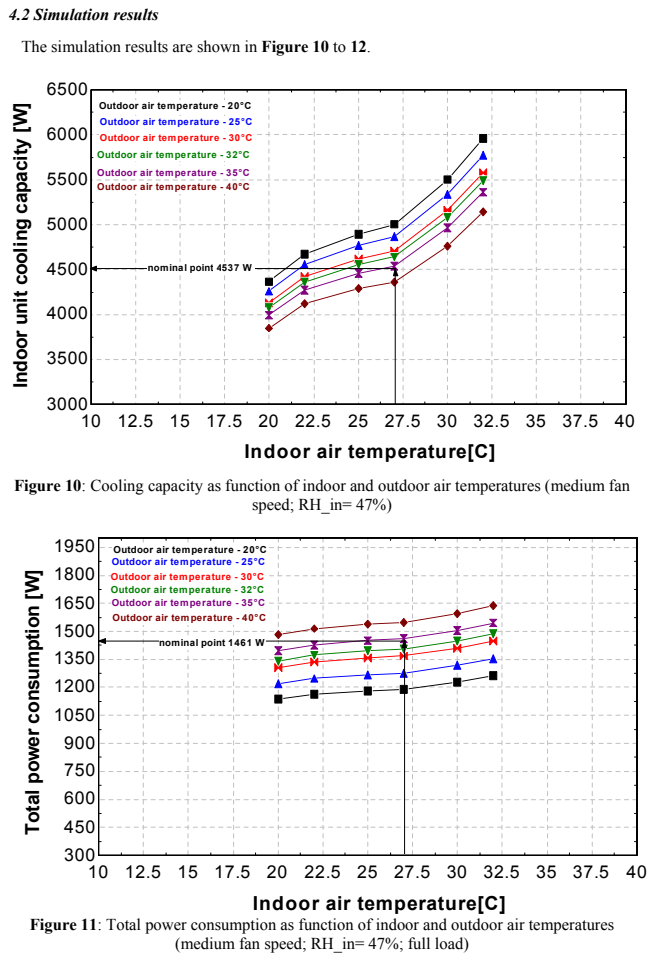
[picture p128: page 13]
speed; RH_in= 47%); nominal point 4537; Outdoor air temperature

4.2 Simulation results
The simulation results are shown in Figure 10 to 12.

Outdoor air temperature - 20°C Outdoor air temperature - 25°C

Indoor unit cooling capacity [W]

Outdoor air temperature - 30°C Outdoor air temperature - 32°C

Outdoor air temperature - 35°C
Outdoor air temperature - 40°C

Indoor air temperature[C]

Figure 10: Cooling capacity as function of indoor and outdoor air temperatures (medium fan

Outdoor air temperature | - 20°C
Outdoor air temperature | - 25°C - 30°C

Total power consumption [W]

Outdoor air temperature | - 32°C

Outdoor air temperature | - 40°C

nominal point 1461 | W

Figure 11: Total power consumption as function of indoor and outdoor air temperatures

(medium fan speed; RH_in= 47%; full load)

Figure 12: RAC EER as function of indoor and outdoor air temperatures (medium fan speed; RH_in= 47%; full load)

### 5. Simplified modelling in heating mode

### 5.1 Modelling

The simplest modelling consists in expressing the heating nominal capacity and the corresponding electrical consumption as polynomial functions of two independent variables:

1) The outdoor air temperature (the effect of outdoor humidity can be, neglected in fair approximation);
2) The indoor air temperature.

Qheating,full,nom=C1capacity+C2capacity*tin+C3capacity*tin

2
+C4capacity*tin

3
+C5capacity*tout+C6capacity*tout

2
+C7capacity*tout

3

+C8capacity*tin*tout+C9capacity*tin*tout

2
+C10capacity*tin

2
*tout+C11capacity*tin

2
*tout

2

Wheating,full,nom=C1power+C2power*tin+C3power*tin

2
+C4power*tin

3
+C5power*tout+C6power*tout

2
+C7power*tout

3
+C8power*tin*tout+C9power*tin*tout2 +C10power*tin

2
*tout+C11power*tin

2

*tout2

With the help of the reference model, these laws can be corrected in order to take into account the effects of the fan speed:

W_dot_heating_full=W_dot_heating_full_nom*C_speed_power Q_dot_heating_full=Q_dot_heating_full_nom*C_speed_capacity

10 12.5 15 17.5 20 22.5 25 27.5 30 32.5 35 37.5 40

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
### Indoor air temperature[C]

### EER[-]

Outdoor air temperature - 20°C Outdoor air temperature - 25°C Outdoor air temperature - 30°C Outdoor air temperature - 32°C

Outdoor air temperature - 35°C Outdoor air temperature - 40°C

nominalpoint- 3.1 [-]

Fan speed correction factors

Again here, a set of constant values can be identified for the fan speed correction factors:

C_speed_capacity=SpeedFanCdCorectionFactor(Speed_fan_indoor_unit$)

with:

FUNCTION SpeedFanCdCorectionFactor(Speed_fan_indoor_unit$)

IF (Speed_fan_indoor_unit$='High') then

SpeedFanCdCorectionFactor=1.019
endif
IF (Speed_fan_indoor_unit$='Medium') then

SpeedFanCdCorectionFactor=1
endif
IF (Speed_fan_indoor_unit$='Low') then

SpeedFanCdCorectionFactor=0.994
endif
IF(Speed_fan_indoor_unit$='Silent Operation') then

SpeedFanCdCorectionFactor=0.983
endif

end

C_speed_power=SpeedFanCompressorFactor(Speed_fan_indoor_unit$)

FUNCTION SpeedFanCompressorFactor(Speed_fan_indoor_unit$)

IF (Speed_fan_indoor_unit$='High') then

SpeedFanCompressorFactor=1.016
endif
IF (Speed_fan_indoor_unit$='Medium') then

SpeedFanCompressorFactor=1
endif
IF (Speed_fan_indoor_unit$='Low') then

SpeedFanCompressorFactor=0.964
endif
IF(Speed_fan_indoor_unit$='Silent Operation') then

SpeedFanCompressorFactor=0.953
endif
end

Part load correction factor

Again in part load, we suppose that the RAC is working in ON-OFF, with the same causes of performances degradations as in cooling mode, except that the auxiliary power consumption is here increased (30 W for the crank case heater).

Figure13 gives the system performance degradation function of load factor.
The same types of correlations as in cooling mode are used to reproduce this degradation.

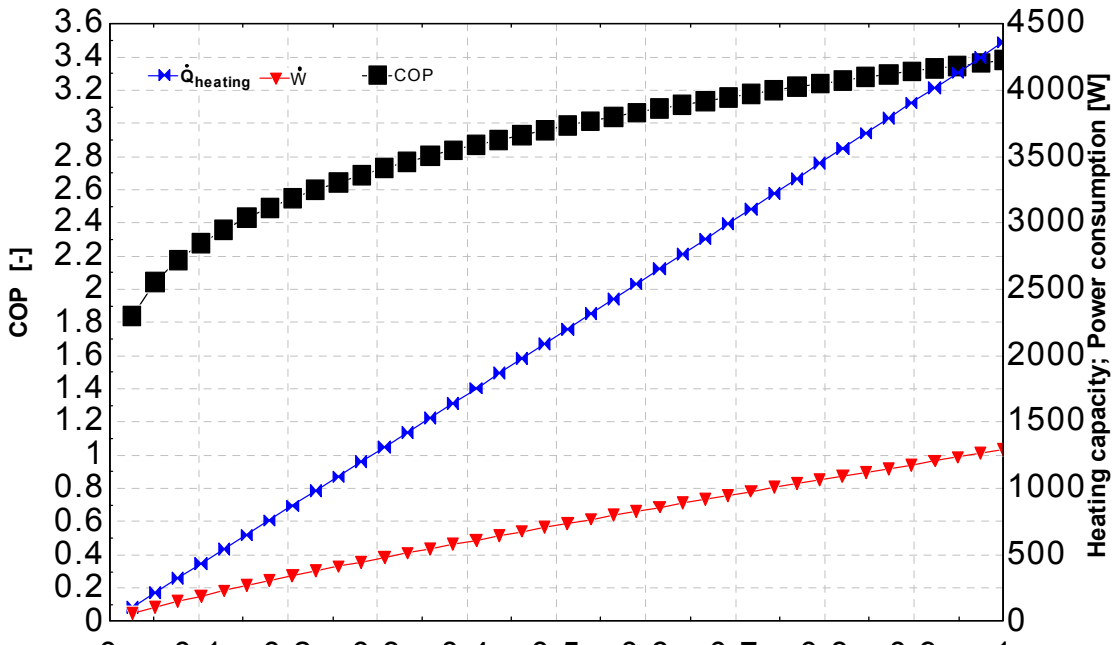
[picture p129: figure]
COP [-]; Qheating; COP; Heating capacity; Power consumption [W]

Figure 13: Part load system COP

Again here, the control variable is supposed to be the ON time fraction called hereafter “heating capacity ratio”. The same two correction factors are used as in cooling mode and both factors are again correlated to the control variable:

FUNCTION HeatingCapacityCorrection:

* full load

IF ratio_heating_capacity=1 | then
HeatingCapacityCorrection=1

endif

0 | 0.1 0.2 0.3 0.4 0.5 0.6 0.7 0.8 0.9 | 1
| Heating capacity/ Nominal heating capacity [-]

*part load

IF ratio_heating_capacity<1 | then

HeatingCapacityCorrection=

0.961006 + 0.0543636 x ratio_heating_capacity- 0.0151515*(ratio_heating_capacity)²

endif
end

FUNCTION CompressorPowerFactor:

* full load

IF ratio_heating_capacity=1 | then
CompressorPowerFactorCorection=1

endif

*partload

IF ratio_heating_capacity<1 | then

CompressorPowerFactorCorection =

(ratio_heating_capacity⁰.85)*(1.02301-0.0356631 | x (ratio_heating_capacity) | + 0.0127928 | x
(ratio_heating_capacity)²
)

endif
end

The empirical model flow chart is presented in Figure 14:

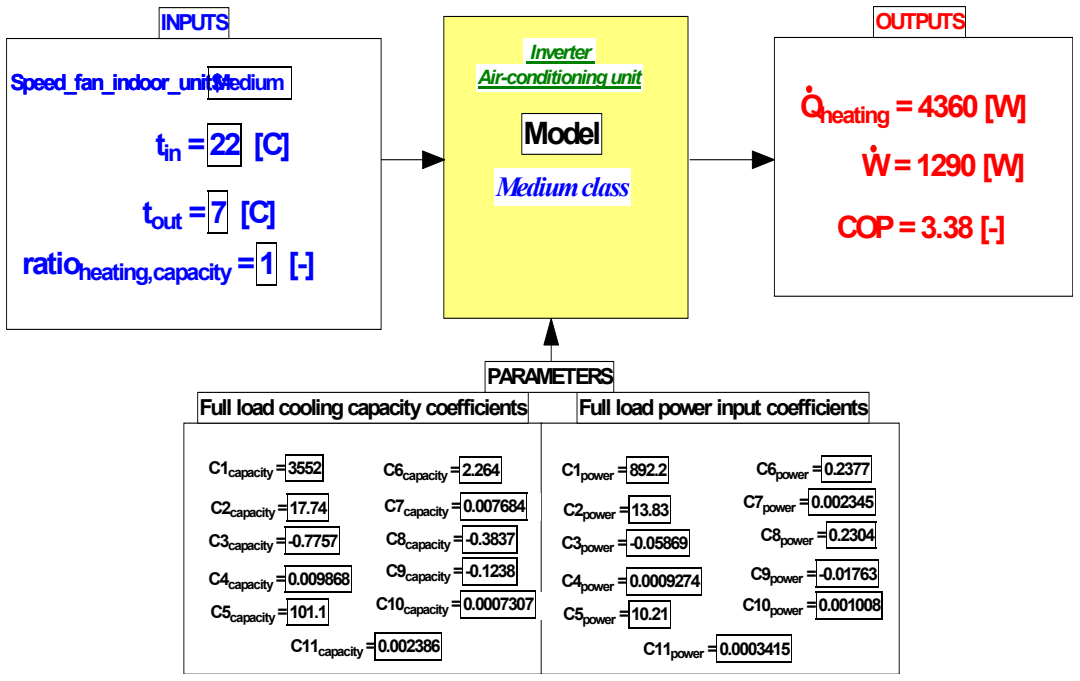
[picture p130: figure]
C10capacity = 0.0007307; C11capacity = 0.002386; C1capacity = 3552; C2capacity = 17.74; C3capacity = -0.7757; C4capacity = 0.009868; C5capacity = 101.1; C6capacity = 2.264; C7capacity = 0.007684; C8capacity = -0.3837; C9capacity = -0.1238; Full load cooling capacity coefficients; Full load power input coefficients; C10power = 0.001008; C11power = 0.0003415; C1power = 892.2; C2power = 13.83; C3power = -0.05869; C4power = 0.0009274; C5power = 10.21; C6power = 0.2377; C7power = 0.002345; C8power = 0.2304; C9power = -0.01763; PARAMETERS; Model; tout = 7; Qheating = 4360 [W]; tin = 22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

Figure 14: Empirical model flow chart (nominal heating mode)

### 4.2 Simulation results

The simulation results are shown in Figure 15 to 17.

Figure 15: Heating capacity as function of indoor and outdoor air temperatures ( medium fan speed)

10 | 12.5 | 15 | 17.5 | 20 | 22.5 | 25 | 27.5 | 30

2000

2250

2500

2750

3000

3250

3500

3750

4000

4250

4500

4750

5000

5250

5500

5750

6000

Indoor air temperature [C]

Indoor unit heating capacity [W]

Outdoor | air | tem perature | =10°C
Outdoor | air tem perature | =6°C
Outdoor | air tem perature | =0°C
Outdoor | air tem perature | =-5°C
Outdoor | air tem perature | =-10°C
nom inal point | - | 4257 | [W ]

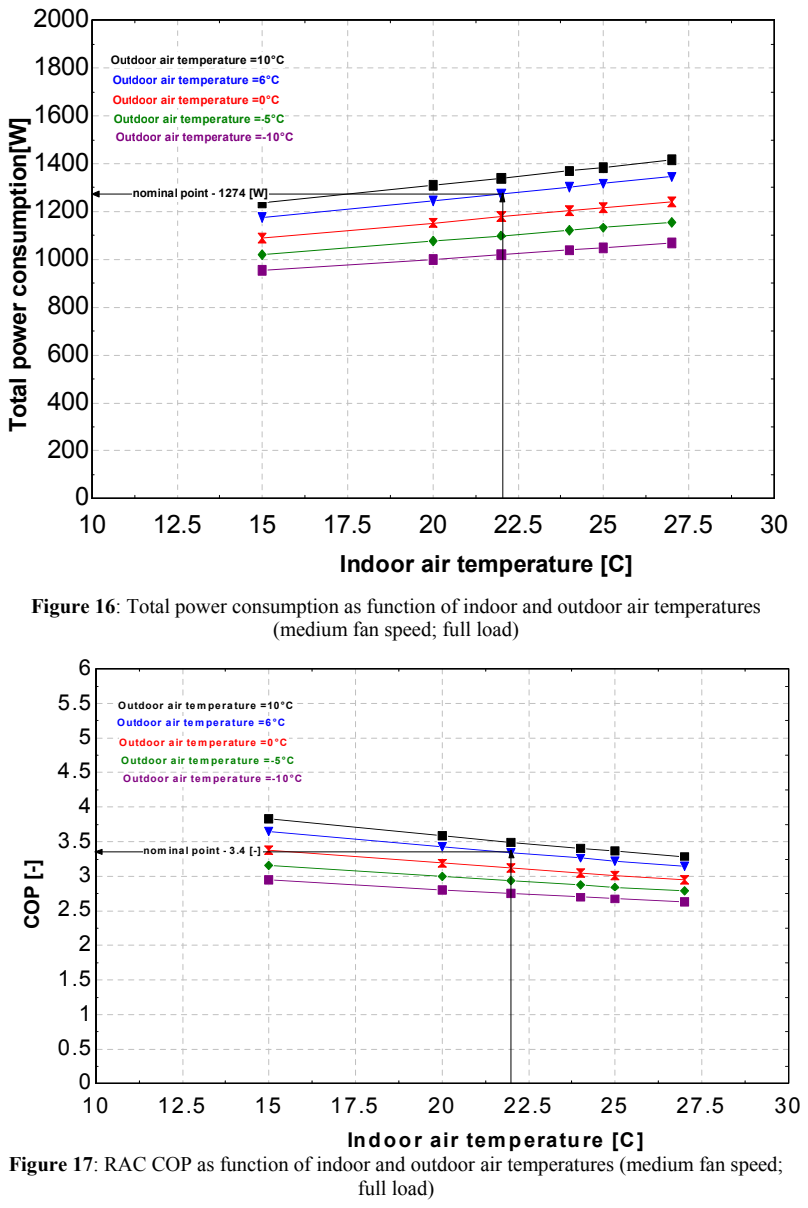
[picture p131: page 19]
full load); nominal point - 1274 [W]; COP [-]; Outdoor; air; tem pera ture; tem perature; tem pe rature; nom inal point

Outdoor air temperature =10°C
Outdoor air temperature =6°C
Outdoor air temperature =0°C
Outdoor air temperature =-5°C Outdoor air temperature =-10°C

Total power consumption[W]

Indoor air temperature [C]

Figure 16: Total power consumption as function of indoor and outdoor air temperatures

(medium fan speed; full load)

Figure 17: RAC COP as function of indoor and outdoor air temperatures (medium fan speed;

### 6. References

BS EN 378-1:2000 – Refrigerating systems and heat pumps – Safety and environmental requirements. Part 1 – 4, 2000

Lebrun J. – Machines et systèmes thermiques. Université de Liège, Faculté des sciences appliquées, Liège, Septembre, 2005

Lebrun J. – System Simulation Synthesis Report, University of Liège, Belgium, report AN10 881020-RF, 1988, 90pp

André Ph., Aparecida C., Hannay Jules, Lebrun J., Lemort V, Teodorese I.V -Simulation of HVAC systems: development and validation of simulation models and examples of practical applications, Keynote presented at Mercofrio 2006, Porto Alegre, Brazil, October17-20 2006

Teodorese I.V. - Modélisation d’une machine frigorifique fonctionnant avec un mélange zéotropique. Thèse de doctorat. Liège, Belgique, 2003

Winandy E.L., - Contribution to the performance analysis of reciprocating and scroll refrigeration compressors - Ph. D. Thesis. Conception, Chile, Decembre 1999
