TKlebig/TimBAgit/BA/Chapters/Abkuerzungen.tex

\chapter*{Nomenklatur}
\begin{onehalfspacing}
\begin{longtable}[h]{p{0.15\textwidth} p{0.65\textwidth} p{0.1\textwidth}}
		\caption*{\textbf{Formelzeichen und Einheiten}} \\
		\\
		\textbf{Symbol} & \textbf{Bedeutung} & \textbf{Einheit} \\ %\hline 
		\endhead
		\\
		\multicolumn{3}{c}{Fortsetzung auf der nächsten Seite} \\
		\endfoot
		\multicolumn{3}{c}{ } \\
		\endlastfoot
		
		$A$ & Fläche & \squaremetre\\
		$a$&Koeffizient&---\\
		$c$ & Schallgeschwindigkeit & \metre\per\second\\
		$c_{p}$&spezifische Wärmekapazität bei konstantem Druck&\joule\per(\kilogram\usk\kelvin)\\
		$C$&Wärmekapazität&\watt\per\kilogram\\		
		$\dot{C}$&Wärmekapazitätsstrom&\watt\per(\kilogram\usk\second)\\
		$C$&Koeffizient&---\\
		$d$ & Durchmesser & \metre\\
		$E$ & Verteilfaktor & ---\\
		$EER$ & Energy Efficiency Ratio & ---\\
		$Fr$&Froudezahl& ---\\
		$h $ & Enthalpie & \joule\\	
		$K$&Hilfsgröße&---\\
		$l$ & Länge & \metre\\
		$\dot{M}$ & Massenstrom & \kilogram\per\second\\	
		$\dot{m}$ & spezifischer Massenstrom & \kilogram\per(\second\usk\metre)\\
		$NTU$ &Anzahl der Übertragungseinheiten (\emph{engl.: Number of transfer units}) & ---\\
		$P$ & Leistung & \watt\\		
		$p$ & Druck & \pascal\\
		$p$ & Druck & \bbar\\
		$\dot{Q}$ & Wärmestrom & \watt\\
		$Re$ & Reynoldszahl & ---\\
		$T$ & Temperatur & \kelvin\\
		$t$ & Zeit & \second\\
		$k$ & Wärmedurchgangskoeffizient & \watt\per(\squaremetre\usk\kelvin)\\		
		$V$ & Volumen & \cubic\meter\\
		$W$ & Wärmeleitwiderstand & \kelvin\per\watt\\
		$\dot{V}$&Volumenstrom&\cubic\meter\per\second\\
		$x$ & Dampfanteil & \%\\
		$Y$ & Wasserbeladung der Luft & \gram\per\kilogram\\

\end{longtable}

\begin{longtable}[h]{p{0.15\textwidth} p{0.65\textwidth} p{0.1\textwidth}}
		\caption*{\textbf{Griechische Formelzeichen}} \\
		\\
		\textbf{Symbol} & \textbf{Bedeutung} & \textbf{Einheit} \\ %\hline 
		\endhead
		\\
		\multicolumn{3}{c}{Fortsetzung auf der nächsten Seite} \\
		\endfoot
		\multicolumn{3}{c}{ } \\
		\endlastfoot

		$\alpha$ & Wärmeübergangskoeffizient & \watt\per(\squaremetre\usk\kelvin)\\
		$\beta$ & Volumenstromverhältnis von flüssiger und gasförmiger Phase & \pascal\\
		$\gamma$ & Versperrungsfaktor & \pascal\\
		$\epsilon$ & Hilfsgröße & \watt\\
		$\epsilon$ & Effektivität & ---\\
		$\eta$ & dynamische Viskosität & \kilogram\per(\metre\usk\second)\\
		$\lambda$ & Wärmeleitwert & \watt\per(\metre\usk\kelvin)\\
		$\nu$&kinematische Viskosität&cSt\\
		$\omega$&Löslichkeit& (\gram KM)\per(\gram Öl)\\
		$\Phi$ & thermische Leistung & \watt\\
		$\psi$ & Hilfsgröße & ---\\
		$\varrho$& Massendichte&\kilogrampercubicmetre\\
			$\sigma$&Temperaturspreizung&\kelvin\\
		$\vartheta $ & Temperatur  & \degreecelsius\\
		$\Delta\vartheta $ & Temperaturdifferenz  &\kelvin\\
		$\xi$ & Reibungsbeiwert & ---\\
		
\end{longtable}
\clearpage

\begin{longtable}[h]{p{0.15\textwidth} p{0.75\textwidth}}
		\caption*{\textbf{Indizes und Abkürzungen}} \\
		\\
		\textbf{Symbol} & \textbf{Bedeutung} \\ %\hline 
		\endhead
		\\
		\multicolumn{2}{c}{Fortsetzung auf der nächsten Seite} \\
		\endfoot
		\multicolumn{2}{c}{ } \\
		\endlastfoot
		
		A & Fluid A \\
		B & Fluid B \\
		Al & Aluminium\\ 
		aus & Ausgang\\		
		Cu & Kupfer \\
		cd & Verflüssiger (\emph{engl.: condensor})\\
		cp & Verdichter (\emph{engl.: compressor})\\ 
		E & ebene Strömung \\   
		EES & Engineering Equation Solver \\
		ein & Eingang \\
		el & elektrisch \\
		ev & Verdampfer (\emph{engl.: evaporator})\\
		F & Flüssigkeit\\	
		G & Gas \\
		i & innen \\
		K & (Kälte-)Kreis\\
		KM & Kältemittel\\
		NI-LabView & Programmiersprache und Entwicklungsumgebung für die Messdatenerfassung der Firma National Instruments\\
		L & Luft\\
		max & Maximum \\
		min & Minimum \\
		P & Durchgang (\emph{engl.: Pass})\\
		r & Verhältnis (\emph{engl.: ratio})\\
		sat & Sättigungszustand (\emph{engl.: saturated})\\
		SH & Überhitzung (\emph{engl.: Superheat})\\
		W & Wasser \\
		WÜ & Wärmeübertrager \\
		
\end{longtable}
\end{onehalfspacing}
