TKlebig/TimBAgit/BA/Chapters/Eigenstaendigkeitserklaerung.tex

\Large
\textbf{Eigenständigkeitserklärung}

\normalsize
Hiermit versichere ich, dass ich die vorliegende Arbeit selbstständig und ohne Benutzung anderer als der angegebenen Hilfsmittel angefertigt habe. Alle Stellen, die wörtlich oder sinngemäß übernommen sind, sind als solche kenntlich gemacht. Die Arbeit ist in gleicher oder ähnlicher Form noch nicht als Prüfungsarbeit eingereicht worden. Ich erkläre mich damit einverstanden, dass die vorliegende Arbeit in der Lehrstuhlbibliothek und Datenbank aufbewahrt und für den internen Gebrauch kopiert werden darf. \newline \newline

Aachen, den \today \newline \newline

%TODO Name ergänzen
Tim Klebig
