TKlebig/TimBAgit/BA/Chapters/Teil4.tex

\chapter{Analyse der Messergebnisse}
\label{cha:Analyse der Messergebnisse}

\chapter{Zusammenfassung}
\label{cha:Zusammenfassung}
Verweis auf Sektion: (siehe \ref{subsec:Abschnitt1})
