TKlebig/TimBAgit/Presentations/cve-tkl_Bergfest_200318.pptx

## [C] Zwischenstand Bachelorarbeit

Modellgestützte Untersuchung und experimentelle Validierung von Verdampferschaltungen zur thermischen Leistungssteigerung für den Einsatz in Kühlmöbeln

- Tim Klebig

Notes: -Arbeit der letzten 5 Monate bei Emerson
-Unterstützung des Teams Integrated Solutions
-Fokus: vertikales Kühlmöbel für Normalkühlung für dessen Produktion Emerson Scrolls stellt
-Abzusehen, dass Beschwerden laut werden weil Produkttemperatur nicht erreicht wird
-Ziel: Optimierung des Betriebes mit Propan bei max. Füllmenge von 150g/Kreis

## Kühlmöbel in Klimakammer

- Prüfstandsaufbau in Klimakammer

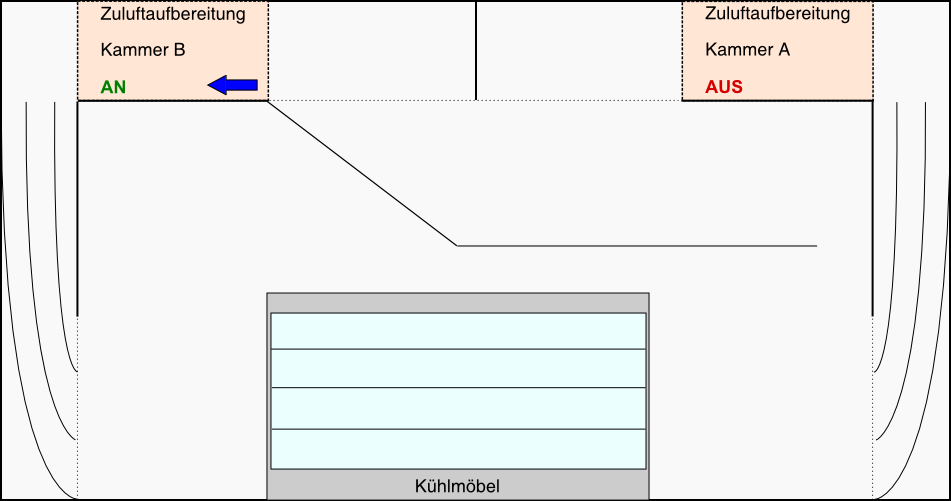
[picture p132: figure]

Notes: -Fusion von zwei kleinen Klimakammern
-Einbau einer Decke um Luftstrom am Kühlmöbel vorbei zu erzwingen
-Zertifikation eines vertikalen Kühlmöbels bei Klimaklasse 3: 25°C, 60% r.F.
-Problem: Hoher Durchmischungsgrad des Luftschleiers -> viel Kälteleitung zur Entfeuchtung nötig

## Der Kältekreislauf

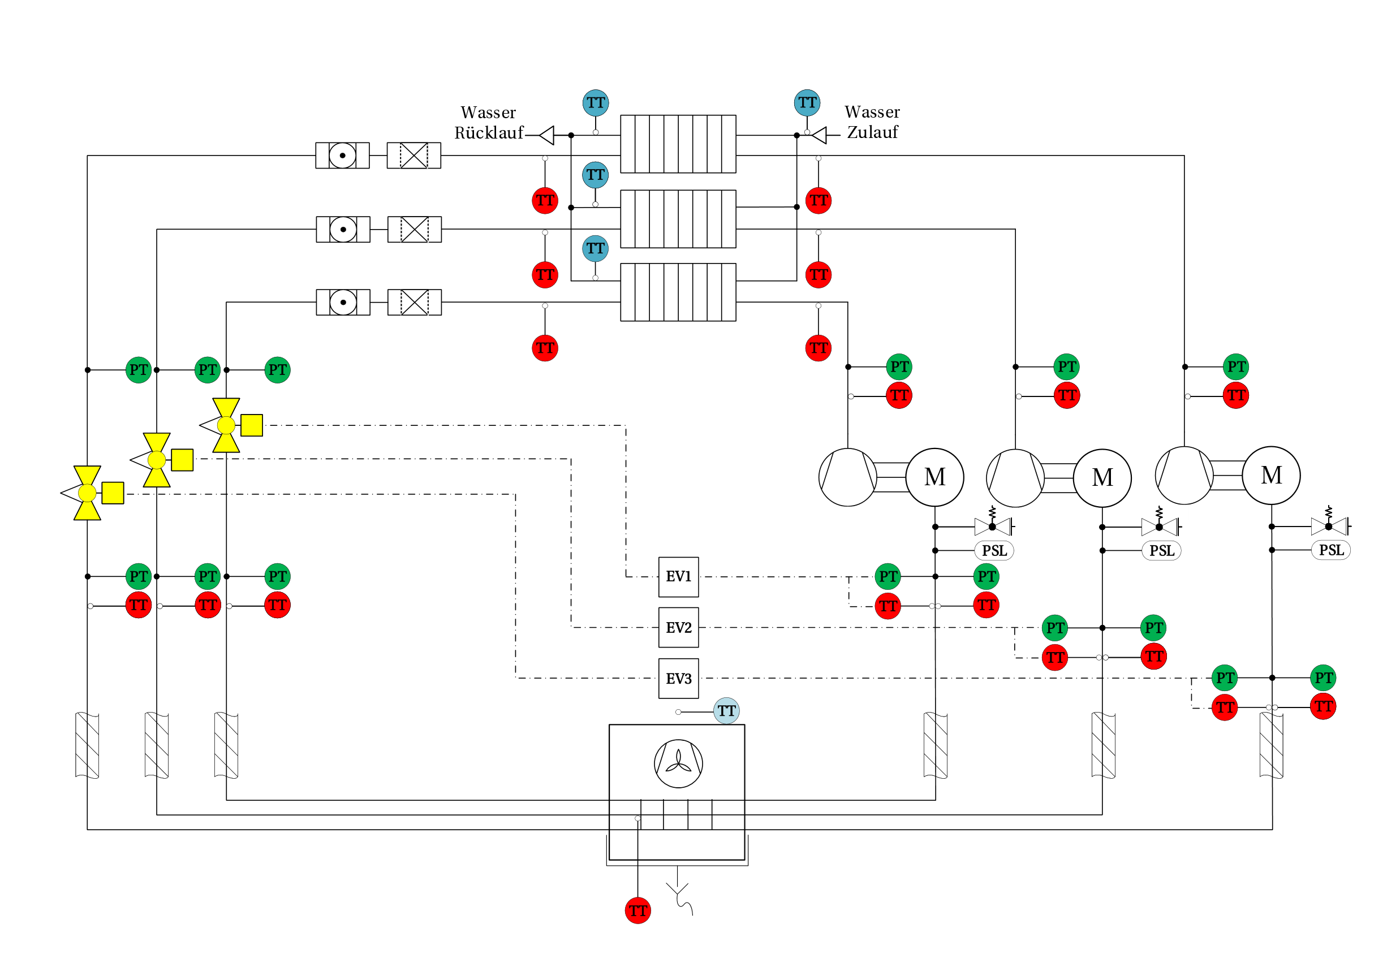
[picture p133: figure]

- Kälteanlage mit drei Propankreisen und Druck-/Temperatursensoren

Notes: -Fokus auf Optimierung des Kältekreislaufes
-Erfassung des Systemverhaltens durch Sensoren an allen wichtigen Positionen
-Kommunikation über Modbus mittels SignalExpress -> Exceldatei
-Optionen: Volumenreduzierung, andere Komponenten, andere Öle, andere Verdampferschaltung

## Übersicht der Arbeit

- Praktische Tätigkeiten
  - Umbau des Kühlmöbels
  - Durchführung der Untersuchungen
- Versuchsauswertung
  - Entwicklung eines Auswertungsprogrammes via Python
  - Zusammenstellen eines Pakets optimaler Komponenten
- Modellierung eines Verdampfers unter verschiedenen Verschaltungen
  - Entwicklung eines Modells via EES
  - Validierung des Modells

Notes: -Vortrag zur Beschreibung der Modellerstellung nutzen
-Durchgeführte Versuche: Vergleich von Ölen, Kompressoren, Validierung des Modells
-Weg von: wir verkaufen Scrolls, hin zu: wir verkaufen ganzheitl. Lösung und garantieren Funktion!

## Verschaltung der Verdampferpässe

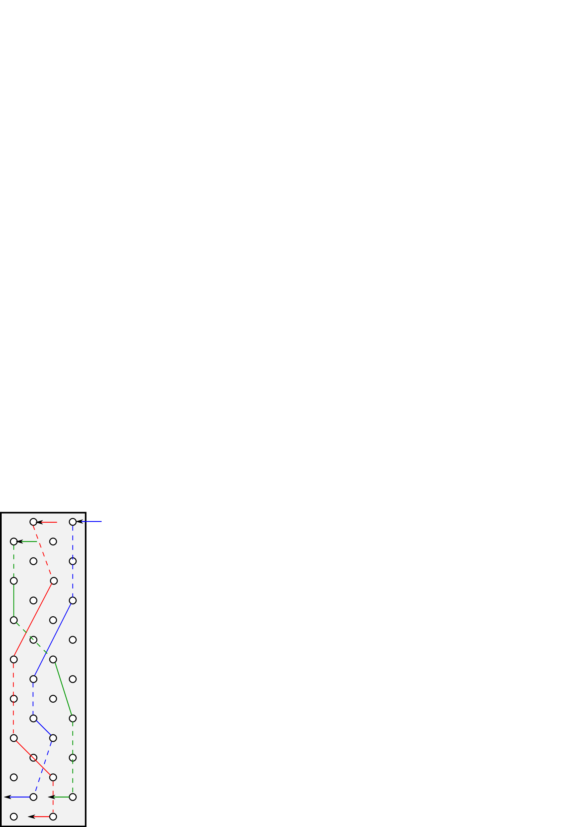
[picture p134: figure]

Verdampfer V1
Gegenstromverschaltung verhält sich wie Gleichstromverschaltung

Verdampferreihe

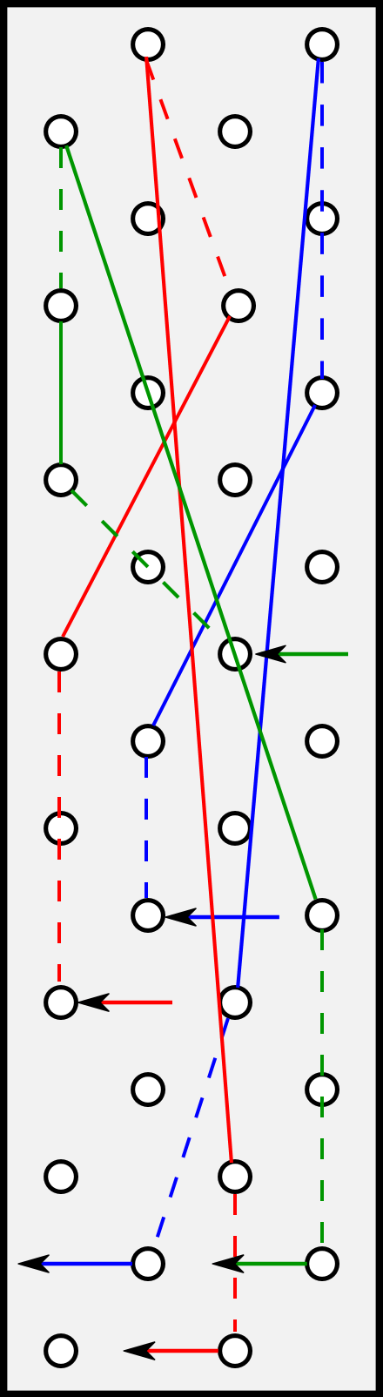
[picture p135: figure]

Verdampfer V2
Kombination aus Gleich- und Gegenstromverschaltung verhält sich wie reiner Gegenstrom
Größeres ΔT

Verdampferreihe

Temperatur

Temperatur

ΔT

ΔT

Luft

Luft

Notes: Hoher Massenstrom bei kleinem Rohrdurchmesser -> großer Druckabfall -> Absinken der Verdampfungstemperatur
Effekt nutzbar machen durch Veränderung der Reihenfolge der Pässe

## Modellierung mit EES

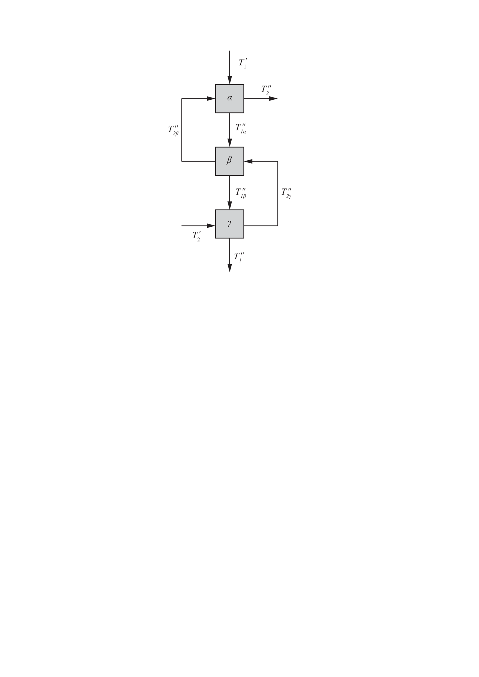
[picture p136: figure]

- Funktionen
  - Integrierte mathematische/thermophysikalische Funktionen
  - Zugriff auf große Stoffdatenbank
  - Objektorientierte Modellierung nur begrenzt möglich
    - Erstellung eines deterministischen Gleichungssystems
    - Hoher Schreibaufwand
- Bestimmung von Guesswerten und Limits
  - Mit steigender Anzahl von Gleichungen reagiert EES sensibel auf Änderung der Werte
    - Hoher Zeitaufwand durch Trial & Error
- Modellbildung anhand von Zellenmethode
  - Je Verdampferpass eine Zelle
  - Berechnung anhand von Eingangsgrößen
  - Bestimmung von Druckabfall und Kälteleistung
    - Ermittlung der Ausgangsgrößen

Notes: -Lösung von Gleichungssystemen unabhängig von der Reihenfolge
-Limits: →Eingrenzen der Rechnung und verhindern von mathematischen Fehlern

## Berechnung des Druckabfalls

- ∆p=ξ_D (m^2 x^2)/(4ρ_D)(1/(1−γ))^2 l
- γ → Versperrungsfaktor für den Dampfstrom durch die Flüssigkeit
- γ=γ_F (1−E)+γ_E E
- E=1.857+0.815log(((mx)/(ρ_G c_G))^2 (1+ (4575 ρ_G^2)/(ρ_L^2))) → Verteilparameter
  - E=0: Ringströmung mit Schwallen
  - E=1: ebene beschleunigte Strömung
- Probleme:
  - Berechneter Druckabfall in überhitztem Bereich ist von kleinerer Größenordnung
  - Abweichung bei geringen Massenstromdichten höher

Notes: -basierend auf Modell nach Kesper aus VDI-Wärmeatlas
-Probleme: E nimmt Werte außerhalb von 0 und 1 an -> nicht uneingeschränkter Gültigkeitsbereich

## Berechnung der Kälteleistung

- Berechnung mithilfe der ε -NTU-Methode
  - Q=ε m_(Luft) c_(P,Luft) (T_(Luft,ein) −T_(KM,ein) )
  - ε=1 − e^(−NTU) (für Verdampfungsprozess)
  - NTU= (UA)/(m_(Luft) c_(P,Luft))
  - UA= 1/(∑ R)
- Wärmeleitungswiderstände
  - R= 1/(α d π l) bzw. R= t/(λ d π l)
  - Annahmen:
    - α_(Luft) = 292 W/(m^2 K)
    - α_(Km) = 50000 W/(m^2 K)
    - α_(Km,SH) = 29 W/(m^2 K)
- Problem:
  - Zu geringe Kälteleistung
    - Rechnung mit äquivalenter Temperatur

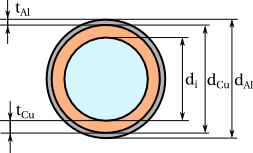
[picture p137: figure]

Notes: - ε -NTU-Methode nur gültig für trockene Luft → Validierung unter trockenen Bedingungen nötig
-Ausgangswerte mithilfe von Energiebilanz bestimmbar
-Unterscheidung zwischen Verdampfungsprozess und überhitztem Bereich
-Anpassung der Wärmeübergangskoeffizienten anhand von Versuchsdaten
-Aufgrund zu geringer errechneter Kälteleistung Rechnung mit äquivalenter Temperatur bei 0% rF nötig (5°C bei 40% ~ ca 11°C bei 0%)
-ε-NTU-Methode nur gültig für trockene Luft → Validierung unter trockenen Bedingungen nötig
-Ausgangswerte mithilfe von Energiebilanz bestimmbar
-Unterscheidung zwischen Verdampfungsprozess und überhitztem Bereich
-Anpassung der Wärmeübergangskoeffizienten anhand von Versuchsdaten
-Aufgrund zu geringer errechneter Kälteleistung Rechnung mit äquivalenter Temperatur bei 0% rF nötig (5°C bei 40% ~ ca 11°C bei 0%)

## Ergebnisse der Simulation und der Versuche

| V1 Versuch | V1 EES | V2 EES | V2 Versuch
ΔP | 47192 Pa | 27175 Pa | 29889 Pa | 53672 Pa
Q 0 | 1791 W | 1812 W | 1831 W | 1835 W
T0 | -14.15 °C | -12.23 °C | -12.48 °C | -15.23 °C
m KM | 6.11 g/s | 6.11 g/s | 6.11 g/s | 5.72 g/s
TLuft,Ein | 4.42 °C | 4.42 °C | 4.42°C | 5.07 °C
TLuft,Aus | -5.38 °C | -4.8 °C | -4.95 °C | -5.44 °C
Pel | 2623 W | - | - | 2608 W
COPtot | 1.99 | - | - | 2.09

Notes: -wichtig: konstante Umgebungsbedingungen um reproduzierbare Ergebnisse zu erzielen
-Starke Wechselwirkungen: Raumluft <-> Verdampfungstemperatur <-> Kälteanlage <-> Verflüssigerregelung

## Slide 10

- Tim Klebig
- E-Mail: tim.klebig@eonerc.rwth-aachen.de
