TKlebig/TimBAgit/Presentations/EBC Presentation 1811.pptx

## Energetische Verbesserung eines Propan-Kühlmöbels

Bachelorarbeit

- Tim Klebig

## Auswertung der Messdaten

- Bisher:
  - Aufarbeitung der Daten per Hand (Makro)
  - Auswertung in Excel mithilfe von Diagrammen
- Neue Auswertung:
  - Via Python
  - 3 Messdatendateien werden ausgelesen, auf den selben Zeitstempel gebracht und resamplet
  - Letzter Kühlzyklus wird erkannt
    - Berechnungen mit Mittelwert über 75% des Zyklus (ohne Abtauung)
  - Erstellung von Plots und Ausgabe als Vektorgrafiken

## Excell vs Python

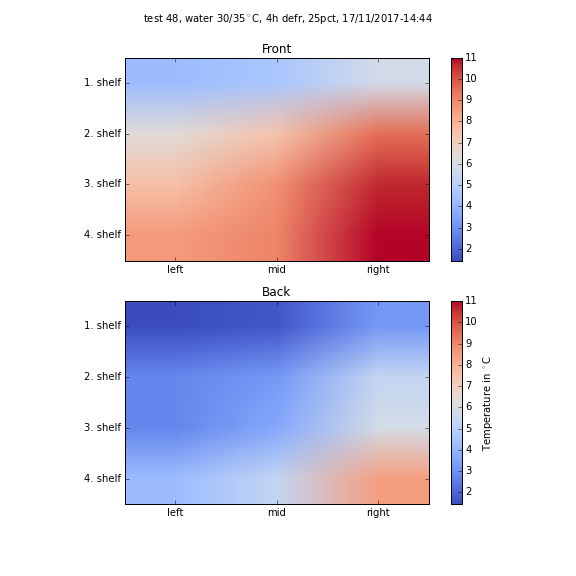
[picture p138: figure]

- Temperatur des Kühlguts

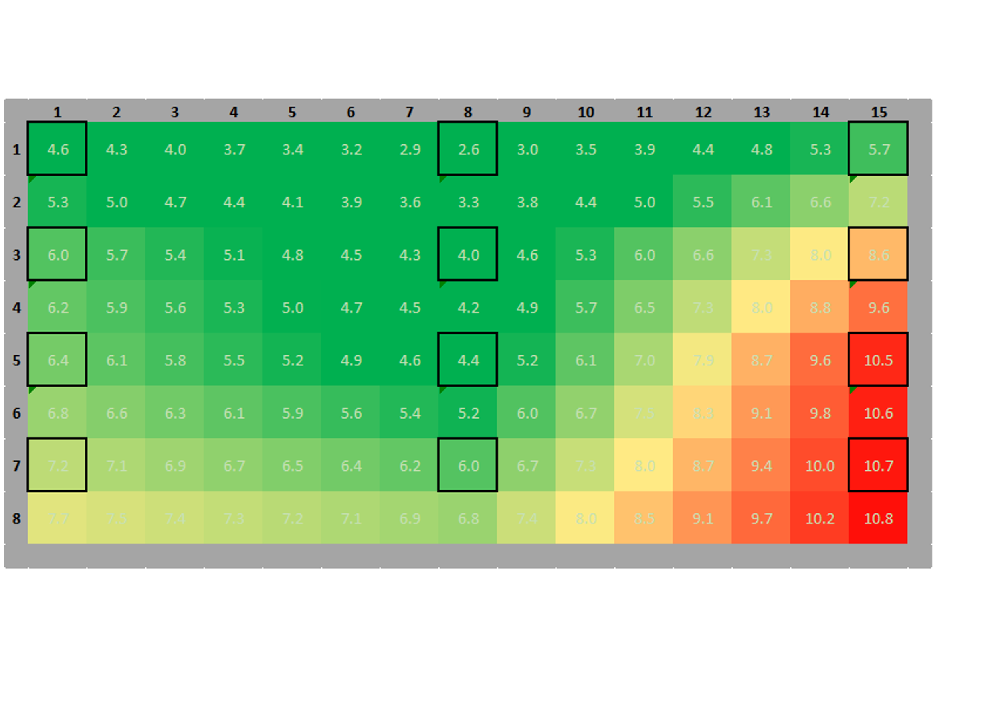
[picture p139: figure]

## Excell vs Python

- Sättigungstemperaturen

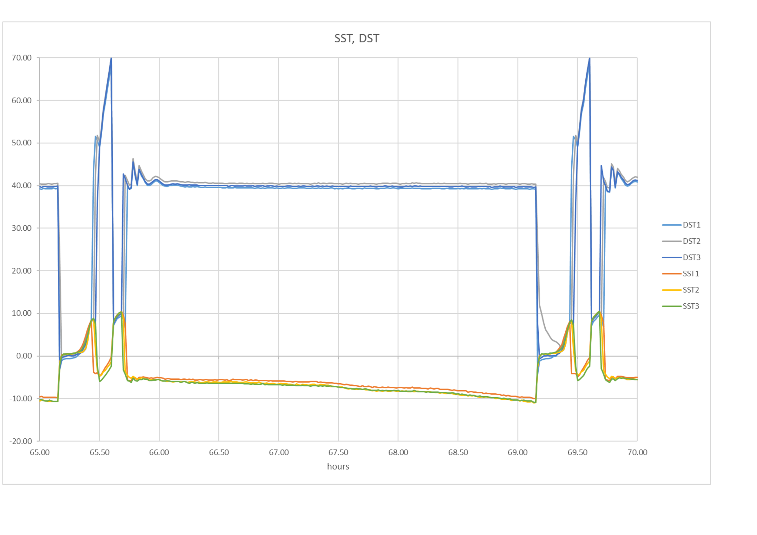
[picture p140: figure]
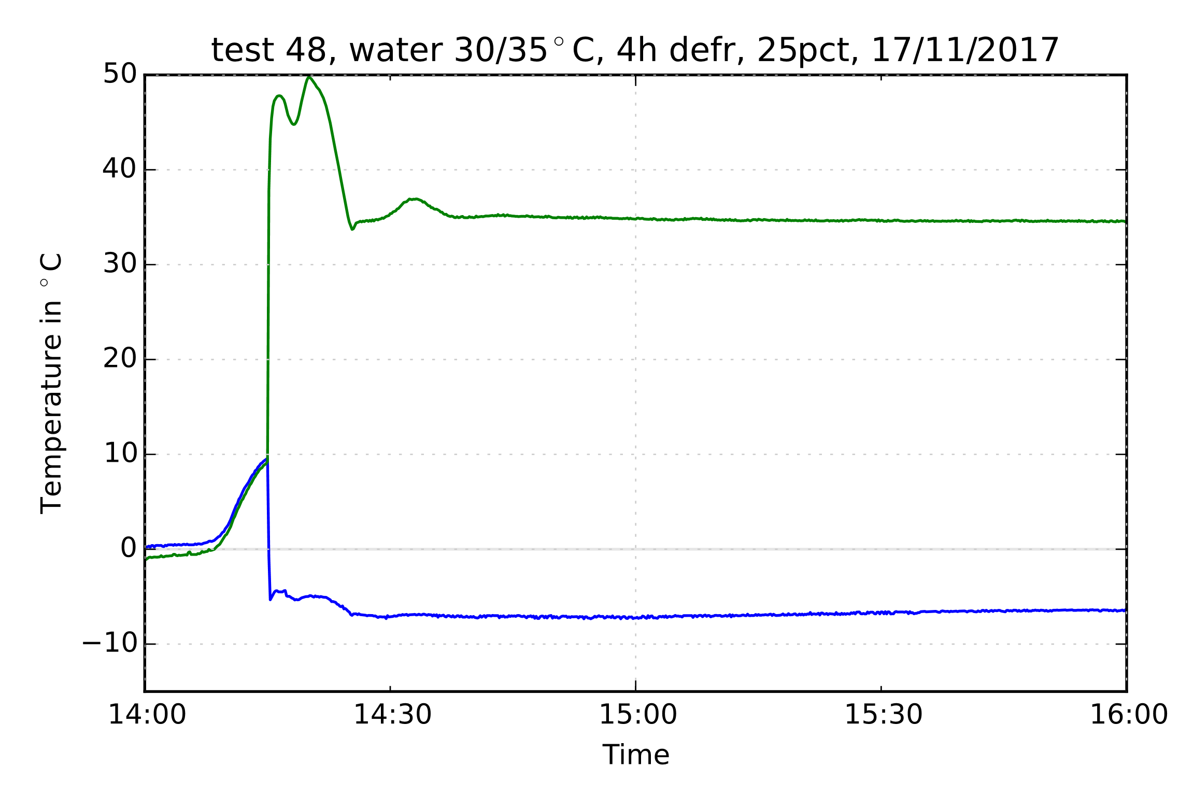
[picture p141: figure]

## Python - Coolprop

- Log p-h Diagramm für

- Coolprop
  - Stoffdatenbank
  - Funktionen für Berechnungen und Plots


## Modellierung der Verschaltung von Verdampferdurchgängen

- Zellenmethode aus dem VDI Wärmeatlas

- Bekannte Größen
  - Massenströme
  - Eingangstemperaturen
  - Geometrie
- Ziel der Modells:
  - Kälteleistung des Verdampfers abhängig von unterschiedlicher Verschaltung von Durchgängen
  - Druckabfall über den Verdampfer
  - Optimum zwischen Kälteleistung und Druckabfall

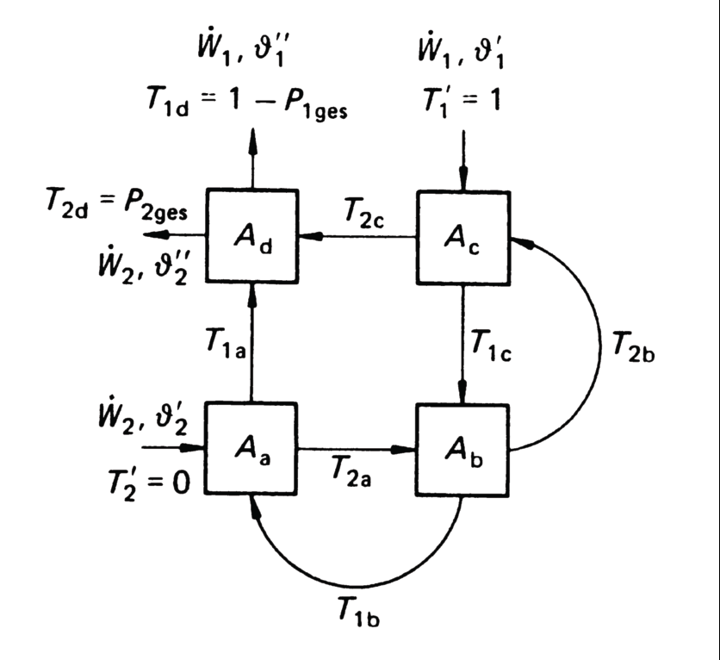
[picture p142: figure]

## Slide 7

- Tim Klebig
- E-Mail: tim.klebig@rwth-aachen.de
