TKlebig/TimBAgit/Presentations/Templates/EBC-Template.pptx

## Titel

Untertitel

- Max Mustermann

## Ziel und Inhalt der Arbeit

## Slide 3

- Max Mustermann
- E-Mail: max.mustermann@rwth-aachen.de
