TKlebig/TimBAgit/Evaporator Coil Design/Verdampfer - Abmessungen.pdf

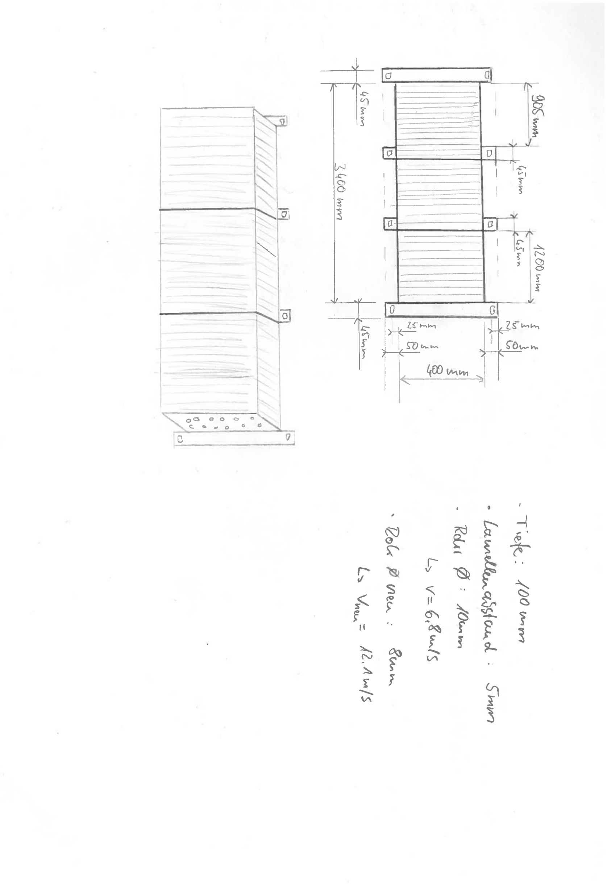
[picture p143: page 1]

L2 ____ | C)
- | -t-- - | I - | --: - /1

0

0 | - | c%

C,

‘I’

0
