TKlebig/TimBAgit/Evaporator Coil Design/Verdampfer - Schema.pdf

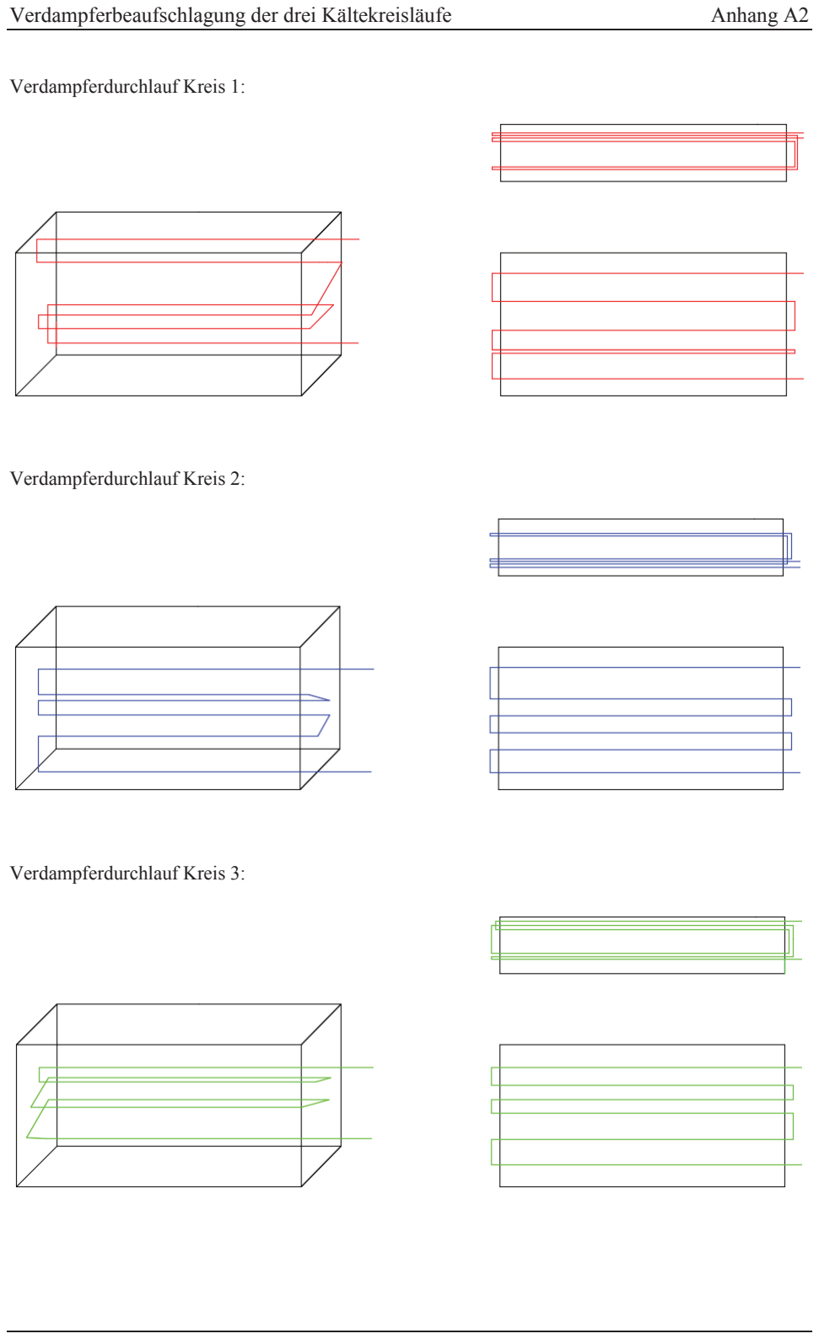
[picture p144: page 1]

Verdampferbeaufschlagung der drei Kältekreisläufe | Anhang A2

Verdampferdurchlauf Kreis 1:

Verdampferdurchlauf Kreis 2:

Verdampferdurchlauf Kreis 3:
