TKlebig/TimBAgit/BA/Pictures/Verdampfer_V2.pdf

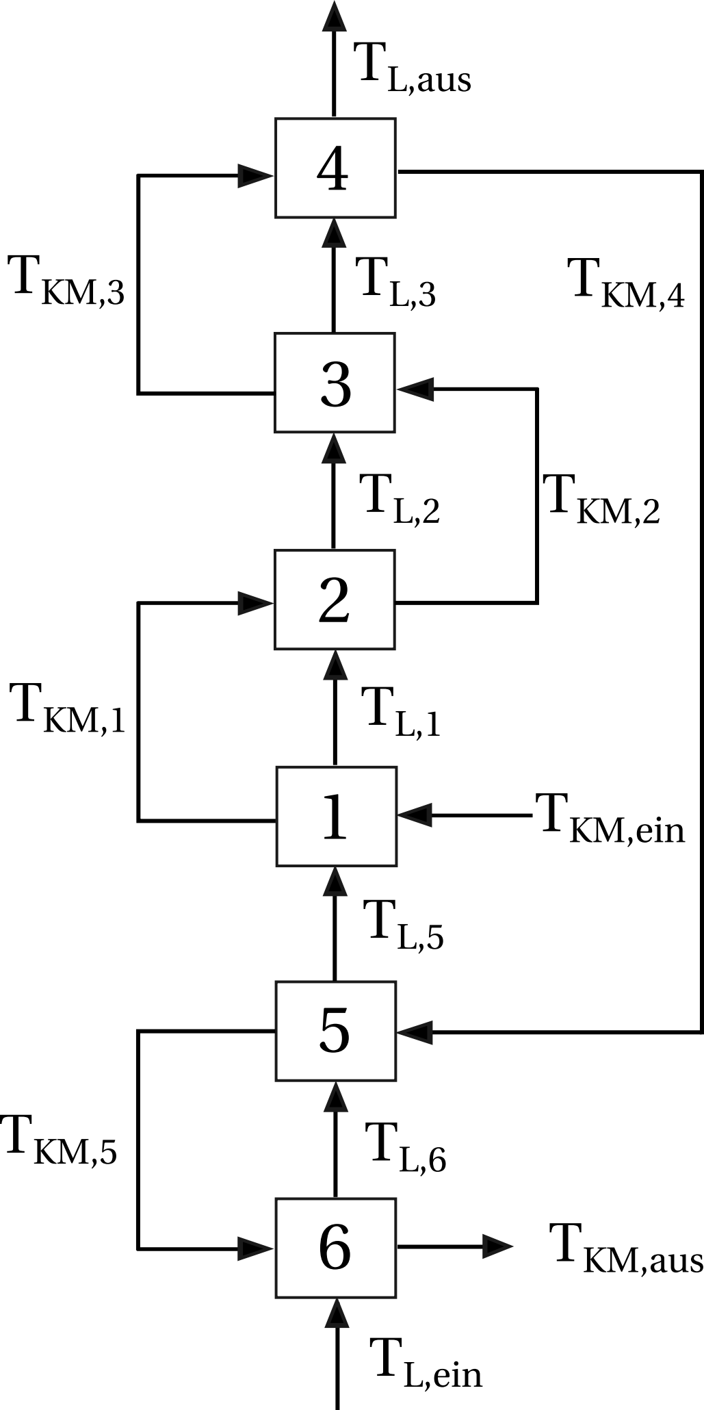
[picture p145: figure]
TL,ein; TL,aus; TKM,ein; TKM,1; TKM,2; TKM,3; TKM,4; TKM,5; TKM,aus
