TKlebig/TimBAgit/BA/Pictures/CabinetLuftstrom.pdf

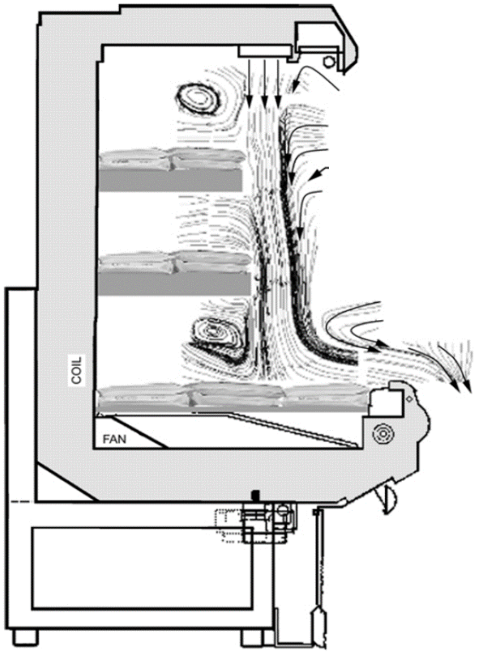
[picture p146: page 1]
