TKlebig/TimBAgit/BA/Pictures/Climate Chamber_flow.pdf

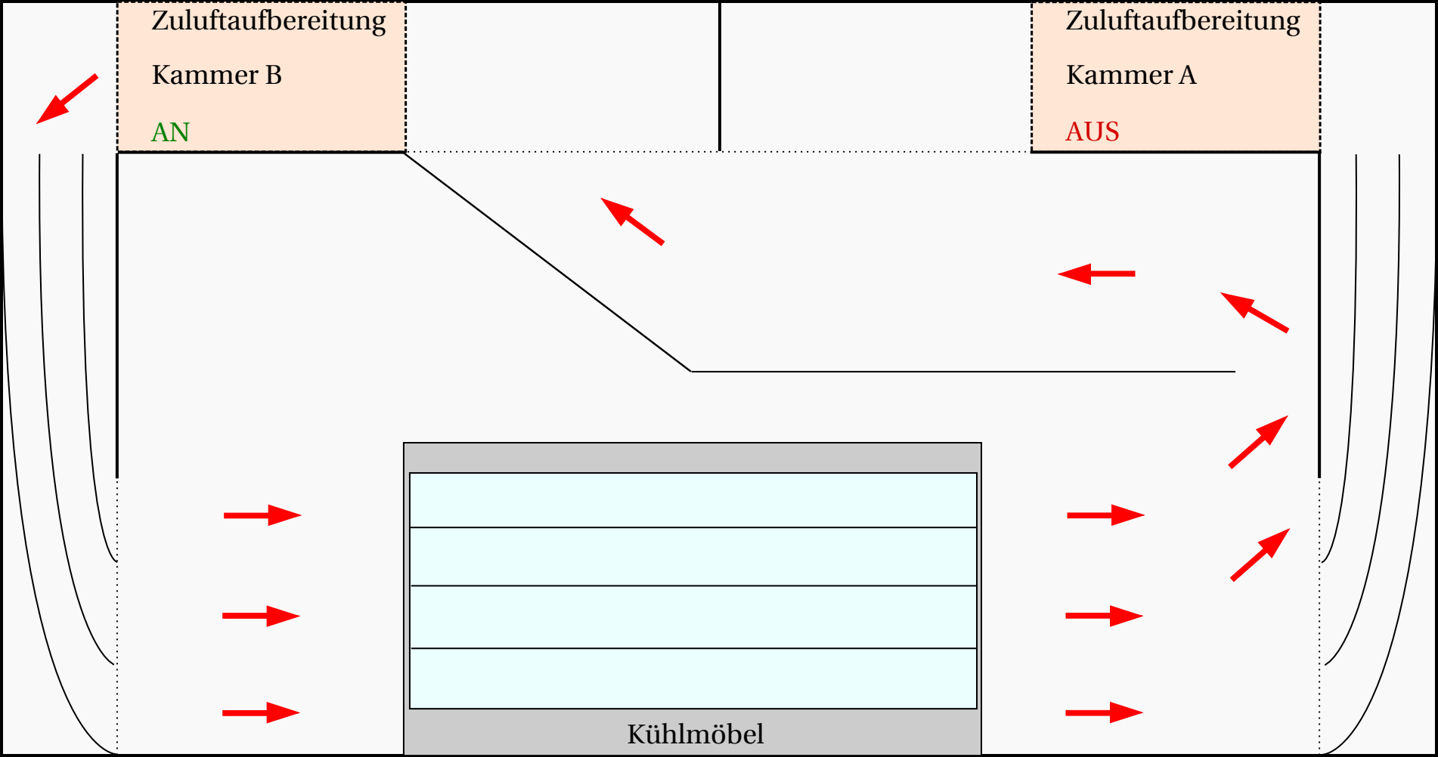
[picture p147: figure]
Zuluftaufbereitung; Kammer B; Kammer A; AUS; Kühlmöbel
