TKlebig/TimBAgit/BA/Pictures/multi-deck-chilled-cabinet.pdf

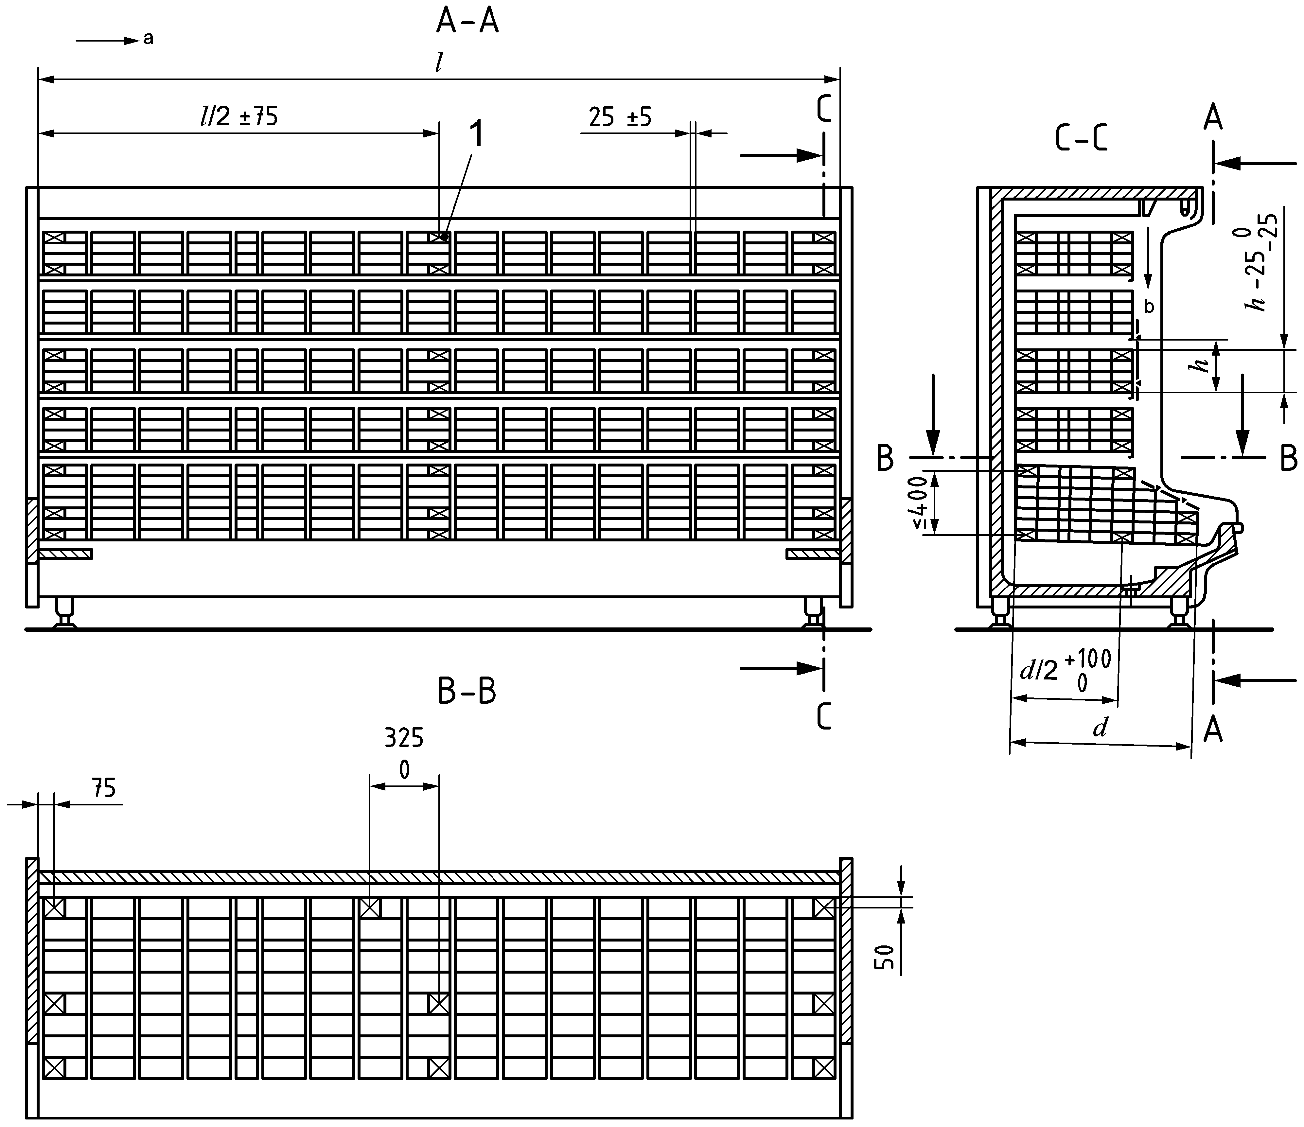
[picture p148: page 1]
