TKlebig/TimBAgit/BA/Pictures/Rohrgeometrie.pdf

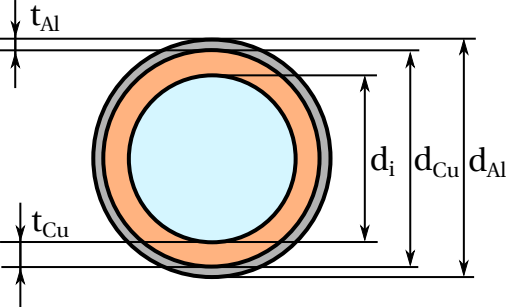
[picture p149: figure]
tAl tCu; dCu; dAl
