TKlebig/TimBAgit/BA/Pictures/Zellenmethode.pdf

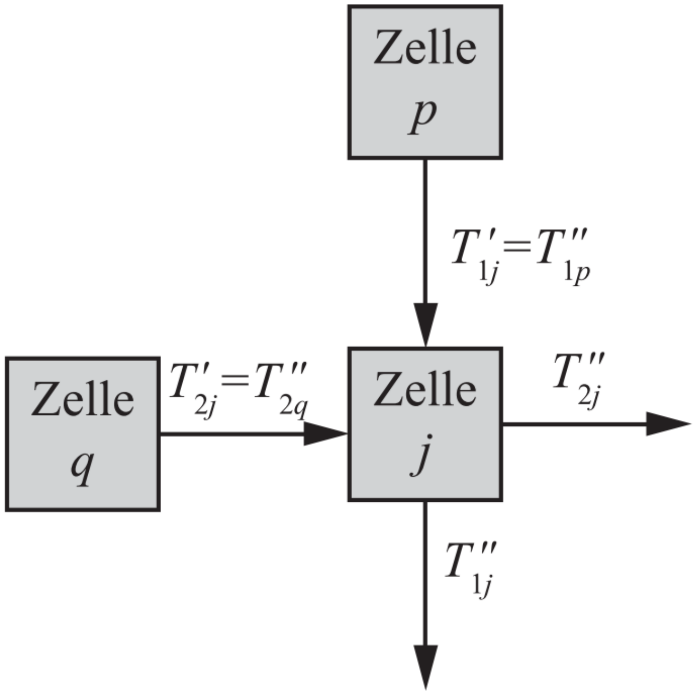
[picture p150: page 1]
