TKlebig/TimBAgit/BA/Pictures/Zellenmethode_Gegenstrom.pdf

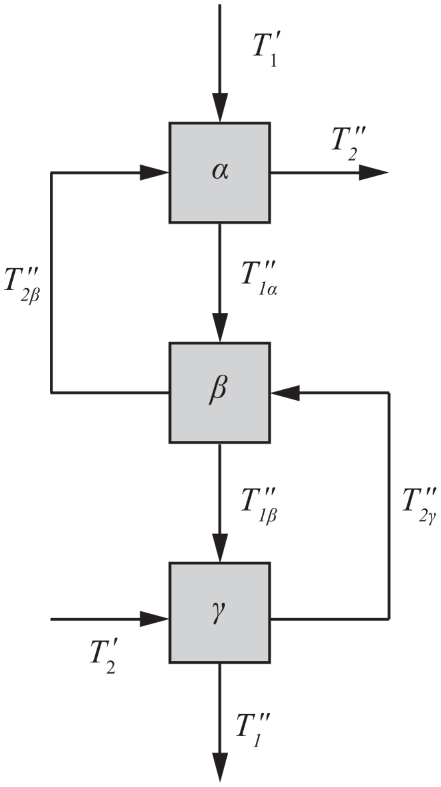
[picture p151: page 1]
