TKlebig/TimBAgit/BA/Pictures/Zellenmethode_Gleichstrom.pdf

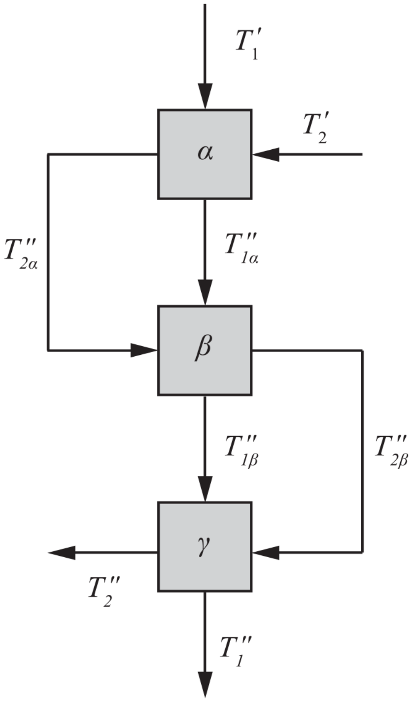
[picture p152: page 1]
