TKlebig/TimBAgit/BA/Pictures/idc_meas.pdf

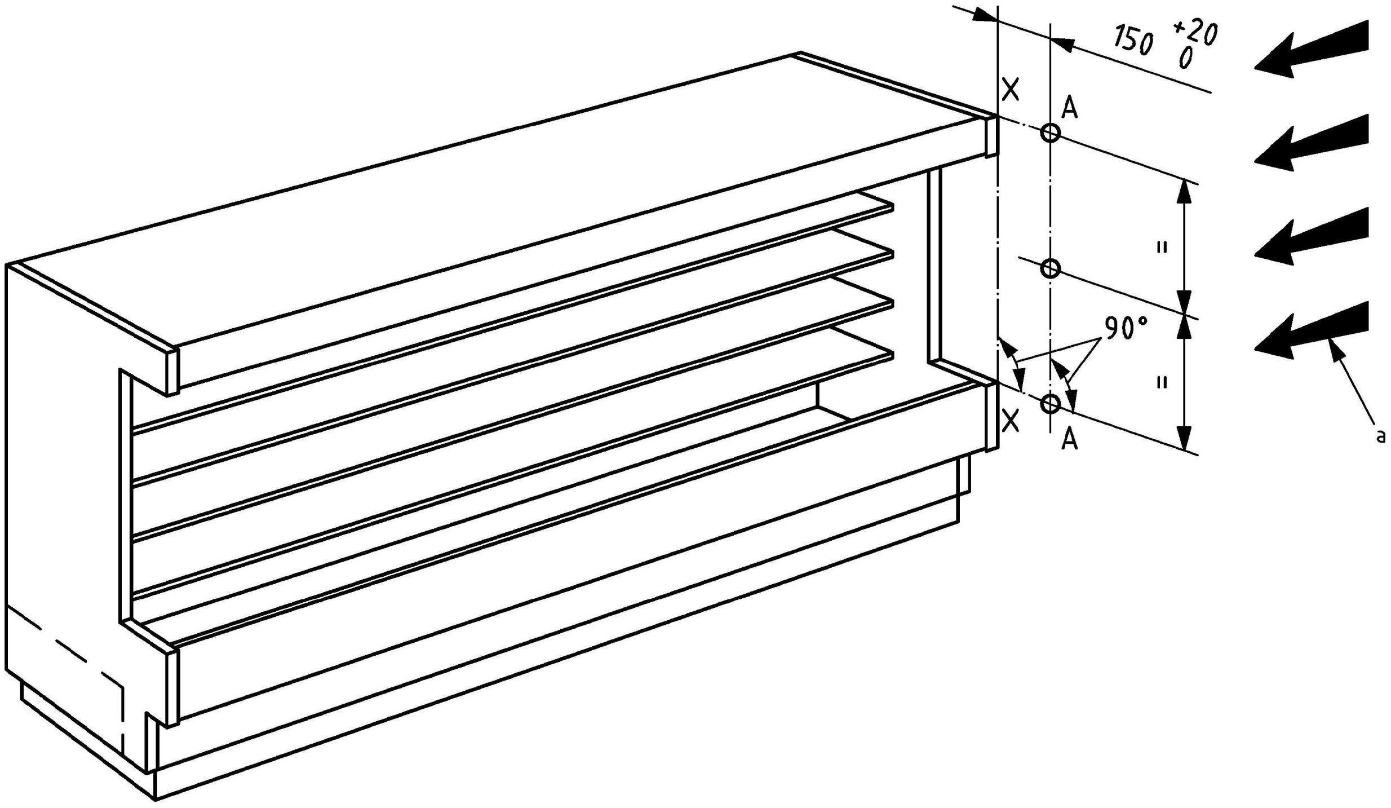
[picture p153: page 1]
