TKlebig/TimBAgit/Inkscape/Evaporator_V1.png

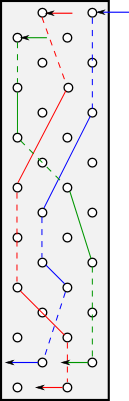
Inkscape/Evaporator_V1.png
