TKlebig/TimBAgit/Pictures/Computation of effectiveness.gif

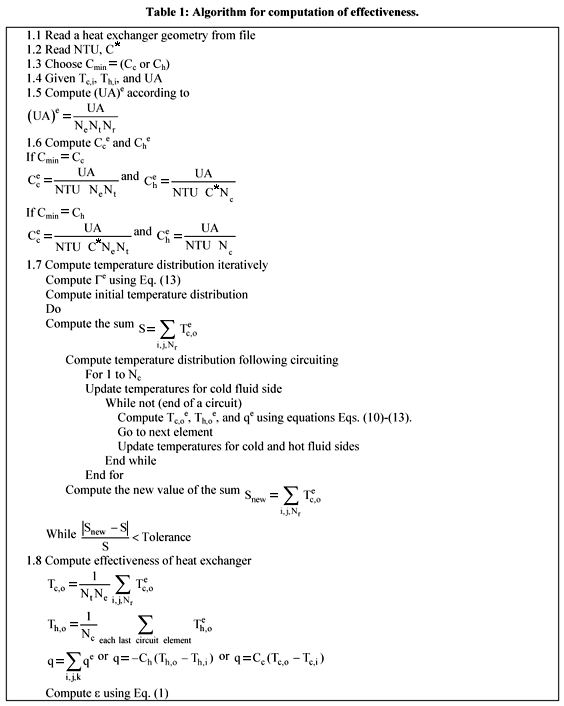
Pictures/Computation of effectiveness.gif
