TKlebig/TimBAgit/Pictures/flow types.jpg

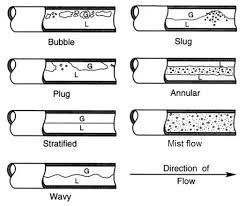
Pictures/flow types.jpg
