TKlebig/TimBAgit/Pictures/hxdiagram.jpg

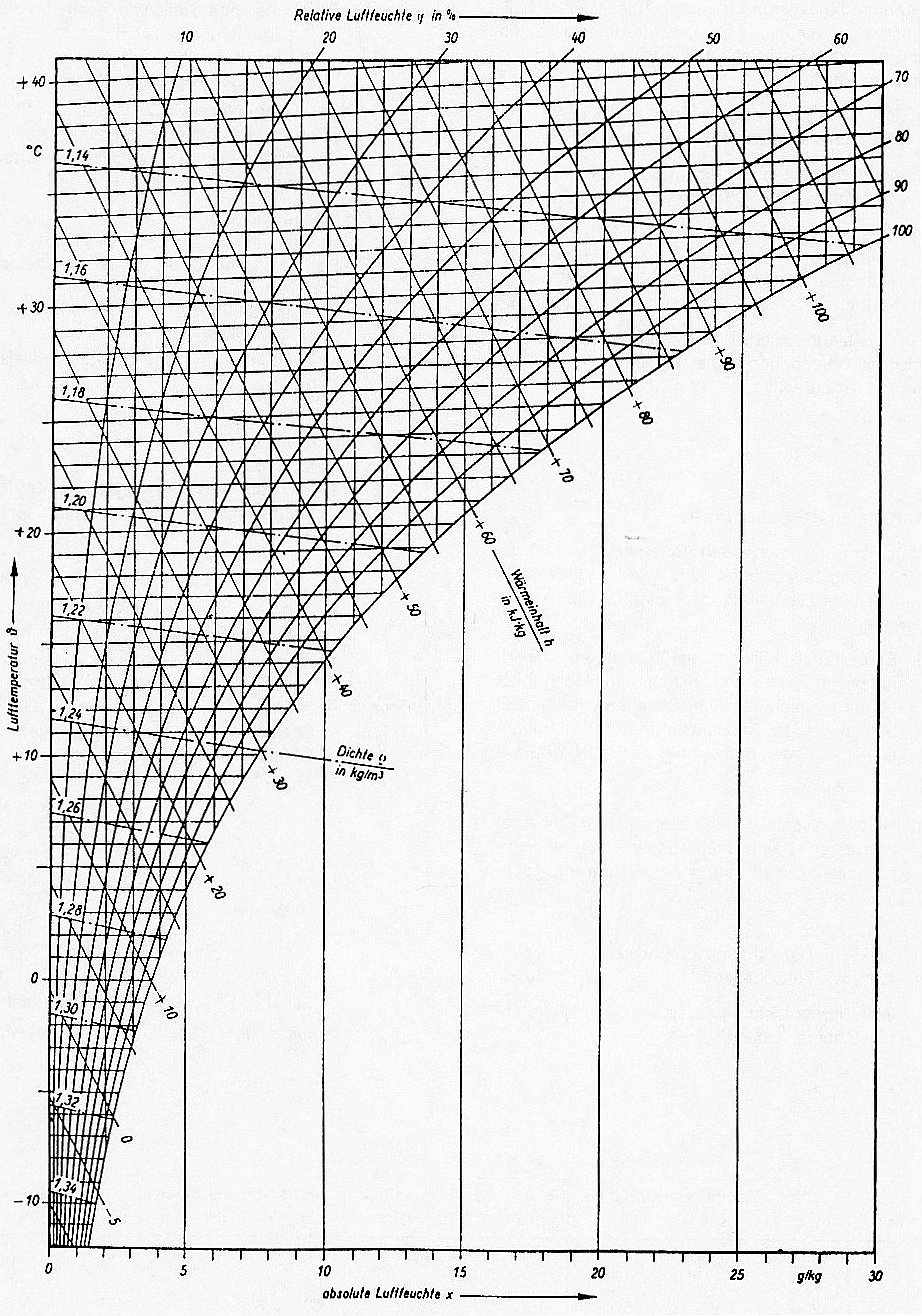
Pictures/hxdiagram.jpg
