TKlebig/TimBAgit/Pictures/hxDiagramm2.png

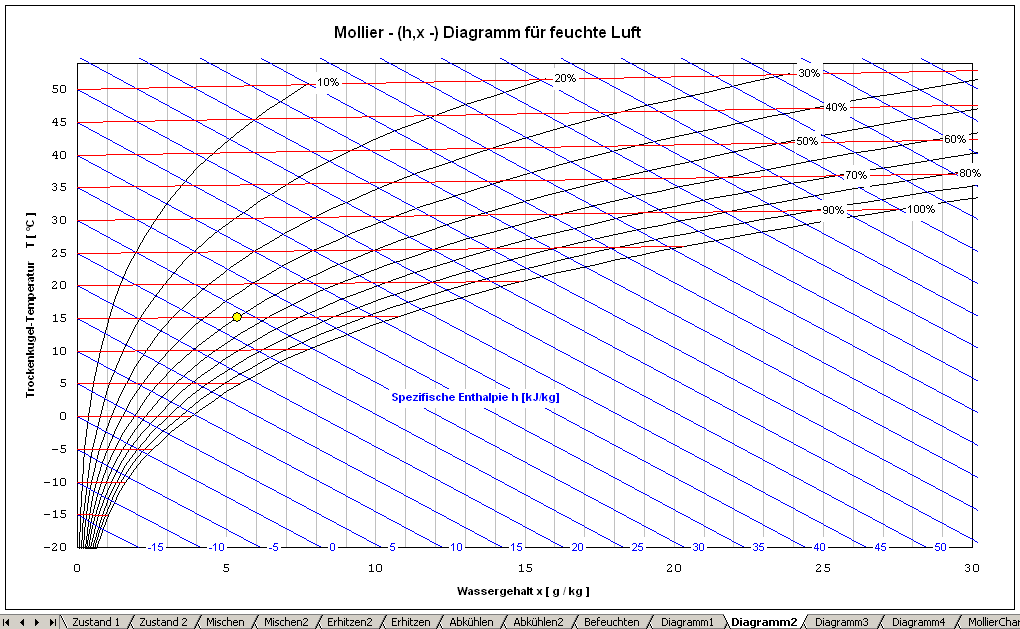
Pictures/hxDiagramm2.png
