TKlebig/TimBAgit/Pictures/IMAG2514.jpg

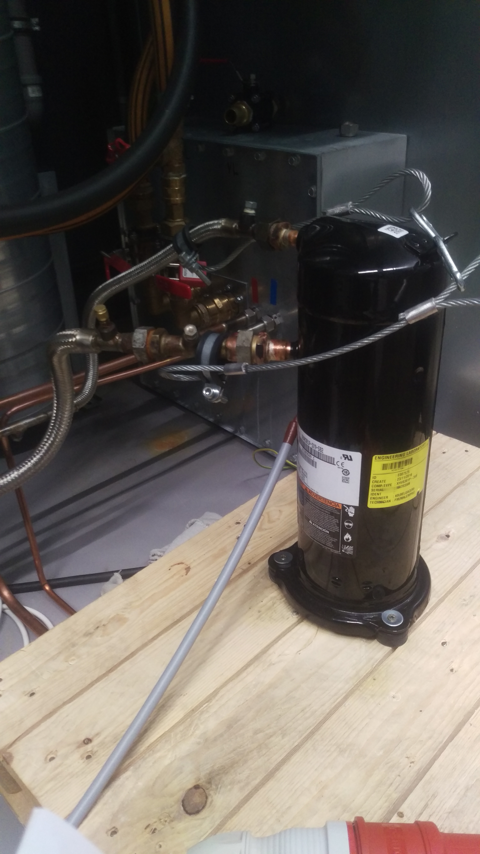
Pictures/IMAG2514.jpg
