TKlebig/TimBAgit/Presentations/UPV Assessment/IMG_20170713_140850954.jpg

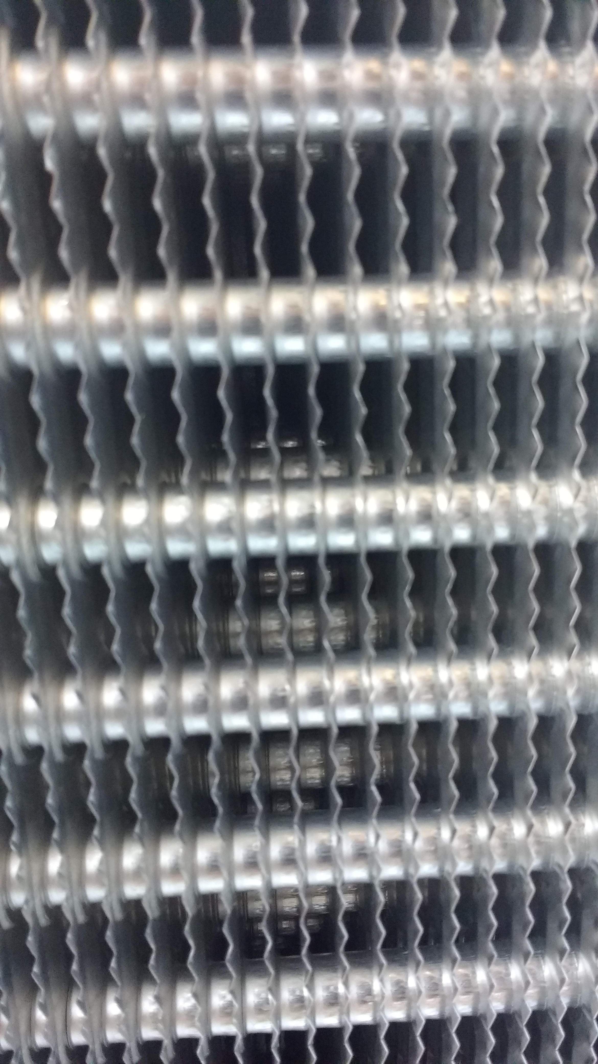
Presentations/UPV Assessment/IMG_20170713_140850954.jpg
