TKlebig/TimBAgit/Evaporator Coil Design/Coil comparison.xlsx

Sheet: Sheet1
 | Tube Diam (ext) | Thickness | Length | Tubes / Circuit | surf | Vol
Karyer | 0.01 | 0.0005 | 3.4 | 6 | 0.641 | 1.30
Sest | 0.007 | 0.0004 | 2.3 | 24 | 1.214 | 1.67
Thermofin | 0.005 | 0.0003 | 3.4 | 40 | 2.136 | 2.07
Refrion
Friterm 1 | 0.00794
Friterm 2

Sheet: Sheet2
Supplier | Circuits | Distributor | Length | Height | Width | Tube | Row x column | Fin | Total Surface | Tubes | Internal | Comment
 |  |  |  |  |  | Diameter |  | Space |  | Surface | Volume
Original (KARYER-AHT) | 3 | NO | 3.4 | 0.4 | 0.11 | 10mm | 9 x 2 | 5mm |  | 0.64m² | 1.30 l | Standard HFC design
 |  |  |  |  |  |  | (16 x 2)
Modified (KARYER-AHT) | 3 | NO | 3.4 | 0.4 | 0.11 | 10mm | 9 x 2 | 5mm |  | 0.64m² | 1.30 l | Improved Counterflow effect
New AHT-LIDL (08/2017) | 3 | NO | 3.4 | 0.4 | 0.11 | 10mm | 8 x 4 | 5mm
ARNEG R404a | 1 | YES |  |  |  | 12mm |  | 7mm
Carrier R410a | 1 | YES | 3.4 | 0.8 | 0.1 | 10mm | 20 x 2 | 7mm
EPTA – SEST | 3 | YES | 2.3 |  |  | 7mm | 12 x 4 |  |  | 1.21m² | 1.67 l | EPTA – NDA (Confidential)
REFRION (via ROLLER) | 3 | NO | 3.4 |  |  | 10mm |  |  |  | 0.61m² | 1.28 l | No improvement expected
LUVATA |  |  |  |  |  |  |  |  |  |  |  | EW
Thermofin | 3 | YES | 3.4 |  |  | 5mm | 20 x 6 | 4mm? |  | 2.14 m² | 2.07 l | Prototype to be ordered
 |  |  |  |  |  |  |  |  |  |  |  | 6 weeks lead time
Sierra |  |  |  |  |  |  |  |  |  |  |  | EW
HTS / LUVE |  |  |  |  |  |  |  |  |  |  |  | EW
GUETNER |  |  |  |  |  |  |  |  |  |  |  | On-Hold
Friterm | 3 | NO | 3.4 | 0.2 |  | 7.94/7.3 |  | 5 |  |  | 5.47 | New [FR] | 37.63570811 | 0.0001453406957
