TKlebig/TimBAgit/(list of files, cad)

Other CAD files:
Evaporator Coil Design/Model/Evaporator.iam
Evaporator Coil Design/Model/OldVersions/Evaporator.0001.iam
Evaporator Coil Design/Model/Parts/Baseplate.ipt
Evaporator Coil Design/Model/Parts/Cover Plate.ipt
Evaporator Coil Design/Model/Parts/Fin.ipt
Evaporator Coil Design/Model/Parts/OldVersions/Baseplate.0001.ipt
Evaporator Coil Design/Model/Parts/OldVersions/Cover Plate.0002.ipt
Evaporator Coil Design/Model/Parts/OldVersions/Fin.0001.ipt
