TKlebig/TimBAgit/BA/Pictures/Test61tempprofile.pdf

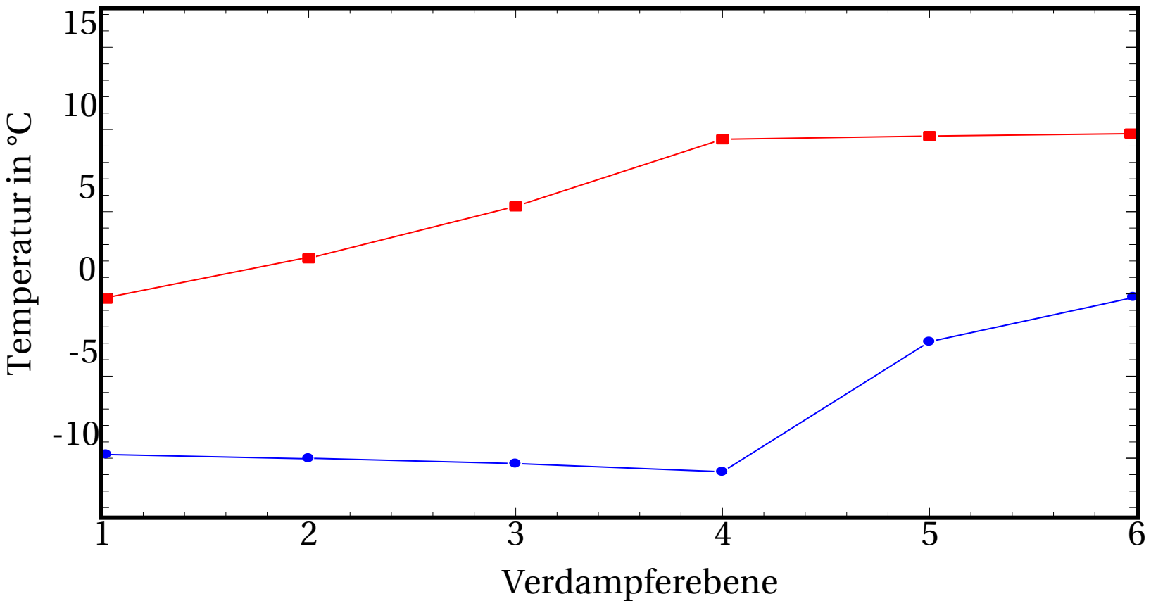
[picture p161: figure]
Verdampferebene; Temperatur in °C
