TKlebig/TimBAgit/BA/Pictures/test61V2tempprofile.pdf

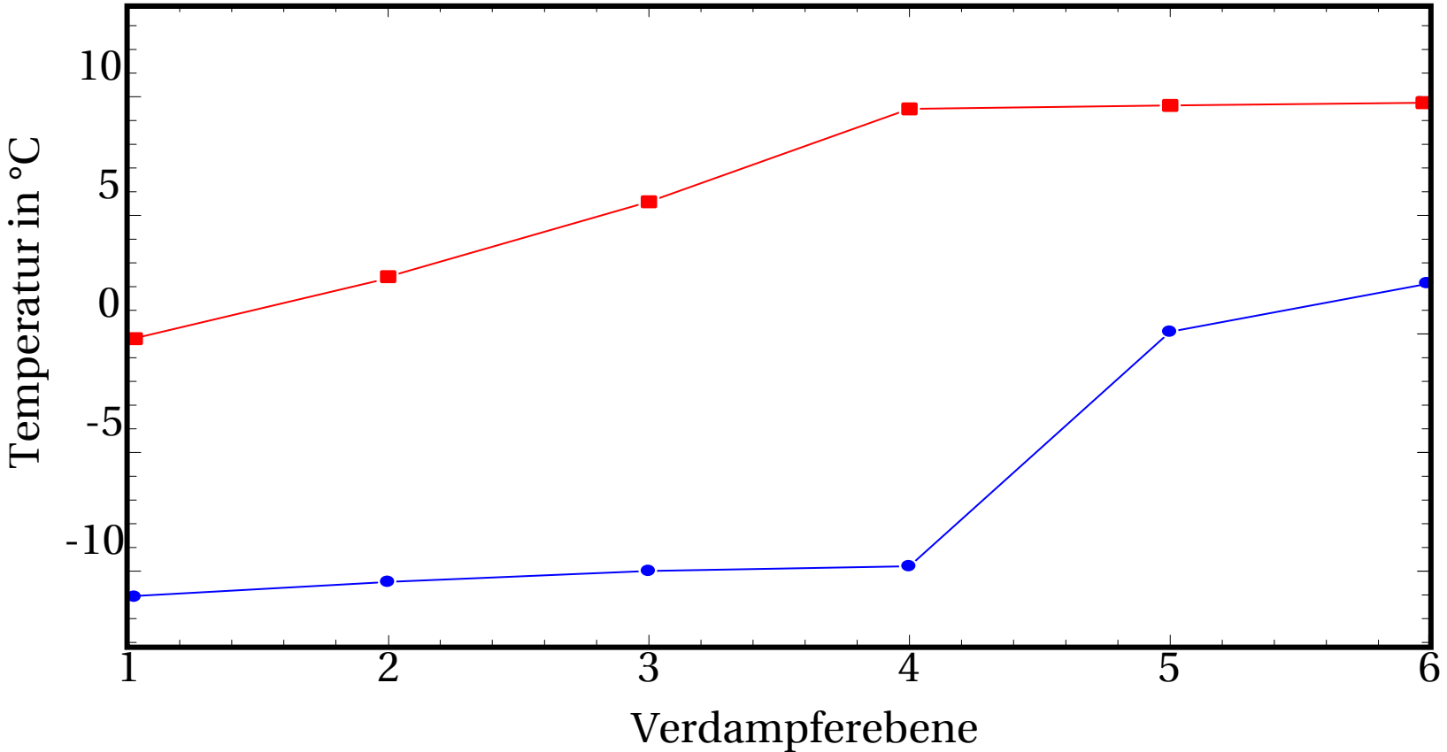
[picture p162: figure]
Verdampferebene; Temperatur in °C
