TKlebig/TimBAgit/UPV Assessment/FinalData/FanPerformance_Test24.xlsx

Sheet: Evap_Exp_V2
Test 24 Air-side Results: Evap_Exp_V2
Vact | 1811.628407 | kg/h
Vstd | 1875.6 | kg/h
∆P_Evap | 34.0651537 | Pa
k (Evaporator Fan/Pump Duct Pressure Loss Coefficient) | 31.6472 | Pa.S2/kg.m3
∆P_Duct | 9.6835 | Pa
Actual Air Density @ Tair_in for Evap. | 1.242376173 | kg/m3
Standard Air Density (Rho_std) | 1.2 | kg/m3
Actual Air Density @ Tair_out for Evap. | 1.277473627 | kg/m3
Face Area (m2) | 0.34 | m2
ACT_SystemCurve (Evap_Exp_V2)
Vact (m3/h) | mact (kg/s) | uact (m/s) | ∆P_Evap_Act (pa) | ∆P_Duct_Act (pa) | ∆P_Tot_Act (Pa) | Vact/fan (m3/h)
2400 | 0.828250782 | 1.960784314 | 59.78532473 | 16.99444781 | 76.77977254 | 400
2200 | 0.7592298835 | 1.797385621 | 50.23627981 | 14.28005684 | 64.51633665 | 366.6666667
2000 | 0.690208985 | 1.633986928 | 41.51758662 | 11.80169987 | 53.31928649 | 333.3333333
1811.628407 | 0.6252011019 | 1.480088567 | 34.0651537 | 9.683287318 | 43.74844102 | 301.9380678
1800 | 0.6211880865 | 1.470588235 | 33.62924516 | 9.559376895 | 43.18862206 | 300
1600 | 0.552167188 | 1.307189542 | 26.57125544 | 7.553087917 | 34.12434335 | 266.6666667
1400 | 0.4831462895 | 1.14379085 | 20.34361744 | 5.782832936 | 26.12645038 | 233.3333333
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
