TKlebig/TimBAgit/UPV Assessment/FinalData/IMST_Reports_Test24/001_IMST_003_Test24 (Evap_Exp_V2).xls

Sheet: Input Data & Parametric Studies
Basic Input Data
Input Data
Refrigerant: | R290(propane)
Compressor: | ZB09KAU-TFD_Emilio
Evaporator: | Evap_Exp_V2
Condenser: | SWEP B8LASH
Expansion Device: | TXV 8.2 | °C
Tubing: | Simplified
Condenser Outlet: | Refrigerant Charge 0.1818 | kg
Parametrics Studies: | YES
 | Parametric Studies
 | Units | Case 1 | Case 2 | Case 3 | Case 4 | Case 5
Evaporator Sec. Fluid Inlet Flow Rate (*) | m³/h |  |  |  |  | 1811.7

Sheet: Summary
Summary
 | Summary
 | Units | Case 5
Inlet Sat. Condenser Temp. | °C | 35.63
Oulet Sat. Condenser Temp. | °C | 35.526
Inlet Sat. Evaporation Temp. | °C | -3.5192
Outlet Sat. Evaporation Temp. | °C | -7.5928
Inlet Condenser Press. | kPa | 1236.4
Outlet Condenser Press. | kPa | 1233.4
Inlet Evaporator Press. | kPa | 425.59
Oulet Evaporator Press. | kPa | 373.75
Condenser SubCooling | K | -5.6843e-13
Total SubCooling | K | -5.6843e-13
Evaporator Superheat | K | 8.2
Total SuperHeat | K | 8.2
COP |  | 2.8627
COP Auxiliary Included |  | 2.8225
EER |  | 9.7768
EER Auxiliary Included |  | 9.6392
Total Carnot Eff. | % | 46.482
Total Carnot Eff. Auxiliary Included | % | 45.828
COP(HPA) |  | 3.8127
COP(HPA) Auxiliary Included |  | 3.7591
EER(HPA) |  | 13.021
EER(HPA) Auxiliary Included |  | 12.838
TCE(HPA) | % | 53.26
TCE(HPA) Auxiliary Included | % | 52.51
Cooling Capacity | kW | 6.9386
Heating Capacity | kW | 9.2412
Mass Flowrate | kg/s | 0.027229
Comp. Disch. Temp. | °C | 61.151
Comp. Power Input | kW | 2.4238
Global Power Input | kW | 2.4584
Isentropic Eff. | % | 69.26
Compressor Eff. | % | 65.797
Volumetric Eff. | % | 93.962
Refrigerant |  | R290(propane)

Sheet: Compressor
Compressor
 | Compressor
 | Units | Case 5
Name |  | ZB09KAU-TFD_Emilio
Number of Compressors |  | 3
Compressor Type |  | Detailed ARI
Displacement | cm³ | 25.29
Speed | rpm | 2900
Ref. Mass Flowrate | kg/s | 0.027229
Ref+Oil Mass Flowrate | kg/s | 0.027229
Refrigerant Solubility | % | 4.7644
Inlet Flowrate | m³/h | 12.404
Suction Pressure | kPa | 373.75
Suction Sat. Temp. | °C | -7.5928
Discharge Pressure | kPa | 1236.4
Discharge Sat. Temp. | °C | 35.63
Pressure Ratio |  | 3.308
Suction Temp. | °C | 0.60722
Discharge Temp. | °C | 61.151
Inlet Superheat | K | 8.2
Suction Density | kg/m³ | 7.9025
Compressor Power | kW | 2.4238
Inverter Power | kW | 0
Power Input | kW | 2.4238
Heat Losses | % | 5
Isentropic Eff. | % | 69.26
Compressor Eff. | % | 65.797
Volumetric Eff. | % | 93.962

Sheet: Condenser Global results
Condenser
 | Global results
 | Units | Case 5
Name |  | SWEP B8LASH
Exchanger´s Type |  | Plates
Calculation Model |  | Detailed
Double Ref. Circuit |  | FALSE
Capacity | kW | 3.0804
Efficiency | % | 17.01
UA | W/K | 108.39
NTU |  | 0.18645
LMTD | K | 28.419
Min. Wall Temp. | °C | 31.8
Max. Wall Temp. | °C | 36.344
Sec Fluid. Freezing Temp. | °C | 0
Refrigerant |  | R290(propane)
Refrigerant Area | m² | 0.45502
De-superheating Area | % | 27.723
Two-Phase Area | % | 72.277
Subcooling Area | % | 0
Mass Flowrate | kg/s | 0.0090764
Inlet Temperature | °C | 61.151
Outlet Temperature | °C | 35.526
Inlet Superheat | K | 25.521
Outlet Subcooling | K | -5.6843e-13
Pressure Drop | kPa | 2.9802
Secondary Fluid |  | Water
Area | m² | 0.45502
Flowrate | m³/h | 0.50357
Inlet Temperature | °C | 30
Outlet Temperature | °C | 35.3
Pressure Drop | kPa | 16.86

Sheet: Condenser Refrigerant
Condenser
 | Refrigerant
 | Units | Case 5
Name |  | R290(propane)
Refrigerant Area | m² | 0.45502
Area Enh factor |  | 1.264
De-superheating Area | % | 27.723
Two-Phase Area | % | 72.277
Subcooling Area | % | 0
Mass Flowrate | kg/s | 0.0090764
Inlet Temperature | °C | 61.151
Outlet Temperature | °C | 35.526
Inlet Superheat | K | 25.521
Outlet Subcooling | K | -5.6843e-13
Heat Flux | W/m² | 6769.8
Two-Phase Heat Flux | W/m² | 7870.5
Heat Transfer Coeff. | W/(m² K) | 3261.8
Inlet Pressure | kPa | 1236.4
Outlet Pressure | kPa | 1233.4
Total Pressure Drop | kPa | 2.9802
Inlet Pressure Drop | kPa | 0
Internal Pressure Drop | kPa | 2.9802
Outlet Pressure Drop | kPa | 0
Inlet Sat. Temperature | °C | 35.63
Outlet Sat. Temperature | °C | 35.526
Fluid Volume | dm³ | 0.19175
Mass Inventory | kg | 0.011096

Sheet: Condenser Secondary fluid
Condenser
 | Secondary fluid
 | Units | Case 5
Name |  | Water
Area | m² | 0.45502
Area Enh factor |  | 1.264
Mass Flowrate | kg/s | 0.13919
Inlet Temperature | °C | 30
Outlet Temperature | °C | 35.3
Sec Fluid. Freezing Temp. | °C | 0
Heat Transfer Coeff. | W/(m² K) | 9691.7
Inlet Pressure | kPa | 101.35
Outlet Pressure | kPa | 84.49
Pressure Drop | kPa | 16.86
Inlet Pressure Drop | kPa | 0
Internal Pressure Drop | kPa | 16.86
Outlet Pressure Drop | kPa | 0
Inlet Velocity | m/s | 0.18252
Flowrate | m³/h | 0.50357
Pumping Power | W | 2.3584
Pump Consumption | W | 3.3691
Pump Efficiency | % | 70

Sheet: Condenser Geometry
Condenser
 | Geometry
 | Units | Case 5
HPCD | mm | 45.333
VPCD | mm | 278
Nominal Port diameter | mm | 16
Plate pitch | mm | 1.32
Channel type |  | H
Total Number of plates |  | 20
Double Ref. Circuit |  | FALSE

Sheet: Evaporator Global results
Evaporator
 | Global results
 | Units | Case 5
Name |  | Evap_Exp_V2
Exchanger´s Type |  | Coil
Calculation Model |  | Detailed
Capacity | kW | 6.9386
Sensible Capacity | kW | 4.5456
SHR | % | 65.511
Min. Wall Temp. | °C | -6.076
Max. Wall Temp. | °C | 8.5
Refrigerant |  | R290(propane)
Mass Flowrate | kg/s | 0.027229
Inlet Temperature | °C | -3.5192
Outlet Temperature | °C | 0.60721
Inlet Quality |  | 0.35317
Outlet Superheat | K | 8.2
Pressure Drop | kPa | 51.842
Secondary Fluid |  | Air
Flowrate | m³/h | 1811.7
Face Velocity | m/s | 1.4801
Inlet Temperature | °C | 8.5
Outlet Temperature | °C | 1.3296
Pressure Drop | Pa | 34.067

Sheet: Evaporator Refrigerant
Evaporator
 | Refrigerant
 | Units | Case 5
Name |  | R290(propane)
Refrigerant Area | m² | 1.5177
Two Phase Area | % | 94.393
Superheating Area | % | 5.6072
Mass Flowrate | kg/s | 0.027229
Inlet Temperature | °C | -3.5192
Outlet Temperature | °C | 0.60721
Inlet Quality |  | 0.35317
Outlet Superheat | K | 8.2
Heat Flux | W/m² | 4571.7
Two-Phase Heat Flux | W/m² | 4588.7
Heat Transfer Coeff. | W/(m² K) | 5141.3
Inlet Pressure | kPa | 425.59
Outlet Pressure | kPa | 373.75
Total Pressure Drop | kPa | 51.842
Inlet Press. Drop | kPa | 0
Internal Press. Drop | kPa | 51.842
Bends Press. Drop | kPa | 2.2795
Outlet Press. Drop | kPa | 0
Inlet Sat. Temperature | °C | -3.5192
Outlet Sat. Temperature | °C | -7.5928
Bends Fluid Volume | cm³ | 131.03
Bends Mass Inventory | kg | 0.00679
Total Fluid Volume | cm³ | 3126.3
Total Mass Inventory | kg | 0.1553

Sheet: Evaporator Secondary fluid
Evaporator
 | Secondary fluid
 | Units | Case 5
Name |  | Air
Area | m² | 15.388
Fins Area | m² | 13.557
Fin Efficiency | % | 35.965
Mass Flowrate | kg/s | 0.62523
Inlet Temperature | °C | 8.5
Outlet Temperature | °C | 1.3296
Heat Transfer Coeff. | W/(m² K) | 293.76
Inlet Pressure | kPa | 101.35
Outlet Pressure | kPa | 101.32
Pressure Drop | Pa | 34.067
Face Velocity | m/s | 1.4801
Flowrate | m³/h | 1811.7
Std Face Velocity | m/s | 1.5324
Std Flowrate | m³/h | 1875.7
S. Pumping Power | W | 17.144
Fan Consumption | W | 24.492
Fan S. Efficiency | % | 70
Inlet Relat. Humidity | % | 80
Outlet Relative Humidity | % | 96.298
Condensate Mass Flowrate | kg/h | 3.423

Sheet: Evaporator Geometry
Evaporator
 | Geometry
 | Units | Case 5
Tube diameter | mm | 9.52
Tube thickness | mm | 0.813
Internal surface |  | Smooth
Transversal spacing | mm | 20
Longitudinal spacing | mm | 25
Fin surface type |  | Plain
Fin spacing | fpi | 5
Fin thickness | mm | 0.08
Number of rows |  | 16
Number of circuits |  | 3
Refrigerant CrossFlow Area | m² | 0.00014683
Core height | mm | 100
Core depth | mm | 400
Finned length | mm | 3400
Finned face area | m² | 0.272
Fin surface area | m² | 13.557
Total coil surface area | m² | 15.388
Compactness ratio | m²/m³ | 113.15
Fin Mass | kg | 5.9622
Tube Mass | kg | 21.558
Bends Mass | kg | 0.5305
Total Mass | kg | 28.051
Sensible Efficiency | % | 59.428
Sensible UA | W/K | 574.09
Sensible NTU |  | 0.9021
Sensible LMTD | K | 7.918

Sheet: Accessories Discharge line
Accessories
 | Discharge line
 | Units | Case 5
Inlet Temperature | °C | 61.151
Outlet Temperature | °C | 61.151
Fluid State |  | Single-Phase State
De-superheat | K | 0
Heat Loss | W | 0
Total pressure drop | kPa | 0

Sheet: Accessories Liquid line
Accessories
 | Liquid line
 | Units | Case 5
Inlet Temperature | °C | 35.526
Outlet Temperature | °C | 35.526
Fluid State |  | Two-Phase State
Extra subcooling | K | -10000
Heat Loss | W | 0
Total pressure drop | kPa | 0

Sheet: Accessories Suction line
Accessories
 | Suction line
 | Units | Case 5
Inlet Temperature | °C | 0.60722
Outlet Temperature | °C | 0.60722
Fluid State |  | Single-Phase State
Extra superheat | K | 5.1159e-13
Heat gain | W | -1.9019e-11
Total pressure drop | kPa | 0

Sheet: Refrigerant
Refrigerant
 | Refrigerant
 | Units | Case 5
Name |  | R290(propane)
Condensation Pressure (Cond. Outlet) | kPa | 1233.4
Condensation Glide | K | 0.10421
Evaporation Pressure (Evap. Outlet) | kPa | 373.75
Evaporation Glide | K | 4.0736
Liquid Density (Cond. Outlet) | kg/m³ | 180.67
Vapor Density (Evap. Outlet) | kg/m³ | 7.9025
Saturation Pressure (T=15 °C) | kPa | 731.87
Saturation Pressure (T=25 °C) | kPa | 952.62
Total Refrigerant Charge | kg | 0.1818
Refrigerant Mass in Evap. | kg | 0.14851
Refrigerant Mass in Cond. | kg | 0.033289
Refrigerant Mass in Comp. | kg | 0
