TKlebig/TimBAgit/UPV Assessment/FinalData/IMST_Reports_Test24/002_IMST_008_Test24 (Evap_Num_5x4_ST_3c_V2).xls

Sheet: Input Data & Parametric Studies
Basic Input Data
Input Data
Refrigerant: | R290(propane)
Compressor: | ZB09KAU-TFD_Emilio
Evaporator: | Evap_Num_5x4_ST_V2
Condenser: | SWEP B8LASH
Expansion Device: | TXV 8.2 | °C
Tubing: | Simplified
Condenser Outlet: | Refrigerant Charge 0.1818 | kg
Parametrics Studies: | YES
 | Parametric Studies
 | Units | Case 1 | Case 2 | Case 3 | Case 4 | Case 5
Evaporator Sec. Fluid Inlet Flow Rate (*) | m³/h |  |  |  | 1811.7

Sheet: Summary
Summary
 | Summary
 | Units | Case 4
Inlet Sat. Condenser Temp. | °C | 35.845
Oulet Sat. Condenser Temp. | °C | 35.718
Inlet Sat. Evaporation Temp. | °C | 0.59364
Outlet Sat. Evaporation Temp. | °C | -3.7554
Inlet Condenser Press. | kPa | 1242.7
Outlet Condenser Press. | kPa | 1238.9
Inlet Evaporator Press. | kPa | 483.13
Oulet Evaporator Press. | kPa | 422.57
Condenser SubCooling | K | -6.8212e-13
Total SubCooling | K | -6.8212e-13
Evaporator Superheat | K | 8.2
Total SuperHeat | K | 8.2
COP |  | 3.3153
COP Auxiliary Included |  | 3.2706
EER |  | 11.322
EER Auxiliary Included |  | 11.17
Total Carnot Eff. | % | 48.577
Total Carnot Eff. Auxiliary Included | % | 47.923
COP(HPA) |  | 4.2653
COP(HPA) Auxiliary Included |  | 4.2078
EER(HPA) |  | 14.567
EER(HPA) Auxiliary Included |  | 14.37
TCE(HPA) | % | 54.51
TCE(HPA) Auxiliary Included | % | 53.776
Cooling Capacity | kW | 8.0723
Heating Capacity | kW | 10.385
Mass Flowrate | kg/s | 0.031354
Comp. Disch. Temp. | °C | 58.282
Comp. Power Input | kW | 2.4349
Global Power Input | kW | 2.4681
Isentropic Eff. | % | 71.572
Compressor Eff. | % | 67.994
Volumetric Eff. | % | 96.246
Refrigerant |  | R290(propane)

Sheet: Compressor
Compressor
 | Compressor
 | Units | Case 4
Name |  | ZB09KAU-TFD_Emilio
Number of Compressors |  | 3
Compressor Type |  | Detailed ARI
Displacement | cm³ | 25.29
Speed | rpm | 2900
Ref. Mass Flowrate | kg/s | 0.031354
Ref+Oil Mass Flowrate | kg/s | 0.031354
Refrigerant Solubility | % | 6.0669
Inlet Flowrate | m³/h | 12.706
Suction Pressure | kPa | 422.57
Suction Sat. Temp. | °C | -3.7554
Discharge Pressure | kPa | 1242.7
Discharge Sat. Temp. | °C | 35.845
Pressure Ratio |  | 2.9408
Suction Temp. | °C | 4.4446
Discharge Temp. | °C | 58.282
Inlet Superheat | K | 8.2
Suction Density | kg/m³ | 8.8836
Compressor Power | kW | 2.4349
Inverter Power | kW | 0
Power Input | kW | 2.4349
Heat Losses | % | 5
Isentropic Eff. | % | 71.572
Compressor Eff. | % | 67.994
Volumetric Eff. | % | 96.246

Sheet: Condenser Global results
Condenser
 | Global results
 | Units | Case 4
Name |  | SWEP B8LASH
Exchanger´s Type |  | Plates
Calculation Model |  | Detailed
Double Ref. Circuit |  | FALSE
Capacity | kW | 3.4618
Efficiency | % | 18.735
UA | W/K | 135.54
NTU |  | 0.20746
LMTD | K | 25.541
Min. Wall Temp. | °C | 31.822
Max. Wall Temp. | °C | 36.257
Sec Fluid. Freezing Temp. | °C | 0
Refrigerant |  | R290(propane)
Refrigerant Area | m² | 0.45502
De-superheating Area | % | 26.889
Two-Phase Area | % | 73.111
Subcooling Area | % | 0
Mass Flowrate | kg/s | 0.010451
Inlet Temperature | °C | 58.282
Outlet Temperature | °C | 35.718
Inlet Superheat | K | 22.437
Outlet Subcooling | K | -6.8212e-13
Pressure Drop | kPa | 3.802
Secondary Fluid |  | Water
Area | m² | 0.45502
Flowrate | m³/h | 0.56592
Inlet Temperature | °C | 30
Outlet Temperature | °C | 35.3
Pressure Drop | kPa | 20.081

Sheet: Condenser Refrigerant
Condenser
 | Refrigerant
 | Units | Case 4
Name |  | R290(propane)
Refrigerant Area | m² | 0.45502
Area Enh factor |  | 1.264
De-superheating Area | % | 26.889
Two-Phase Area | % | 73.111
Subcooling Area | % | 0
Mass Flowrate | kg/s | 0.010451
Inlet Temperature | °C | 58.282
Outlet Temperature | °C | 35.718
Inlet Superheat | K | 22.437
Outlet Subcooling | K | -6.8212e-13
Heat Flux | W/m² | 7608
Two-Phase Heat Flux | W/m² | 8904.4
Heat Transfer Coeff. | W/(m² K) | 3477.2
Inlet Pressure | kPa | 1242.7
Outlet Pressure | kPa | 1238.9
Total Pressure Drop | kPa | 3.802
Inlet Pressure Drop | kPa | 0
Internal Pressure Drop | kPa | 3.802
Outlet Pressure Drop | kPa | 0
Inlet Sat. Temperature | °C | 35.845
Outlet Sat. Temperature | °C | 35.718
Fluid Volume | dm³ | 0.19175
Mass Inventory | kg | 0.01128

Sheet: Condenser Secondary fluid
Condenser
 | Secondary fluid
 | Units | Case 4
Name |  | Water
Area | m² | 0.45502
Area Enh factor |  | 1.264
Mass Flowrate | kg/s | 0.15642
Inlet Temperature | °C | 30
Outlet Temperature | °C | 35.3
Sec Fluid. Freezing Temp. | °C | 0
Heat Transfer Coeff. | W/(m² K) | 10543
Inlet Pressure | kPa | 101.35
Outlet Pressure | kPa | 81.269
Pressure Drop | kPa | 20.081
Inlet Pressure Drop | kPa | 0
Internal Pressure Drop | kPa | 20.081
Outlet Pressure Drop | kPa | 0
Inlet Velocity | m/s | 0.20512
Flowrate | m³/h | 0.56592
Pumping Power | W | 3.1567
Pump Consumption | W | 4.5095
Pump Efficiency | % | 70

Sheet: Condenser Geometry
Condenser
 | Geometry
 | Units | Case 4
HPCD | mm | 45.333
VPCD | mm | 278
Nominal Port diameter | mm | 16
Plate pitch | mm | 1.32
Channel type |  | H
Total Number of plates |  | 20
Double Ref. Circuit |  | FALSE

Sheet: Evaporator Global results
Evaporator
 | Global results
 | Units | Case 4
Name |  | Evap_Num_5x4_ST_V2
Exchanger´s Type |  | Coil
Calculation Model |  | Detailed
Capacity | kW | 8.0723
Sensible Capacity | kW | 5.4167
SHR | % | 67.102
Min. Wall Temp. | °C | -0.65496
Max. Wall Temp. | °C | 8.5
Refrigerant |  | R290(propane)
Mass Flowrate | kg/s | 0.031354
Inlet Temperature | °C | 0.59364
Outlet Temperature | °C | 4.4446
Inlet Quality |  | 0.33631
Outlet Superheat | K | 8.2
Pressure Drop | kPa | 60.564
Secondary Fluid |  | Air
Flowrate | m³/h | 1811.7
Face Velocity | m/s | 1.4801
Inlet Temperature | °C | 8.5
Outlet Temperature | °C | -0.046982
Pressure Drop | Pa | 27.422

Sheet: Evaporator Refrigerant
Evaporator
 | Refrigerant
 | Units | Case 4
Name |  | R290(propane)
Refrigerant Area | m² | 1.5177
Two Phase Area | % | 89.488
Superheating Area | % | 10.512
Mass Flowrate | kg/s | 0.031354
Inlet Temperature | °C | 0.59364
Outlet Temperature | °C | 4.4446
Inlet Quality |  | 0.33631
Outlet Superheat | K | 8.2
Heat Flux | W/m² | 5318.6
Two-Phase Heat Flux | W/m² | 5636.1
Heat Transfer Coeff. | W/(m² K) | 5316
Inlet Pressure | kPa | 483.13
Outlet Pressure | kPa | 422.57
Total Pressure Drop | kPa | 60.564
Inlet Press. Drop | kPa | -5.8208e-14
Internal Press. Drop | kPa | 60.564
Bends Press. Drop | kPa | 3.1011
Outlet Press. Drop | kPa | 0
Inlet Sat. Temperature | °C | 0.59364
Outlet Sat. Temperature | °C | -3.7554
Bends Fluid Volume | cm³ | 47.944
Bends Mass Inventory | kg | 0.002341
Total Fluid Volume | cm³ | 3043.2
Total Mass Inventory | kg | 0.1503

Sheet: Evaporator Secondary fluid
Evaporator
 | Secondary fluid
 | Units | Case 4
Name |  | Air
Area | m² | 15.388
Fins Area | m² | 13.557
Fin Efficiency | % | 31.919
Mass Flowrate | kg/s | 0.62523
Inlet Temperature | °C | 8.5
Outlet Temperature | °C | -0.046982
Heat Transfer Coeff. | W/(m² K) | 364.34
Inlet Pressure | kPa | 101.35
Outlet Pressure | kPa | 101.32
Pressure Drop | Pa | 27.422
Face Velocity | m/s | 1.4801
Flowrate | m³/h | 1811.7
Std Face Velocity | m/s | 1.5324
Std Flowrate | m³/h | 1875.7
S. Pumping Power | W | 13.8
Fan Consumption | W | 19.715
Fan S. Efficiency | % | 70
Inlet Relat. Humidity | % | 80
Outlet Relative Humidity | % | 101.97
Condensate Mass Flowrate | kg/h | 3.7986

Sheet: Evaporator Geometry
Evaporator
 | Geometry
 | Units | Case 4
Tube diameter | mm | 9.52
Tube thickness | mm | 0.813
Internal surface |  | Smooth
Transversal spacing | mm | 20
Longitudinal spacing | mm | 25
Fin surface type |  | Plain
Fin spacing | fpi | 5
Fin thickness | mm | 0.08
Number of rows |  | 5
Number of circuits |  | 3
Refrigerant CrossFlow Area | m² | 0.00014683
Core height | mm | 100
Core depth | mm | 125
Finned length | mm | 3400
Finned face area | m² | 0.272
Fin surface area | m² | 13.557
Total coil surface area | m² | 15.388
Compactness ratio | m²/m³ | 362.07
Fin Mass | kg | 1.8632
Tube Mass | kg | 13.474
Bends Mass | kg | 0.1941
Total Mass | kg | 15.531
Sensible Efficiency | % | 107.66
Sensible UA | W/K | 1000000
Sensible NTU |  | 1
Sensible LMTD | K | 0.0054167

Sheet: Accessories Discharge line
Accessories
 | Discharge line
 | Units | Case 4
Inlet Temperature | °C | 58.282
Outlet Temperature | °C | 58.282
Fluid State |  | Single-Phase State
De-superheat | K | 8.5265e-13
Heat Loss | W | 7.3001e-12
Total pressure drop | kPa | 0

Sheet: Accessories Liquid line
Accessories
 | Liquid line
 | Units | Case 4
Inlet Temperature | °C | 35.718
Outlet Temperature | °C | 35.718
Fluid State |  | Two-Phase State
Extra subcooling | K | -10000
Heat Loss | W | 0
Total pressure drop | kPa | 2.3283e-13

Sheet: Accessories Suction line
Accessories
 | Suction line
 | Units | Case 4
Inlet Temperature | °C | 4.4446
Outlet Temperature | °C | 4.4446
Fluid State |  | Single-Phase State
Extra superheat | K | 4.5475e-13
Heat gain | W | -1.825e-11
Total pressure drop | kPa | 5.8208e-14

Sheet: Refrigerant
Refrigerant
 | Refrigerant
 | Units | Case 4
Name |  | R290(propane)
Condensation Pressure (Cond. Outlet) | kPa | 1238.9
Condensation Glide | K | 0.12711
Evaporation Pressure (Evap. Outlet) | kPa | 422.57
Evaporation Glide | K | 4.349
Liquid Density (Cond. Outlet) | kg/m³ | 176.18
Vapor Density (Evap. Outlet) | kg/m³ | 8.8836
Saturation Pressure (T=15 °C) | kPa | 731.87
Saturation Pressure (T=25 °C) | kPa | 952.62
Total Refrigerant Charge | kg | 0.1818
Refrigerant Mass in Evap. | kg | 0.14796
Refrigerant Mass in Cond. | kg | 0.033841
Refrigerant Mass in Comp. | kg | 0
