TKlebig/TimBAgit/UPV Assessment/FinalData/IMST_Reports_Test24/003_IMST_020_Test24 (Evap_Num_5x4_ST_9c_V4).xls

Sheet: Input Data & Parametric Studies
Basic Input Data
Input Data
Refrigerant: | R290(propane)
Compressor: | ZB09KAU-TFD_Emilio
Evaporator: | Evap_Num_5x4_ST_9c_V4
Condenser: | SWEP B8LASH
Expansion Device: | TXV 8.2 | °C
Tubing: | Simplified
Condenser Outlet: | Refrigerant Charge 0.1818 | kg
Parametrics Studies: | YES
 | Parametric Studies
 | Units | Case 1 | Case 2 | Case 3 | Case 4 | Case 5
Evaporator Sec. Fluid Inlet Flow Rate (*) | m³/h |  |  |  | 1811.7

Sheet: Summary
Summary
 | Summary
 | Units | Case 4
Inlet Sat. Condenser Temp. | °C | 37.69
Oulet Sat. Condenser Temp. | °C | 37.619
Inlet Sat. Evaporation Temp. | °C | -4.0624
Outlet Sat. Evaporation Temp. | °C | -4.7761
Inlet Condenser Press. | kPa | 1298.4
Outlet Condenser Press. | kPa | 1296.2
Inlet Evaporator Press. | kPa | 418.64
Oulet Evaporator Press. | kPa | 409.5
Condenser SubCooling | K | 7.3719
Total SubCooling | K | 7.3719
Evaporator Superheat | K | 8.2
Total SuperHeat | K | 8.2
COP |  | 3.6156
COP Auxiliary Included |  | 3.5733
EER |  | 12.348
EER Auxiliary Included |  | 12.203
Total Carnot Eff. | % | 57.117
Total Carnot Eff. Auxiliary Included | % | 56.447
COP(HPA) |  | 4.5656
COP(HPA) Auxiliary Included |  | 4.5121
EER(HPA) |  | 15.592
EER(HPA) Auxiliary Included |  | 15.41
TCE(HPA) | % | 62.285
TCE(HPA) Auxiliary Included | % | 61.555
Cooling Capacity | kW | 9.1451
Heating Capacity | kW | 11.548
Mass Flowrate | kg/s | 0.030081
Comp. Disch. Temp. | °C | 61.425
Comp. Power Input | kW | 2.5293
Global Power Input | kW | 2.5593
Isentropic Eff. | % | 70.792
Compressor Eff. | % | 67.252
Volumetric Eff. | % | 95.149
Refrigerant |  | R290(propane)

Sheet: Compressor
Compressor
 | Compressor
 | Units | Case 4
Name |  | ZB09KAU-TFD_Emilio
Number of Compressors |  | 3
Compressor Type |  | Detailed ARI
Displacement | cm³ | 25.29
Speed | rpm | 2900
Ref. Mass Flowrate | kg/s | 0.030081
Ref+Oil Mass Flowrate | kg/s | 0.030081
Refrigerant Solubility | % | 5.4074
Inlet Flowrate | m³/h | 12.561
Suction Pressure | kPa | 409.5
Suction Sat. Temp. | °C | -4.7761
Discharge Pressure | kPa | 1298.4
Discharge Sat. Temp. | °C | 37.69
Pressure Ratio |  | 3.1706
Suction Temp. | °C | 3.4239
Discharge Temp. | °C | 61.425
Inlet Superheat | K | 8.2
Suction Density | kg/m³ | 8.6211
Compressor Power | kW | 2.5293
Inverter Power | kW | 0
Power Input | kW | 2.5293
Heat Losses | % | 5
Isentropic Eff. | % | 70.792
Compressor Eff. | % | 67.252
Volumetric Eff. | % | 95.149

Sheet: Condenser Global results
Condenser
 | Global results
 | Units | Case 4
Name |  | SWEP B8LASH
Exchanger´s Type |  | Plates
Calculation Model |  | Detailed
Double Ref. Circuit |  | FALSE
Capacity | kW | 3.8493
Efficiency | % | 16.862
UA | W/K | 134.15
NTU |  | 0.18466
LMTD | K | 28.694
Min. Wall Temp. | °C | 30.022
Max. Wall Temp. | °C | 36.302
Sec Fluid. Freezing Temp. | °C | 0
Refrigerant |  | R290(propane)
Refrigerant Area | m² | 0.45502
De-superheating Area | % | 19.463
Two-Phase Area | % | 48.309
Subcooling Area | % | 32.228
Mass Flowrate | kg/s | 0.010027
Inlet Temperature | °C | 61.425
Outlet Temperature | °C | 30.247
Inlet Superheat | K | 23.735
Outlet Subcooling | K | 7.3718
Pressure Drop | kPa | 2.1287
Secondary Fluid |  | Water
Area | m² | 0.45502
Flowrate | m³/h | 0.62926
Inlet Temperature | °C | 30
Outlet Temperature | °C | 35.3
Pressure Drop | kPa | 23.772

Sheet: Condenser Refrigerant
Condenser
 | Refrigerant
 | Units | Case 4
Name |  | R290(propane)
Refrigerant Area | m² | 0.45502
Area Enh factor |  | 1.264
De-superheating Area | % | 19.463
Two-Phase Area | % | 48.309
Subcooling Area | % | 32.228
Mass Flowrate | kg/s | 0.010027
Inlet Temperature | °C | 61.425
Outlet Temperature | °C | 30.247
Inlet Superheat | K | 23.735
Outlet Subcooling | K | 7.3718
Heat Flux | W/m² | 8459.6
Two-Phase Heat Flux | W/m² | 14230
Heat Transfer Coeff. | W/(m² K) | 2361.8
Inlet Pressure | kPa | 1298.4
Outlet Pressure | kPa | 1296.2
Total Pressure Drop | kPa | 2.1287
Inlet Pressure Drop | kPa | 0
Internal Pressure Drop | kPa | 2.1287
Outlet Pressure Drop | kPa | 0
Inlet Sat. Temperature | °C | 37.69
Outlet Sat. Temperature | °C | 37.619
Fluid Volume | dm³ | 0.19175
Mass Inventory | kg | 0.039515

Sheet: Condenser Secondary fluid
Condenser
 | Secondary fluid
 | Units | Case 4
Name |  | Water
Area | m² | 0.45502
Area Enh factor |  | 1.264
Mass Flowrate | kg/s | 0.17393
Inlet Temperature | °C | 30
Outlet Temperature | °C | 35.3
Sec Fluid. Freezing Temp. | °C | 0
Heat Transfer Coeff. | W/(m² K) | 11272
Inlet Pressure | kPa | 101.35
Outlet Pressure | kPa | 77.578
Pressure Drop | kPa | 23.772
Inlet Pressure Drop | kPa | 0
Internal Pressure Drop | kPa | 23.772
Outlet Pressure Drop | kPa | 0
Inlet Velocity | m/s | 0.22808
Flowrate | m³/h | 0.62926
Pumping Power | W | 4.1552
Pump Consumption | W | 5.9361
Pump Efficiency | % | 70

Sheet: Condenser Geometry
Condenser
 | Geometry
 | Units | Case 4
HPCD | mm | 45.333
VPCD | mm | 278
Nominal Port diameter | mm | 16
Plate pitch | mm | 1.32
Channel type |  | H
Total Number of plates |  | 20
Double Ref. Circuit |  | FALSE

Sheet: Evaporator Global results
Evaporator
 | Global results
 | Units | Case 4
Name |  | Evap_Num_5x4_ST_9c_V4
Exchanger´s Type |  | Coil
Calculation Model |  | Detailed
Capacity | kW | 9.1451
Sensible Capacity | kW | 6.0759
SHR | % | 66.439
Min. Wall Temp. | °C | -2.9892
Max. Wall Temp. | °C | 8.2077
Refrigerant |  | R290(propane)
Mass Flowrate | kg/s | 0.030081
Inlet Temperature | °C | -4.0624
Outlet Temperature | °C | 3.4231
Inlet Quality |  | 0.2355
Outlet Superheat | K | 8.1992
Pressure Drop | kPa | 9.1334
Secondary Fluid |  | Air
Flowrate | m³/h | 1811.7
Face Velocity | m/s | 1.4801
Inlet Temperature | °C | 8.5
Outlet Temperature | °C | -1.0916
Pressure Drop | Pa | 16.951

Sheet: Evaporator Refrigerant
Evaporator
 | Refrigerant
 | Units | Case 4
Name |  | R290(propane)
Refrigerant Area | m² | 1.2101
Two Phase Area | % | 65.314
Superheating Area | % | 34.686
Mass Flowrate | kg/s | 0.030081
Inlet Temperature | °C | -4.0624
Outlet Temperature | °C | 3.4231
Inlet Quality |  | 0.2355
Outlet Superheat | K | 8.1992
Heat Flux | W/m² | 7557.2
Two-Phase Heat Flux | W/m² | 11015
Heat Transfer Coeff. | W/(m² K) | 2813.4
Inlet Pressure | kPa | 418.64
Outlet Pressure | kPa | 409.5
Total Pressure Drop | kPa | 9.1334
Inlet Press. Drop | kPa | -5.8208e-14
Internal Press. Drop | kPa | 9.1334
Bends Press. Drop | kPa | 0.21019
Outlet Press. Drop | kPa | 0
Inlet Sat. Temperature | °C | -4.0624
Outlet Sat. Temperature | °C | -4.7761
Bends Fluid Volume | cm³ | 13.564
Bends Mass Inventory | kg | 0.00037145
Total Fluid Volume | cm³ | 1917.7
Total Mass Inventory | kg | 0.063626

Sheet: Evaporator Secondary fluid
Evaporator
 | Secondary fluid
 | Units | Case 4
Name |  | Air
Area | m² | 15.617
Fins Area | m² | 14.094
Fin Efficiency | % | 30.433
Mass Flowrate | kg/s | 0.62523
Inlet Temperature | °C | 8.5
Outlet Temperature | °C | -1.0916
Heat Transfer Coeff. | W/(m² K) | 299.29
Inlet Pressure | kPa | 101.35
Outlet Pressure | kPa | 101.33
Pressure Drop | Pa | 16.951
Face Velocity | m/s | 1.4801
Flowrate | m³/h | 1811.7
Std Face Velocity | m/s | 1.5324
Std Flowrate | m³/h | 1875.7
S. Pumping Power | W | 8.5303
Fan Consumption | W | 12.186
Fan S. Efficiency | % | 70
Inlet Relat. Humidity | % | 80
Outlet Relative Humidity | % | 103.62
Condensate Mass Flowrate | kg/h | 4.3901

Sheet: Evaporator Geometry
Evaporator
 | Geometry
 | Units | Case 4
Tube diameter | mm | 7.92
Tube thickness | mm | 0.813
Internal surface |  | Smooth
Transversal spacing | mm | 20
Longitudinal spacing | mm | 25
Fin surface type |  | Plain
Fin spacing | fpi | 5
Fin thickness | mm | 0.08
Number of rows |  | 5
Number of circuits |  | 9
Refrigerant CrossFlow Area | m² | 0.00028002
Core height | mm | 100
Core depth | mm | 125
Finned length | mm | 3400
Finned face area | m² | 0.272
Fin surface area | m² | 14.094
Total coil surface area | m² | 15.617
Compactness ratio | m²/m³ | 367.45
Fin Mass | kg | 1.8632
Tube Mass | kg | 10.998
Bends Mass | kg | 0.070508
Total Mass | kg | 12.932
Sensible Efficiency | % | 76.001
Sensible UA | W/K | 908.21
Sensible NTU |  | 1.4271
Sensible LMTD | K | 6.69

Sheet: Accessories Discharge line
Accessories
 | Discharge line
 | Units | Case 4
Inlet Temperature | °C | 61.425
Outlet Temperature | °C | 61.425
Fluid State |  | Single-Phase State
De-superheat | K | 0
Heat Loss | W | -7.0037e-12
Total pressure drop | kPa | 0

Sheet: Accessories Liquid line
Accessories
 | Liquid line
 | Units | Case 4
Inlet Temperature | °C | 30.247
Outlet Temperature | °C | 30.247
Fluid State |  | Single-Phase State
Extra subcooling | K | 0
Heat Loss | W | -7.0037e-12
Total pressure drop | kPa | 0

Sheet: Accessories Suction line
Accessories
 | Suction line
 | Units | Case 4
Inlet Temperature | °C | 3.4239
Outlet Temperature | °C | 3.4239
Fluid State |  | Single-Phase State
Extra superheat | K | 0
Heat gain | W | -2.1011e-11
Total pressure drop | kPa | 0

Sheet: Refrigerant
Refrigerant
 | Refrigerant
 | Units | Case 4
Name |  | R290(propane)
Condensation Pressure (Cond. Outlet) | kPa | 1296.2
Condensation Glide | K | 0.070509
Evaporation Pressure (Evap. Outlet) | kPa | 409.5
Evaporation Glide | K | 0.71368
Liquid Density (Cond. Outlet) | kg/m³ | 484.71
Vapor Density (Evap. Outlet) | kg/m³ | 8.6211
Saturation Pressure (T=15 °C) | kPa | 731.87
Saturation Pressure (T=25 °C) | kPa | 952.62
Total Refrigerant Charge | kg | 0.1818
Refrigerant Mass in Evap. | kg | 0.063255
Refrigerant Mass in Cond. | kg | 0.11854
Refrigerant Mass in Comp. | kg | 0
