TKlebig/TimBAgit/UPV Assessment/FinalData/IMST_Reports_Test24/004_IMST_029_Test24 (Evap_Num_16x4_ST_3c_V5).xls

Sheet: Input Data & Parametric Studies
Basic Input Data
Input Data
Refrigerant: | R290(propane)
Compressor: | ZB09KAU-TFD_Emilio
Evaporator: | Evap_Num_16x4_ST_3c_V5
Condenser: | SWEP B8LASH
Expansion Device: | TXV 8.2 | °C
Tubing: | Simplified
Condenser Outlet: | Refrigerant Charge 0.1818 | kg
Parametrics Studies: | YES
 | Parametric Studies
 | Units | Case 1 | Case 2 | Case 3 | Case 4 | Case 5
Evaporator Sec. Fluid Inlet Flow Rate (*) | m³/h |  |  |  |  | 1811.7

Sheet: Summary
Summary
 | Summary
 | Units | Case 5
Inlet Sat. Condenser Temp. | °C | 35.825
Oulet Sat. Condenser Temp. | °C | 35.699
Inlet Sat. Evaporation Temp. | °C | 0.17324
Outlet Sat. Evaporation Temp. | °C | -4.1217
Inlet Condenser Press. | kPa | 1242.1
Outlet Condenser Press. | kPa | 1238.3
Inlet Evaporator Press. | kPa | 477.22
Oulet Evaporator Press. | kPa | 417.88
Condenser SubCooling | K | -6.8212e-13
Total SubCooling | K | -6.8212e-13
Evaporator Superheat | K | 8.2
Total SuperHeat | K | 8.2
COP |  | 3.2692
COP Auxiliary Included |  | 3.2064
EER |  | 11.165
EER Auxiliary Included |  | 10.951
Total Carnot Eff. | % | 48.39
Total Carnot Eff. Auxiliary Included | % | 47.461
COP(HPA) |  | 4.2192
COP(HPA) Auxiliary Included |  | 4.1382
EER(HPA) |  | 14.409
EER(HPA) Auxiliary Included |  | 14.133
TCE(HPA) | % | 54.4
TCE(HPA) Auxiliary Included | % | 53.355
Cooling Capacity | kW | 7.9582
Heating Capacity | kW | 10.271
Mass Flowrate | kg/s | 0.030944
Comp. Disch. Temp. | °C | 58.521
Comp. Power Input | kW | 2.4343
Global Power Input | kW | 2.482
Isentropic Eff. | % | 71.39
Compressor Eff. | % | 67.821
Volumetric Eff. | % | 96.007
Refrigerant |  | R290(propane)

Sheet: Compressor
Compressor
 | Compressor
 | Units | Case 5
Name |  | ZB09KAU-TFD_Emilio
Number of Compressors |  | 3
Compressor Type |  | Detailed ARI
Displacement | cm³ | 25.29
Speed | rpm | 2900
Ref. Mass Flowrate | kg/s | 0.030944
Ref+Oil Mass Flowrate | kg/s | 0.030944
Refrigerant Solubility | % | 5.9149
Inlet Flowrate | m³/h | 12.674
Suction Pressure | kPa | 417.88
Suction Sat. Temp. | °C | -4.1217
Discharge Pressure | kPa | 1242.1
Discharge Sat. Temp. | °C | 35.825
Pressure Ratio |  | 2.9723
Suction Temp. | °C | 4.0783
Discharge Temp. | °C | 58.521
Inlet Superheat | K | 8.2
Suction Density | kg/m³ | 8.7894
Compressor Power | kW | 2.4343
Inverter Power | kW | 0
Power Input | kW | 2.4343
Heat Losses | % | 5
Isentropic Eff. | % | 71.39
Compressor Eff. | % | 67.821
Volumetric Eff. | % | 96.007

Sheet: Condenser Global results
Condenser
 | Global results
 | Units | Case 5
Name |  | SWEP B8LASH
Exchanger´s Type |  | Plates
Calculation Model |  | Detailed
Double Ref. Circuit |  | FALSE
Capacity | kW | 3.4236
Efficiency | % | 18.578
UA | W/K | 132.8
NTU |  | 0.20553
LMTD | K | 25.781
Min. Wall Temp. | °C | 31.82
Max. Wall Temp. | °C | 36.264
Sec Fluid. Freezing Temp. | °C | 0
Refrigerant |  | R290(propane)
Refrigerant Area | m² | 0.45502
De-superheating Area | % | 26.969
Two-Phase Area | % | 73.031
Subcooling Area | % | 0
Mass Flowrate | kg/s | 0.010315
Inlet Temperature | °C | 58.521
Outlet Temperature | °C | 35.699
Inlet Superheat | K | 22.696
Outlet Subcooling | K | -6.8212e-13
Pressure Drop | kPa | 3.7168
Secondary Fluid |  | Water
Area | m² | 0.45502
Flowrate | m³/h | 0.55967
Inlet Temperature | °C | 30
Outlet Temperature | °C | 35.3
Pressure Drop | kPa | 19.746

Sheet: Condenser Refrigerant
Condenser
 | Refrigerant
 | Units | Case 5
Name |  | R290(propane)
Refrigerant Area | m² | 0.45502
Area Enh factor |  | 1.264
De-superheating Area | % | 26.969
Two-Phase Area | % | 73.031
Subcooling Area | % | 0
Mass Flowrate | kg/s | 0.010315
Inlet Temperature | °C | 58.521
Outlet Temperature | °C | 35.699
Inlet Superheat | K | 22.696
Outlet Subcooling | K | -6.8212e-13
Heat Flux | W/m² | 7524
Two-Phase Heat Flux | W/m² | 8802.1
Heat Transfer Coeff. | W/(m² K) | 3456.5
Inlet Pressure | kPa | 1242.1
Outlet Pressure | kPa | 1238.3
Total Pressure Drop | kPa | 3.7168
Inlet Pressure Drop | kPa | 0
Internal Pressure Drop | kPa | 3.7168
Outlet Pressure Drop | kPa | 0
Inlet Sat. Temperature | °C | 35.825
Outlet Sat. Temperature | °C | 35.699
Fluid Volume | dm³ | 0.19175
Mass Inventory | kg | 0.011262

Sheet: Condenser Secondary fluid
Condenser
 | Secondary fluid
 | Units | Case 5
Name |  | Water
Area | m² | 0.45502
Area Enh factor |  | 1.264
Mass Flowrate | kg/s | 0.15469
Inlet Temperature | °C | 30
Outlet Temperature | °C | 35.3
Sec Fluid. Freezing Temp. | °C | 0
Heat Transfer Coeff. | W/(m² K) | 10459
Inlet Pressure | kPa | 101.35
Outlet Pressure | kPa | 81.604
Pressure Drop | kPa | 19.746
Inlet Pressure Drop | kPa | 0
Internal Pressure Drop | kPa | 19.746
Outlet Pressure Drop | kPa | 0
Inlet Velocity | m/s | 0.20285
Flowrate | m³/h | 0.55967
Pumping Power | W | 3.0697
Pump Consumption | W | 4.3853
Pump Efficiency | % | 70

Sheet: Condenser Geometry
Condenser
 | Geometry
 | Units | Case 5
HPCD | mm | 45.333
VPCD | mm | 278
Nominal Port diameter | mm | 16
Plate pitch | mm | 1.32
Channel type |  | H
Total Number of plates |  | 20
Double Ref. Circuit |  | FALSE

Sheet: Evaporator Global results
Evaporator
 | Global results
 | Units | Case 5
Name |  | Evap_Num_16x4_ST_3c_V5
Exchanger´s Type |  | Coil
Calculation Model |  | Detailed
Capacity | kW | 7.9582
Sensible Capacity | kW | 5.3445
SHR | % | 67.157
Min. Wall Temp. | °C | -1.3744
Max. Wall Temp. | °C | 8.5
Refrigerant |  | R290(propane)
Mass Flowrate | kg/s | 0.030944
Inlet Temperature | °C | 0.17324
Outlet Temperature | °C | 4.0783
Inlet Quality |  | 0.33817
Outlet Superheat | K | 8.2
Pressure Drop | kPa | 59.346
Secondary Fluid |  | Air
Flowrate | m³/h | 1811.7
Face Velocity | m/s | 1.4801
Inlet Temperature | °C | 8.5
Outlet Temperature | °C | 0.067276
Pressure Drop | Pa | 47.987

Sheet: Evaporator Refrigerant
Evaporator
 | Refrigerant
 | Units | Case 5
Name |  | R290(propane)
Refrigerant Area | m² | 1.5177
Two Phase Area | % | 86.8
Superheating Area | % | 13.2
Mass Flowrate | kg/s | 0.030944
Inlet Temperature | °C | 0.17324
Outlet Temperature | °C | 4.0783
Inlet Quality |  | 0.33817
Outlet Superheat | K | 8.2
Heat Flux | W/m² | 5243.5
Two-Phase Heat Flux | W/m² | 5733
Heat Transfer Coeff. | W/(m² K) | 5116.8
Inlet Pressure | kPa | 477.22
Outlet Pressure | kPa | 417.88
Total Pressure Drop | kPa | 59.346
Inlet Press. Drop | kPa | -5.8208e-14
Internal Press. Drop | kPa | 59.346
Bends Press. Drop | kPa | 2.8513
Outlet Press. Drop | kPa | 0
Inlet Sat. Temperature | °C | 0.17324
Outlet Sat. Temperature | °C | -4.1217
Bends Fluid Volume | cm³ | 85.208
Bends Mass Inventory | kg | 0.0044797
Total Fluid Volume | cm³ | 3080.5
Total Mass Inventory | kg | 0.15249

Sheet: Evaporator Secondary fluid
Evaporator
 | Secondary fluid
 | Units | Case 5
Name |  | Air
Area | m² | 15.388
Fins Area | m² | 13.557
Fin Efficiency | % | 36.016
Mass Flowrate | kg/s | 0.62523
Inlet Temperature | °C | 8.5
Outlet Temperature | °C | 0.067276
Heat Transfer Coeff. | W/(m² K) | 293
Inlet Pressure | kPa | 101.35
Outlet Pressure | kPa | 101.3
Pressure Drop | Pa | 47.987
Face Velocity | m/s | 1.4801
Flowrate | m³/h | 1811.7
Std Face Velocity | m/s | 1.5324
Std Flowrate | m³/h | 1875.7
S. Pumping Power | W | 24.15
Fan Consumption | W | 34.5
Fan S. Efficiency | % | 70
Inlet Relat. Humidity | % | 80
Outlet Relative Humidity | % | 101.83
Condensate Mass Flowrate | kg/h | 3.7386

Sheet: Evaporator Geometry
Evaporator
 | Geometry
 | Units | Case 5
Tube diameter | mm | 9.52
Tube thickness | mm | 0.813
Internal surface |  | Smooth
Transversal spacing | mm | 20
Longitudinal spacing | mm | 25
Fin surface type |  | Plain
Fin spacing | fpi | 5
Fin thickness | mm | 0.08
Number of rows |  | 16
Number of circuits |  | 3
Refrigerant CrossFlow Area | m² | 0.00014683
Core height | mm | 100
Core depth | mm | 400
Finned length | mm | 3400
Finned face area | m² | 0.272
Fin surface area | m² | 13.557
Total coil surface area | m² | 15.388
Compactness ratio | m²/m³ | 113.15
Fin Mass | kg | 5.9622
Tube Mass | kg | 21.558
Bends Mass | kg | 0.34497
Total Mass | kg | 27.866
Sensible Efficiency | % | 100.86
Sensible UA | W/K | 1000000
Sensible NTU |  | 1
Sensible LMTD | K | 0.0053445

Sheet: Accessories Discharge line
Accessories
 | Discharge line
 | Units | Case 5
Inlet Temperature | °C | 58.521
Outlet Temperature | °C | 58.521
Fluid State |  | Single-Phase State
De-superheat | K | 8.5265e-13
Heat Loss | W | -5.4036e-11
Total pressure drop | kPa | 0

Sheet: Accessories Liquid line
Accessories
 | Liquid line
 | Units | Case 5
Inlet Temperature | °C | 35.699
Outlet Temperature | °C | 35.699
Fluid State |  | Two-Phase State
Extra subcooling | K | -10000
Heat Loss | W | 0
Total pressure drop | kPa | 0

Sheet: Accessories Suction line
Accessories
 | Suction line
 | Units | Case 5
Inlet Temperature | °C | 4.0783
Outlet Temperature | °C | 4.0783
Fluid State |  | Single-Phase State
Extra superheat | K | 0
Heat gain | W | -1.8012e-11
Total pressure drop | kPa | 0

Sheet: Refrigerant
Refrigerant
 | Refrigerant
 | Units | Case 5
Name |  | R290(propane)
Condensation Pressure (Cond. Outlet) | kPa | 1238.3
Condensation Glide | K | 0.12527
Evaporation Pressure (Evap. Outlet) | kPa | 417.88
Evaporation Glide | K | 4.2949
Liquid Density (Cond. Outlet) | kg/m³ | 176.5
Vapor Density (Evap. Outlet) | kg/m³ | 8.7894
Saturation Pressure (T=15 °C) | kPa | 731.87
Saturation Pressure (T=25 °C) | kPa | 952.62
Total Refrigerant Charge | kg | 0.1818
Refrigerant Mass in Evap. | kg | 0.14801
Refrigerant Mass in Cond. | kg | 0.033786
Refrigerant Mass in Comp. | kg | 0
