TKlebig/TimBAgit/Results/2017_1024 Arneg - Francoforte R290 v2.xlsx

Sheet: Evaporator
Design Options | # rows | # columns | Pipe OD | Tube thickness | Pipe ID | Tube length | Fin space | Fin thickness | Width | Height | Number of fins | Volume | Tube surface | Fin surface
 |  |  | mm | mm mm | mm | mm | mm | mm | mm | mm |  | dm³ | m² | m²
Original | 10 | 4 | 7 | 0.5 | 6.5 | 1000 | 8 | 0.18 | 14.5 | 350 | 122 | 1.327 | 0.880 | 0.61915
2 | 8 | 4 | 7 | 0.5 | 6.5 | 1000 | 8 | 0.18 | 14.5 | 280 | 122 | 1.062 | 0.704 | 0.49532
3 | 8 | 4 | 7 | 0.5 | 6.5 | 1000 | 7 | 0.18 | 14.5 | 280 | 139 | 1.062 | 0.704 | 0.56434
 |  |  |  |  |  |  |  |  |  |  |  |  |  | 1.139344262
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
