TKlebig/TimBAgit/Results/Tim_Work.xlsx

Sheet: White Board
Legend: | Instructions >>> |  |  | One action item per row |  |  | Whenever possible, enter a date | To keep text and format intact, copy the appropriate cell (just below) in the rows.
This color = field to be filled or revised by the "Resp." person |  |  |  |  |  |  |  | In plan - on track | Open
 |  |  |  |  |  |  |  | In plan - at risk/late | Closed
 |  |  |  |  |  |  |  | Action not executed
 |  |  |  |  |  |  |  | Tackeled - Mute pt
Check | Topic | General status | Situation | IntSol Actions | Entered by / when | Resp. | When / by when | Action tracking | Action status | Link to more info.
 | Projects
Is it only for VS chillers (VS)? | PeC customized for Carrier VS chiller | - Engagement by Carrier - No sales agreement - preliminary planning | Whether Carrier moves on or not, the two chillers (WLK & MIK) will be used to further develop and FIELD test PeC | Provide training Abhinav and Cédric on Dixell iPro - 1st module "Platform" |  | EW |  | In plan - on track
 | PeC "catalog" product for VS | - Transitioning from Stéphane to Abhinav, working on version 2 (low supeheat & FDD) - Qualification campaign for VS scrolls delayed due to SEER priority | Should benefit from above | Proceed with "system control" plans with or without Carrier support (Dixell) |  | EW | on-going work without being disturb by customer engagement status | In plan - on track
 | PeC Premium Dev Chiller Installation | Planned for end Feb | Dwg missing | Chase RP |  | AK |  | In plan - at risk/late
 | Crank case heater optimization project | - One of the means by which we want to improve the SEER of chillers - Lead by Olivier Liegeois | - This is a territory where we don't know what we don't know. - It is therefore critical to go in gemba, speak to the field people, and SEGMENT the applications (or chiller situations) | Lead the system engineering aspect of the challenge leveraging on the AE "science" |  | EW |  | In plan - on track
 | Innovation, ideation funnel | It appears that not all ideas (e.g. IAQ, indoor air quality) are reported in this funnel. Some seem to be categorized more "R&D" | Michael Oaklay has changed position and Greg Hemmelgran has taken over. | Keep going. Continue as decided in March 2016 at The Helix |  | EW | Permanent | In plan - on track | Open
 | CO2 Transcritical Unit | - Bypass algorithm optimisation |  |  |  | MQ
 | CO2 Transcritical Unit | - Valve qualification
 | Integrated Solutions for Display Cases | Project has been kicked off with the objectives. Detailed spec being worked on. | Need to complete "Understand" quadrant | Invite Samuele da Ros as expert. Touch base with Steve. |  | EW
 | ORC market study | - Rob and Jenny to determine team and scheme of project - Rob said he will call a review in January |  | Include Abhinav in the group of experts. Participation to Rob's review in January (not scheduled yet) |  | EW, GW |  | In plan - on track
 | Centrifugal technology | In the air. No formal shaping. |  | Read emails |  | GW |  | ?
 | Technology watch
 | Bosch interconned world conference in Berlin |  | Berlin, March 15-16th | Eric & Stéphane attending + Abhinav in Hackathon |  |  |  | In plan - on track
 | Euroshop |  | Düsseldorf | IntSol Team to attend |  |  |  | In plan - on track
 | ISH |  | Frankfurt | IntSol Team to attend |  |  |  | In plan - on track
 | Processes, operational
 | IP protection, NDA with respect to consultancy work | Evaluating the hiring of one of our service providers (consultant). | There significant risks in working with "one man show" consultants, who however are typically very cost effective… | - Determine options/needs with advice from R. Hoffmann
 | X-Matrix
Copy fully closed rows here below "for archives". Most recent ones on top of the stack. Add link to the location where details can be found, under header "Link to more info".
 | SOL ENERGY paper | Frank Rinne has seen the presentation in a conference. Also known by Rob and others. Came through Bob Richardson, Samuele da Ros | Not credible. | Was reviewed by Frank, Eric and Rob |  |  | December 2016, Eric & Guido talk. | Tackeled - Mute pt | Closed
 | Innovation, ideation funnel | It appears that not all ideas (e.g. IAQ, indoor air quality) are reported in this funnel. Some seem to be categorized more "R&D" | Michael Oaklay has changed position and Greg Hemmelgran has taken over. | Call (phone) Greg. Objective: continue the initiave with or without everyone. |  | EW | Done. Helix included in the tracking sheet | Tackeled - Mute pt | Closed
 | Centrifugal technology | In the air. No formal shaping. |  | Brief Maurizio & Enrico about "what is possibly at stake" |  | EW | Met with MB and EF -Will be included in BusRev |  | Closed
 | Centrifugal technology | In the air. No formal shaping. |  | Seek marketing's educated opinion about need to pursue this path. "Hello! It's about compression!" |  | GW, EW | Met with MB and EF -Will be included in BusRev |  | Closed
 | PeC customized for Carrier VS chiller | - Engagement by Carrier - No sales agreement - preliminary planning | Whether Carrier moves on or not, the two chillers (WLK & MIK) will be used to further develop and FIELD test PeC | Eric to ask Giuseppe if he may attend the introductory part |  | EW |  | Will attend | Closed

Sheet: Staff meeting
 | Week 3 | Week 4 | Week 5 | Week 6 | Week 7 | Week 8 | Week 9 | Week 10 | Week 11 | Week 12 | week 13 | week 14 | week 15 | week 16 | week 17 | week 18 | week 19 | week 20 | week 21 | week 22 | week 23 | week 24 | week 25 | week 26 | July week 27 | Week 28 | Week 29 | Week 30 | Week 31 | Week 32 | Week 33 | Week 34 | Week 35 | September-Week 36 | Week 37 | Week 38 | Week 39 | October - Week 40 | Week 41 | Week 42 | Week 43 | November - Week 44 | Week 45 | Week46 | Week 47 | Week Dezember - 48 | Week 49 | Week 50 | Week 51
Tim |  |  |  |  |  |  |  |  |  |  |  |  |  | Ramp up knowledge on the project | Follow Matthew Evap with Luvata Electronic valve | Contact STR for the refrigeration AlfaLaval selection compare with Swep Update elec diag and get quote Heinen Evap for the 3x150gr Get TÜV approb progress Order new PT5 with welding Follow matching compressor and drive | Base line test analysis | IntSol Review prep Baseline testing STR Quote AlfaLaval selection compare with Swep Update elec diag and get quote Heinen | AlfaLaval selection compare with Swep Baseline testing analysis Epta analysis | Meeting with Heinen Alfa Laval selection Last tests analysis Epta and AHT analysis Swep selection STR schematic | Get Heinen quote (+add fan) Get AL HX Epta, AHT, Lab Test analysis STR lead time | Bring components to Heinen Meeting AL Epta, AHT, Lab Test analysis Arneg Display Case |  | Charge calculation Data analysis Base line test with internal product temp |  |  |  |  |  |  |  |  |  |  |  |  |  |  | Air flow measurement | Change Compressors, Air flow Measurement, Oil calculation | Refill Refrigerant, Analyse Data, Literature Review, EES, Oil Calculation, Coil Calculation | Air flow measurements with and without curtain | Worked on Python script Air flow visualisations with Inkscape Simple evap model with EES Achieved good values again. (open ceiling and 25pct fp) 48h tests over the weekend (25pct vs 27pct fan power) Analyse: Last period Cooling capacity TEC Average over 75% of the last period COP Product temperature LMTD condensor Average over 10% of the last period Values for log ph diagram | Drawing off the air distribution in the chamber with different settings Graphic of compressor weight Helped Christian & Romain with filling | Used the drive to run the compressor with a higher frequency to ensure better oil return --> No effect 25pct fan power tests (open ceiling vs closed ceiling) Further work on Pythonscript All version issues solved Now able to read and resample data Several plots Helped Abicheck with filling | final Air velocity tests Python script | Worked full time on Python script: | Literature Review - VDI Heat Atlas, ACHP, Stalter Modelbuilding - Evaporator Coil arrangement

Sheet: Pier-board
 | Resp. | Status
IDC 150gr
Week of the 7th August: New design testing and Analysis
Load test: 2 circuits testing performed during the weekend: check quality of the measurement | PA | done
Measure water output during the testing (missing 3 circuits) | PA/DD | in progress
Test with only one circuit | PA | done
Analyse the Fan Speed testing: gather data Vdot power and Speed to share with EBM | PA | done
Superheat controller of C3 too high vs what the controller sees: wrong inputs?: to be fixed next campaign with that circuit | DD | done
Meeting with UPV on Wednesday 09/08/17 on Theoretical assessment of the best possible design | EW/PA | done
Measure AHT DC & Carrier DC geometry and send it EBM | PA/EW | in progress
Week of the 14th August: New design testing and Analysis
Base line Test at 55°C | PA
High speed test at 57Hz | PA
IDC Air flow parametric testing tape baffle Testing | PA/DD/EW
Week of the 21th August : New compressors installation and testing
Change of compressors(Disconnect inverter!)/commissioning/test campaign start | DD/PA
New high efficiency compressors: results required for end of August-Start installation | PA
IDC 500gr
Week 7th August: Installation of the module on the Aerneg Unit
Display case adjustments: Remove TXV | DD | done
Install Water Control unit and VSS Ref module on top of the Aerneg DC | DD | done
Water loop back from WLK | CDJ | done
Instrumentation | CDJ | in progress
