TKlebig/TimBAgit/Results/3MAfVSHATCOL_evap-cond-comp.xlsx

 | Conditions | T [°C] | T [K] | p [bar] | p [Pa] | % | Oil Volume
1. Set conditions | Evaporator | -10 | 263.15 | 3.451202571 | 345120.2571 |  | v= | 470 | ml
2. Use solver | SH | 10 | 10 |  |  |  | Refrigerant Mass
2.1. on press eqn | Condensor | 35 | 308.15 | 12.17509491 | 1217509.491 |  | m= | 150 | g
2.2. on visc eqn | SC | 0 | 0
3. you don’t have to use Solver | Oil Temp (Comp) | 30 | 303.15 | 3.451202571 | 345120.2571
if you just change the distribution | % Oil in Evaporator |  |  |  |  | 10%
 | % Oil in Condensor |  |  |  |  | 10%
 | % Oil in Compressor |  |  |  |  | 80%
 | HATCOL4467 |  |  |  |  |  |  |  |  |  |  |  |  | HATCOL4467 |  |  | 3MAF
 | Evaporator | USE SOLVER |  |  |  |  |  | USE SOLVER |  |  |  |  | coeff# | Kinematic Visc | Press | Density | Kinematic Visc | Press | Density
 | μ | c | visc eqn | ω | T(K) | T(°C) | P (bar) | Log(P)= | pres eqn | visc (diff)2 | P (diff)2 | ρ= | a1 | 19.3145 | 5.41861 | 1.21151 | 21.2457 | 5.14204 | 1.24747
 | 3.7 | 0.3955359766 | 0.3955355524 | 0.354 | 263.15 | -10 | 3.45 | 0.5379704513 | 0.5394578381 | 1.799298236e-13 | 2.212319455e-06 | 0.7875 | a2 | -3.11182 | -1539.69 | -0.00083845 | -3.48214 | -1395.63 | -0.00109
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
