TKlebig/TimBAgit/Results/Condensing water.xlsx

Condensing water
Starttime | Stoptime | Mass water [kg] | Mass water [kg/day] | Cycle
13:00:00 | 16:00:00 | 8.888 | 71.10 | 3:00:00
 |  |  |  |  | Start defrost (00:00) |  |  |  | Start cooling (00:30)
 |  |  |  |  | left | mid | right |  | left | mid | right
 |  |  |  |  | 1.5°C | 1.5°C | 3°C |  | 0.2°C | 0.2°C | 1.5°C
 |  |  |  | OUT | 78% | 78% | 72% | OUT | 84% | 84% | 77%
 |  |  |  | IN | 9°C | 9°C | 12°C | IN | 7°C | 7°C | 8°C
 |  |  |  |  | 78% | 77% | 82% |  | 70% | 70% | 73%
 |  |  |  |  |  |  |  |  | End cooling (02:45)
 |  |  |  |  |  |  |  |  | left | mid | right
 |  |  |  |  |  |  |  |  | -2 °C | -2 °C | 0°C
 |  |  |  |  |  |  |  | OUT | 82% | 82% | 85%
 |  |  |  |  |  |  |  | IN | 9°C | 9°C | 11°C
 |  |  |  |  |  |  |  |  | 90% | 90% | 95%
