TKlebig/TimBAgit/Results/Evaporator modell test 60 output.XLSX

DELTA_p_A_a_in | DELTA_p_A_b_in | DELTA_p_A_c_in | DELTA_p_A_d_in | DELTA_p_A_e_in | DELTA_p_A_f_in | DELTA_p_A_tot | p_A_a_in | p_A_a_out | p_A_b_out | p_A_c_out | p_A_d_out | p_A_e_out | p_A_f_out | Q_dot_A_a_dry
[Pa] | [Pa] | [Pa] | [Pa] | [Pa] | [Pa] | [Pa] | [Pa] | [Pa] | [Pa] | [Pa] | [Pa] | [Pa] | [Pa] | [W]
12861 | 11751 | 11478 | 11452 | 7652 | 6003 | 61198 | 391310 | 378449 | 366698 | 355219 | 343767 | 336115 | 330112 | 135.3
