TKlebig/TimBAgit/Results/Evaporator modell test60 LIDL Results.xlsx

'DELTA_p_A_a_in [Pa]' | 'DELTA_p_A_b_in [Pa]' | 'DELTA_p_A_c_in [Pa]' | 'DELTA_p_A_d_in [Pa]' | 'DELTA_p_A_e_in [Pa]' | 'DELTA_p_A_f_in [Pa]' | 'DELTA_p_A_tot [Pa]' | 'p_A_a_in [Pa]' | 'p_A_a_out [Pa]' | 'p_A_b_out [Pa]' | 'p_A_c_out [Pa]' | 'p_A_d_out [Pa]' | 'p_A_e_out [Pa]' | 'p_A_f_out [Pa]' | 'Q_dot_A_a_dry [W]' | 'Q_dot_A_b_dry [W]' | 'Q_dot_A_c_dry [W]' | 'Q_dot_A_d_dry [W]' | 'Q_dot_A_e_dry [W]' | 'Q_dot_A_f_dry [W]' | 'Q_dot_A_tot [W]' | 'T_air_A_a_in [°C]' | 'T_air_A_a_out [°C]' | 'T_air_A_b_out [°C]' | 'T_air_A_c_out [°C]' | 'T_air_A_d_out [°C]' | 'T_air_A_e_out [°C]' | 'T_air_A_f_out [C]' | 'T_refr_A_a_in [°C]' | 'T_refr_A_a_out [°C]' | 'T_refr_A_b_out [°C]' | 'T_refr_A_c_out [°C]' | 'T_refr_A_d_out [°C]' | 'T_refr_A_e_out [°C]' | 'T_refr_A_f_out [°C]' | 'u_A_a_in [m/s]' | 'u_A_b_in [m/s]' | 'u_A_c_in [m/s]' | 'u_A_d_in [m/s]' | 'u_A_e_in [m/s]' | 'u_A_f_in [m/s]' | 'x_A_a_in' | 'x_A_b_in' | 'x_A_c_in' | 'x_A_d_in' | 'x_A_e_in' | 'x_A_f_in' | Column1
12861 | 11751 | 11570 | 11436 | 7651 | 6004 | 61274 | 391310 | 378449 | 366697 | 355127 | 343691 | 336041 | 330036 | 135.3 | 279.7 | 493.1 | 816.3 | 176.7 | 76.87 | 1978 | -3.345 | -4.298 | -3.345 | -1.374 | 2.102 | 7.854 | 9.1 | -6.163 | -7.2 | -8.172 | -9.151 | -10.14 | 1.263 | 7.059 | 1.782 | 2.035 | 2.608 | 4.148 | 14.68 | 17.12 | 0.39 | 0.4413 | 0.5409 | 0.712 | 0.991 | 100
