TKlebig/TimBAgit/Results/50 35 4hdefr 30pct/figures/COP.png

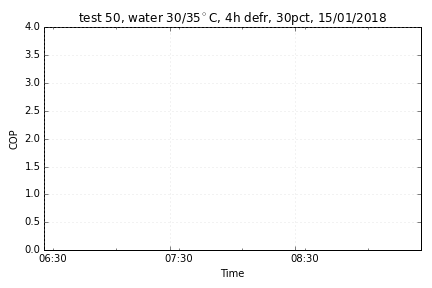
Results/50 35 4hdefr 30pct/figures/COP.png
