TKlebig/TimBAgit/Results/50 35 4hdefr 30pct/figures/load_boxes.png

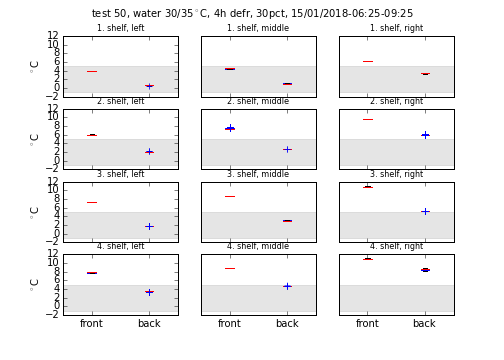
Results/50 35 4hdefr 30pct/figures/load_boxes.png
