TKlebig/TimBAgit/Results/50 35 4hdefr 30pct/figures/mass flow rates.png

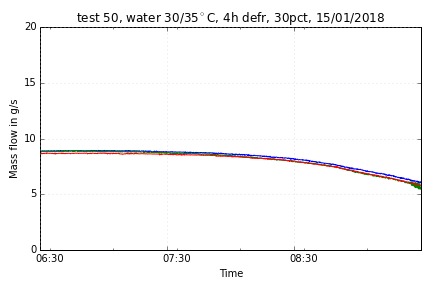
Results/50 35 4hdefr 30pct/figures/mass flow rates.png
