TKlebig/TimBAgit/Results/50 35 4hdefr 30pct/figures/Product Temperature.png

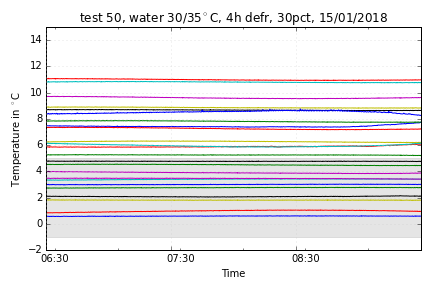
Results/50 35 4hdefr 30pct/figures/Product Temperature.png
