TKlebig/TimBAgit/Results/50 35 4hdefr 30pct/figures/T_evap.png

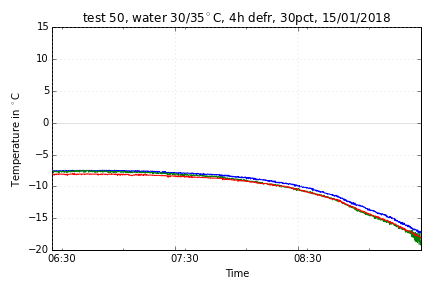
Results/50 35 4hdefr 30pct/figures/T_evap.png
