TKlebig/TimBAgit/BA/Pictures/10pctOC_temp.pdf

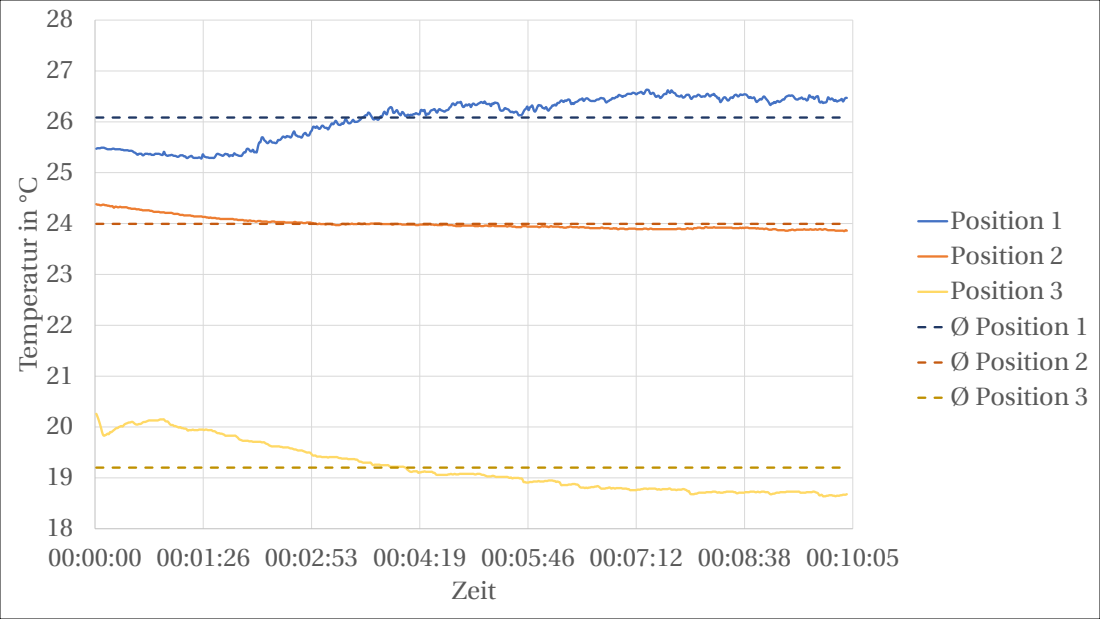
[picture p169: page 1]
Temperatur in; Zeit; Position 1 Position 2 Position 3 Ø Position 1 Ø Position 2 Ø Position 3
