TKlebig/TimBAgit/BA/Pictures/Qdots_lastCycle.pdf

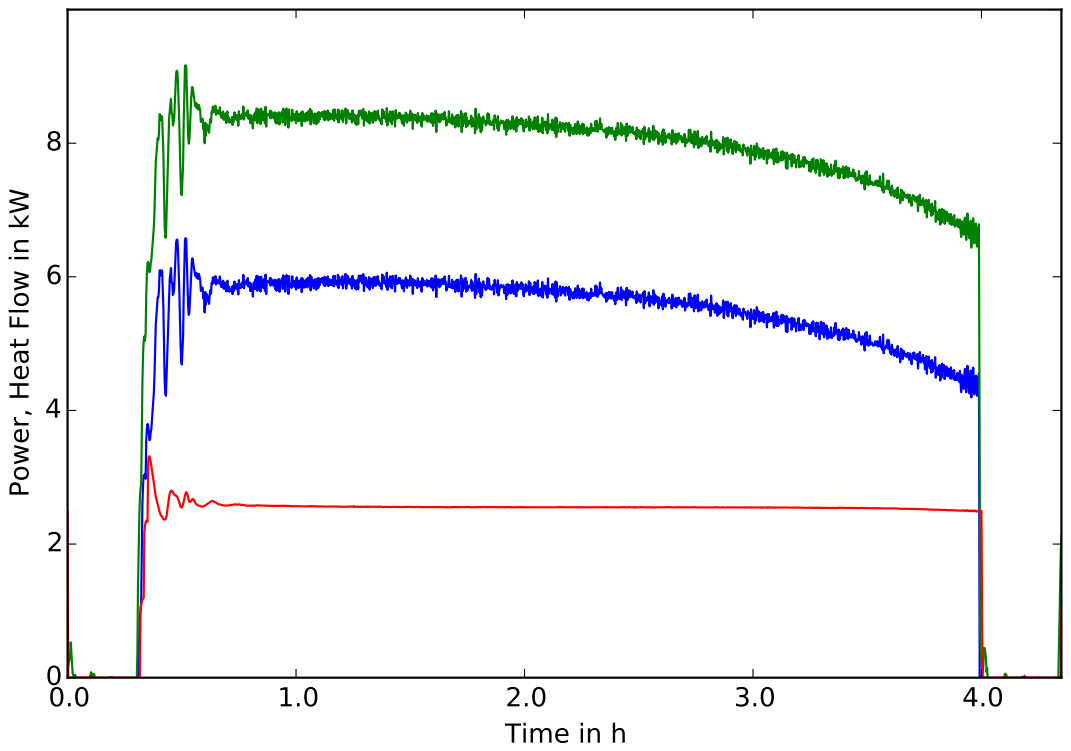
[picture p170: page 1]
Time in h

Power, Heat Flow in kW
