TKlebig/TimBAgit/Evaporator Coil Design/AHTLIDLV1V2.pdf

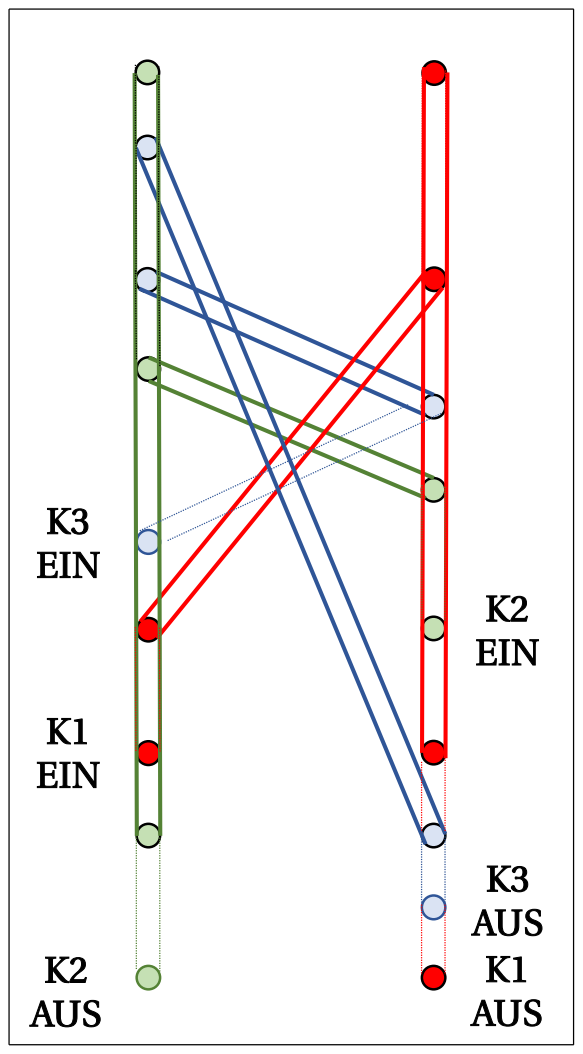
[picture p171: page 1]
K2 EIN; K3 EIN; K2 AUS; K3 AUS K1 AUS; K1 EIN

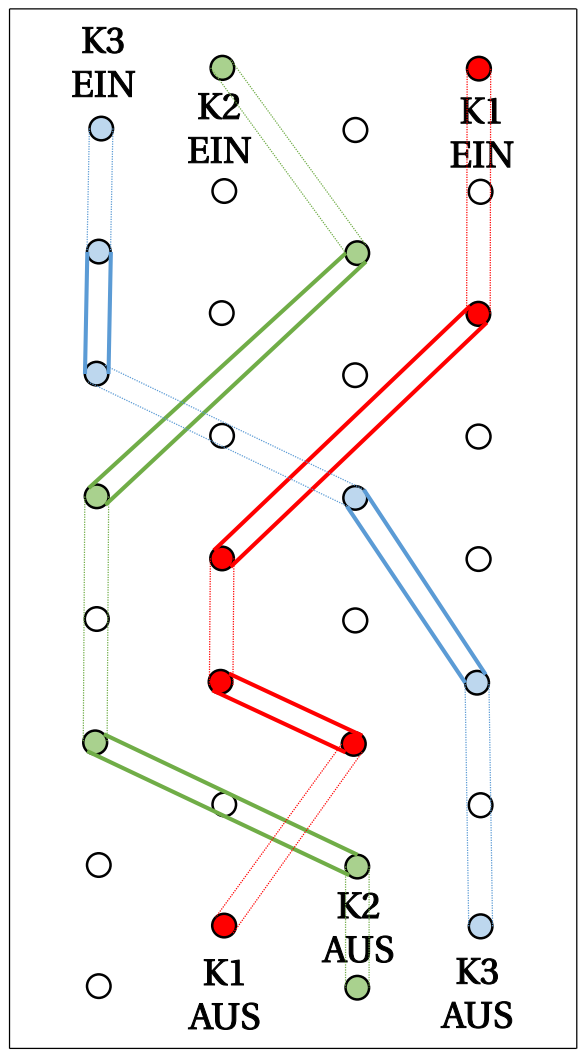
[picture p172: page 2]
K2 EIN; K3 EIN; AUS; K1 AUS; K1 EIN

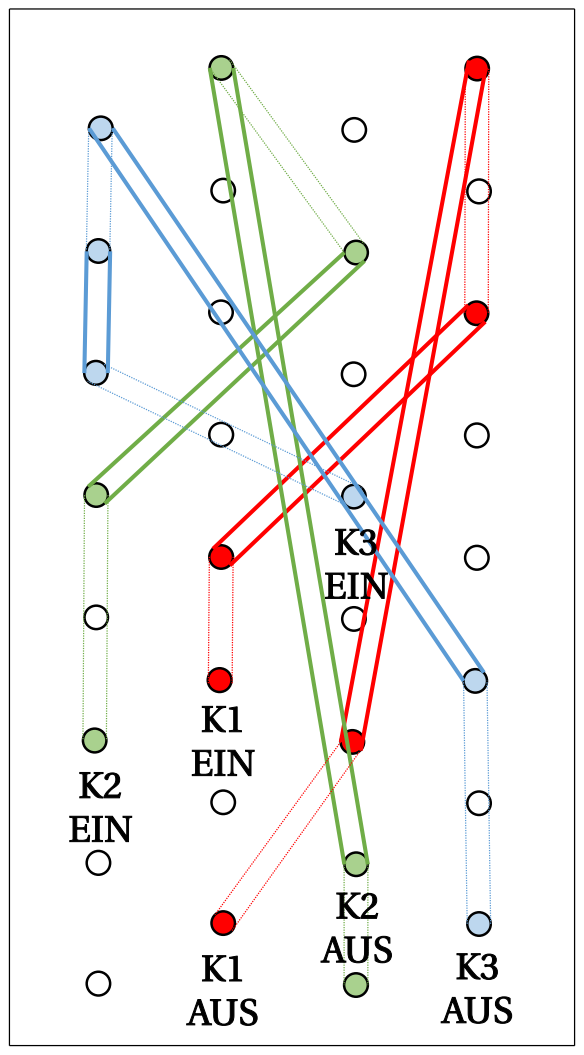
[picture p173: page 3]
K2 EIN; K3 EIN; AUS; K1 AUS; K1 EIN
