TKlebig/TimBAgit/Evaporator Coil Design/Original LIDL DESIGN.pdf

# Evaporator Design Comparison

Original AHT | from Lidl (AHT new design?)

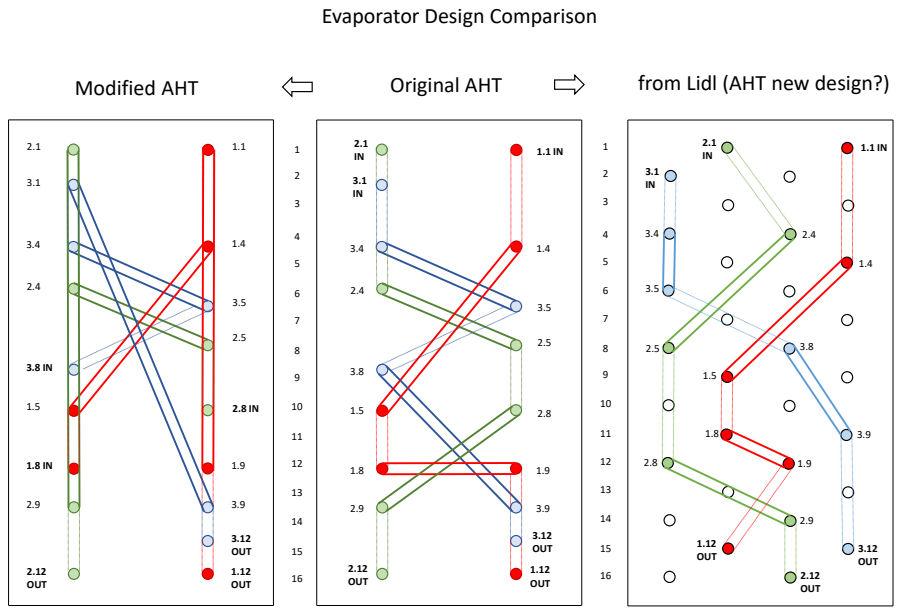
[picture p174: page 1]
2.12 OUT; 3.12 OUT; 1.12 OUT; Modified AHT

# Evaporator Design Comparison

Original LIDL design | modified LIDL design

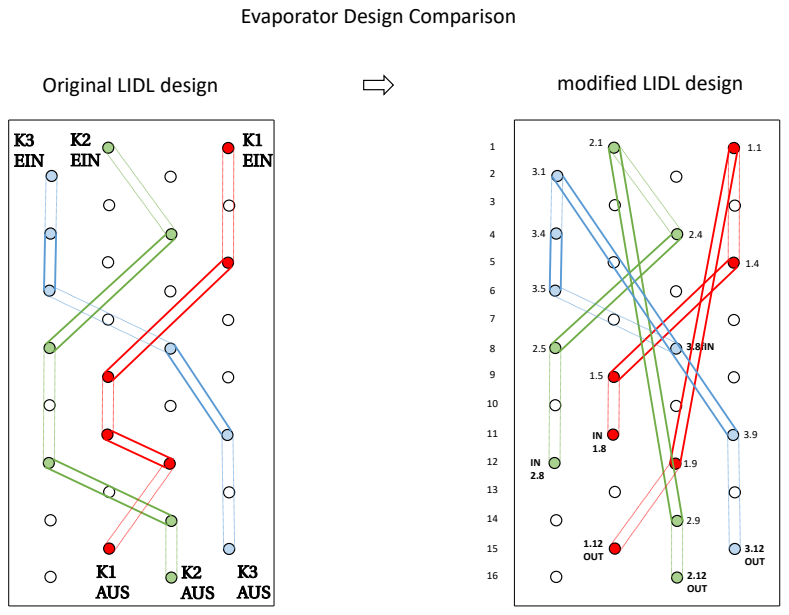
[picture p175: page 2]
3.8fIN; 2.12 OUT; 3.12 OUT; 1.12 OUT; K2 EIN; K3 EIN; K2 AUS; K3 AUS; K1 AUS; K1 EIN

K2

## EIN

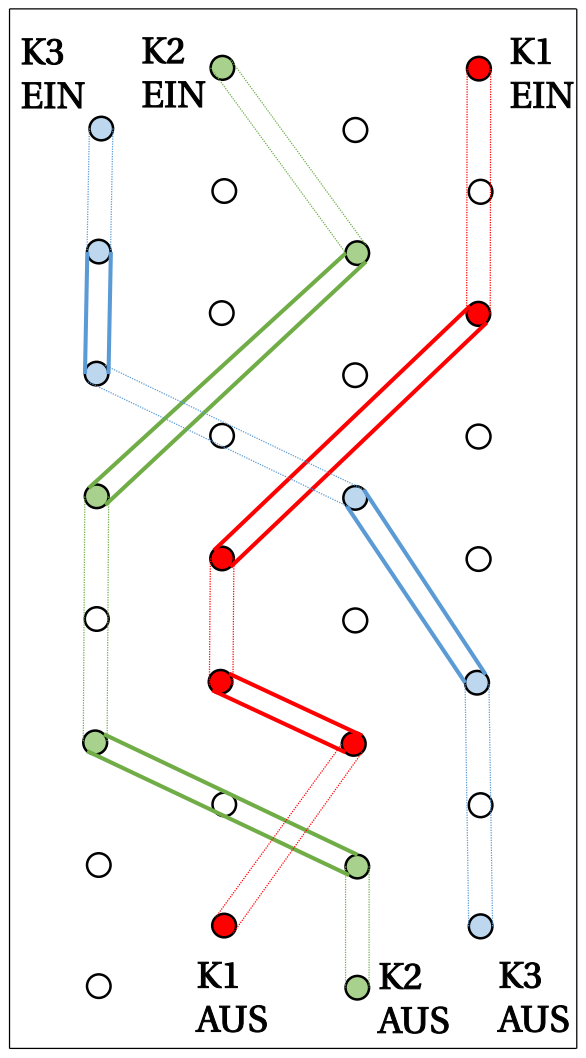
[picture p176: page 3]
K3 EIN; K2 AUS; K3 AUS; K1 AUS; K1 EIN

Evaporator left side | Evaporator right side

# Evaporator – AHT original design

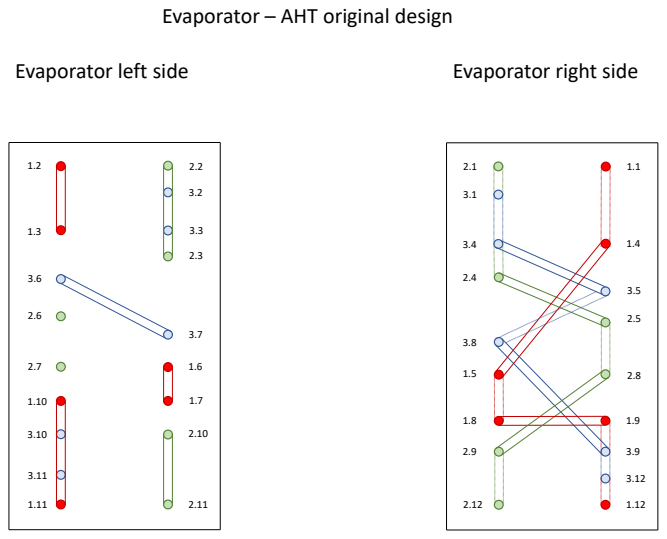
[picture p177: page 4]

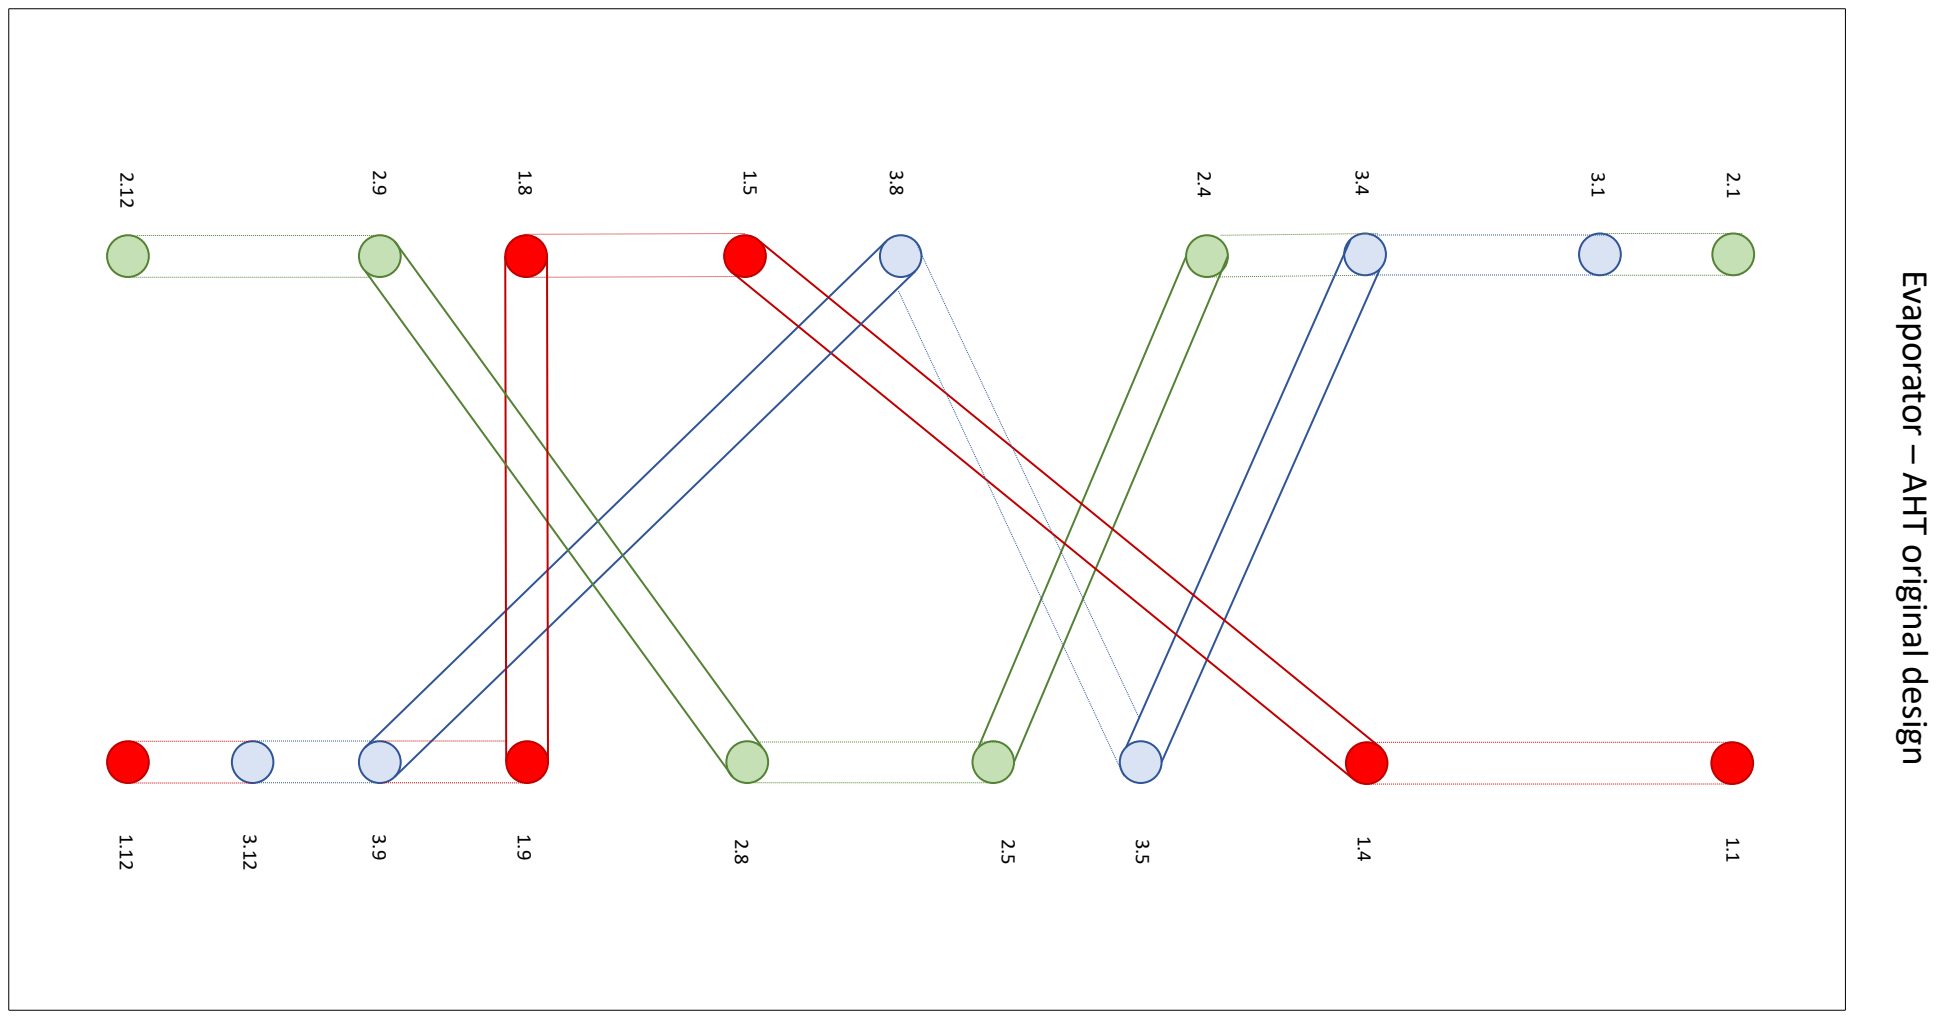
[picture p178: page 5]

Evaporator – AHT original design

Evaporator left side | Evaporator right side

# AHT original evaporator with changed piping

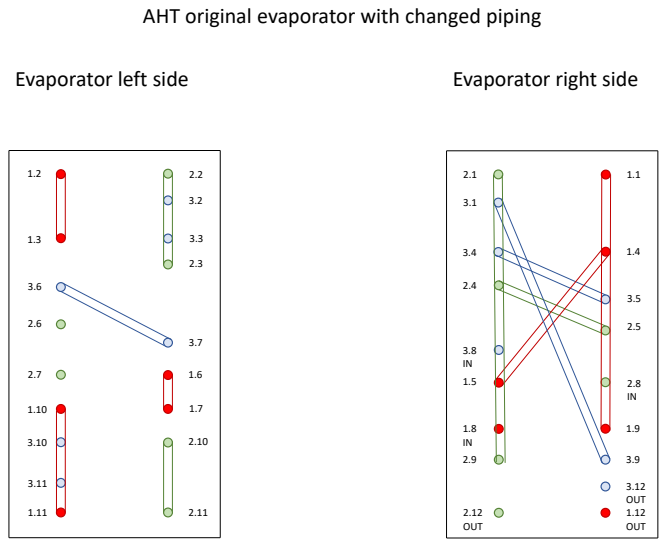
[picture p179: page 6]
2.12 OUT; 3.12 OUT; 1.12 OUT

# Evaporator right side Evaporator left side

# Evaporator – from Lidl (AHT new design?)

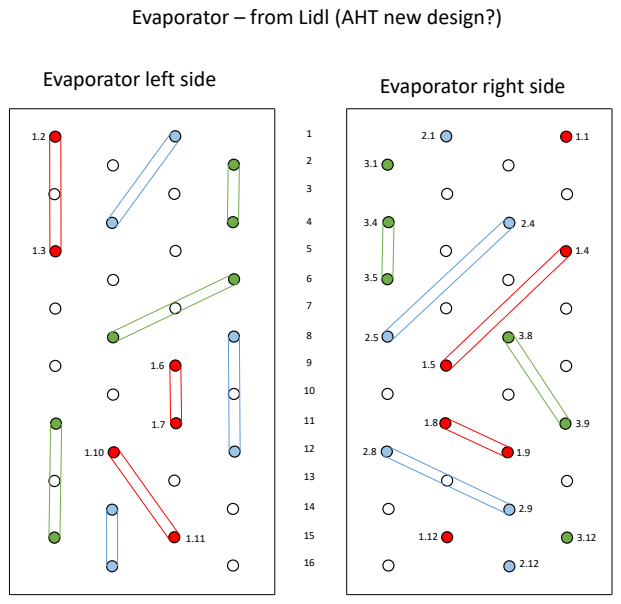
[picture p180: page 7]

# Evaporator right side Evaporator left side

# Evaporator – modiefied LIDL design

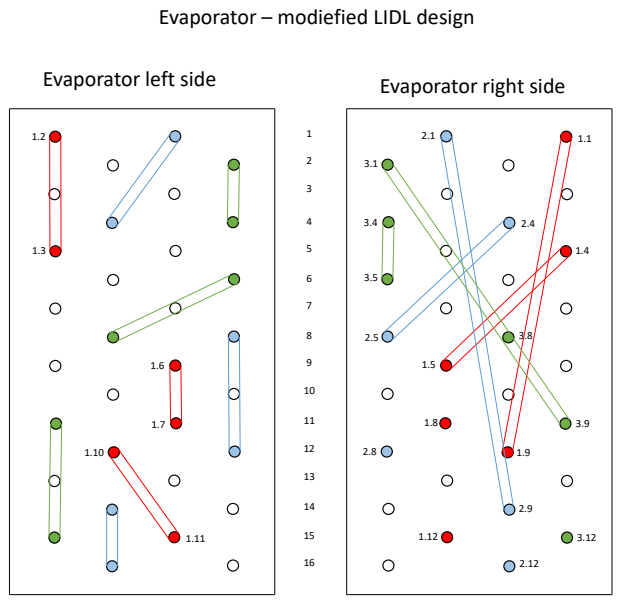
[picture p181: page 8]

# Refrion Proposal

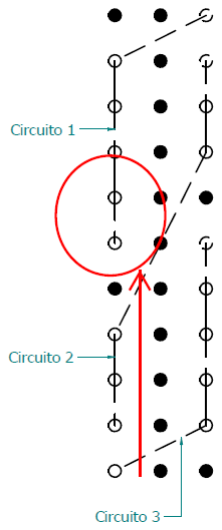
[picture p182: figure]
