TKlebig/TimBAgit/Evaporator Coil Design/Evaporator - Dimensions.pdf

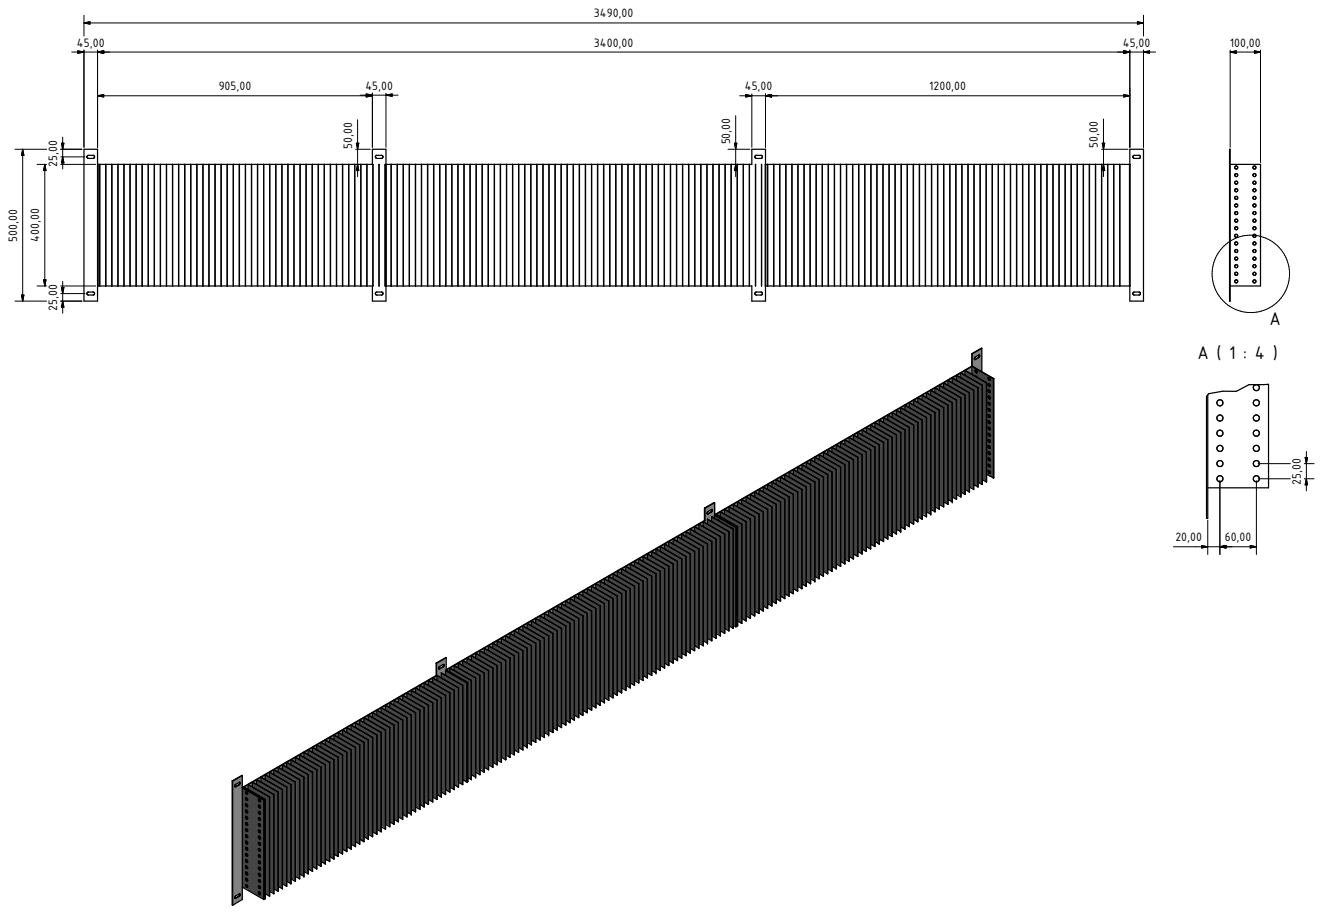
[picture p183: page 1]
