TKlebig/TimBAgit/BA/Pictures/test61V1ogph.pdf

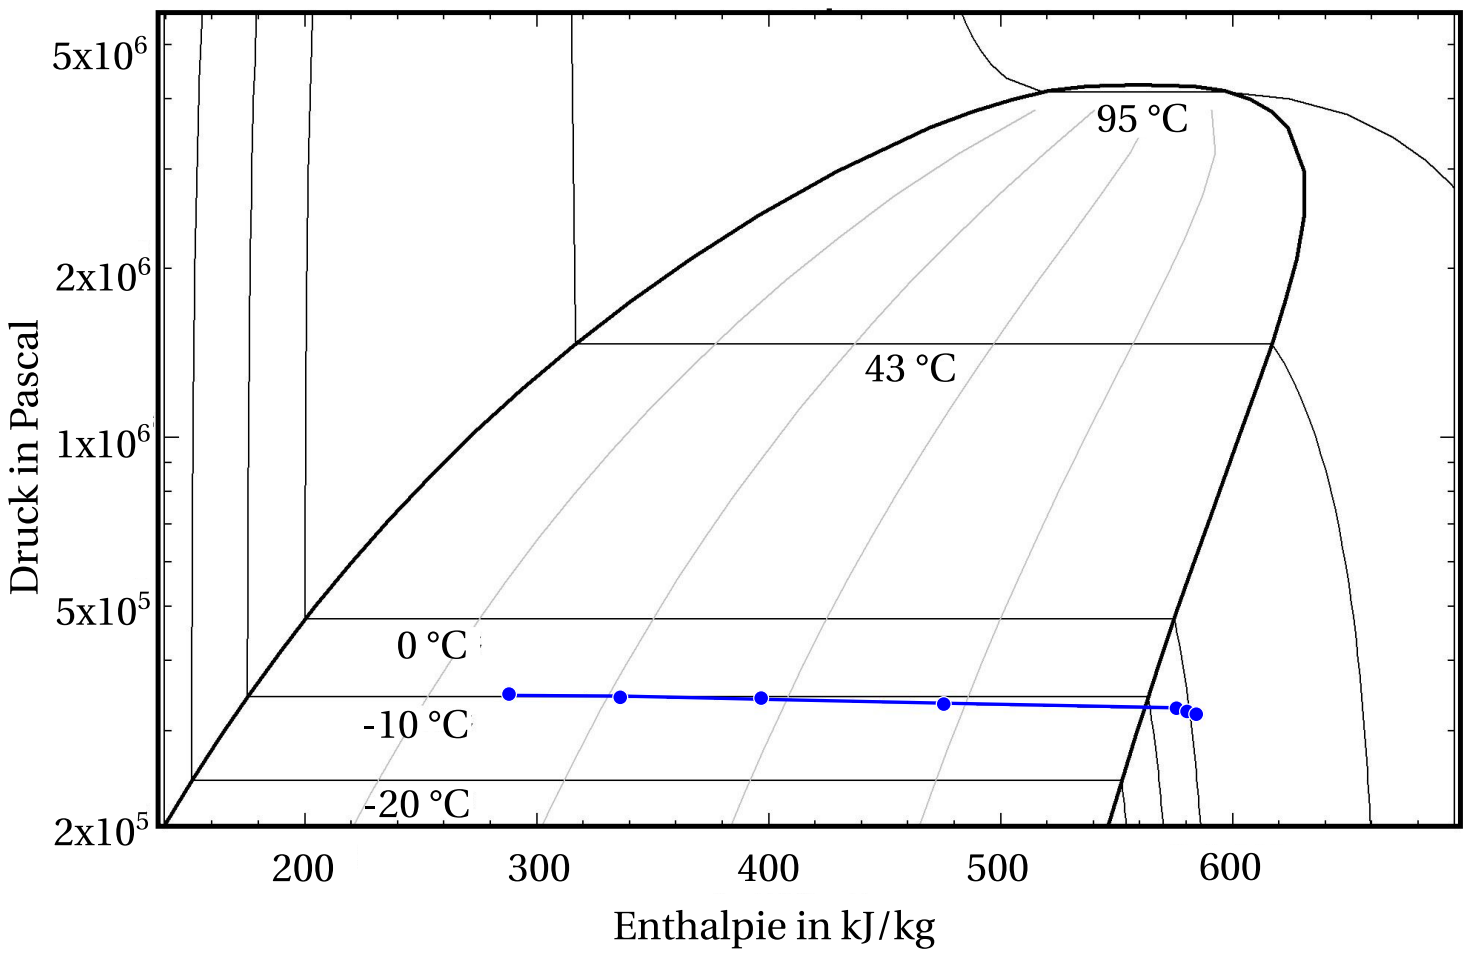
[picture p184: page 1]
