TKlebig/TimBAgit/BA/Pictures/test61V2logph.pdf

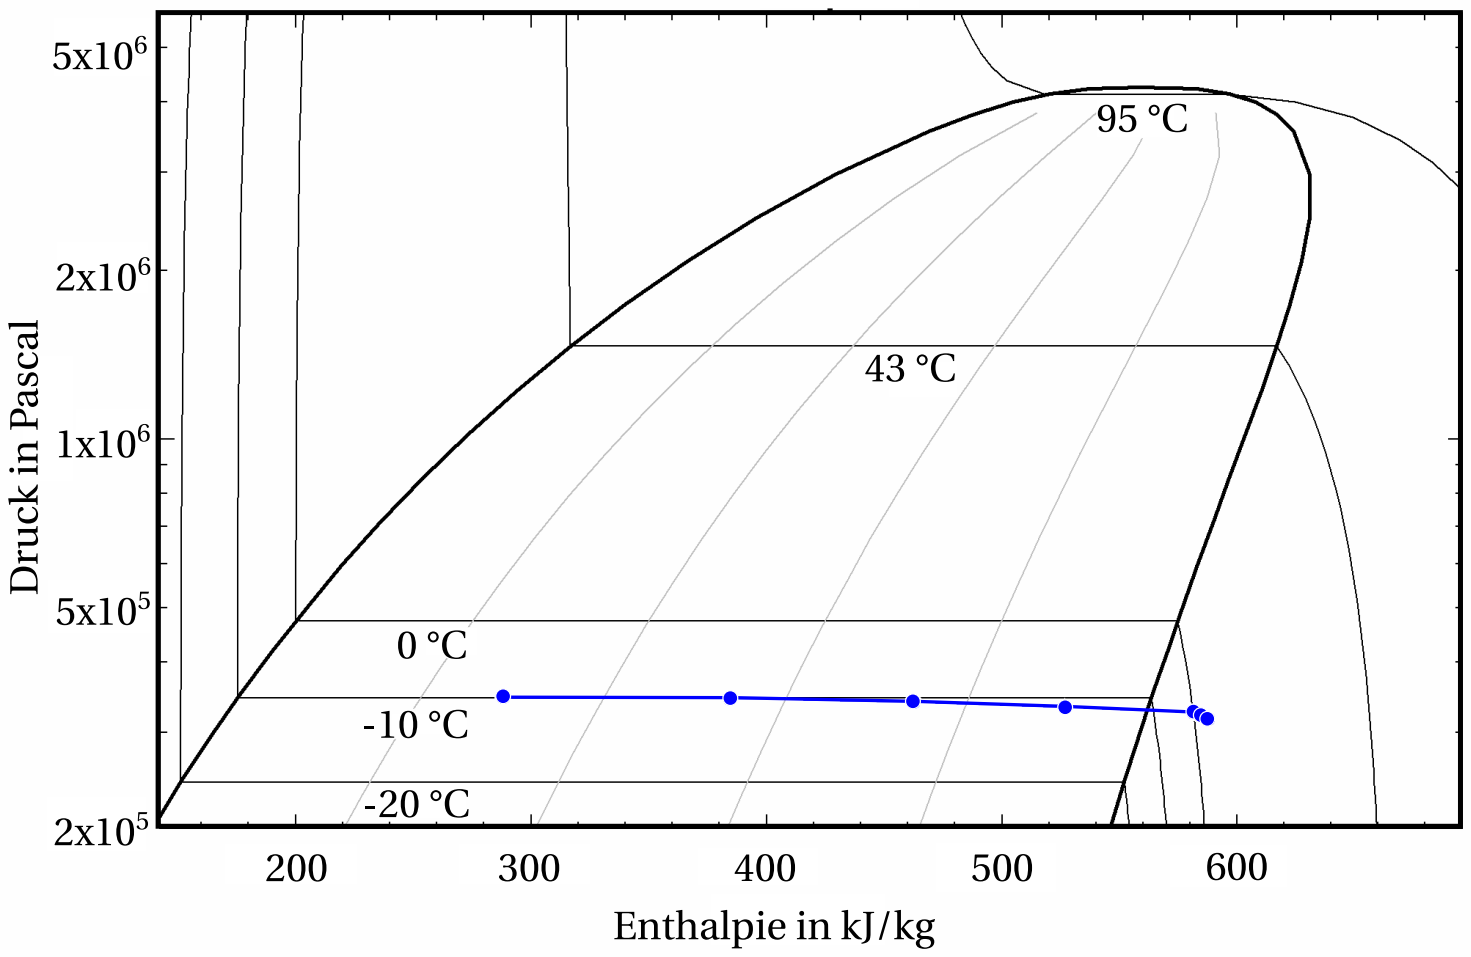
[picture p185: page 1]
