TKlebig/TimBAgit/BA/Pictures/Ersatzschaltbild.pdf

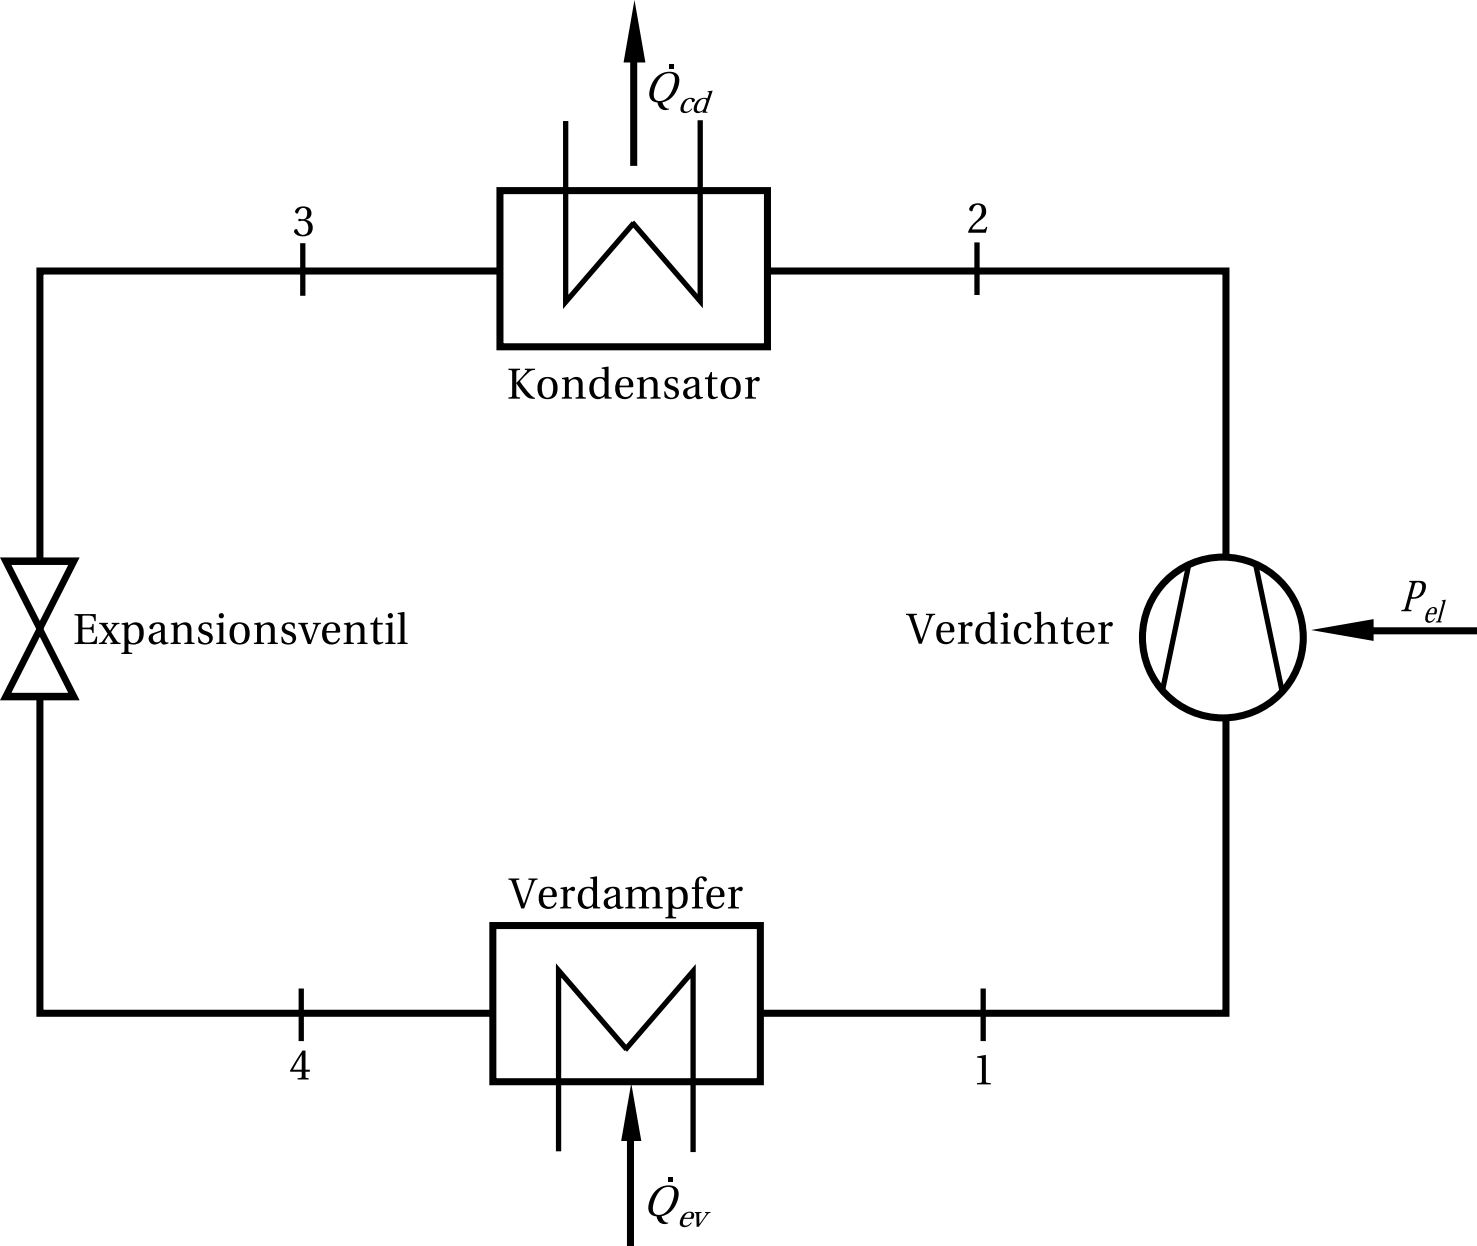
[picture p186: page 1]
