TKlebig/TimBAgit/BA/Pictures/IDC150.pdf

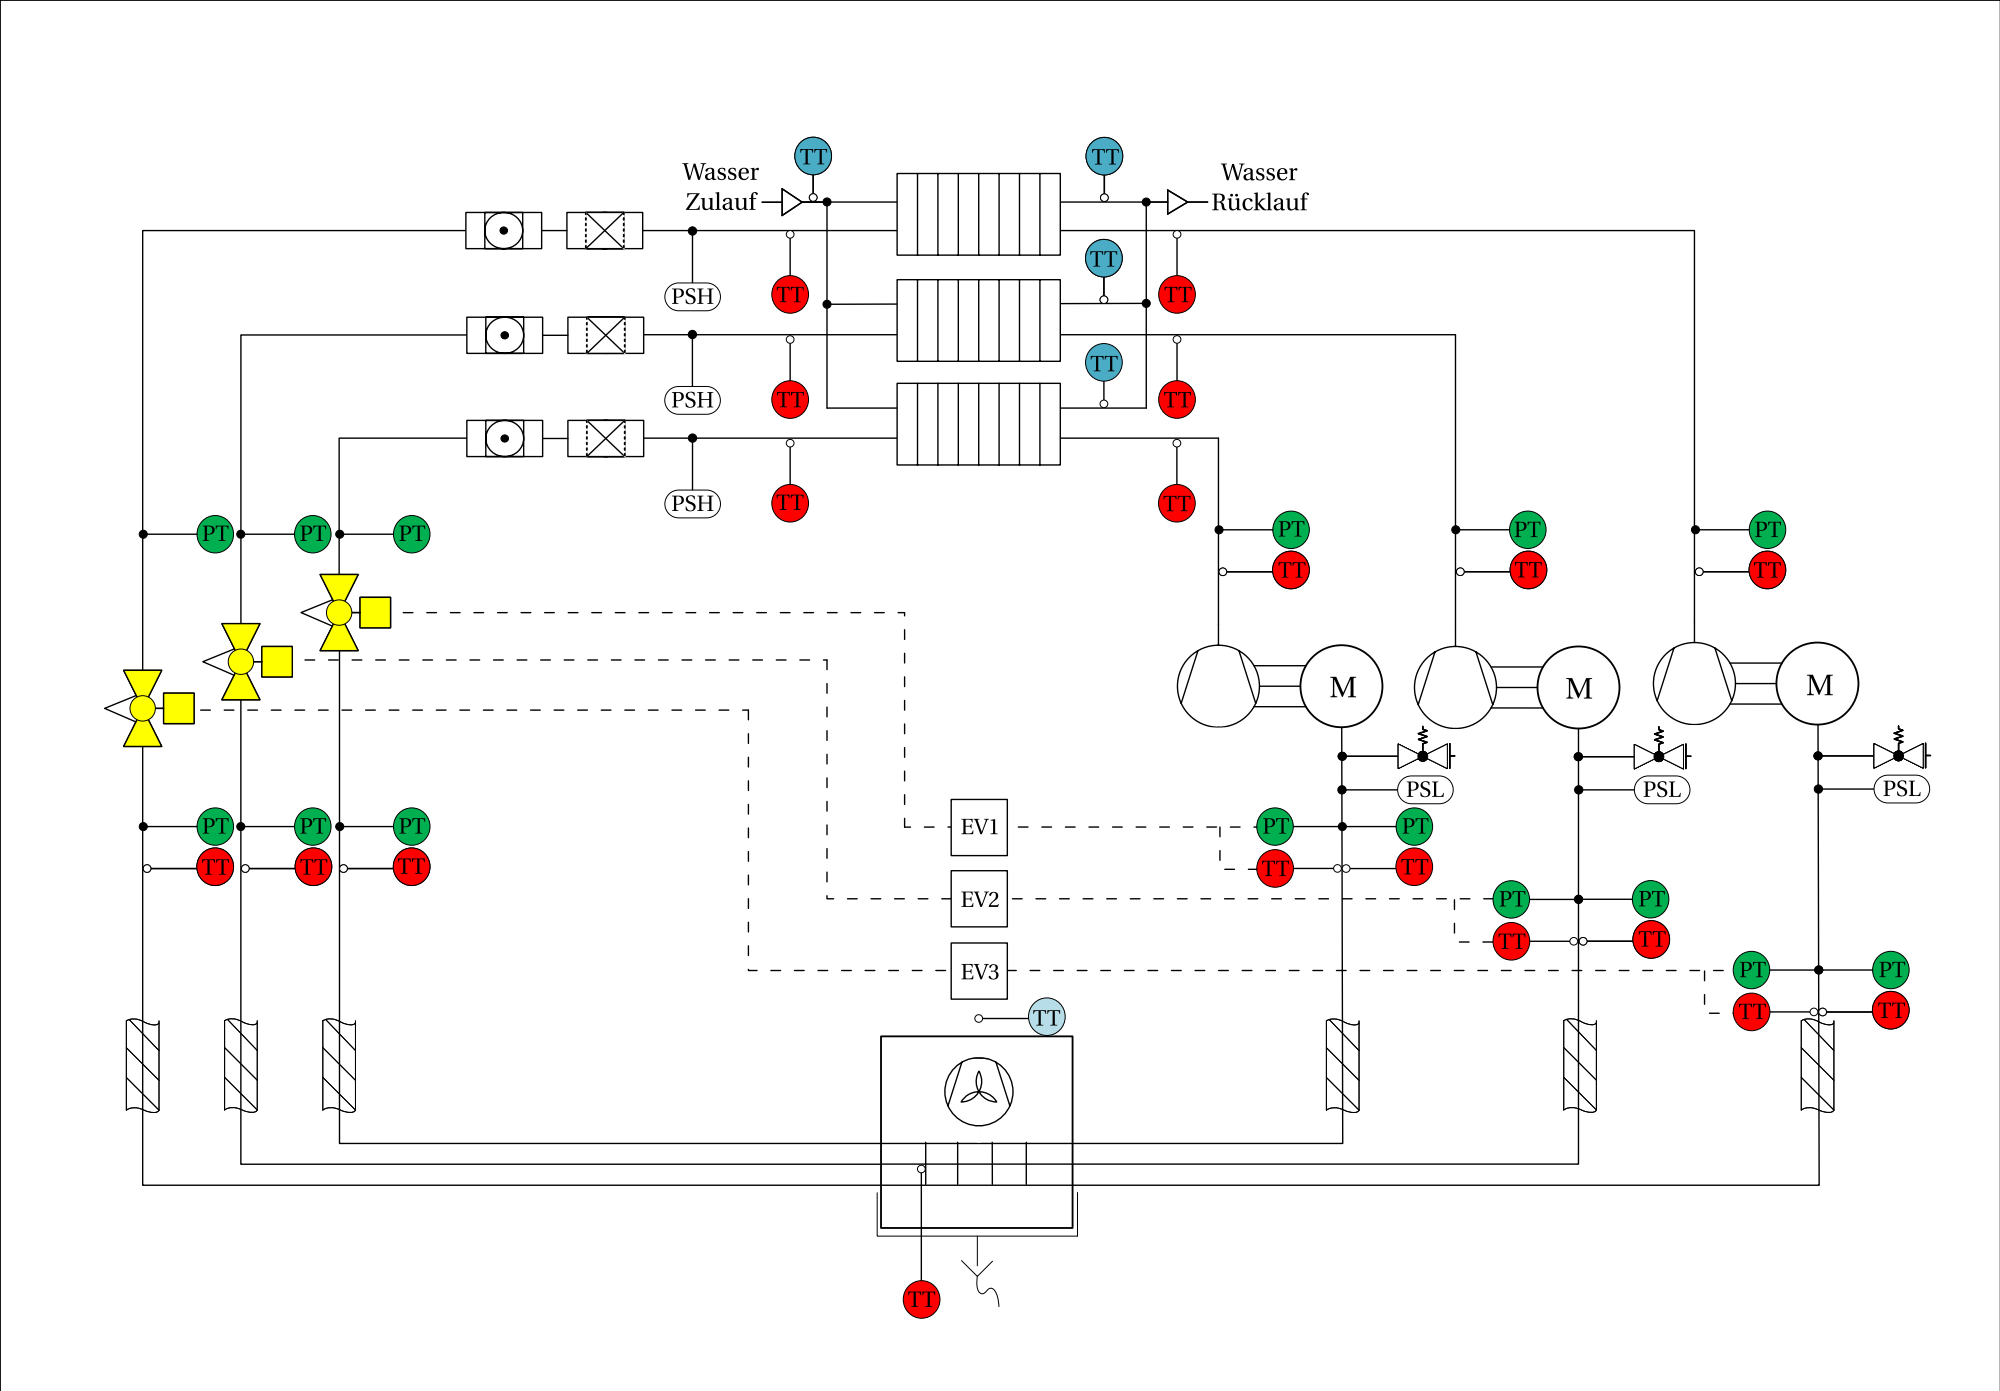
[picture p187: page 1]
