TKlebig/TimBAgit/BA/Pictures/50evaploss.pdf

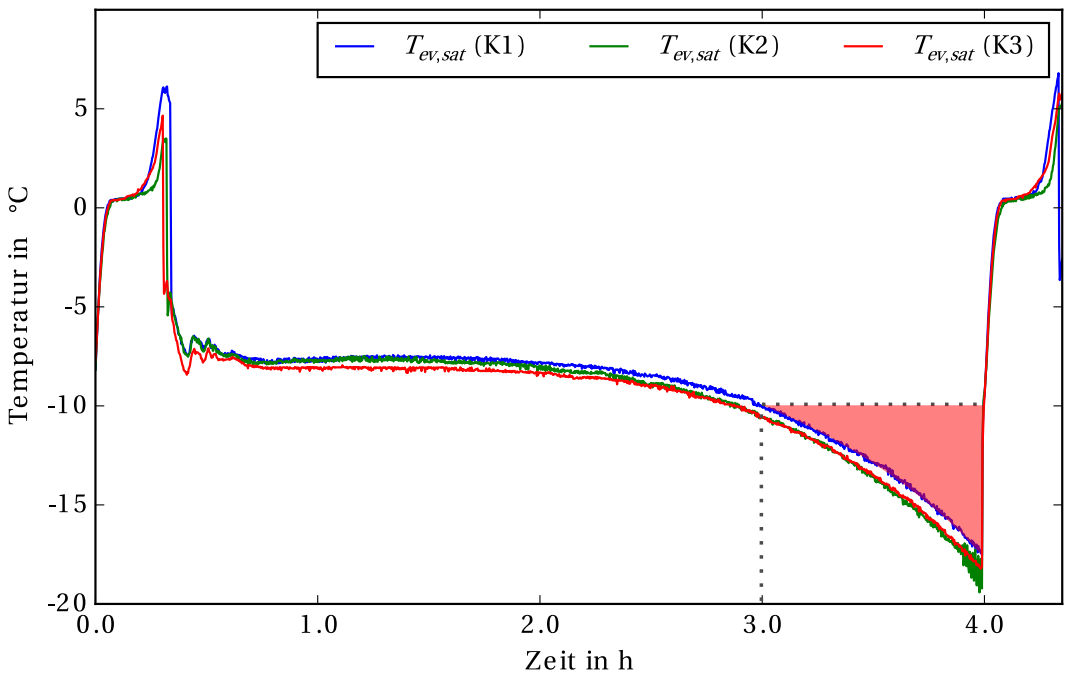
[picture p188: page 1]
