TKlebig/TimBAgit/BA/Pictures/50evaploss1.pdf

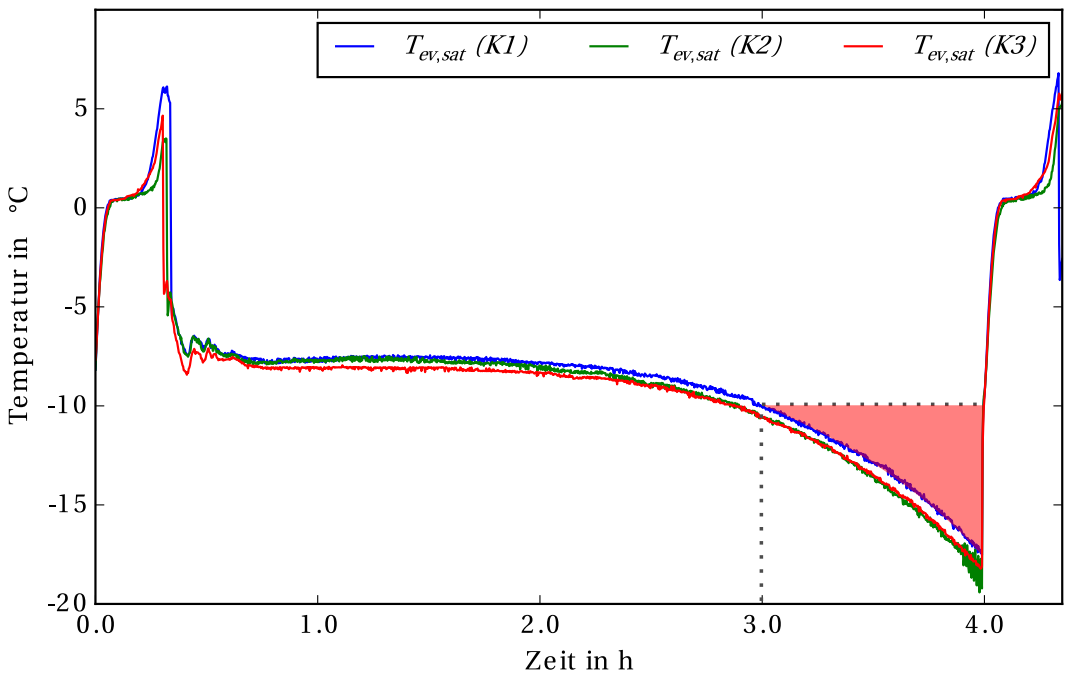
[picture p189: page 1]
