TKlebig/TimBAgit/BA/Pictures/50powerloss.pdf

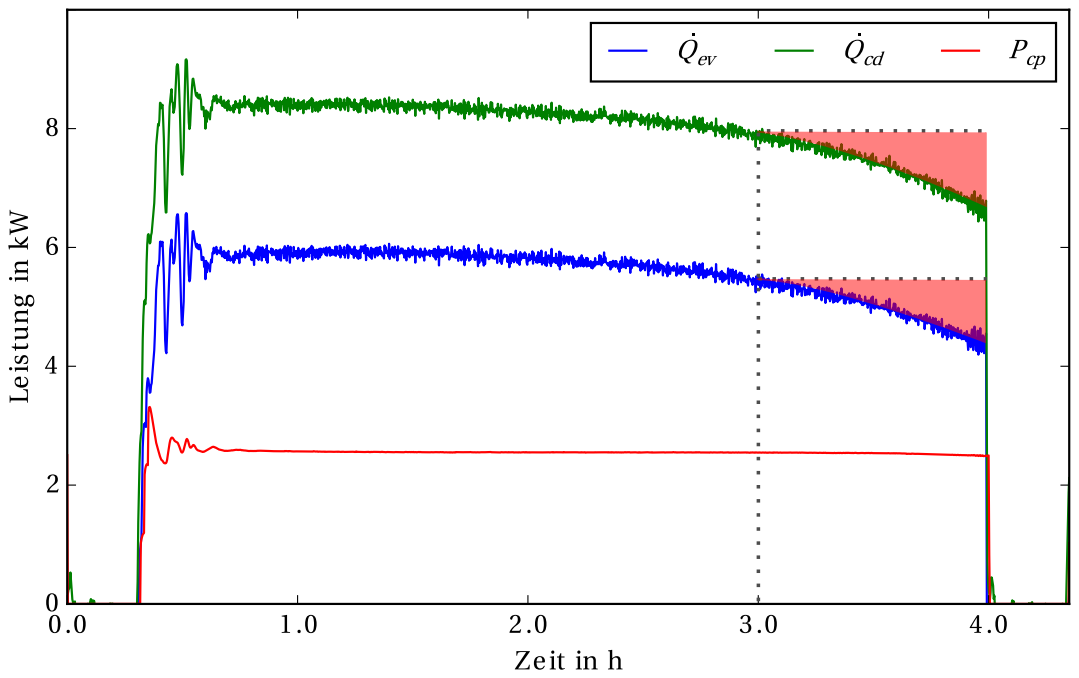
[picture p190: page 1]
