TKlebig/TimBAgit/BA/Pictures/AT10pctOC1.pdf

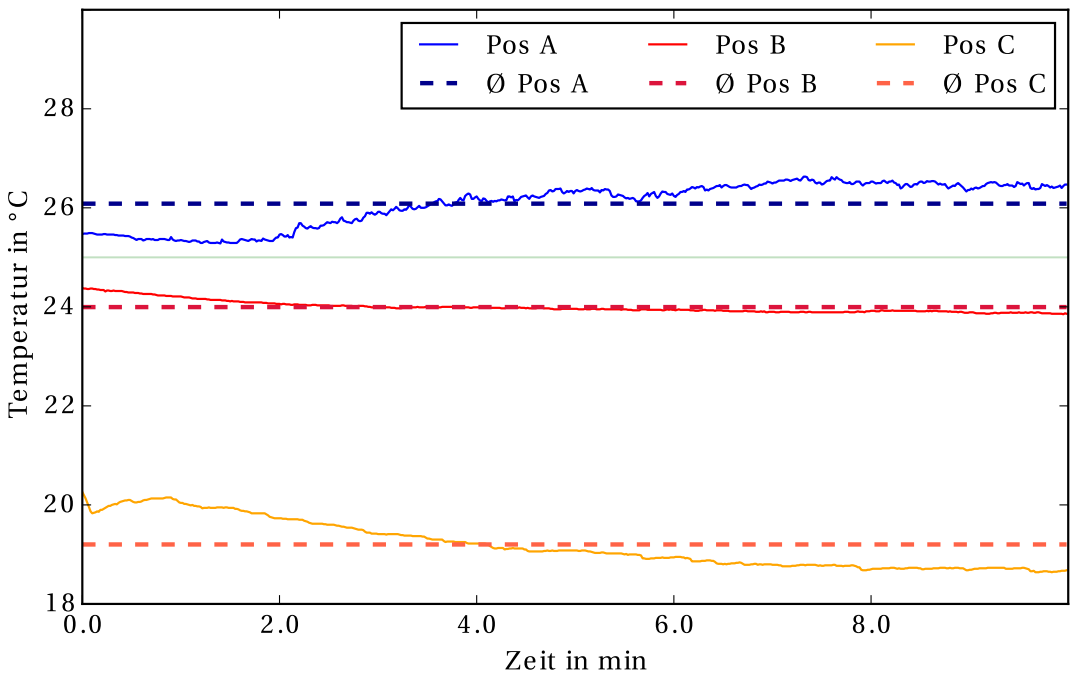
[picture p191: page 1]
