TKlebig/TimBAgit/BA/Pictures/AT30pctOC1.pdf

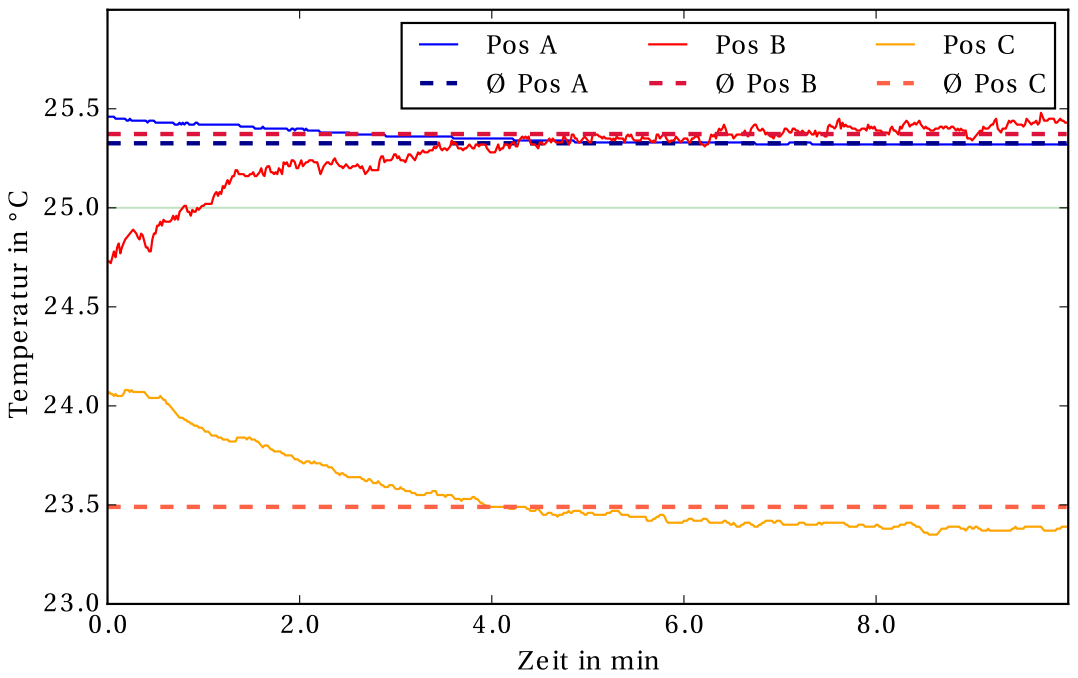
[picture p192: page 1]
