TKlebig/TimBAgit/BA/Pictures/AV10pctCC1.pdf

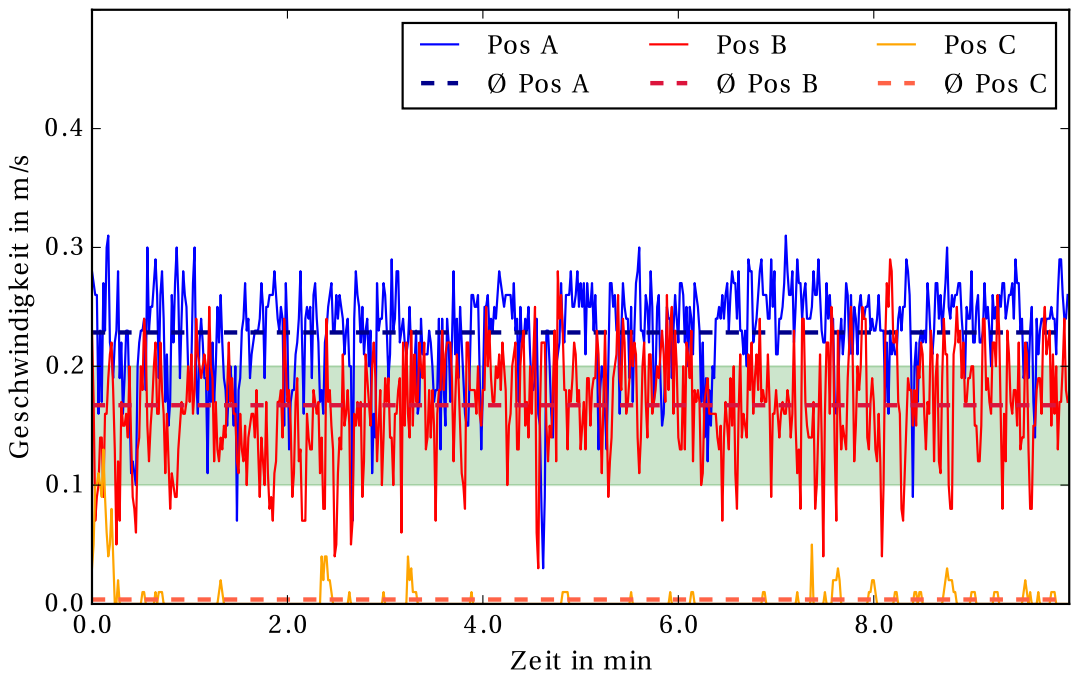
[picture p193: page 1]
