TKlebig/TimBAgit/BA/Pictures/AV10pctOC1.pdf

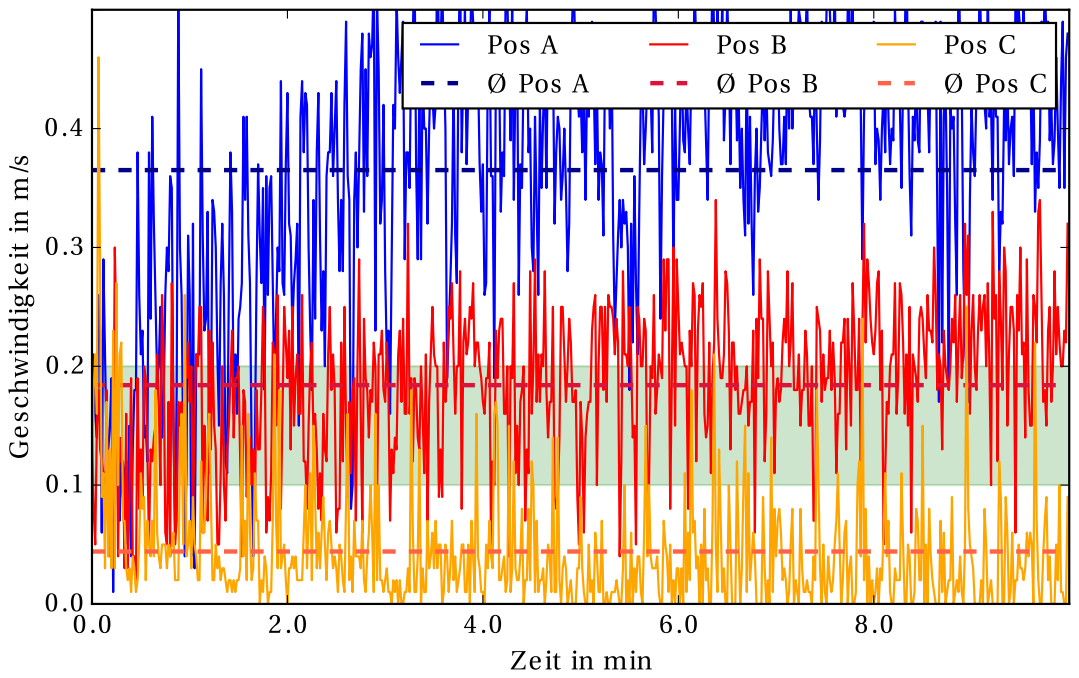
[picture p194: page 1]
