TKlebig/TimBAgit/BA/Pictures/AV30pctCC1.pdf

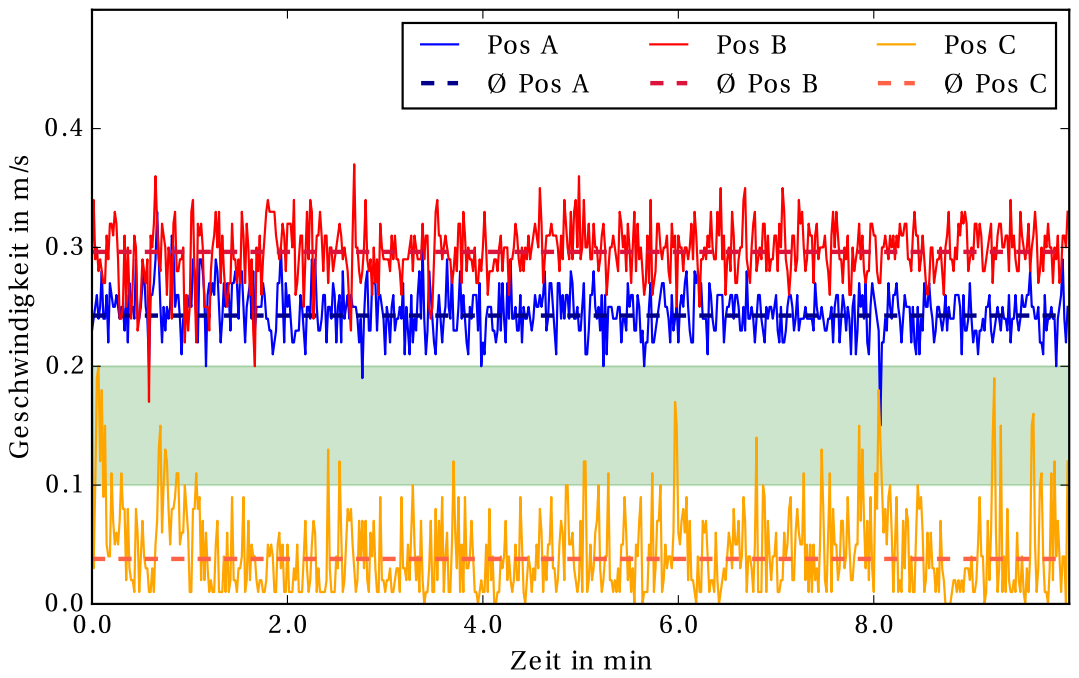
[picture p195: page 1]
