TKlebig/TimBAgit/BA/Pictures/AV30pctOC1.pdf

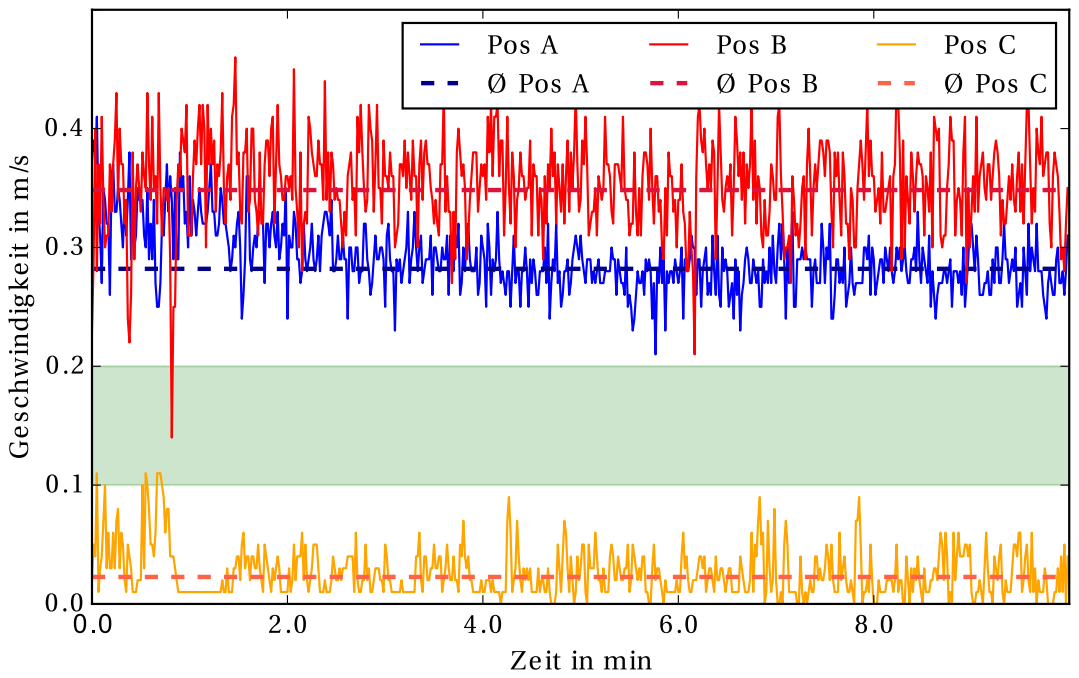
[picture p196: page 1]
