TKlebig/TimBAgit/BA/Pictures/ClimateChamber.pdf

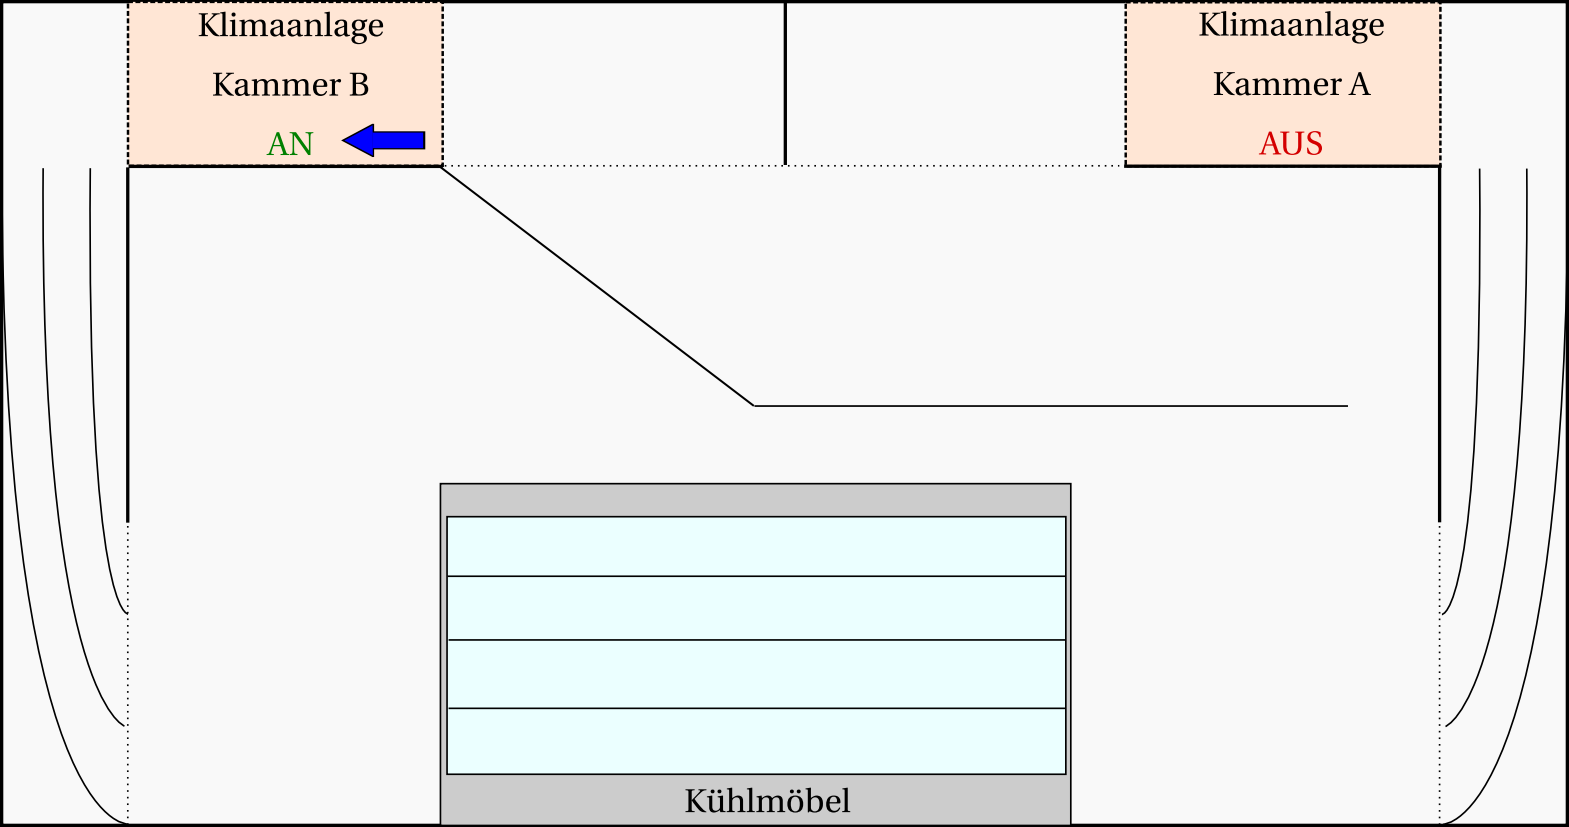
[picture p197: page 1]
