TKlebig/TimBAgit/BA/Pictures/ClimateChamber_flow30pctCC.pdf

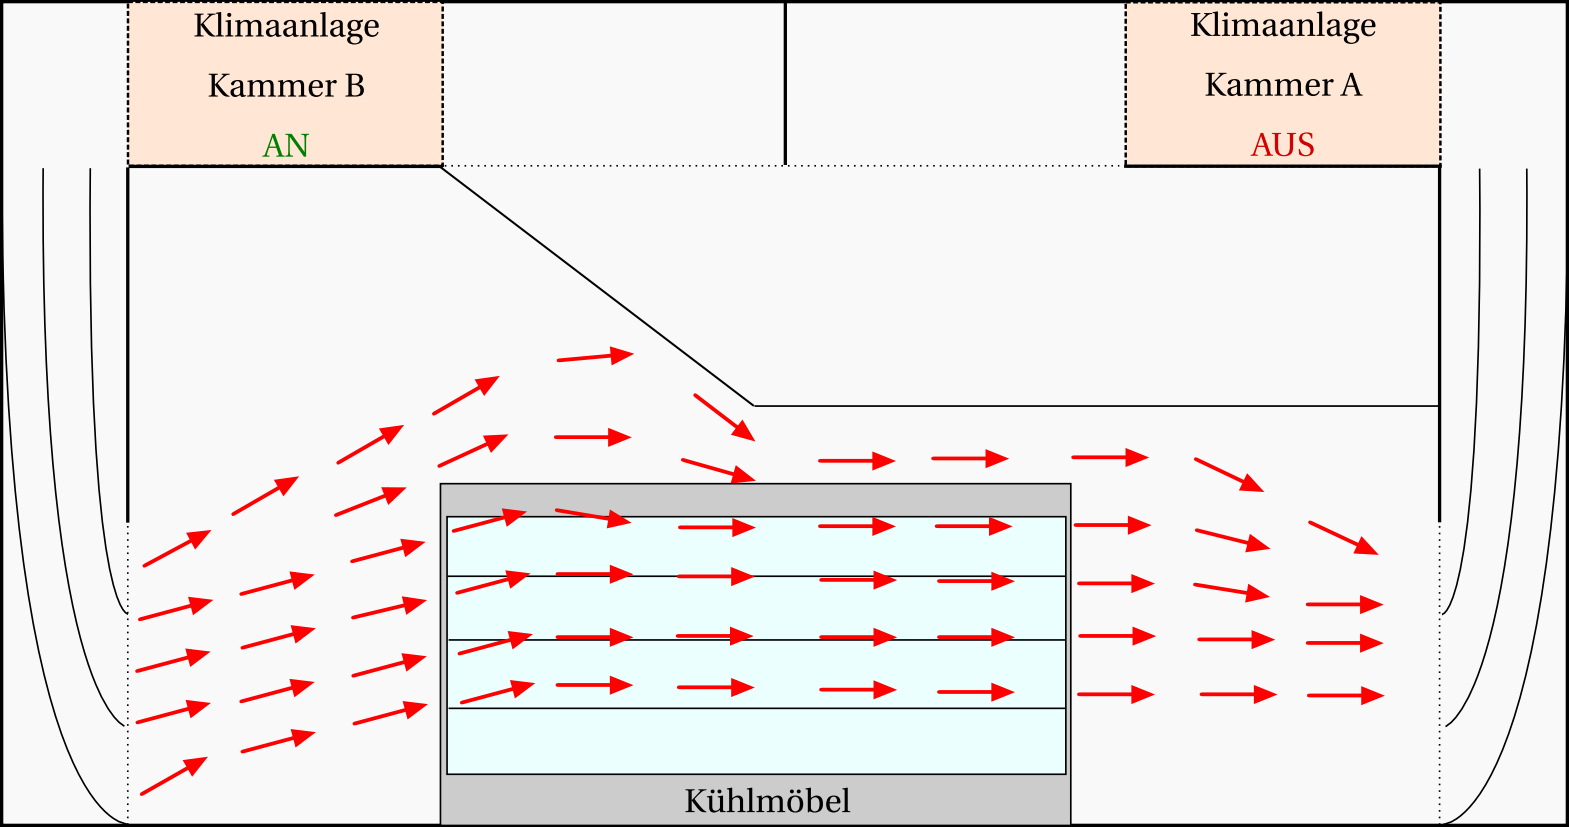
[picture p198: page 1]
