TKlebig/TimBAgit/BA/Pictures/ClimateChamber_flow30pctOC.pdf

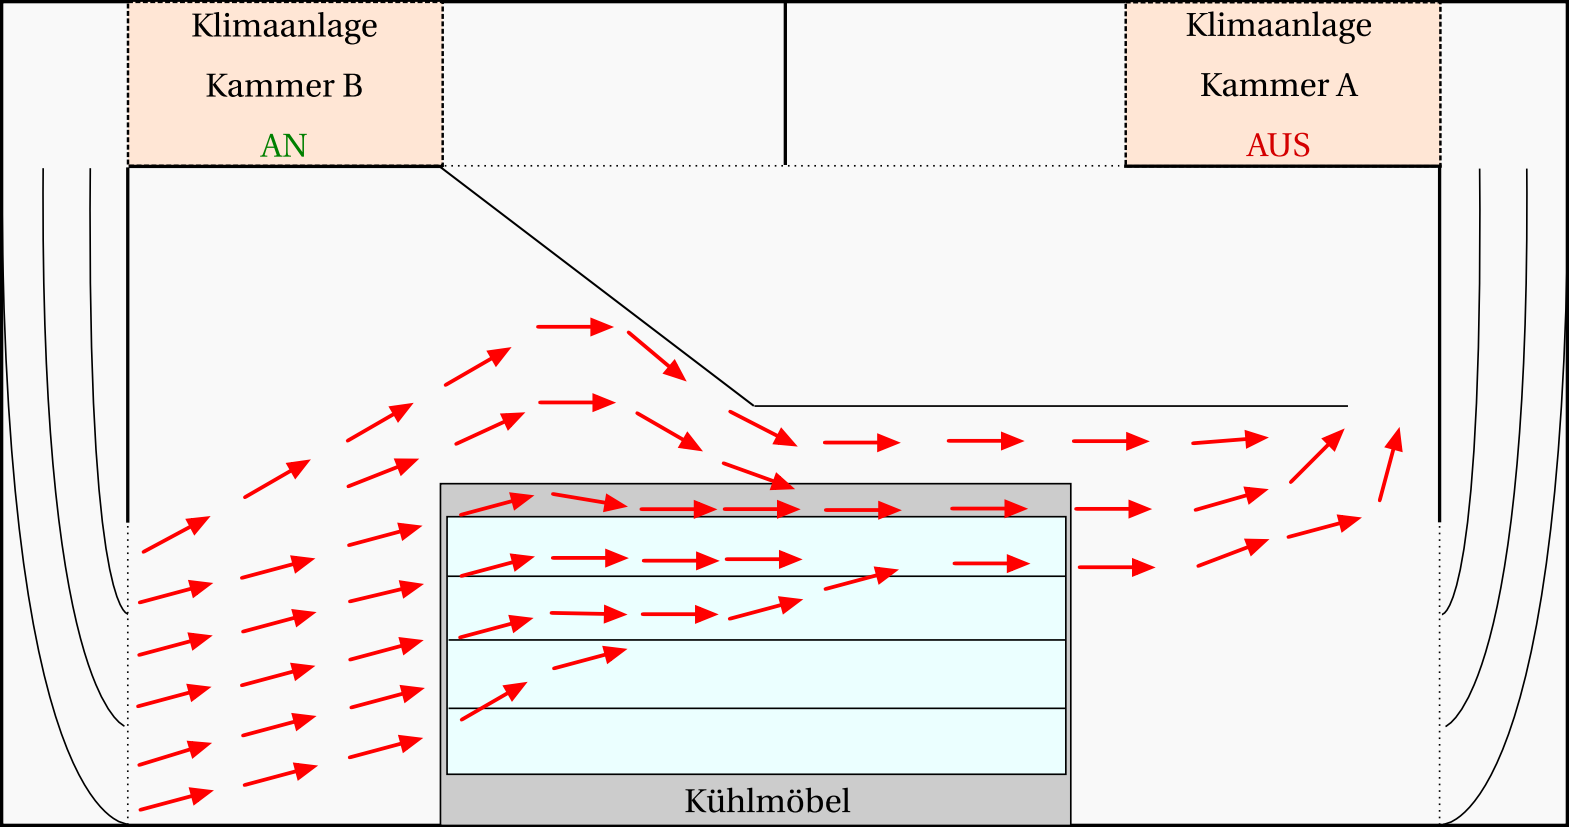
[picture p199: page 1]
