TKlebig/TimBAgit/BA/Pictures/IDC150_visio.pdf

### Wasser Rücklauf

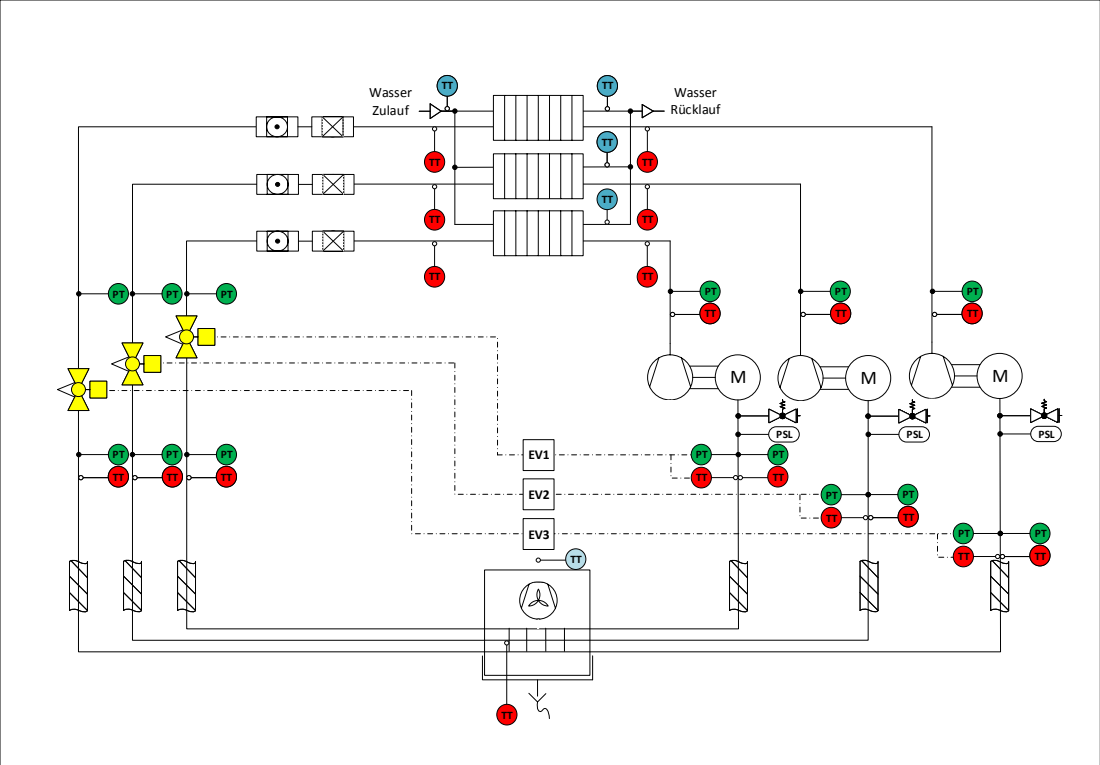
[picture p200: page 1]
Wasser Zulauf; PSL
