TKlebig/TimBAgit/BA/Pictures/TEMP_V21.pdf

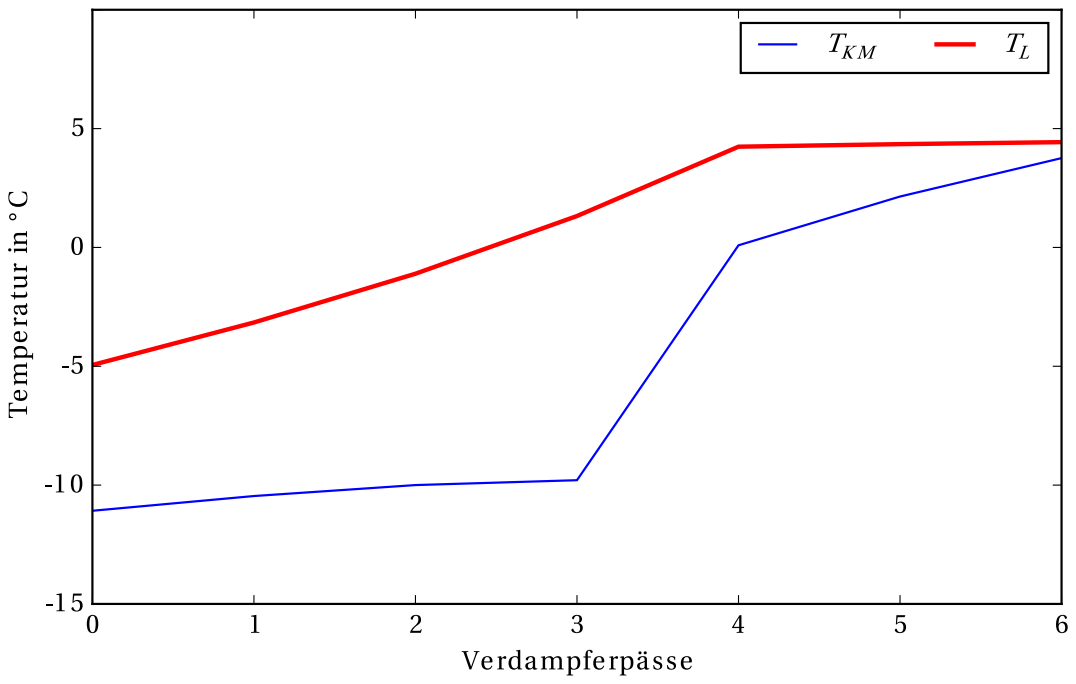
[picture p201: page 1]
