TKlebig/TimBAgit/BA/Pictures/AV10pctCC.pdf

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

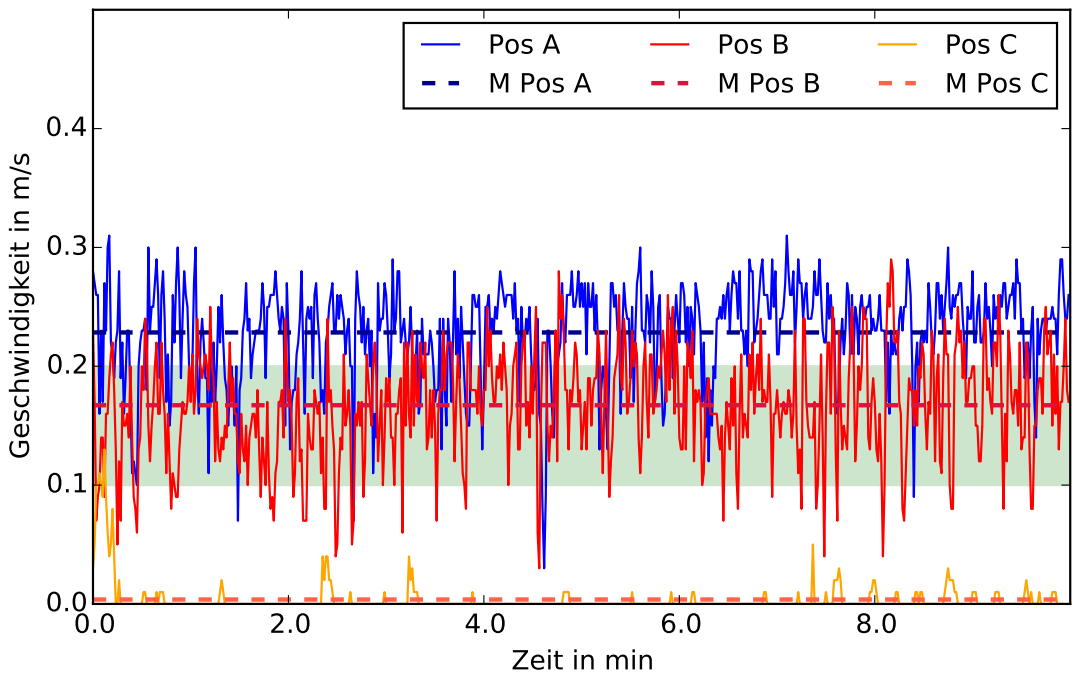
[picture p204: page 1]
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
