TKlebig/TimBAgit/BA/Pictures/10pctCC.pdf

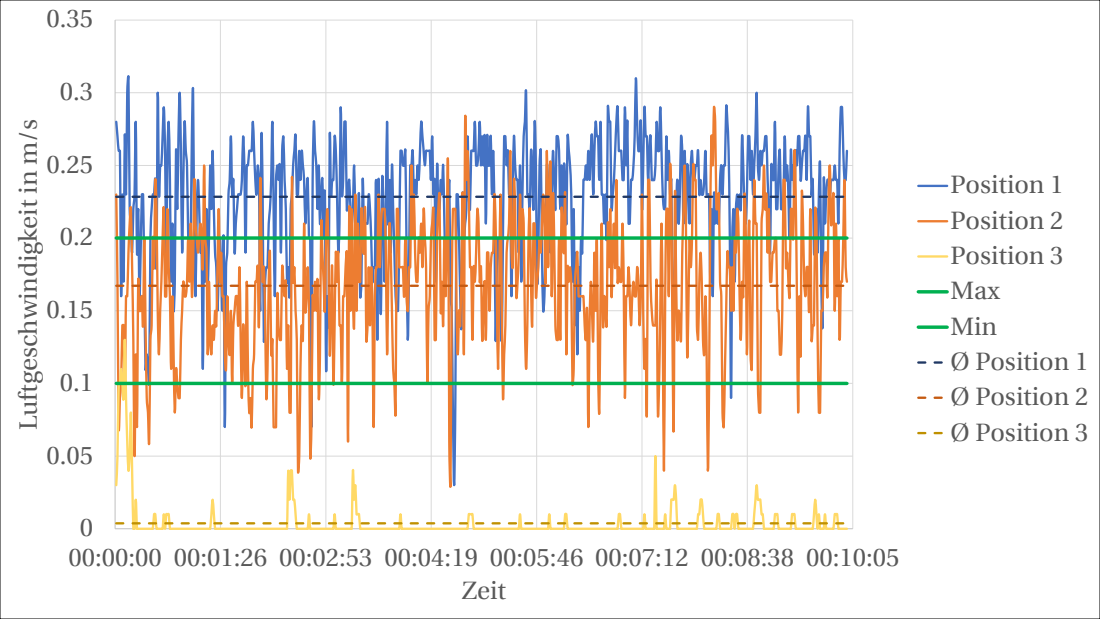
[picture p208: page 1]
Luftgeschwindigkeit in m/s; Zeit; Position 1 Position 2 Position 3 Max Min Ø Position 1 Ø Position 2 Ø Position 3
