TKlebig/TimBAgit/BA/Pictures/AHTEV.pdf

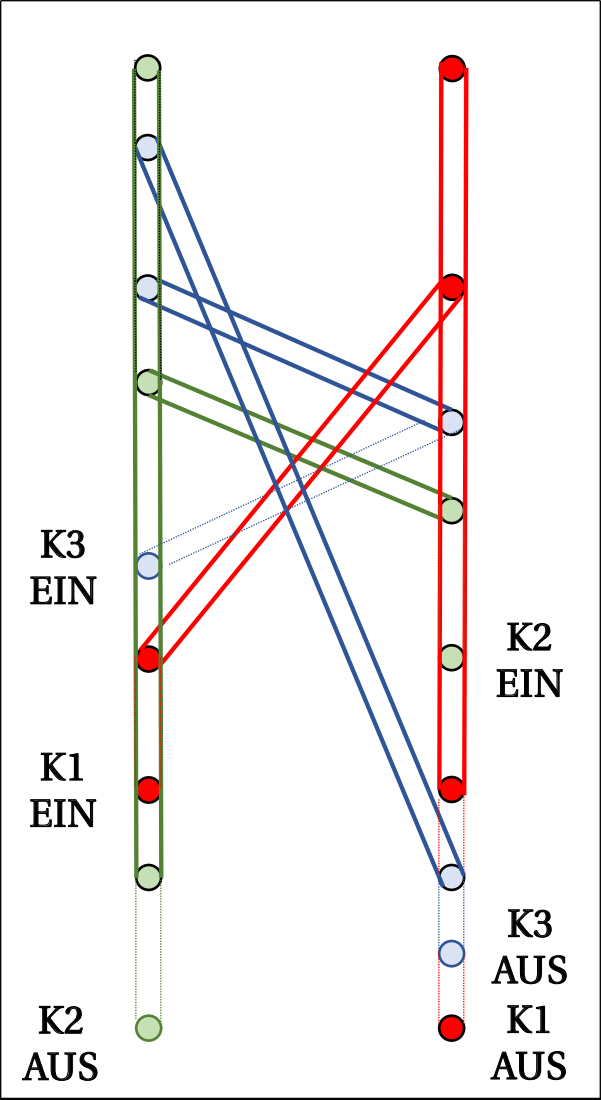
[picture p209: page 1]
K2 EIN; K3 EIN; K2 AUS; K3 AUS K1 AUS; K1 EIN
