TKlebig/TimBAgit/BA/Pictures/idc_meas2.pdf

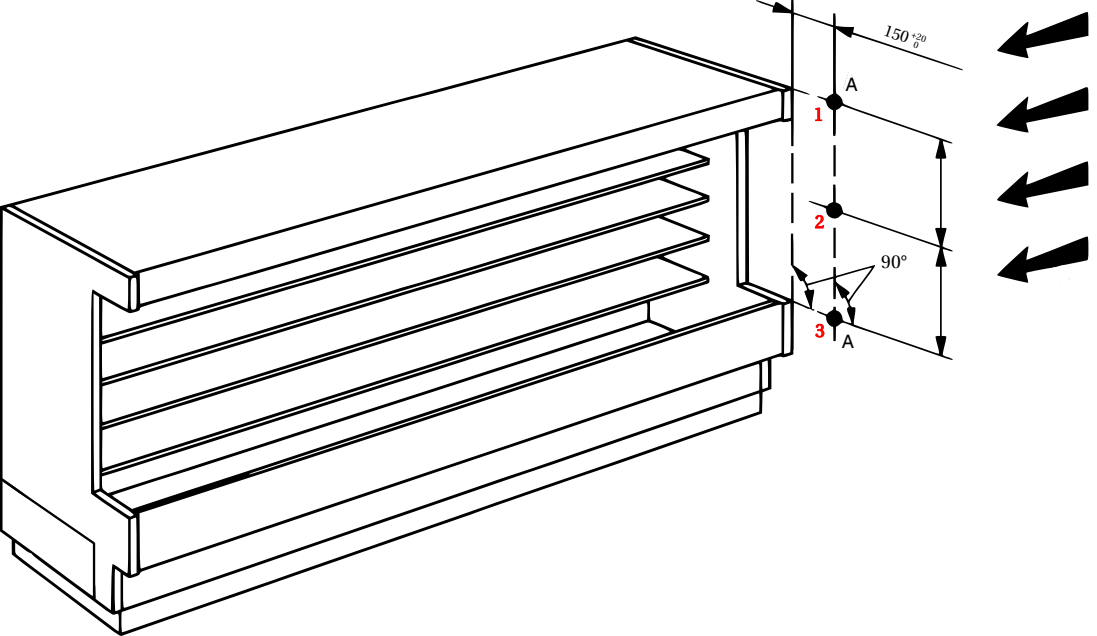
[picture p210: page 1]
