TKlebig/TimBAgit/BA/Pictures/LIDLV1.pdf

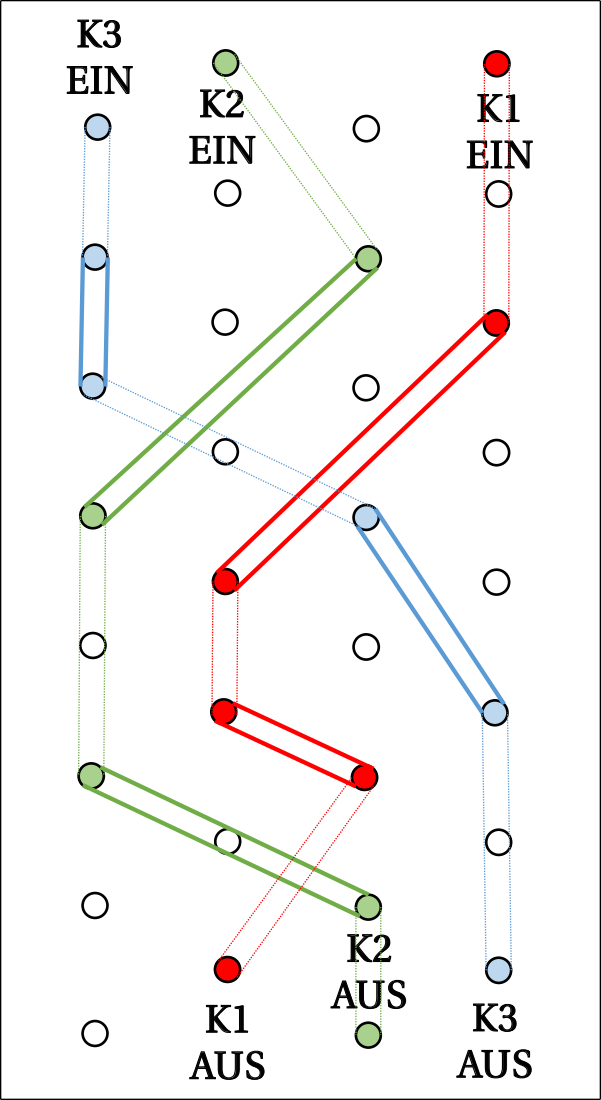
[picture p211: page 1]
K2 EIN; K3 EIN; AUS; K1 AUS; K1 EIN
