TKlebig/TimBAgit/BA/Pictures/LIDLV2.pdf

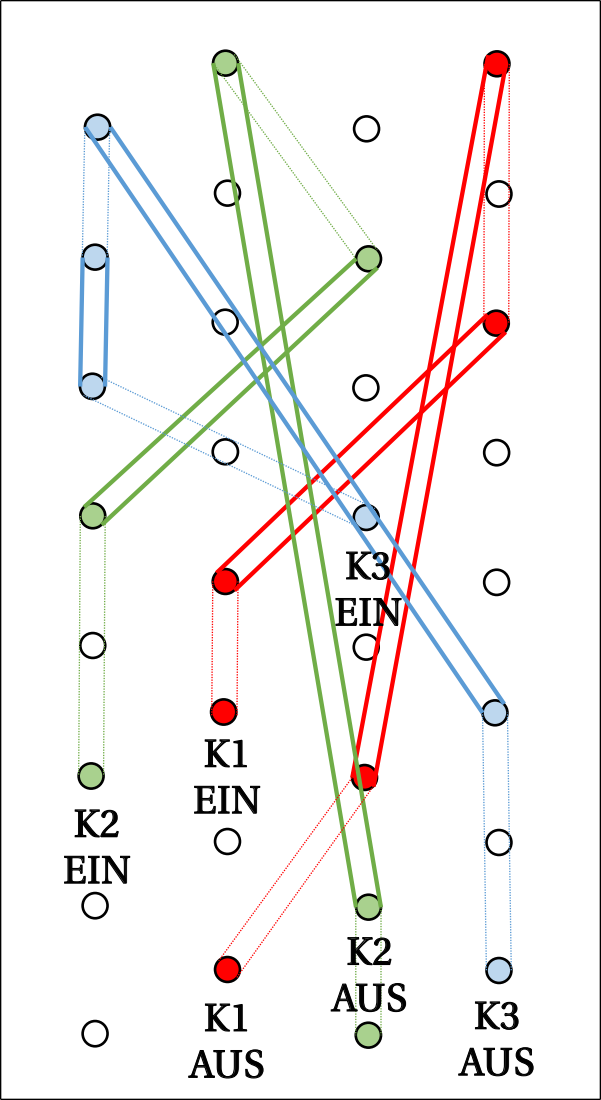
[picture p212: page 1]
K2 EIN; K3 EIN; AUS; K1 AUS; K1 EIN
